Kariemm11/Cleanroom-Heat-Recovery-Air-Pump/cad/drawings/enclosure-GA.pdf

## FRONT WALL — seen from the front

## LEFT WALL — outdoor side

## PARTI

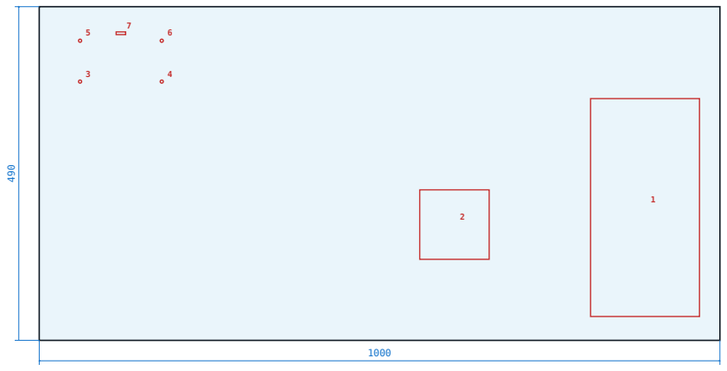
[picture p13: figure]
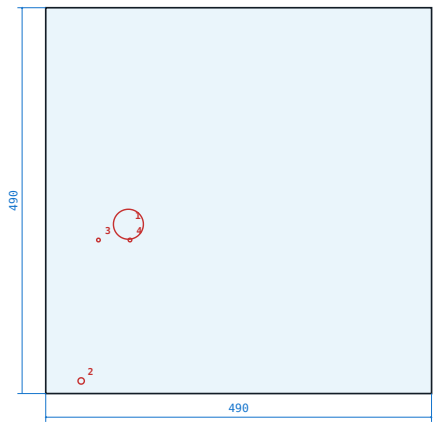
[picture p14: figure]

490

## BACK WALL — seen from inside

## FALSE CEILING — from below

## ROOF

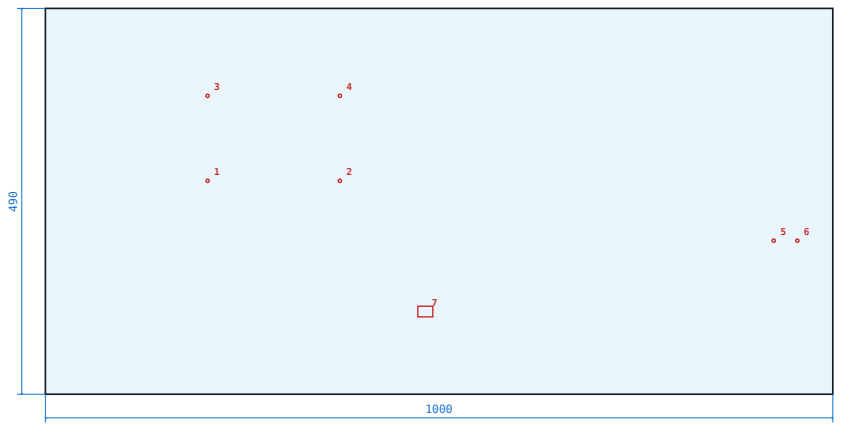
[picture p15: figure]
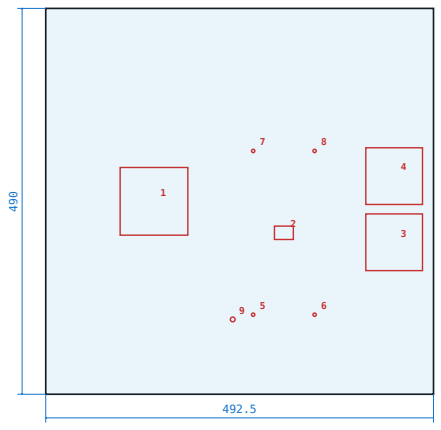
[picture p16: figure]

500

## CUT-OUTS — centre positions in mm, measured in each view from its left and bottom edges

### Front wall

1 door opening (door panel 180 × 340) @ 890 from left, 195 from bottom 2 pass box opening 102 × 102 @ 610 from left, 170 from bottom
3 HMI standoff M4 @ 60 from left, 380 from bottom
4 HMI standoff M4 (same) @ 180 from left, 380 from bottom
5 HMI standoff M4 (same) @ 60 from left, 440 from bottom
6 HMI standoff M4 (same) @ 180 from left, 440 from bottom 7 HMI ribbon slot @ 120 from left, 451 from bottom

### Left wall (outdoor side)

1 fresh-air compressor intake Ø38 @ 105 from left, 215 from bottom 2 24 V supply cable gland Ø8 @ 45 from left, 16 from bottom
3 compressor bracket M4 @ 67 from left, 195 from bottom
4 compressor bracket M4 (same) @ 107 from left, 195 from bottom

### Partition wall

1 supply duct 31
2 exhaust termin
3 exhaust termin
4 PDT-101 refere
5 PCB harness sl

### Back wall

1 PCB standoff M3 @ 206 from left, 271 from bottom
2 PCB standoff M3 (same) @ 374 from left, 271 from bottom 3 PCB standoff M3 (same) @ 206 from left, 379 from bottom 4 PCB standoff M3 (same) @ 374 from left, 379 from bottom
5 MT-106 sensor M3 @ 925 from left, 195 from bottom
6 MT-106 sensor M3 (same) @ 955 from left, 195 from bottom
7 exhaust collector C into the plant room 19 × 13.5 @ 482.5 from left, 105 from bottom

### Clean-room false ceiling

1 ceiling H14 BIBO terminal 86 × 86 @ 137.5 from left, 245 from bottom 2 LAF supply drop 24 × 17 @ 302.5 from left, 205 from bottom
3 ceiling H14 BIBO terminal 2 72 × 72 @ 442.5 from left, 193 from bottom 4 ceiling H14 BIBO terminal 3 72 × 72 @ 442.5 from left, 277 from bottom 5 LAF hanger Ø4 @ 263.5 from left, 101 from bottom
6 LAF hanger Ø4 (same) @ 341.5 from left, 101 from bottom
7 LAF hanger Ø4 (same) @ 263.5 from left, 309 from bottom
8 LAF hanger Ø4 (same) @ 341.5 from left, 309 from bottom 9 luminaire cable Ø6 @ 237.5 from left, 95 from bottom

### Roof

1 common exhaust
