Kariemm11/Cleanroom-Heat-Recovery-Air-Pump/cad/cleanroom-rig-assembly.step

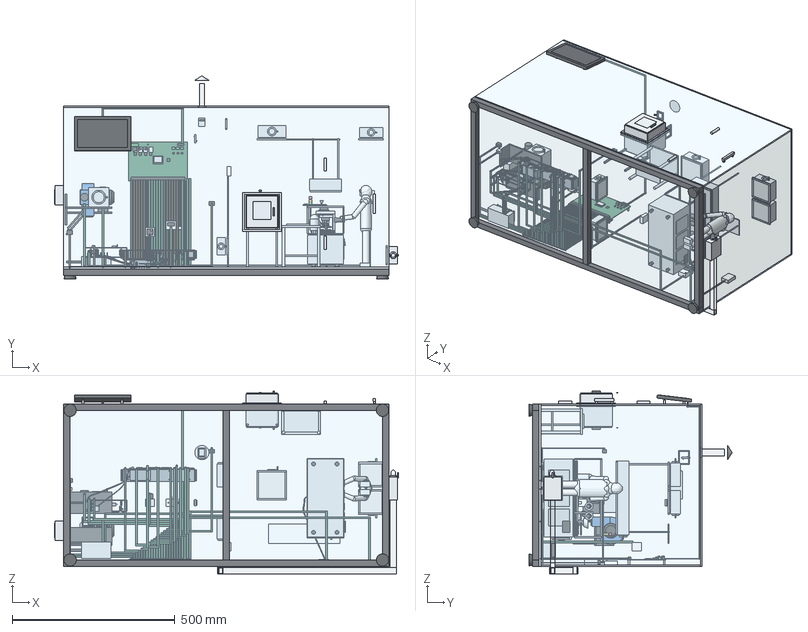
[picture p17: CAD file, 2026-10-15]
cad/cleanroom-rig-assembly.step
1057.1 x 625.0 x 560.9 mm
Acrylic base plate
Acrylic roof
Acrylic back wall
Acrylic front wall
Acrylic left wall (outdoor side)
Acrylic right wall
Acrylic partition wall
Clean-room false ceiling
Aluminium base frame
Aluminium base frame -2
Clean-room access door
AHU frame
AHU casing panel
Base machine compartment and R32 compressor
Base machine compartment and R32 compressor -2
Outdoor-air pre-filter
Outdoor-air pre-filter -2
Panel filter
Panel filter -2
Bag filter
Bag filter -2
HEPA final filter
HEPA final filter -2
Fresh-air plenum plus turning vanes
Coil preheat
Coil preheat -2
Coil preheat -3
Coil preheat -4
Coil cooling
Coil cooling -2
Coil cooling -3
Coil cooling -4
Coil reheat
Coil reheat -2
Coil reheat -3
Coil reheat -4
Supply fan
Supply fan -2
Supply fan -3
Fresh-air inlet
Supply air to the clean room
AHU duct connections
AHU duct connections -2
Fresh-air louvre plus bird mesh
Fresh-air louvre plus bird mesh -2
Droplet eliminator
Droplet eliminator -2
Steam humidifier
Steam humidifier -2
Steam humidifier -3
Supply attenuator
Supply attenuator -2
Sensor Supply T plus RH
Sensor TT-109 off the Cu core
Sensor TT-103 after pre-heat
Sensor TT-104 off cooling coil
Filter dP gauge
AHU control panel
AHU control panel -2
Misc x 2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
