Kariemm11/Cleanroom-Heat-Recovery-Air-Pump/cad/parts/Controls_and_HMI/Main_controller_PCB.step

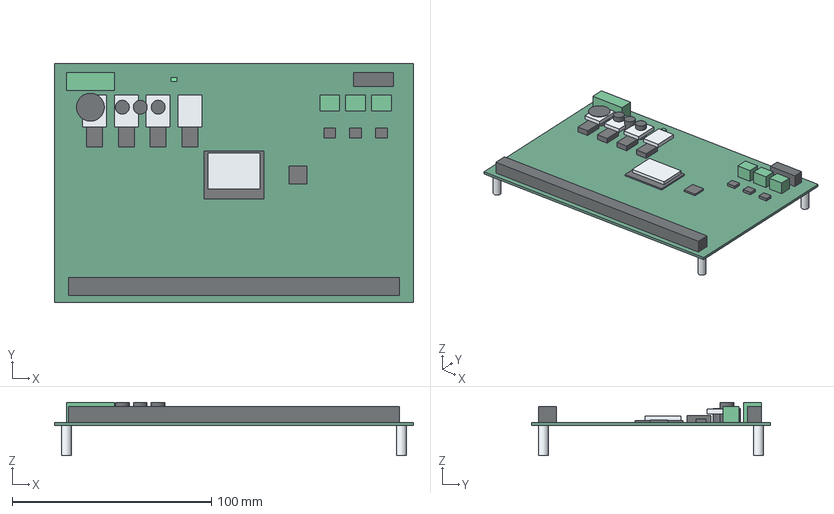
[picture p18: CAD file, 2026-10-15]
cad/parts/Controls_and_HMI/Main_controller_PCB.step
180.0 x 120.0 x 26.6 mm
