Kariemm11/Cleanroom-Heat-Recovery-Air-Pump/cad/parts/Ductwork/Exhaust_main_clean_room_to_DV-101.step

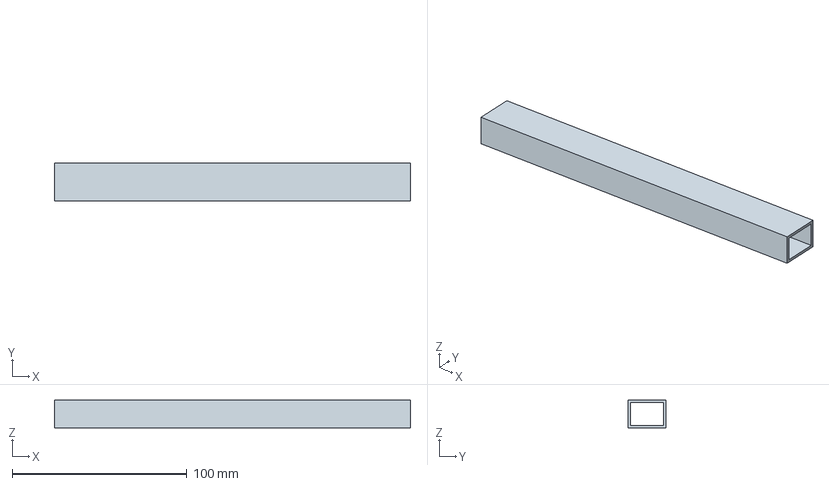
[picture p19: CAD file, 2026-10-15]
cad/parts/Ductwork/Exhaust_main_clean_room_to_DV-101.step
203.5 x 22.0 x 16.0 mm
