Kariemm11/Cleanroom-Heat-Recovery-Air-Pump/cad/dxf/enclosure-panels/Left_wall_outdoor_side.dxf

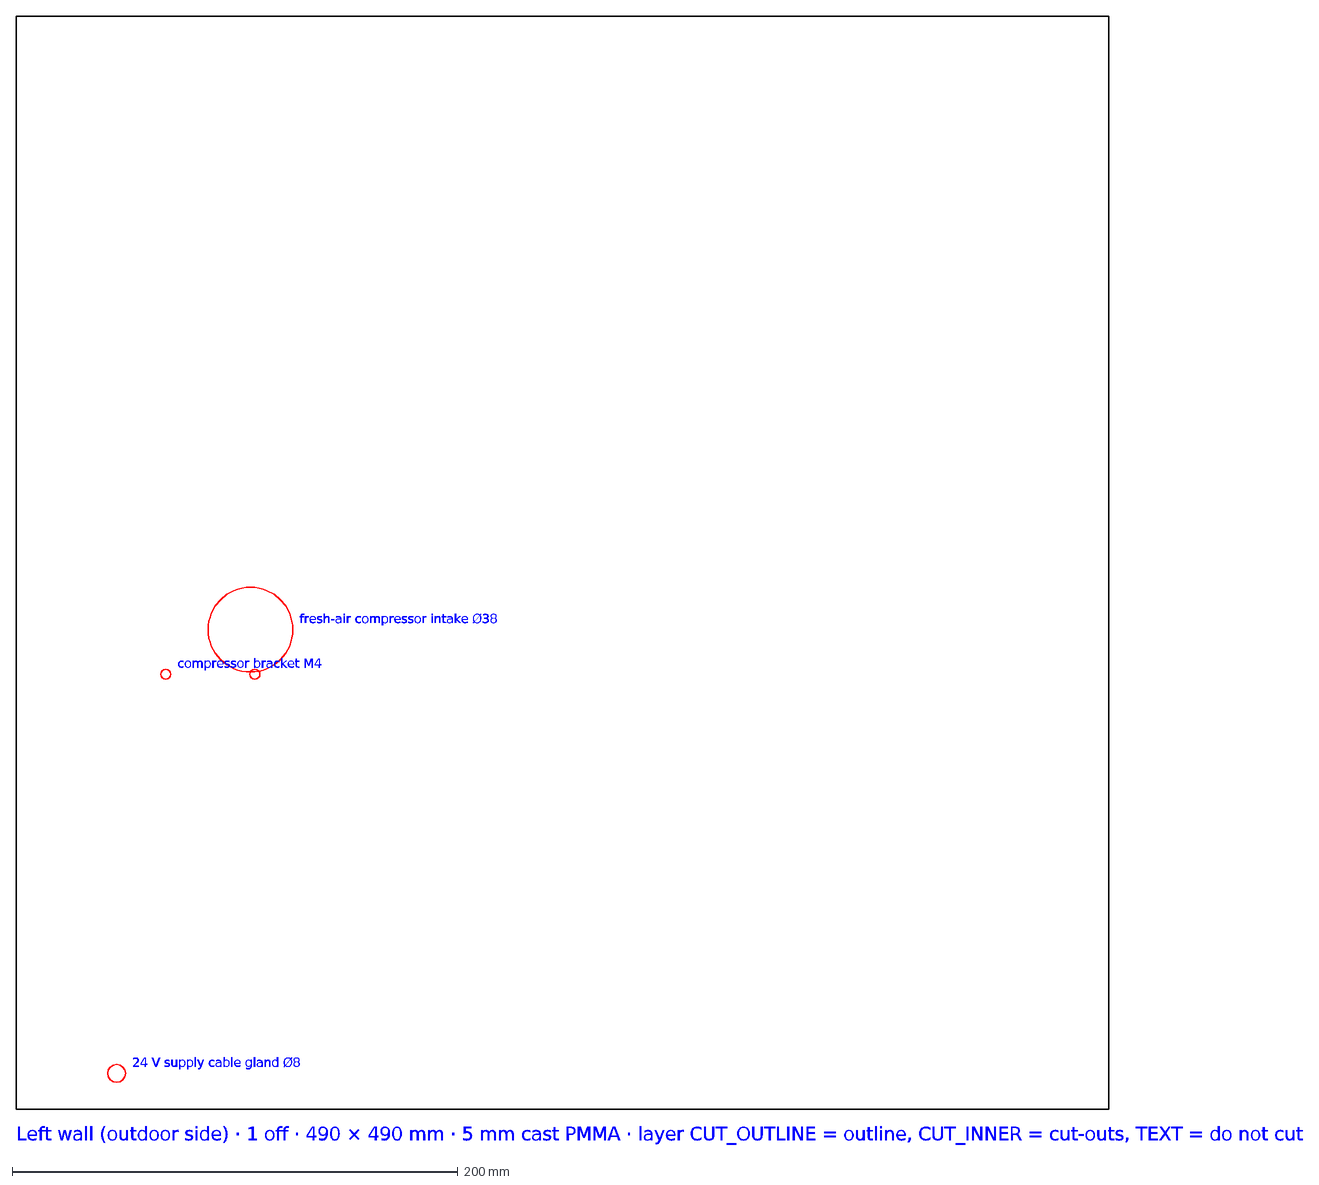
[picture p20: CAD file, 2026-10-15]
cad/dxf/enclosure-panels/Left_wall_outdoor_side.dxf
fresh-air compressor intake Ø38
24 V supply cable gland Ø8
compressor bracket M4
Left wall (outdoor side) · 1 off · 490 × 490 mm · 5 mm cast PMMA · layer CUT_OUTLINE = outline, CUT_INNER = cut-outs, TEXT = do not cut
