Kariemm11/Cleanroom-Heat-Recovery-Air-Pump/cad/dxf/parts/Clean_room/Right-wall_supply_plenum.dxf

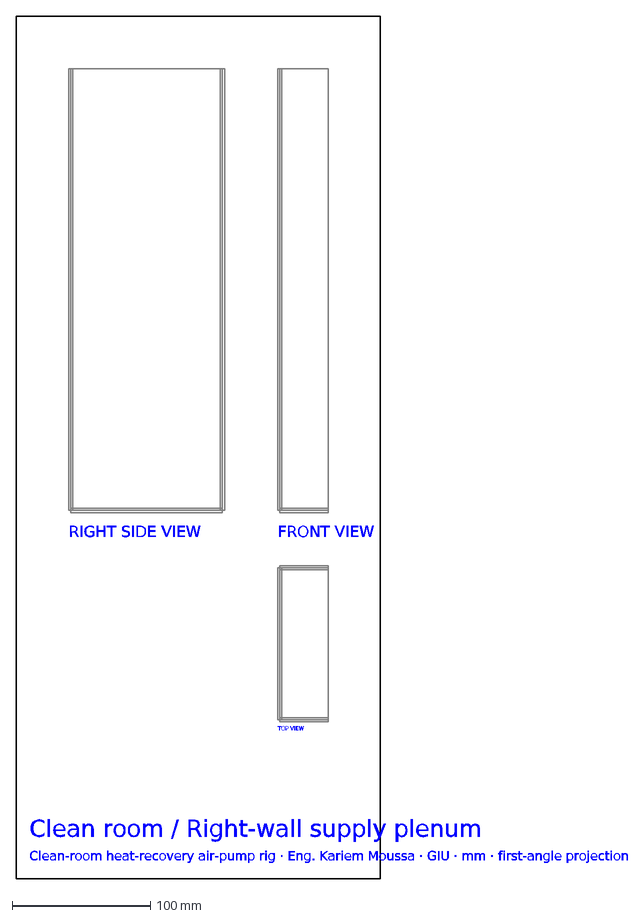
[picture p21: CAD file, 2026-10-14]
cad/dxf/parts/Clean_room/Right-wall_supply_plenum.dxf
FRONT VIEW
TOP VIEW
RIGHT SIDE VIEW
Clean room / Right-wall supply plenum
Clean-room heat-recovery air-pump rig · Eng. Kariem Moussa · GIU · mm · first-angle projection
