Kariemm11/Cleanroom-Heat-Recovery-Air-Pump/cad/dxf/sub-assemblies/Acrylic_enclosure.dxf

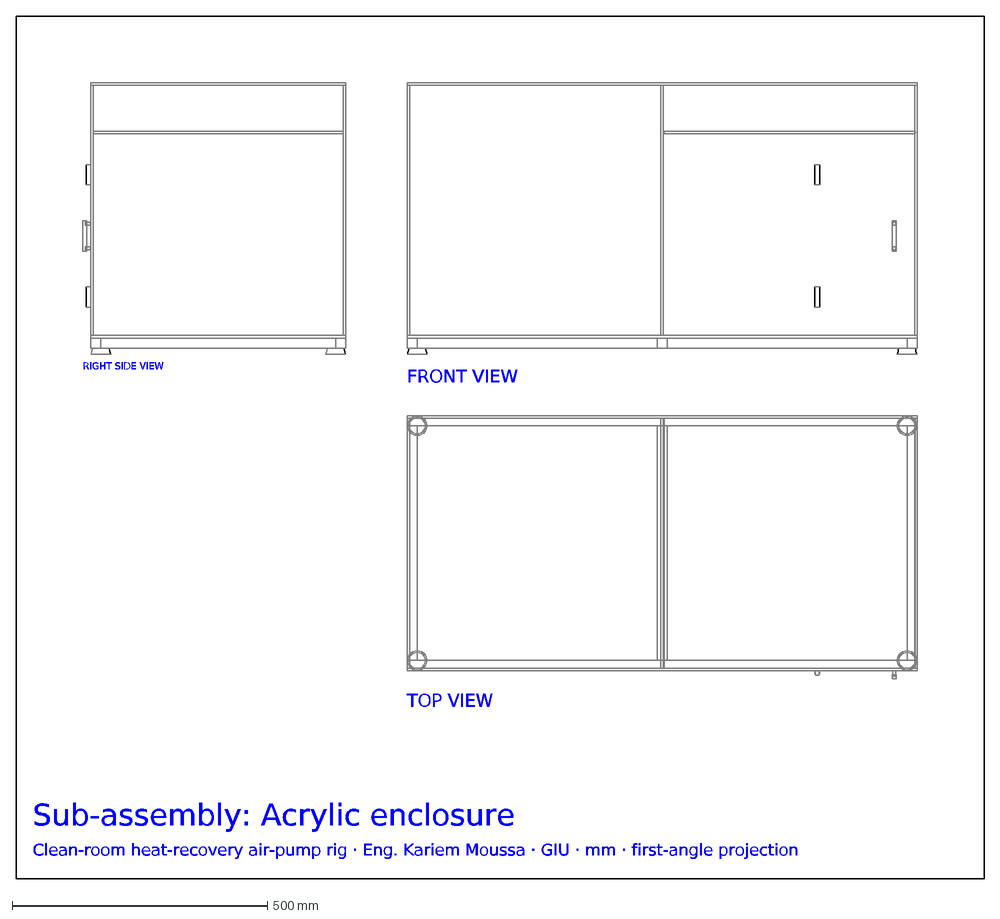
[picture p22: CAD file, 2026-10-15]
cad/dxf/sub-assemblies/Acrylic_enclosure.dxf
FRONT VIEW
TOP VIEW
RIGHT SIDE VIEW
Sub-assembly: Acrylic enclosure
Clean-room heat-recovery air-pump rig · Eng. Kariem Moussa · GIU · mm · first-angle projection
