Kariemm11/Cleanroom-Heat-Recovery-Air-Pump/cad/dxf3d/parts/Acrylic_enclosure/Clean-room_false_ceiling-3D.dxf

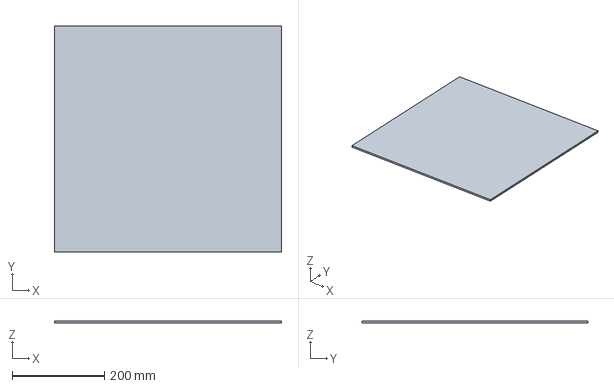
[picture p23: CAD file, 2026-10-15]
cad/dxf3d/parts/Acrylic_enclosure/Clean-room_false_ceiling-3D.dxf
492.5 x 490.0 x 5.00 mm
