Kariemm11/Cleanroom-Heat-Recovery-Air-Pump/cad/dxf3d/parts/AHU/R32_liquid_receiver-3D.dxf

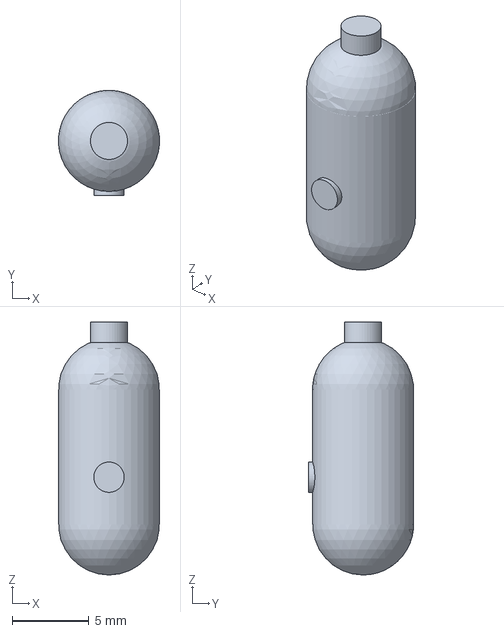
[picture p24: CAD file, 2026-10-15]
cad/dxf3d/parts/AHU/R32_liquid_receiver-3D.dxf
6.58 x 6.88 x 16.5 mm
