Kariemm11/Cleanroom-Heat-Recovery-Air-Pump/cad/dxf3d/parts/Clean_room/Pass_box_inner_door-3D.dxf

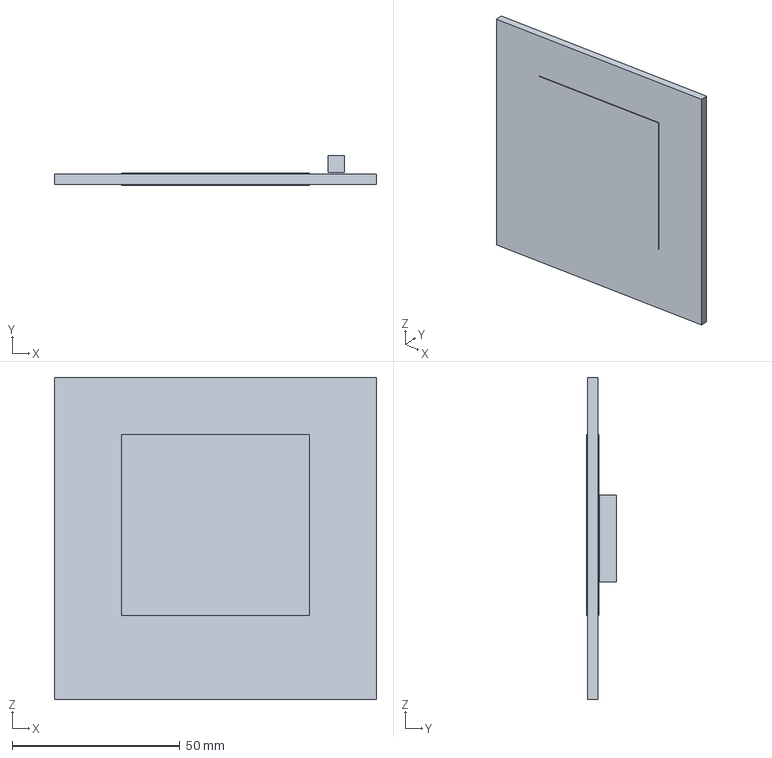
[picture p25: CAD file, 2026-10-15]
cad/dxf3d/parts/Clean_room/Pass_box_inner_door-3D.dxf
96.0 x 8.80 x 96.0 mm
