Kariemm11/Cleanroom-Heat-Recovery-Air-Pump/cad/dxf3d/parts/Controls_and_HMI/TT-101-MT-101_fresh-air_TplusRH_SHT31-3D.dxf

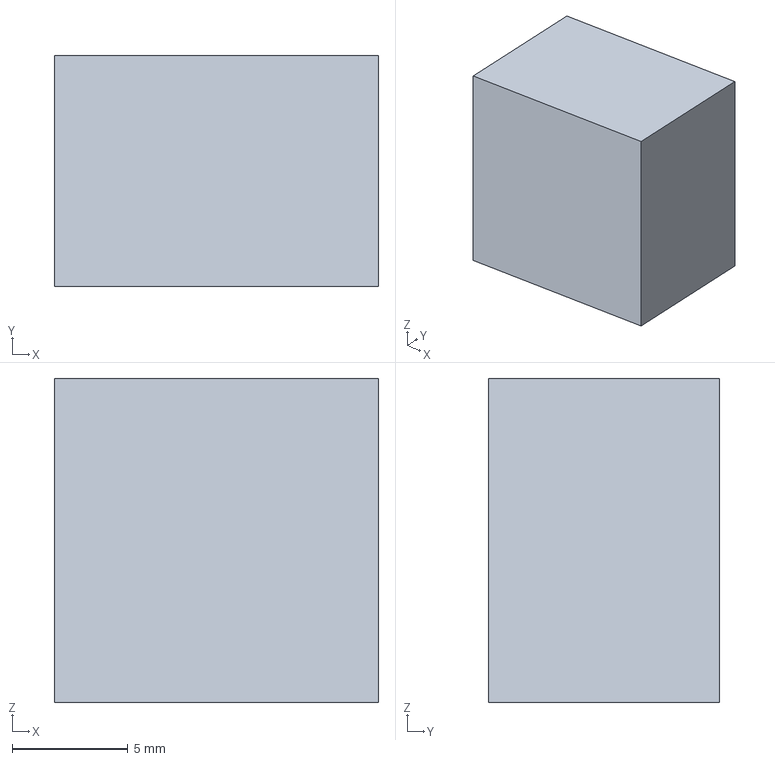
[picture p26: CAD file, 2026-10-15]
cad/dxf3d/parts/Controls_and_HMI/TT-101-MT-101_fresh-air_TplusRH_SHT31-3D.dxf
14.0 x 10.0 x 14.0 mm
