Kariemm11/Cleanroom-Heat-Recovery-Air-Pump/cad/dxf3d/parts/Ductwork/Exhaust_BIBO_HEPA_terminal_1_H14-3D.dxf

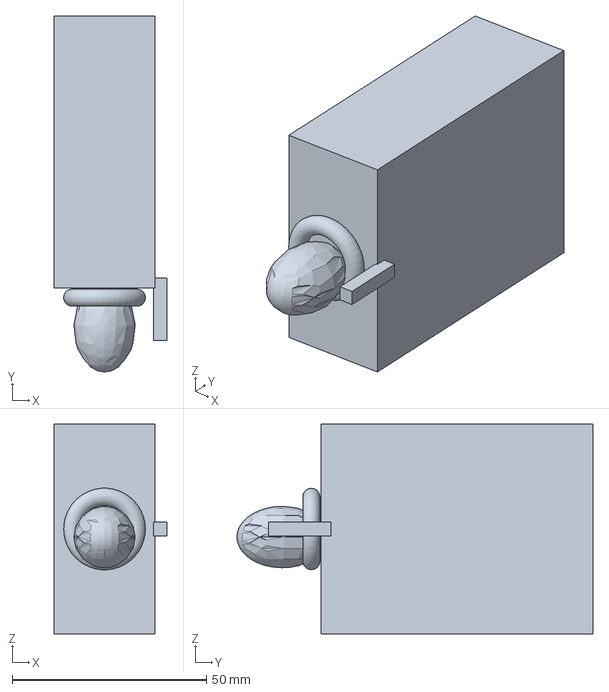
[picture p27: CAD file, 2026-10-15]
cad/dxf3d/parts/Ductwork/Exhaust_BIBO_HEPA_terminal_1_H14-3D.dxf
29.1 x 91.6 x 54.0 mm
