Kariemm11/Cleanroom-Heat-Recovery-Air-Pump/cad/dxf3d/parts/Exhaust_safety_PT-102_plus_DV-101_plus_outer_HEPA/Backdraft_damper_normal_exhaust-3D.dxf

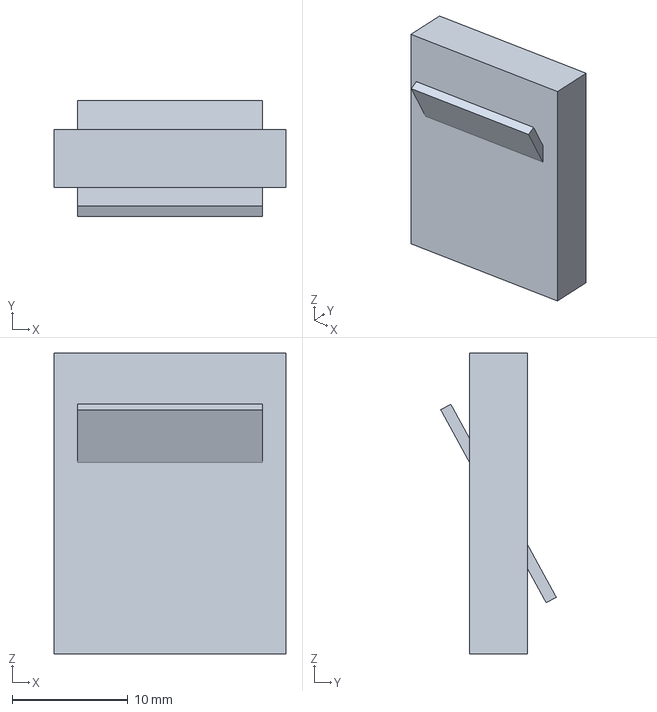
[picture p28: CAD file, 2026-10-15]
cad/dxf3d/parts/Exhaust_safety_PT-102_plus_DV-101_plus_outer_HEPA/Backdraft_damper_normal_exhaust-3D.dxf
20.0 x 9.99 x 26.0 mm
