Kariemm11/Cleanroom-Heat-Recovery-Air-Pump/cad/dxf3d/parts/Fresh-air_compressor/FAN-101_fresh-air_compressor-3D.dxf

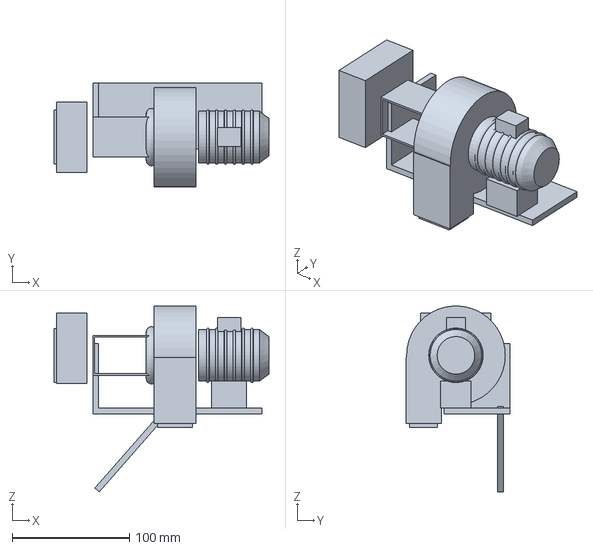
[picture p29: CAD file, 2026-10-15]
cad/dxf3d/parts/Fresh-air_compressor/FAN-101_fresh-air_compressor-3D.dxf
183.0 x 88.5 x 158.1 mm
