Kariemm11/Cleanroom-Heat-Recovery-Air-Pump/cad/dxf3d/parts/Heat-recovery_air-pump_unit/Recovery_unit_support_posts-3D.dxf

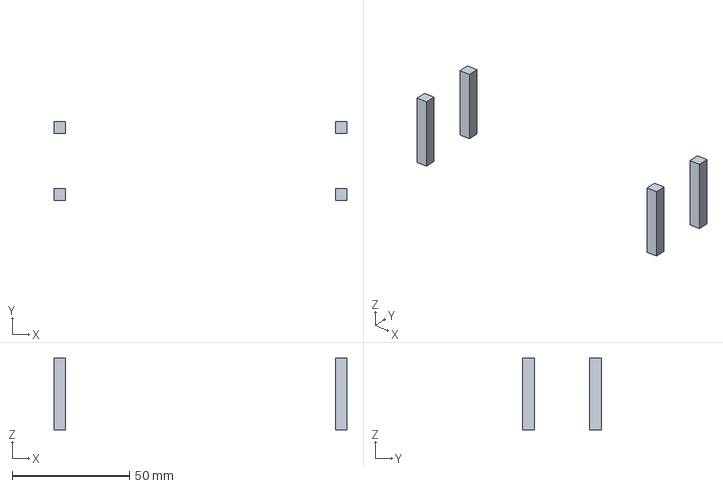
[picture p30: CAD file, 2026-10-15]
cad/dxf3d/parts/Heat-recovery_air-pump_unit/Recovery_unit_support_posts-3D.dxf
124.9 x 33.6 x 30.5 mm
