Kariemm11/Cleanroom-Heat-Recovery-Air-Pump/cad/dxf3d/parts/PCB_wiring_harness/PCB_strip_CMP-101-3D.dxf

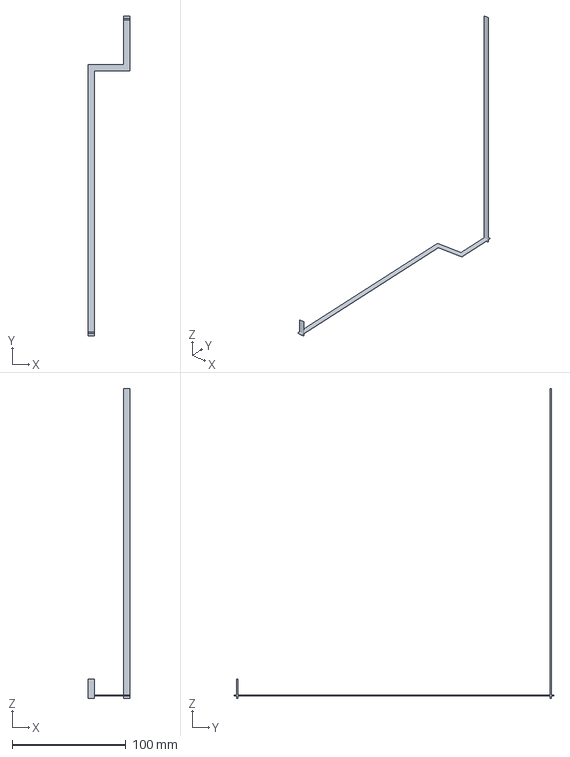
[picture p31: CAD file, 2026-10-15]
cad/dxf3d/parts/PCB_wiring_harness/PCB_strip_CMP-101-3D.dxf
36.9 x 281.0 x 272.5 mm
