Kariemm11/Cleanroom-Heat-Recovery-Air-Pump/cad/dxf3d/plant-system-AHU-and-air-pump-in-parallel-3D.dxf

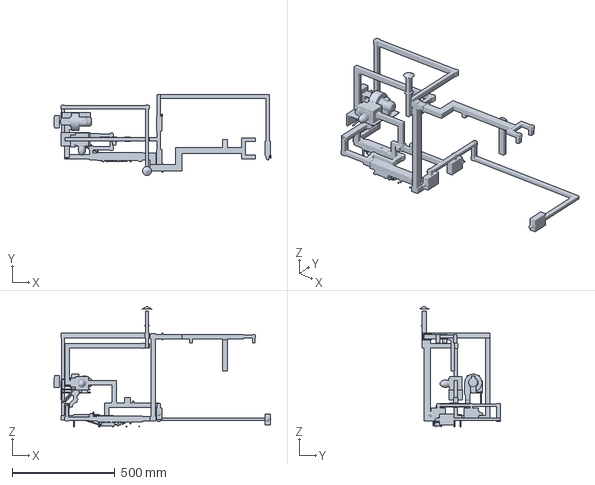
[picture p32: CAD file, 2026-10-15]
cad/dxf3d/plant-system-AHU-and-air-pump-in-parallel-3D.dxf
1057.1 x 394.3 x 588.0 mm
