Kariemm11/Cleanroom-Heat-Recovery-Air-Pump/cad/dxf3d/sub-assemblies/Ductwork-3D.dxf

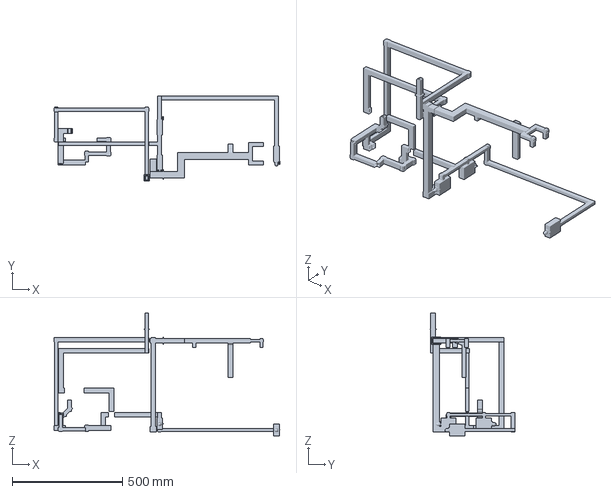
[picture p33: CAD file, 2026-10-15]
cad/dxf3d/sub-assemblies/Ductwork-3D.dxf
1024.1 x 387.1 x 555.5 mm
