Kariemm11/Cleanroom-Heat-Recovery-Air-Pump/cad/parts/AHU/Filter_dP_gauge.step

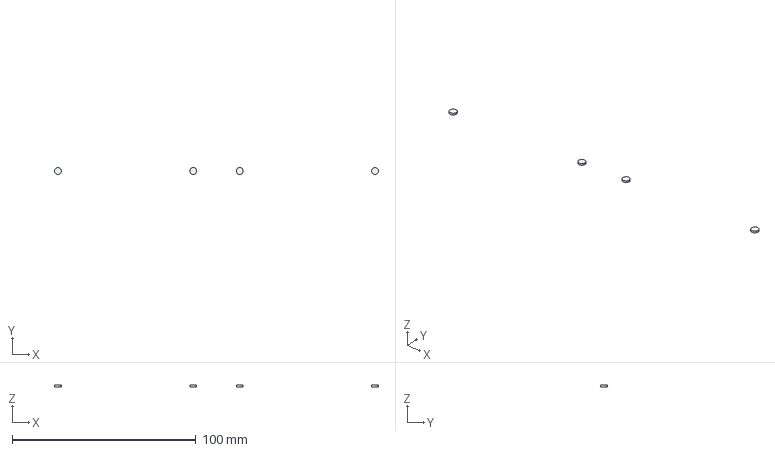
[picture p34: CAD file, 2026-10-15]
cad/parts/AHU/Filter_dP_gauge.step
176.4 x 3.74 x 0.88 mm
