Kariemm11/Cleanroom-Heat-Recovery-Air-Pump/cad/parts/Clean_room/LED_clean-room_luminaire.step

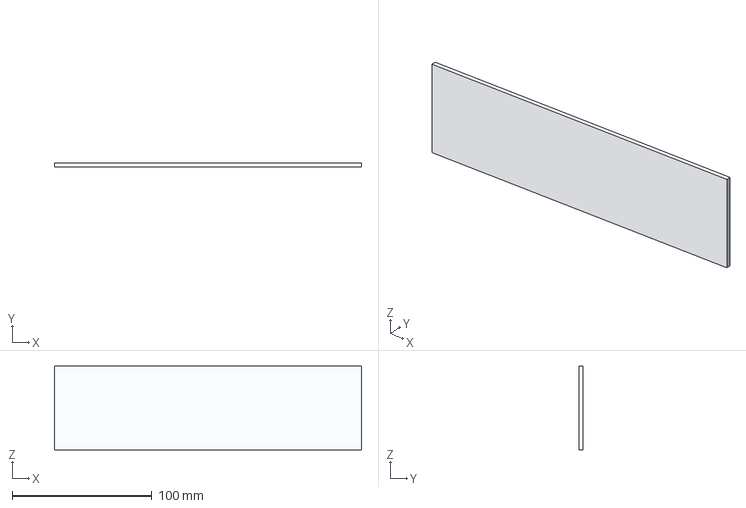
[picture p35: CAD file, 2026-10-15]
cad/parts/Clean_room/LED_clean-room_luminaire.step
220.0 x 3.00 x 60.0 mm
