Kariemm11/Cleanroom-Heat-Recovery-Air-Pump/cad/parts/Ductwork/Header_to_recovery_unit_fresh_lane.step

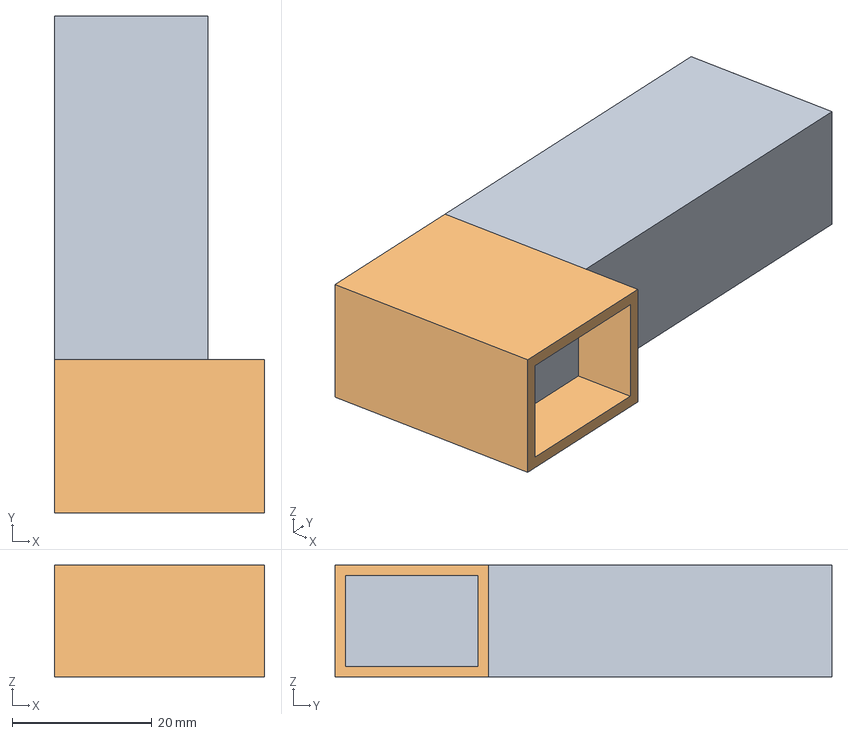
[picture p36: CAD file, 2026-10-15]
cad/parts/Ductwork/Header_to_recovery_unit_fresh_lane.step
30.1 x 71.2 x 16.0 mm
