Kariemm11/Cleanroom-Heat-Recovery-Air-Pump/cad/parts/Exhaust_safety_PT-102_plus_DV-101_plus_outer_HEPA/FAN-103B_HEPA-bypass_exhaust_fan.step

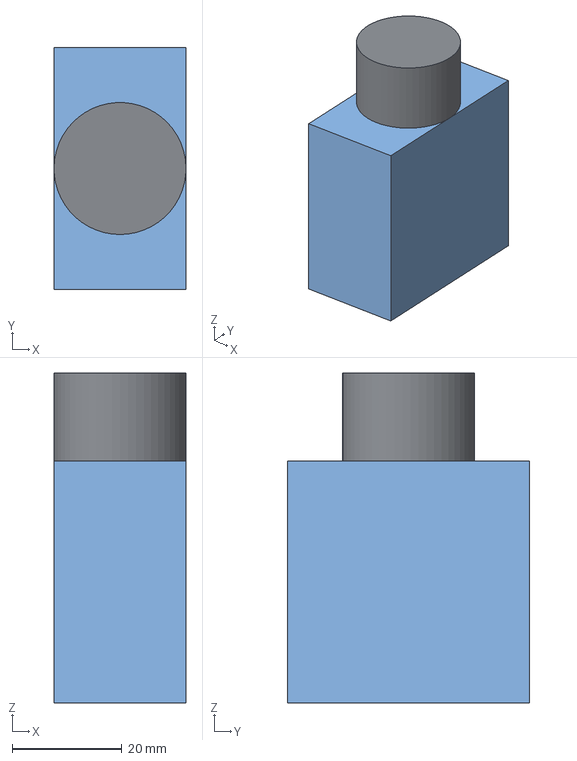
[picture p37: CAD file, 2026-10-15]
cad/parts/Exhaust_safety_PT-102_plus_DV-101_plus_outer_HEPA/FAN-103B_HEPA-bypass_exhaust_fan.step
24.0 x 44.0 x 60.0 mm
