Kariemm11/Cleanroom-Heat-Recovery-Air-Pump/cad/parts/Heat-recovery_air-pump_unit/Fresh-air_filter.step

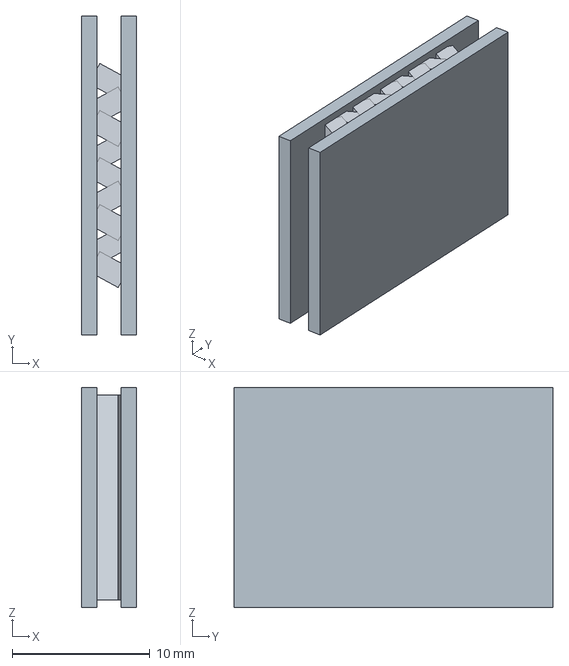
[picture p38: CAD file, 2026-10-15]
cad/parts/Heat-recovery_air-pump_unit/Fresh-air_filter.step
3.96 x 23.1 x 16.0 mm
