Kariemm11/Cleanroom-Heat-Recovery-Air-Pump/cad/parts/PCB_wiring_harness/PCB_strip_TT-105_copper.step

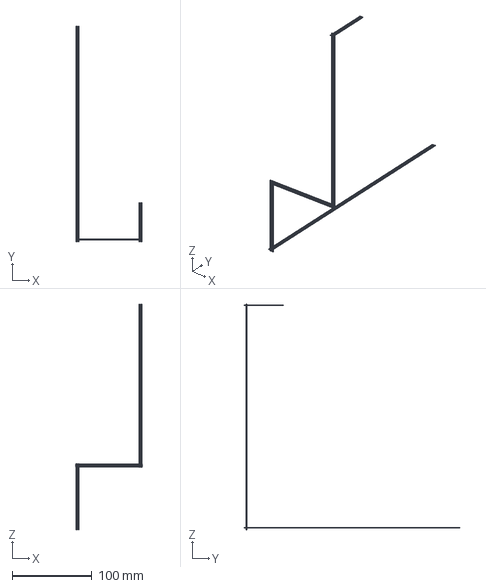
[picture p39: CAD file, 2026-10-15]
cad/parts/PCB_wiring_harness/PCB_strip_TT-105_copper.step
83.7 x 270.2 x 283.0 mm
