Kariemm11/Cleanroom-Heat-Recovery-Air-Pump/cad/step/Clean_room.step

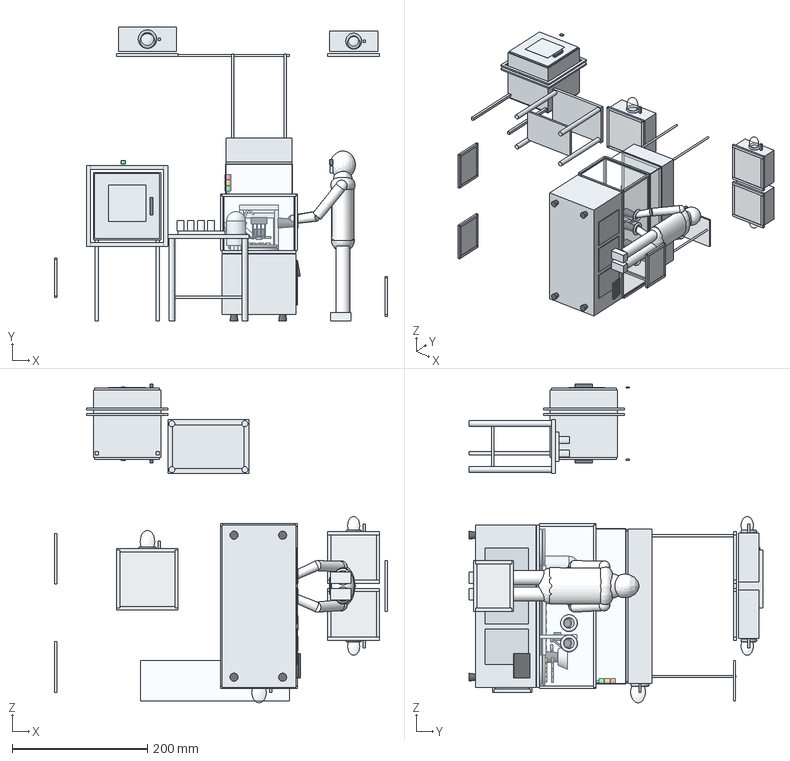
[picture p40: CAD file, 2026-10-15]
cad/step/Clean_room.step
492.5 x 435.0 x 471.5 mm
Ceiling BIBO HEPA terminal 1 (H14)
Ceiling BIBO HEPA terminal 1 (H14) -2
Ceiling BIBO HEPA terminal 1 (H14) -3
Ceiling terminal 1 face screen
Ceiling terminal 1 face screen -2
LAF hood H14 BIBO filter housing
LAF hood H14 BIBO filter housing -2
LAF hood H14 BIBO filter housing -3
LAF hood perforated outlet screen
LAF hood perforated outlet screen -2
LAF hood PVC skirts plus hangers
LAF hood PVC skirts plus hangers -2
Ceiling BIBO HEPA terminal 2 (H14)
Ceiling BIBO HEPA terminal 2 (H14) -2
Ceiling BIBO HEPA terminal 2 (H14) -3
Ceiling terminal 2 face screen
Ceiling terminal 2 face screen -2
Ceiling BIBO HEPA terminal 3 (H14)
Ceiling BIBO HEPA terminal 3 (H14) -2
Ceiling BIBO HEPA terminal 3 (H14) -3
Ceiling terminal 3 face screen
Ceiling terminal 3 face screen -2
Low-level exhaust terminal 1 face screen
Low-level exhaust terminal 1 face screen -2
Low-level exhaust terminal 2 face screen
Low-level exhaust terminal 2 face screen -2
Low-level exhaust terminal 3 face screen
Low-level exhaust terminal 3 face screen -2
LED clean-room luminaire
Staging bench plus vial tray
Staging bench plus vial tray -2
Staging bench plus vial tray -3
Pass box
Pass box -2
Pass box -3
Pass box -4
Pass box outer door
Pass box outer door -2
Pass box outer door -3
Pass box inner door
Pass box inner door -2
Pass box inner door -3
Vial filling machine
Vial filling machine -2
Vial filling machine -3
Vial filling machine -4
Vial filling machine -5
Vial filling machine -6
Vial filling machine -7
Vial filling machine -8
Infeed turntable
Vial
Vial -2
Vial -3
Outfeed accumulation table
Filling needle carriage
Filling needle carriage -2
Product holding tank
Peristaltic dosing pump
Peristaltic dosing pump -2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
