Kariemm11/Cleanroom-Heat-Recovery-Air-Pump/cad/dxf/enclosure-panels/Partition_wall.dxf

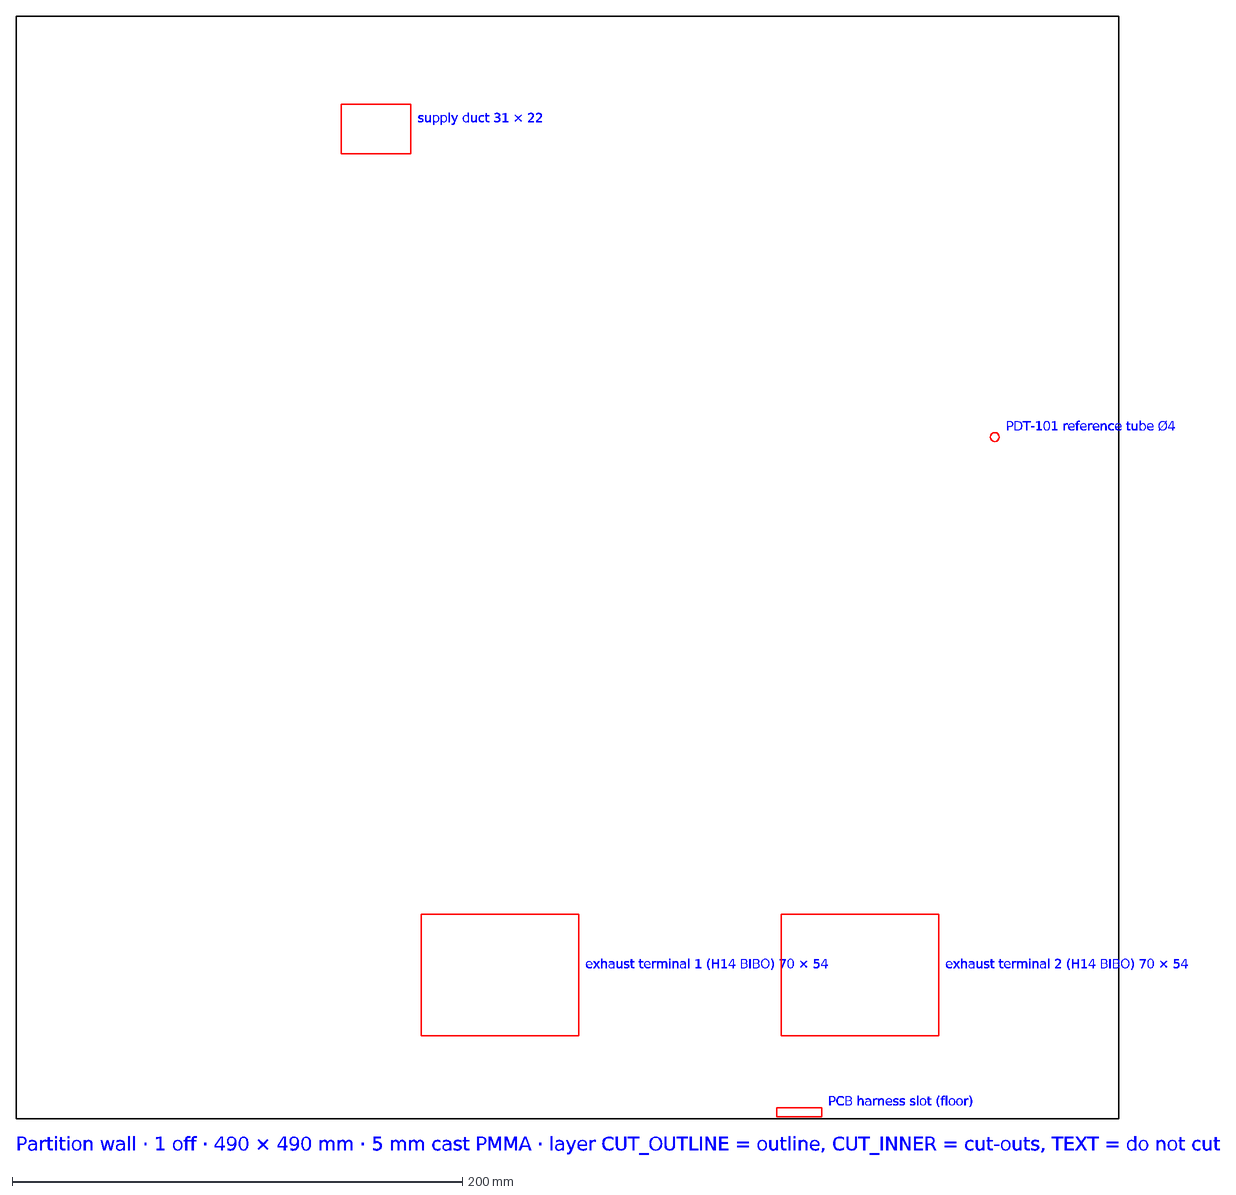
[picture p41: CAD file, 2026-10-15]
cad/dxf/enclosure-panels/Partition_wall.dxf
supply duct 31 × 22
exhaust terminal 1 (H14 BIBO) 70 × 54
exhaust terminal 2 (H14 BIBO) 70 × 54
PDT-101 reference tube Ø4
PCB harness slot (floor)
Partition wall · 1 off · 490 × 490 mm · 5 mm cast PMMA · layer CUT_OUTLINE = outline, CUT_INNER = cut-outs, TEXT = do not cut
