Kariemm11/Cleanroom-Heat-Recovery-Air-Pump/cad/dxf/sub-assemblies/Controls_and_HMI.dxf

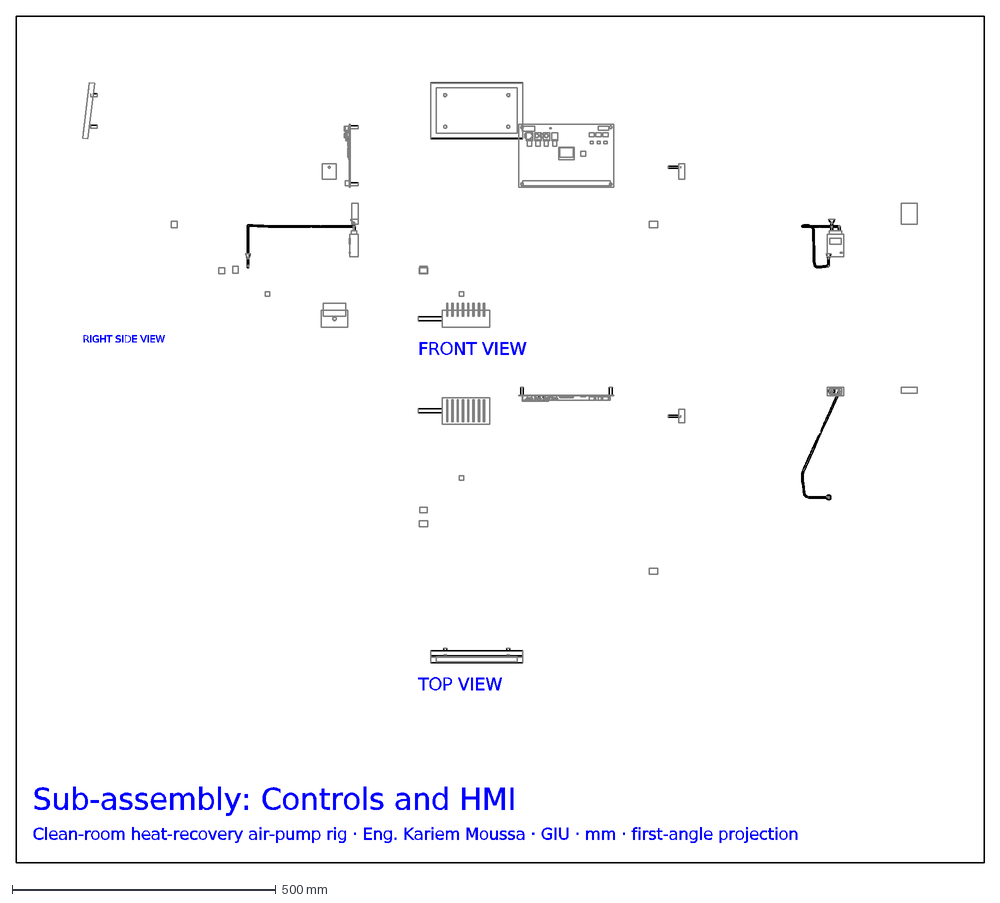
[picture p42: CAD file, 2026-10-15]
cad/dxf/sub-assemblies/Controls_and_HMI.dxf
FRONT VIEW
TOP VIEW
RIGHT SIDE VIEW
Sub-assembly: Controls and HMI
Clean-room heat-recovery air-pump rig · Eng. Kariem Moussa · GIU · mm · first-angle projection
