Kariemm11/Cleanroom-Heat-Recovery-Air-Pump/cad/dxf3d/parts/Acrylic_enclosure/Acrylic_back_wall-3D.dxf

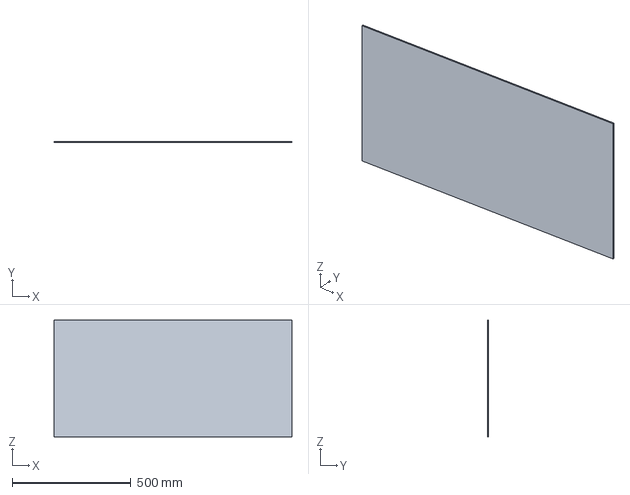
[picture p43: CAD file, 2026-10-15]
cad/dxf3d/parts/Acrylic_enclosure/Acrylic_back_wall-3D.dxf
1000.0 x 5.00 x 490.0 mm
