Kariemm11/Cleanroom-Heat-Recovery-Air-Pump/cad/dxf3d/parts/AHU/Base_machine_compartment_and_R32_compressor-3D.dxf

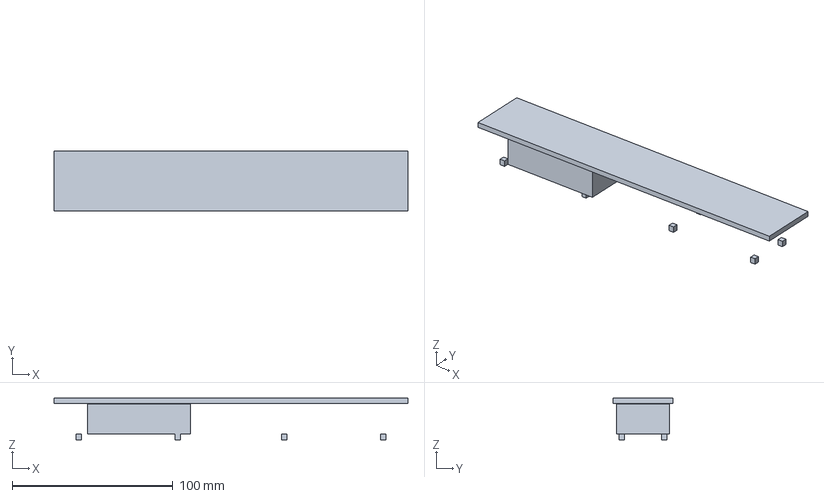
[picture p44: CAD file, 2026-10-15]
cad/dxf3d/parts/AHU/Base_machine_compartment_and_R32_compressor-3D.dxf
220.0 x 37.4 x 25.8 mm
