Kariemm11/Cleanroom-Heat-Recovery-Air-Pump/cad/dxf3d/parts/Clean_room/Ceiling_terminal_2_face_screen-3D.dxf

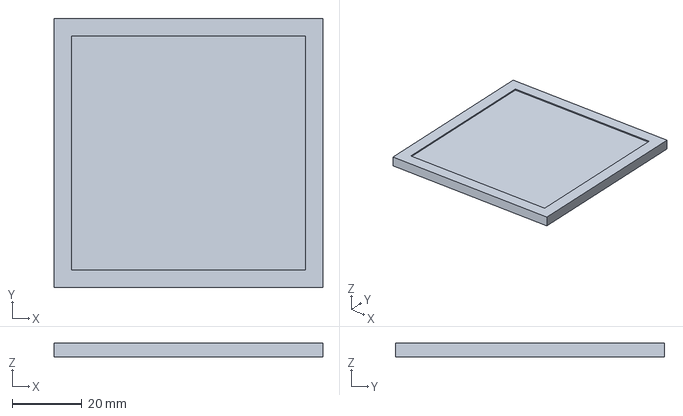
[picture p45: CAD file, 2026-10-15]
cad/dxf3d/parts/Clean_room/Ceiling_terminal_2_face_screen-3D.dxf
77.0 x 77.0 x 4.00 mm
