Kariemm11/Cleanroom-Heat-Recovery-Air-Pump/cad/dxf3d/parts/Controls_and_HMI/PT-101_air_particle_sensor-3D.dxf

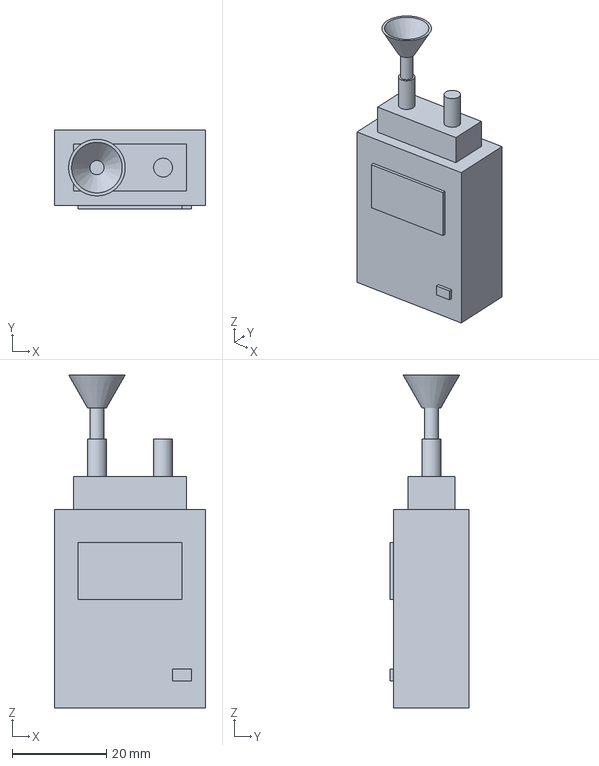
[picture p46: CAD file, 2026-10-15]
cad/dxf3d/parts/Controls_and_HMI/PT-101_air_particle_sensor-3D.dxf
32.0 x 16.8 x 70.5 mm
