Kariemm11/Cleanroom-Heat-Recovery-Air-Pump/cad/dxf3d/parts/Ductwork/HEPA_bypass_DV-101_to_outer_BIBO_HEPA-3D.dxf

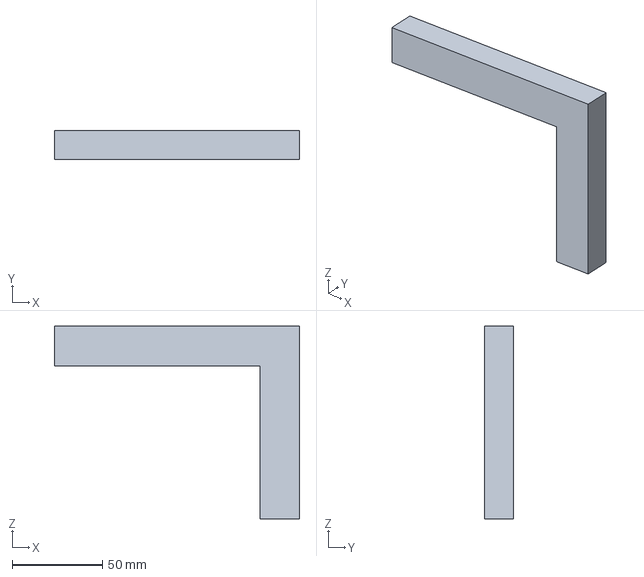
[picture p47: CAD file, 2026-10-15]
cad/dxf3d/parts/Ductwork/HEPA_bypass_DV-101_to_outer_BIBO_HEPA-3D.dxf
136.0 x 16.0 x 107.0 mm
