Kariemm11/Cleanroom-Heat-Recovery-Air-Pump/cad/dxf3d/parts/Exhaust_safety_PT-102_plus_DV-101_plus_outer_HEPA/DV-101_diverter_damper_plus_spring-return_actuator-3D.dxf

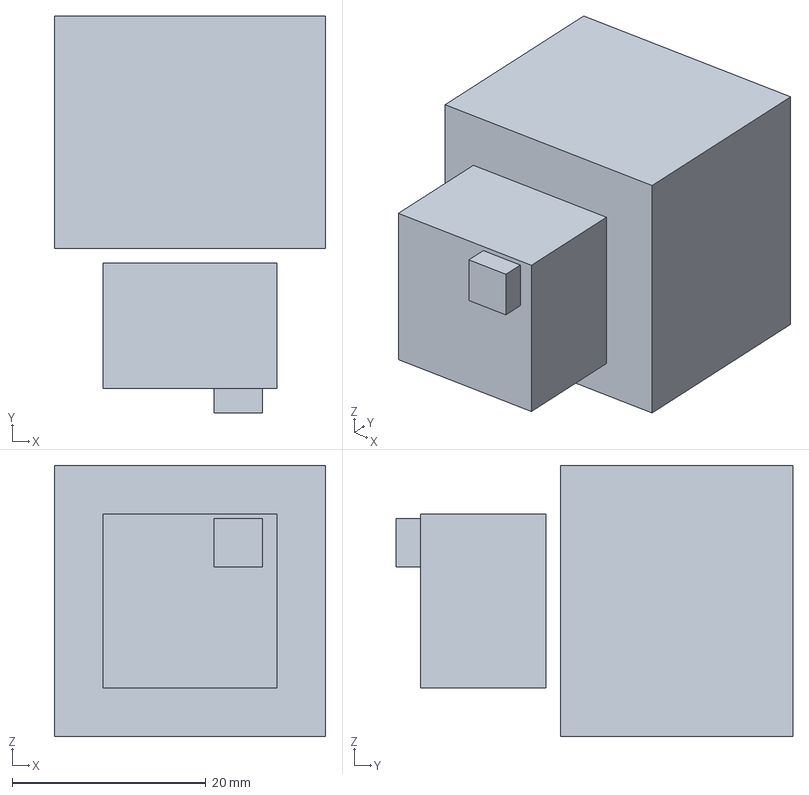
[picture p48: CAD file, 2026-10-15]
cad/dxf3d/parts/Exhaust_safety_PT-102_plus_DV-101_plus_outer_HEPA/DV-101_diverter_damper_plus_spring-return_actuator-3D.dxf
28.0 x 41.0 x 28.0 mm
