Kariemm11/Cleanroom-Heat-Recovery-Air-Pump/cad/dxf3d/parts/Heat-recovery_air-pump_unit/Tempered-air_fan-3D.dxf

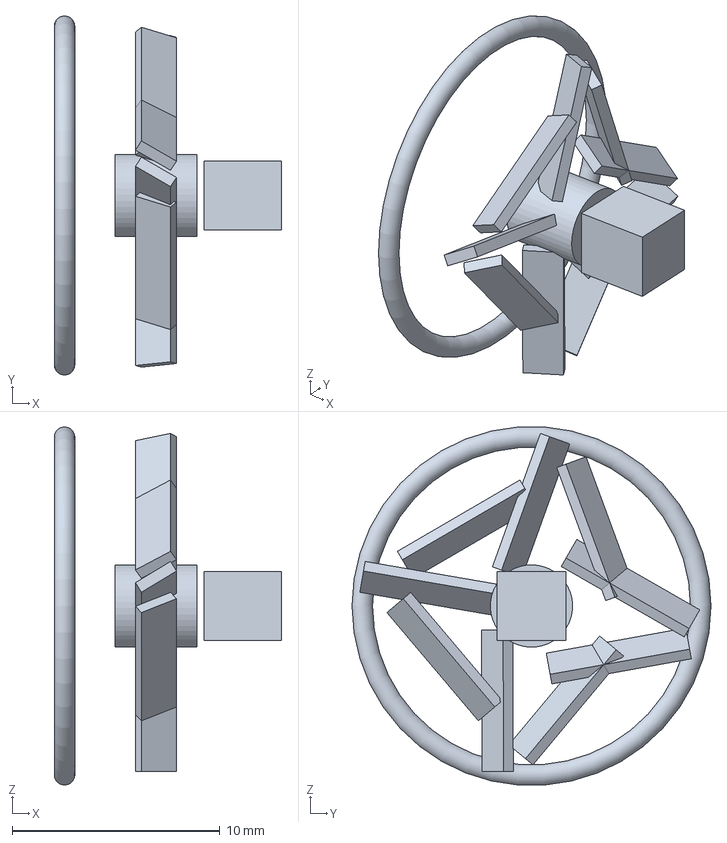
[picture p49: CAD file, 2026-10-15]
cad/dxf3d/parts/Heat-recovery_air-pump_unit/Tempered-air_fan-3D.dxf
10.9 x 17.3 x 17.2 mm
