Kariemm11/Cleanroom-Heat-Recovery-Air-Pump/cad/dxf3d/parts/PCB_wiring_harness/PCB_strip_TT-105-3D.dxf

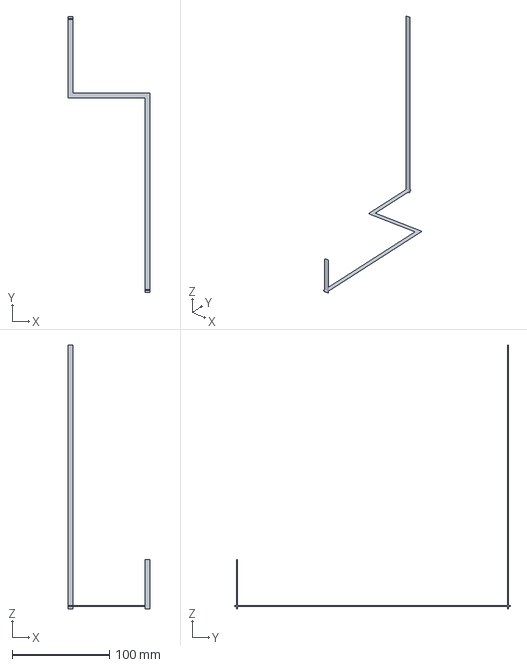
[picture p50: CAD file, 2026-10-15]
cad/dxf3d/parts/PCB_wiring_harness/PCB_strip_TT-105-3D.dxf
84.7 x 284.0 x 271.2 mm
