Kariemm11/Cleanroom-Heat-Recovery-Air-Pump/cad/dxf3d/sub-assemblies/PCB_wiring_harness-3D.dxf

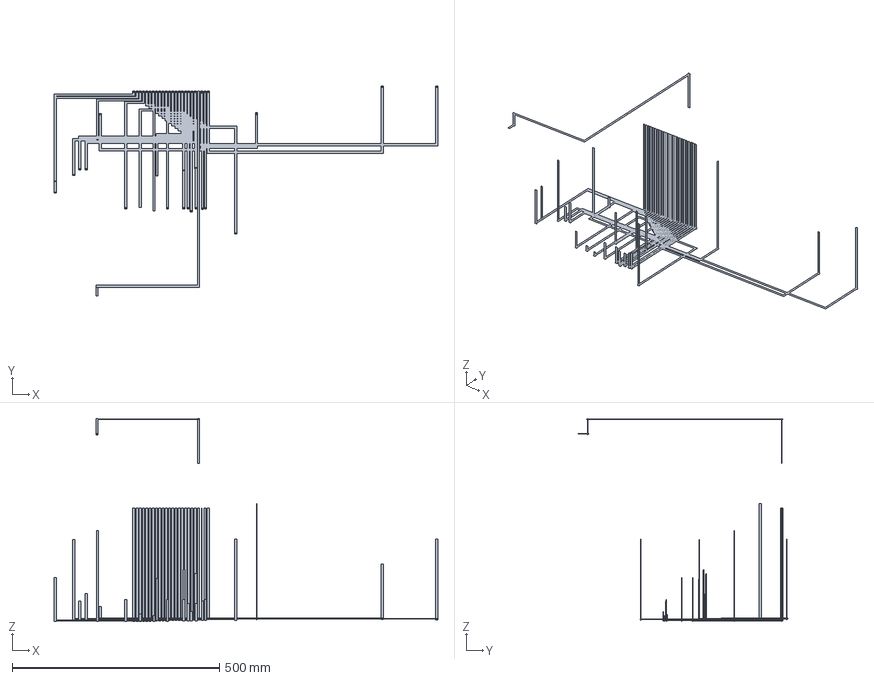
[picture p51: CAD file, 2026-10-15]
cad/dxf3d/sub-assemblies/PCB_wiring_harness-3D.dxf
926.5 x 506.5 x 490.8 mm
