Kariemm11/Cleanroom-Heat-Recovery-Air-Pump/cad/parts/Acrylic_enclosure/Acrylic_roof.step

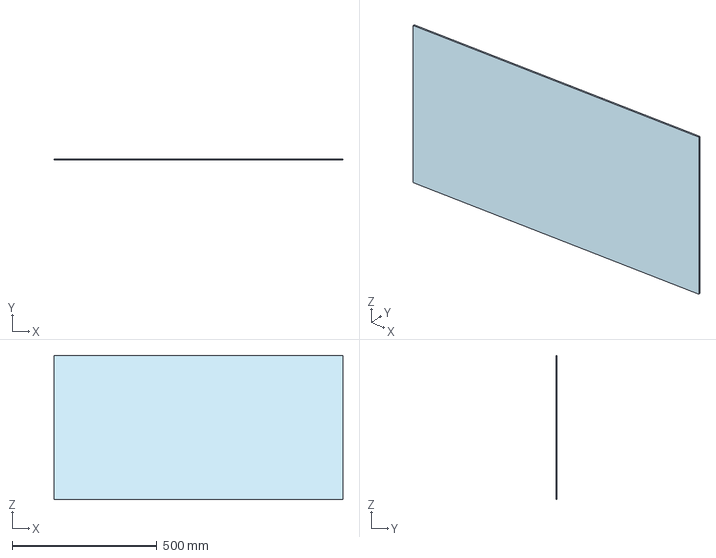
[picture p52: CAD file, 2026-10-15]
cad/parts/Acrylic_enclosure/Acrylic_roof.step
1000.0 x 5.00 x 500.0 mm
