Kariemm11/Cleanroom-Heat-Recovery-Air-Pump/cad/parts/AHU/Sensor_TT-104_off_cooling_coil.step

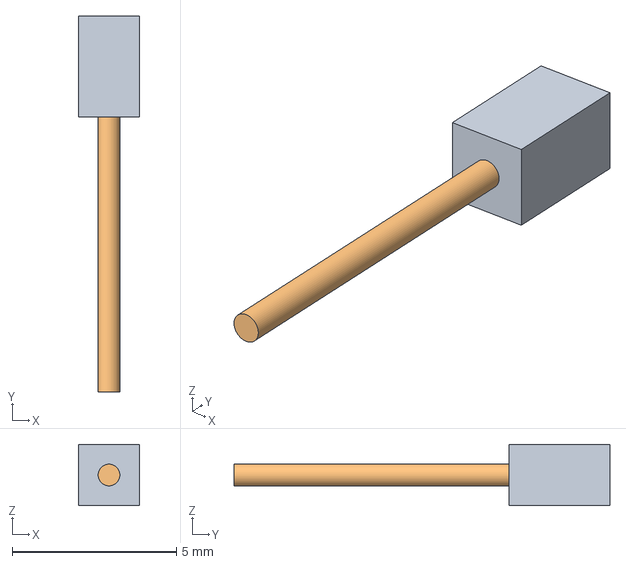
[picture p53: CAD file, 2026-10-15]
cad/parts/AHU/Sensor_TT-104_off_cooling_coil.step
1.87 x 11.4 x 1.87 mm
