Kariemm11/Cleanroom-Heat-Recovery-Air-Pump/cad/parts/Clean_room/Low-level_exhaust_terminal_1_face_screen.step

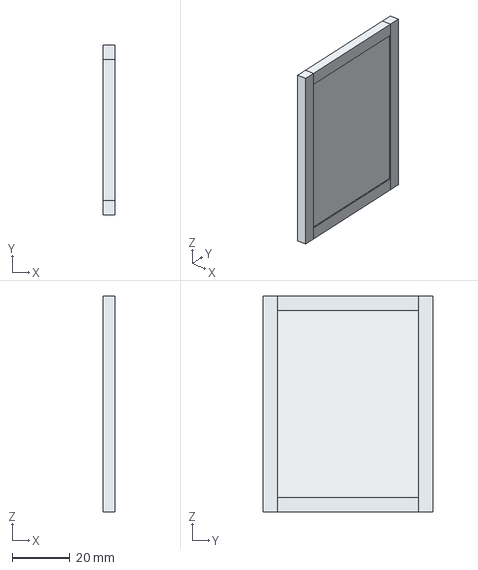
[picture p54: CAD file, 2026-10-15]
cad/parts/Clean_room/Low-level_exhaust_terminal_1_face_screen.step
4.00 x 59.0 x 75.0 mm
