Kariemm11/Cleanroom-Heat-Recovery-Air-Pump/cad/parts/Controls_and_HMI/FT-102_supply_airflow_D6F.step

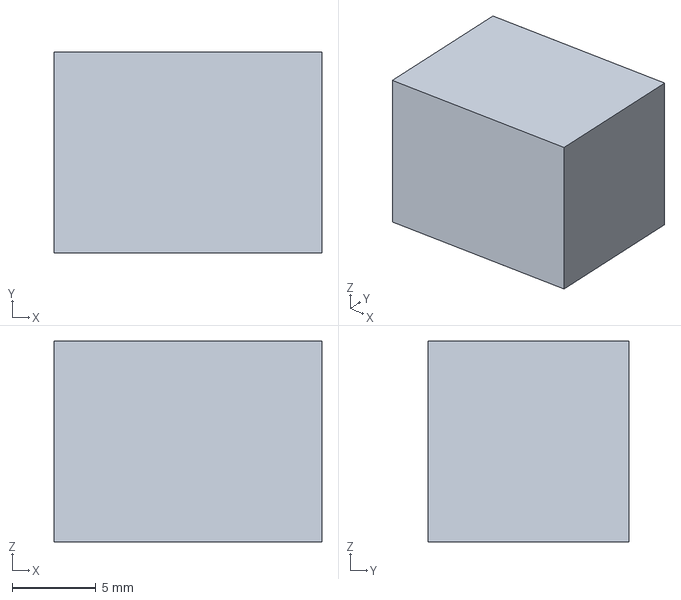
[picture p55: CAD file, 2026-10-15]
cad/parts/Controls_and_HMI/FT-102_supply_airflow_D6F.step
16.0 x 12.0 x 12.0 mm
