Kariemm11/Cleanroom-Heat-Recovery-Air-Pump/cad/parts/Ductwork/Exhaust_DV-101_to_air-pump_unit_Cu_core.step

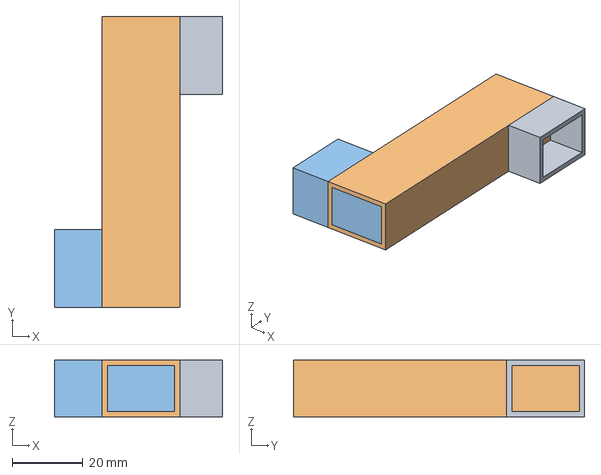
[picture p56: CAD file, 2026-10-15]
cad/parts/Ductwork/Exhaust_DV-101_to_air-pump_unit_Cu_core.step
47.4 x 82.2 x 16.0 mm
