Kariemm11/Cleanroom-Heat-Recovery-Air-Pump/cad/parts/Exhaust_safety_PT-102_plus_DV-101_plus_outer_HEPA/Outer_HEPA_wall_shelf.step

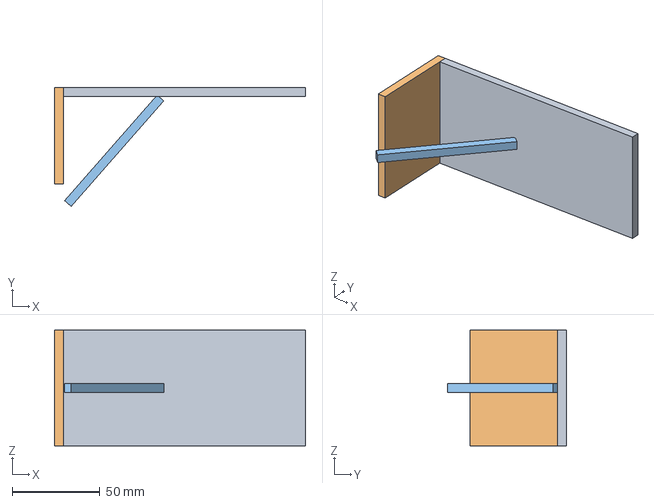
[picture p57: CAD file, 2026-10-15]
cad/parts/Exhaust_safety_PT-102_plus_DV-101_plus_outer_HEPA/Outer_HEPA_wall_shelf.step
143.0 x 67.7 x 66.0 mm
