Kariemm11/Cleanroom-Heat-Recovery-Air-Pump/cad/parts/Heat-recovery_air-pump_unit/Coil_extract.step

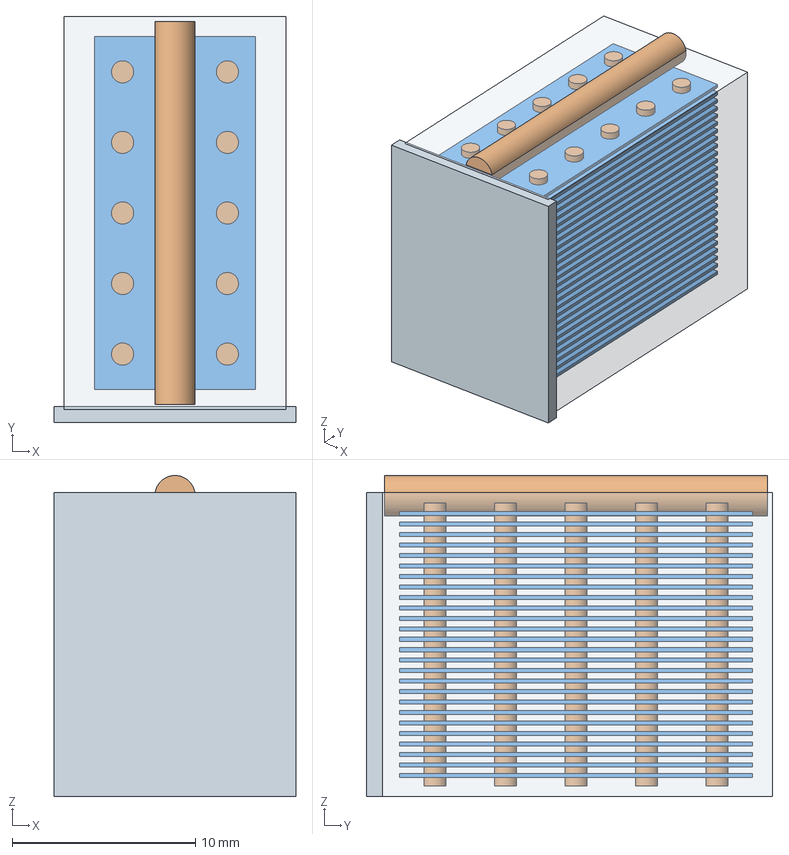
[picture p58: CAD file, 2026-10-15]
cad/parts/Heat-recovery_air-pump_unit/Coil_extract.step
13.2 x 22.2 x 17.5 mm
