Kariemm11/Cleanroom-Heat-Recovery-Air-Pump/cad/parts/PCB_wiring_harness/PCB_strip_TT-109.step

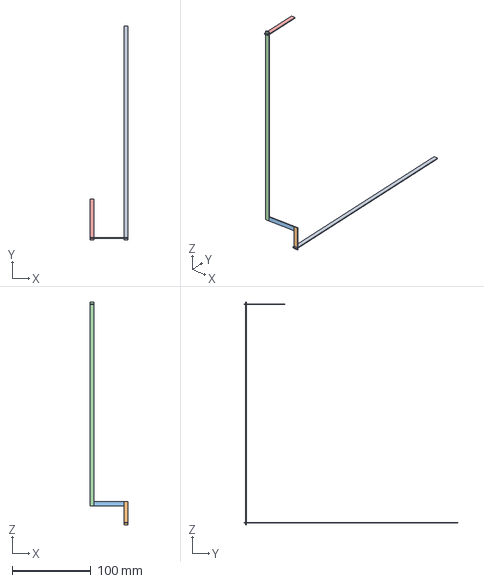
[picture p59: CAD file, 2026-10-15]
cad/parts/PCB_wiring_harness/PCB_strip_TT-109.step
48.7 x 273.1 x 284.0 mm
