Kariemm11/Cleanroom-Heat-Recovery-Air-Pump/cad/dxf/sub-assemblies/PCB_wiring_harness.dxf

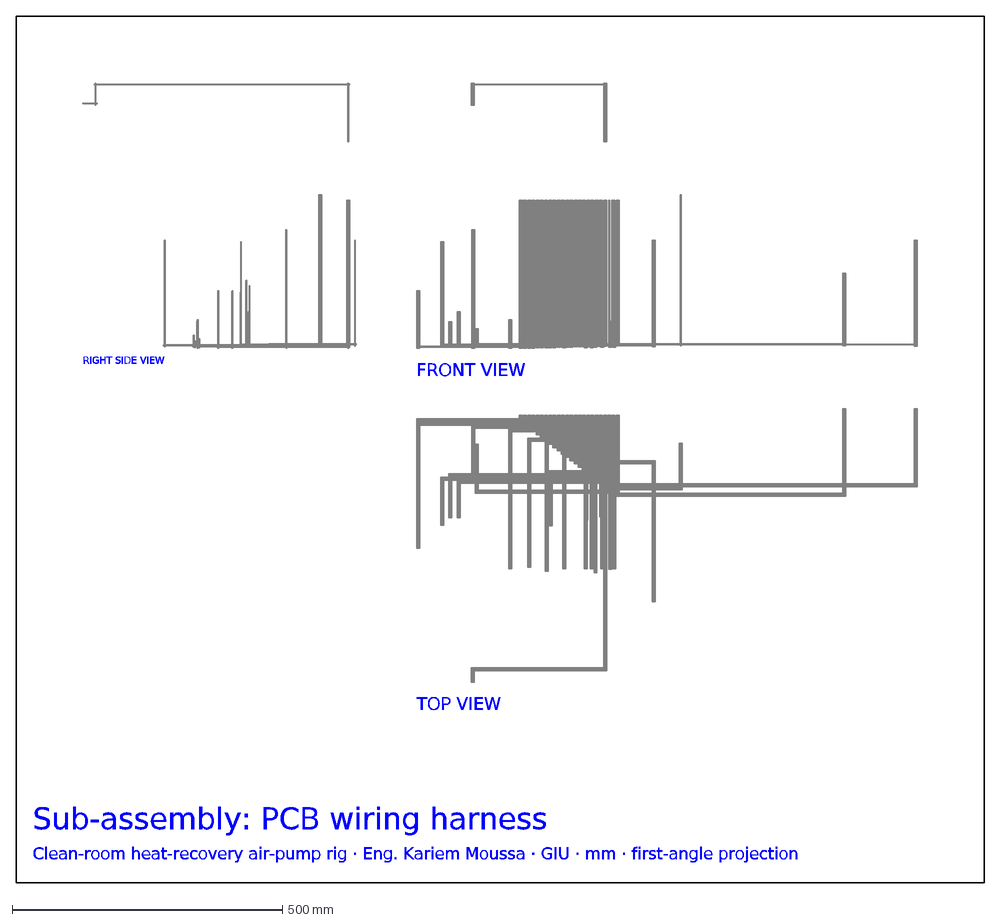
[picture p60: CAD file, 2026-10-15]
cad/dxf/sub-assemblies/PCB_wiring_harness.dxf
FRONT VIEW
TOP VIEW
RIGHT SIDE VIEW
Sub-assembly: PCB wiring harness
Clean-room heat-recovery air-pump rig · Eng. Kariem Moussa · GIU · mm · first-angle projection
