Kariemm11/Cleanroom-Heat-Recovery-Air-Pump/cad/dxf3d/parts/Acrylic_enclosure/Acrylic_base_plate-3D.dxf

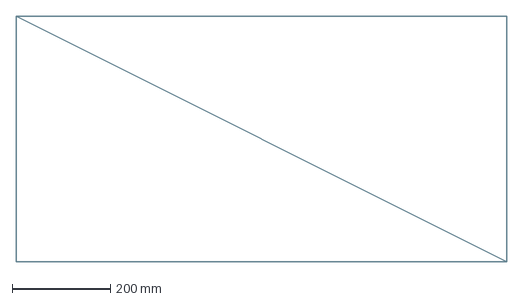
[picture p61: CAD file, 2026-10-15]
cad/dxf3d/parts/Acrylic_enclosure/Acrylic_base_plate-3D.dxf
1000.0 x 500.0 mm
