Kariemm11/Cleanroom-Heat-Recovery-Air-Pump/cad/dxf3d/parts/AHU/Misc-3D.dxf

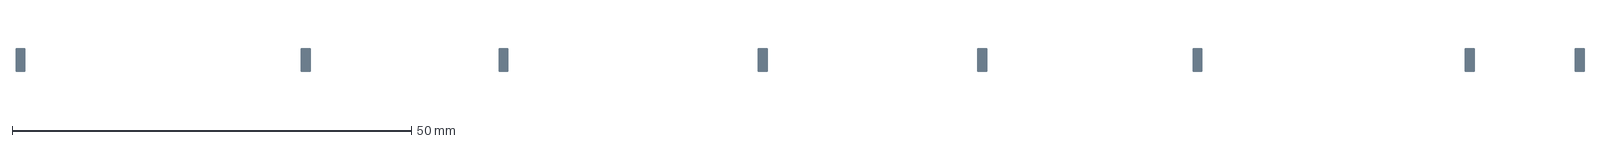
[picture p62: CAD file, 2026-10-15]
cad/dxf3d/parts/AHU/Misc-3D.dxf
196.3 x 2.86 mm
