Kariemm11/Cleanroom-Heat-Recovery-Air-Pump/cad/dxf3d/parts/Clean_room/Outfeed_accumulation_table-3D.dxf

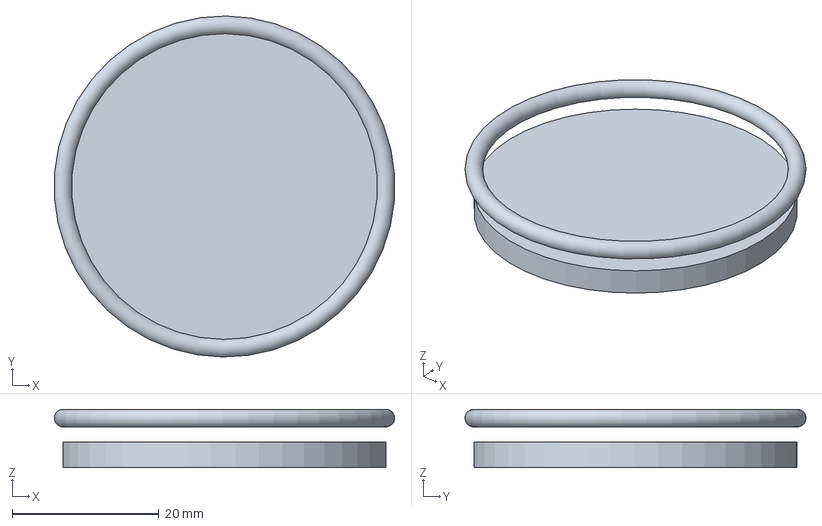
[picture p63: CAD file, 2026-10-15]
cad/dxf3d/parts/Clean_room/Outfeed_accumulation_table-3D.dxf
46.3 x 46.4 x 7.95 mm
