Kariemm11/Cleanroom-Heat-Recovery-Air-Pump/cad/dxf3d/parts/Exhaust_safety_PT-102_plus_DV-101_plus_outer_HEPA/Exhaust_stack_rain_cap-3D.dxf

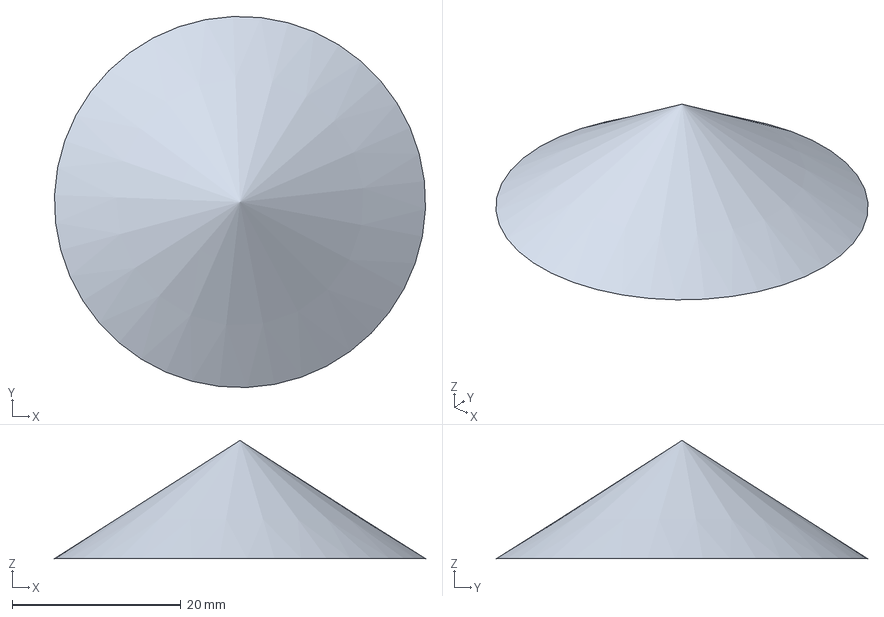
[picture p64: CAD file, 2026-10-15]
cad/dxf3d/parts/Exhaust_safety_PT-102_plus_DV-101_plus_outer_HEPA/Exhaust_stack_rain_cap-3D.dxf
44.0 x 44.0 x 14.0 mm
