Kariemm11/Cleanroom-Heat-Recovery-Air-Pump/cad/dxf3d/parts/PCB_wiring_harness/PCB_strip_TT-107-3D.dxf

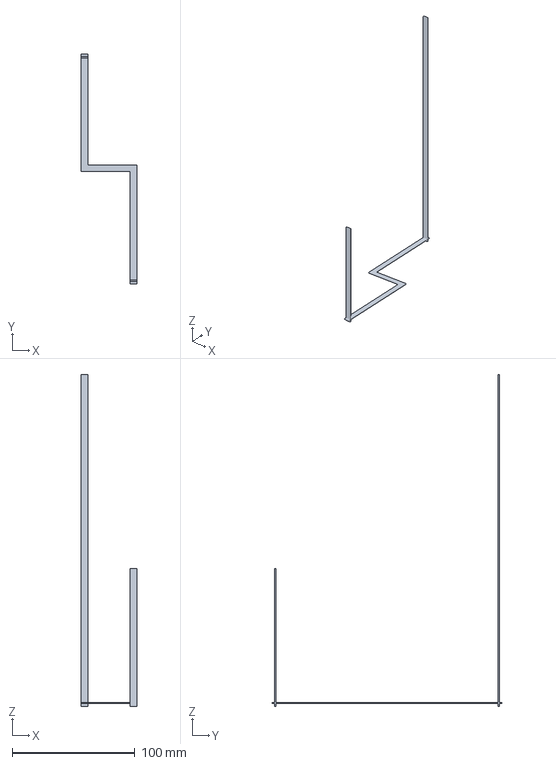
[picture p65: CAD file, 2026-10-15]
cad/dxf3d/parts/PCB_wiring_harness/PCB_strip_TT-107-3D.dxf
45.3 x 187.8 x 270.7 mm
