Kariemm11/Cleanroom-Heat-Recovery-Air-Pump/cad/dxf3d/sub-assemblies/Acrylic_enclosure-3D.dxf

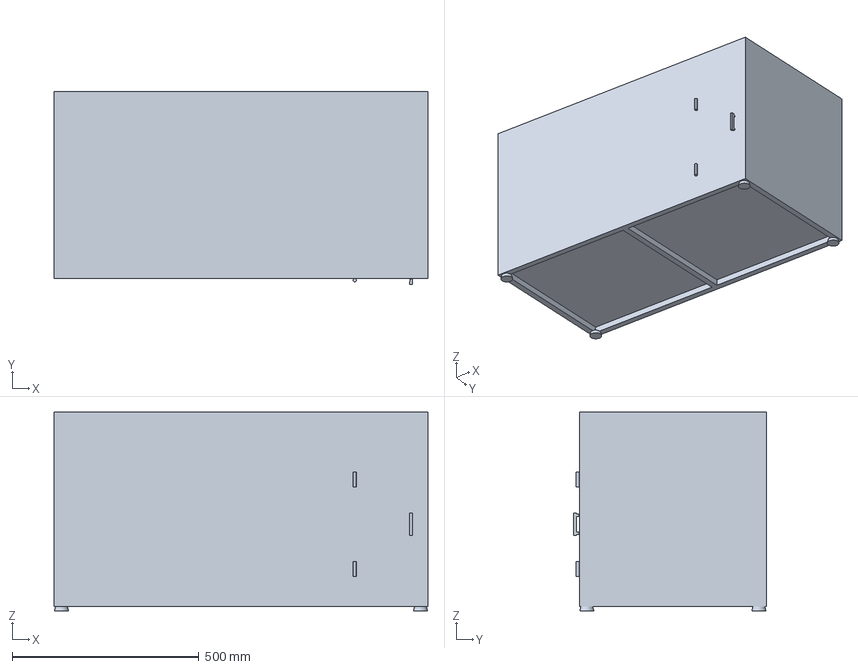
[picture p66: CAD file, 2026-10-15]
cad/dxf3d/sub-assemblies/Acrylic_enclosure-3D.dxf
1000.0 x 515.5 x 532.0 mm
