Kariemm11/Cleanroom-Heat-Recovery-Air-Pump/cad/parts/AHU/Supply_air_to_the_clean_room.step

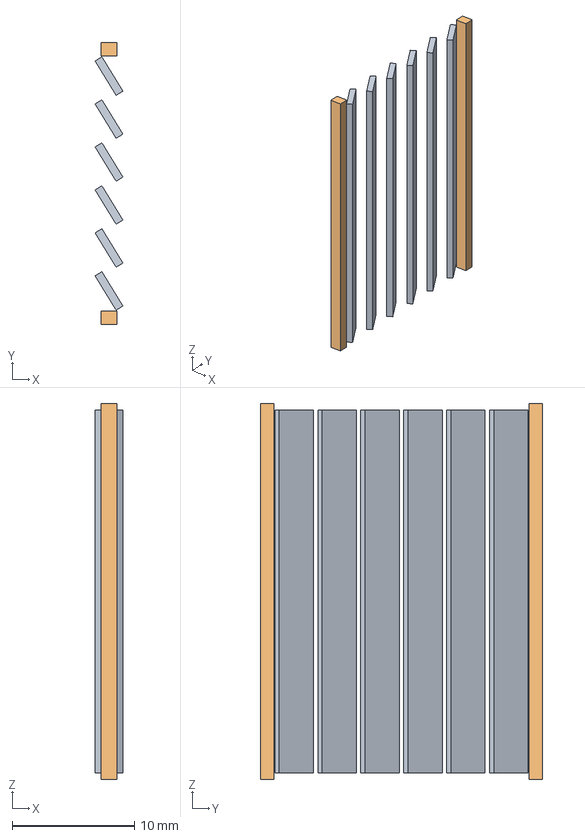
[picture p67: CAD file, 2026-10-15]
cad/parts/AHU/Supply_air_to_the_clean_room.step
2.29 x 23.1 x 30.8 mm
