Kariemm11/Cleanroom-Heat-Recovery-Air-Pump/cad/parts/Clean_room/LAF_hood_PVC_skirts_plus_hangers.step

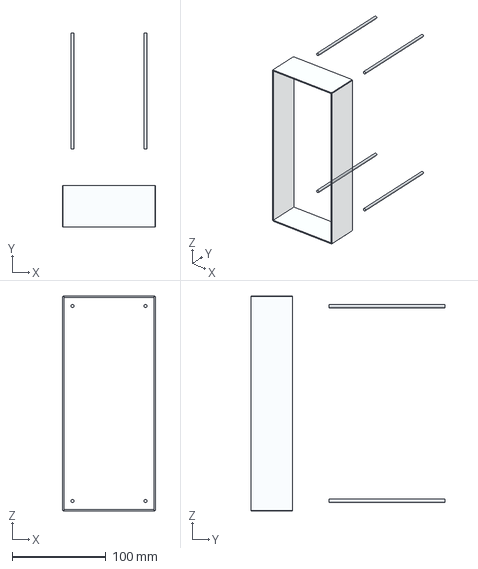
[picture p68: CAD file, 2026-10-15]
cad/parts/Clean_room/LAF_hood_PVC_skirts_plus_hangers.step
99.5 x 207.0 x 229.5 mm
