Kariemm11/Cleanroom-Heat-Recovery-Air-Pump/cad/parts/Controls_and_HMI/24_V_DC_power_supply.step

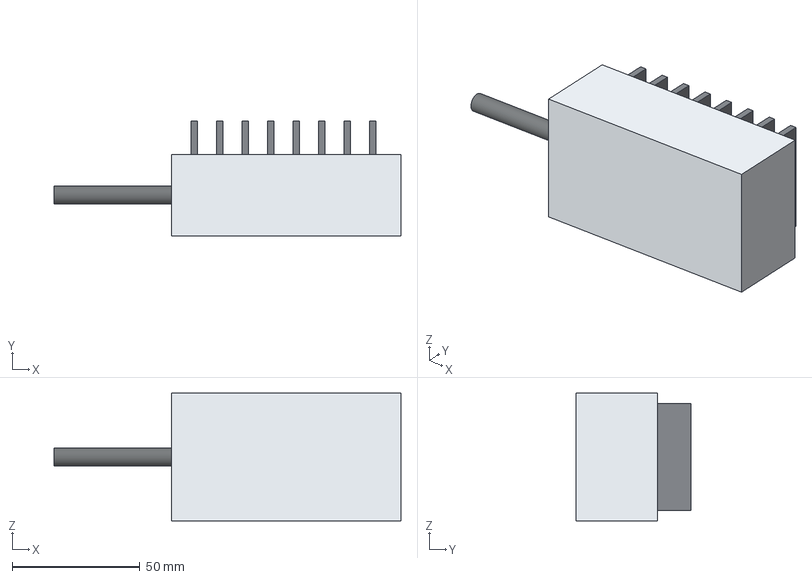
[picture p69: CAD file, 2026-10-15]
cad/parts/Controls_and_HMI/24_V_DC_power_supply.step
136.0 x 45.0 x 50.0 mm
