Kariemm11/Cleanroom-Heat-Recovery-Air-Pump/cad/parts/Ductwork/LAF_supply_drop.step

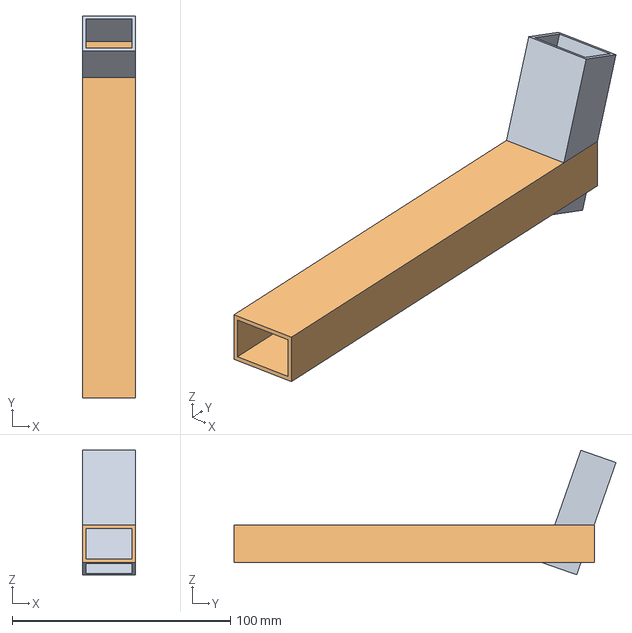
[picture p70: CAD file, 2026-10-15]
cad/parts/Ductwork/LAF_supply_drop.step
24.2 x 175.0 x 57.1 mm
