Kariemm11/Cleanroom-Heat-Recovery-Air-Pump/cad/parts/Heat-recovery_air-pump_unit/Recovery_unit_control_box.step

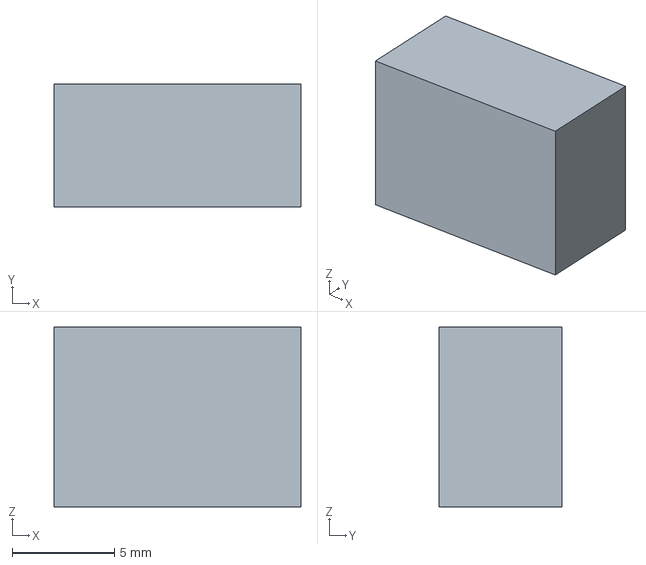
[picture p71: CAD file, 2026-10-15]
cad/parts/Heat-recovery_air-pump_unit/Recovery_unit_control_box.step
12.1 x 6.05 x 8.80 mm
