Kariemm11/Cleanroom-Heat-Recovery-Air-Pump/cad/parts/PCB_wiring_harness/PCB_strip_PDT-101.step

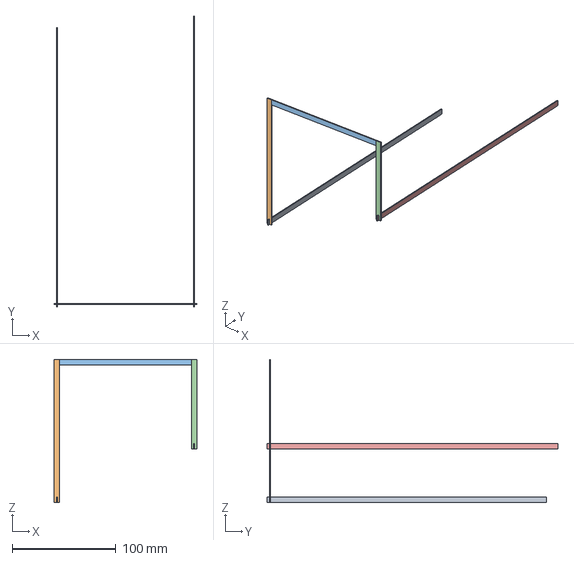
[picture p72: CAD file, 2026-10-15]
cad/parts/PCB_wiring_harness/PCB_strip_PDT-101.step
137.7 x 280.2 x 138.0 mm
