Kariemm11/Cleanroom-Heat-Recovery-Air-Pump/cad/dxf/enclosure-panels/Right_wall.dxf

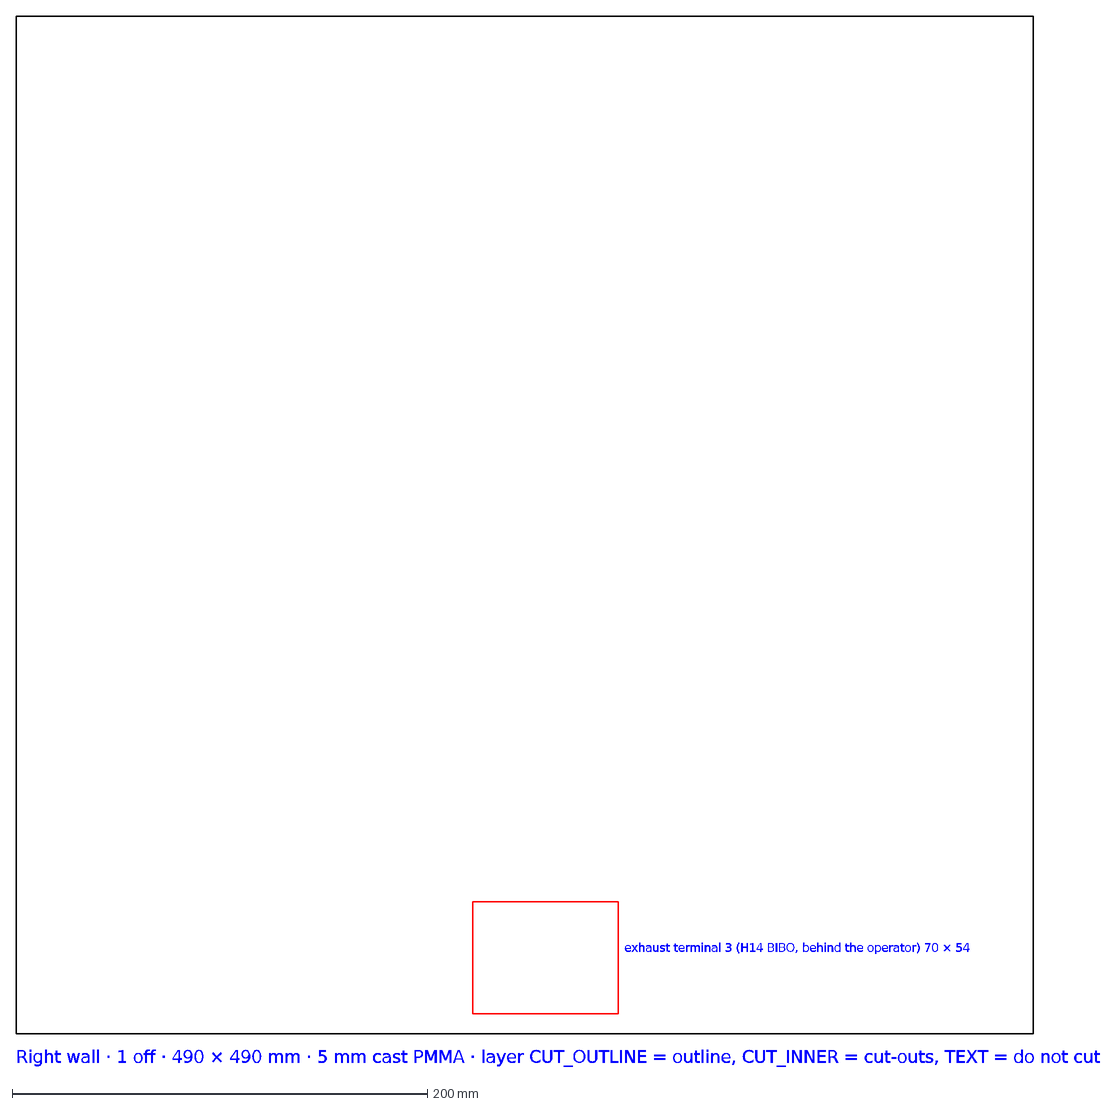
[picture p74: CAD file, 2026-10-15]
cad/dxf/enclosure-panels/Right_wall.dxf
exhaust terminal 3 (H14 BIBO, behind the operator) 70 × 54
Right wall · 1 off · 490 × 490 mm · 5 mm cast PMMA · layer CUT_OUTLINE = outline, CUT_INNER = cut-outs, TEXT = do not cut
