Kariemm11/Cleanroom-Heat-Recovery-Air-Pump/cad/dxf/sub-assemblies/AHU.dxf

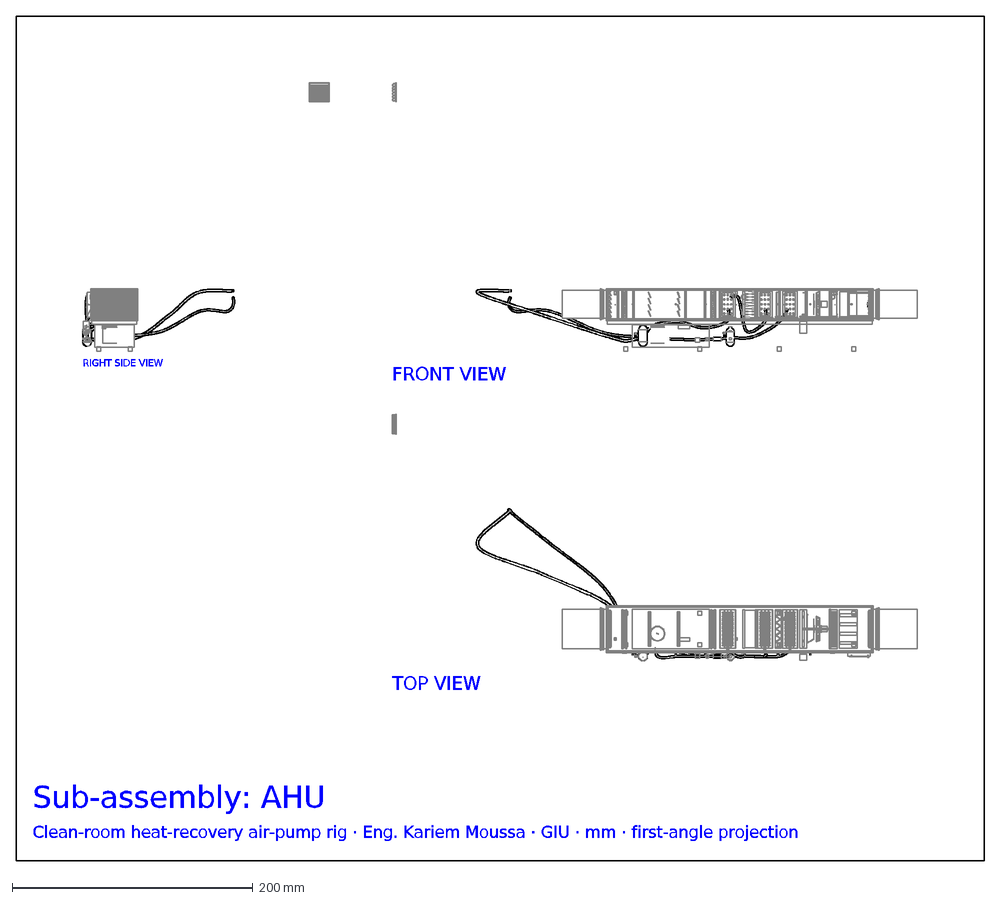
[picture p75: CAD file, 2026-10-15]
cad/dxf/sub-assemblies/AHU.dxf
FRONT VIEW
TOP VIEW
RIGHT SIDE VIEW
Sub-assembly: AHU
Clean-room heat-recovery air-pump rig · Eng. Kariem Moussa · GIU · mm · first-angle projection
