Kariemm11/Cleanroom-Heat-Recovery-Air-Pump/cad/dxf3d/parts/AHU/R32_refrigerant_pipework-3D.dxf

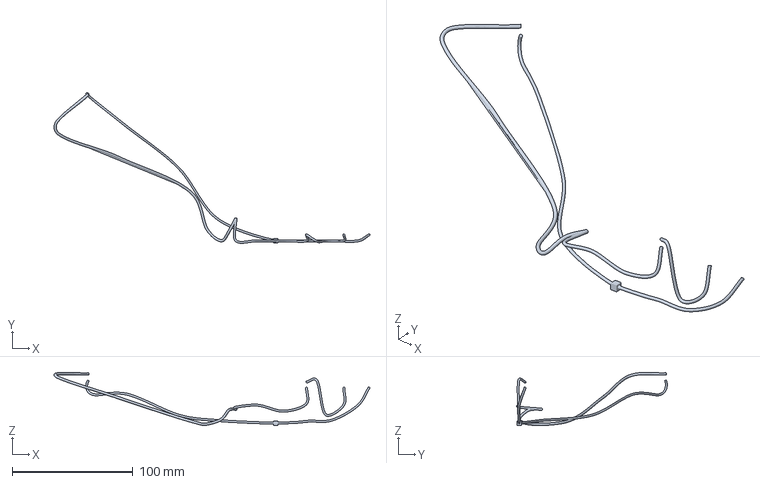
[picture p76: CAD file, 2026-10-15]
cad/dxf3d/parts/AHU/R32_refrigerant_pipework-3D.dxf
261.2 x 124.6 x 43.9 mm
