Kariemm11/Cleanroom-Heat-Recovery-Air-Pump/cad/dxf3d/parts/Clean_room/LAF_hood_H14_BIBO_filter_housing-3D.dxf

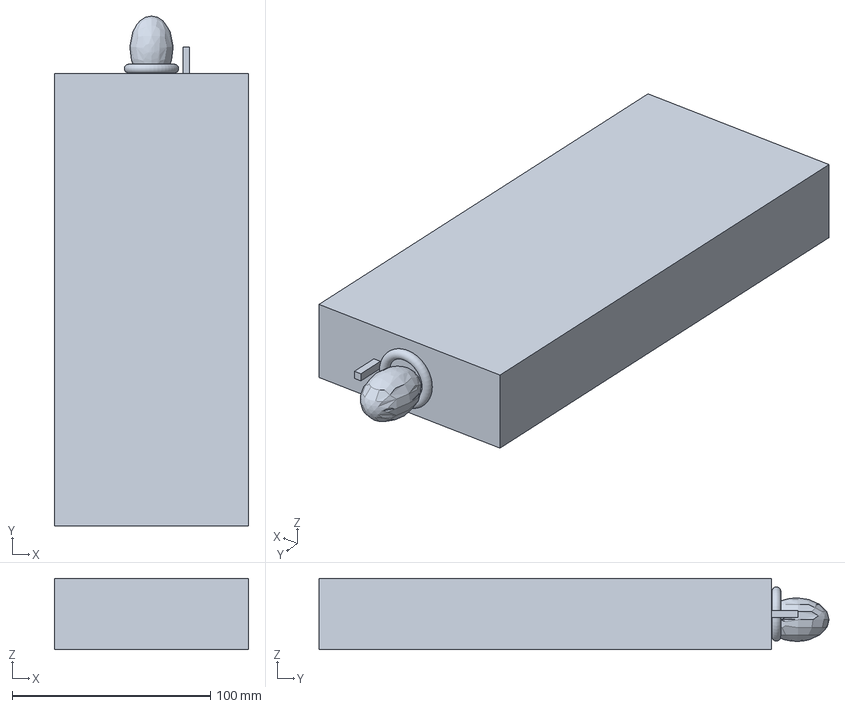
[picture p77: CAD file, 2026-10-15]
cad/dxf3d/parts/Clean_room/LAF_hood_H14_BIBO_filter_housing-3D.dxf
98.0 x 257.0 x 36.0 mm
