Kariemm11/Cleanroom-Heat-Recovery-Air-Pump/cad/dxf3d/parts/Ductwork/Partition_sleeve_supply-3D.dxf

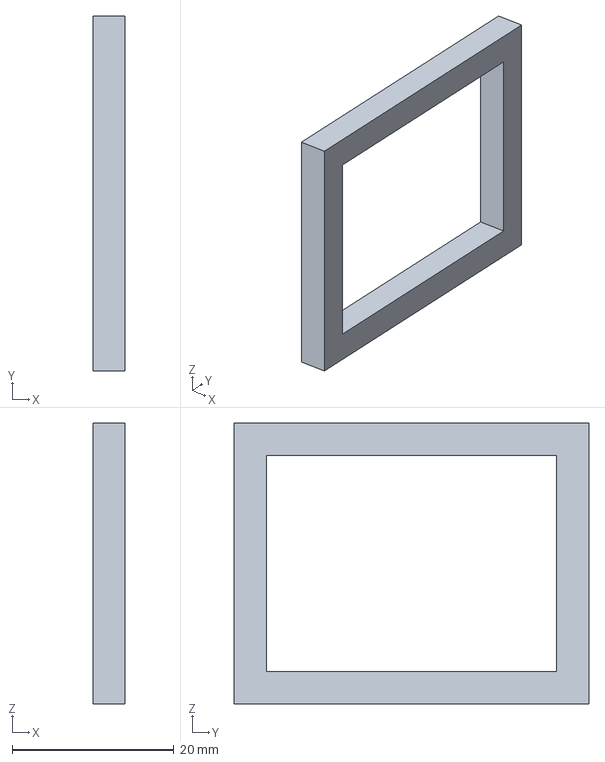
[picture p78: CAD file, 2026-10-15]
cad/dxf3d/parts/Ductwork/Partition_sleeve_supply-3D.dxf
4.00 x 43.8 x 34.7 mm
