Kariemm11/Cleanroom-Heat-Recovery-Air-Pump/cad/dxf3d/parts/Exhaust_safety_PT-102_plus_DV-101_plus_outer_HEPA/PT-102_exhaust_particle_sensor-3D.dxf

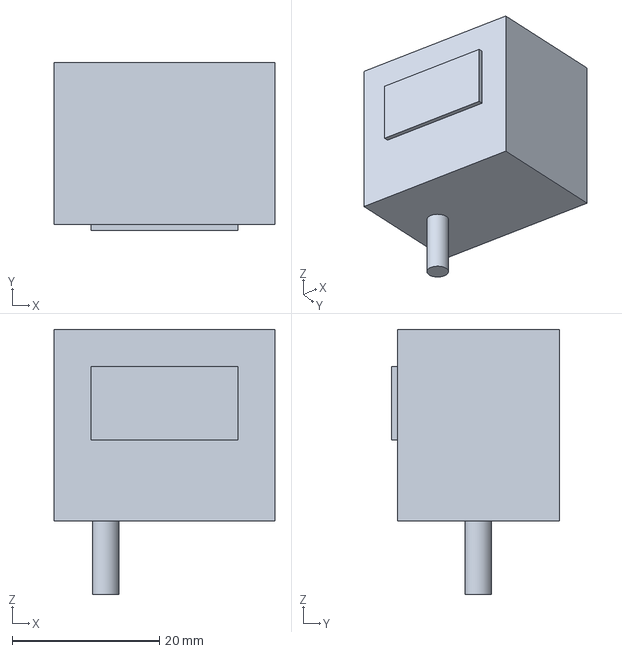
[picture p79: CAD file, 2026-10-15]
cad/dxf3d/parts/Exhaust_safety_PT-102_plus_DV-101_plus_outer_HEPA/PT-102_exhaust_particle_sensor-3D.dxf
30.0 x 22.8 x 36.0 mm
