Kariemm11/Cleanroom-Heat-Recovery-Air-Pump/cad/dxf3d/parts/PCB_wiring_harness/PCB_strip_FAN-103B_copper-3D.dxf

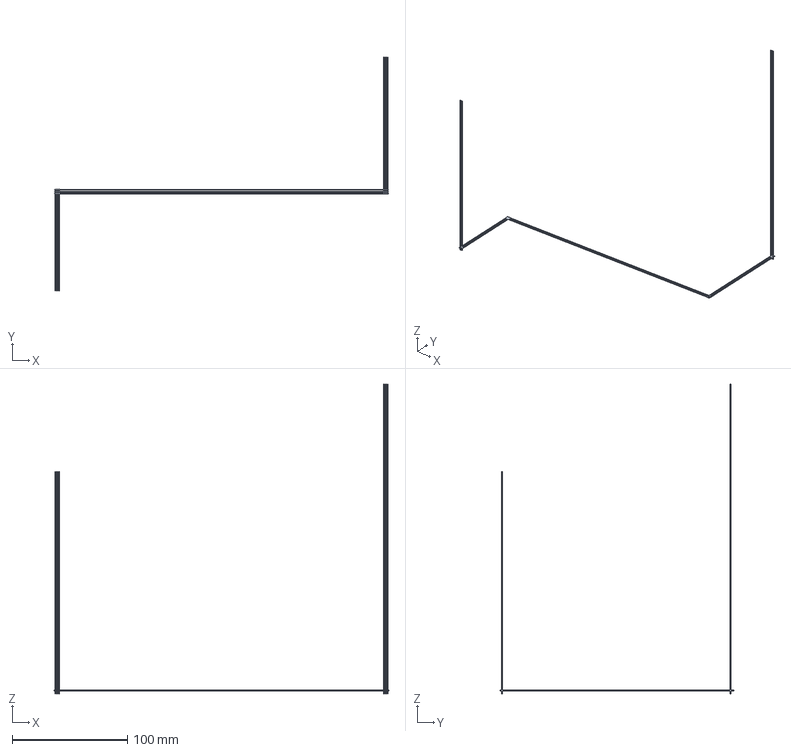
[picture p80: CAD file, 2026-10-15]
cad/dxf3d/parts/PCB_wiring_harness/PCB_strip_FAN-103B_copper-3D.dxf
289.9 x 202.8 x 268.8 mm
