Kariemm11/Cleanroom-Heat-Recovery-Air-Pump/cad/parts/Acrylic_enclosure/Clean-room_access_door.step

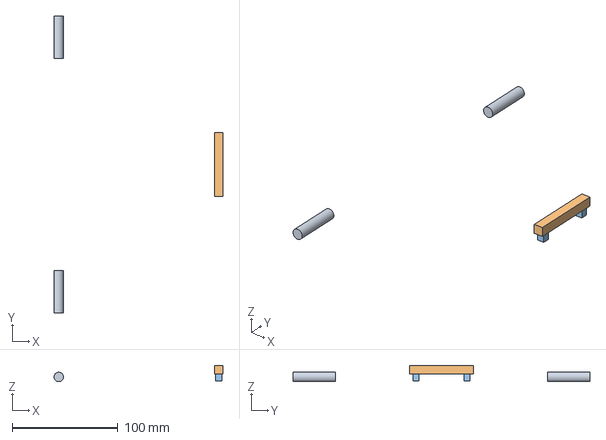
[picture p81: CAD file, 2026-10-15]
cad/parts/Acrylic_enclosure/Clean-room_access_door.step
159.5 x 280.0 x 15.5 mm
