Kariemm11/Cleanroom-Heat-Recovery-Air-Pump/cad/parts/AHU/R32_charging_port_liquid_side.step

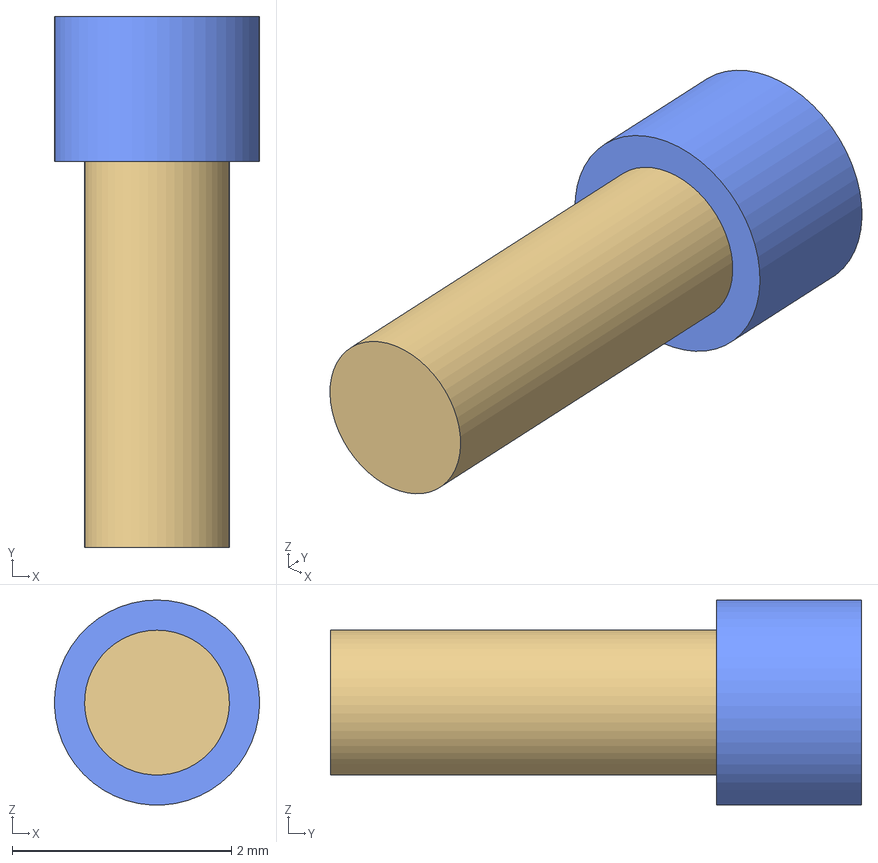
[picture p82: CAD file, 2026-10-15]
cad/parts/AHU/R32_charging_port_liquid_side.step
1.87 x 4.84 x 1.87 mm
