Kariemm11/Cleanroom-Heat-Recovery-Air-Pump/cad/parts/Clean_room/Ceiling_terminal_1_face_screen.step

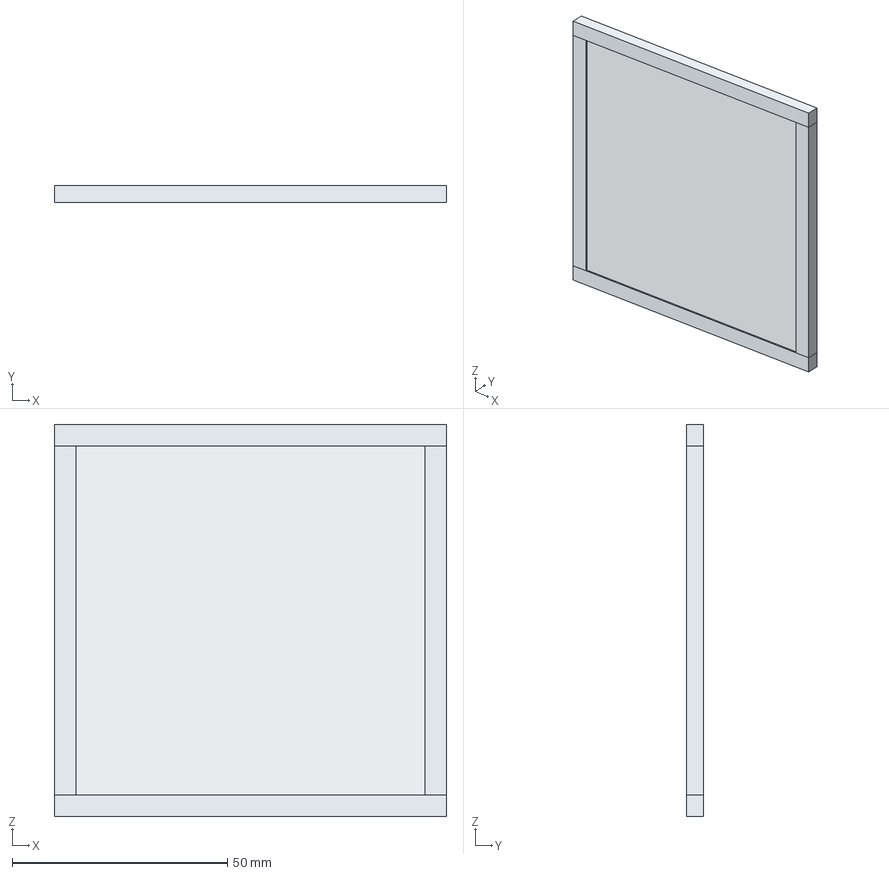
[picture p83: CAD file, 2026-10-15]
cad/parts/Clean_room/Ceiling_terminal_1_face_screen.step
91.0 x 4.00 x 91.0 mm
