Kariemm11/Cleanroom-Heat-Recovery-Air-Pump/cad/parts/Heat-recovery_air-pump_unit/Cu_plate_core_Ra_0.8_m.step

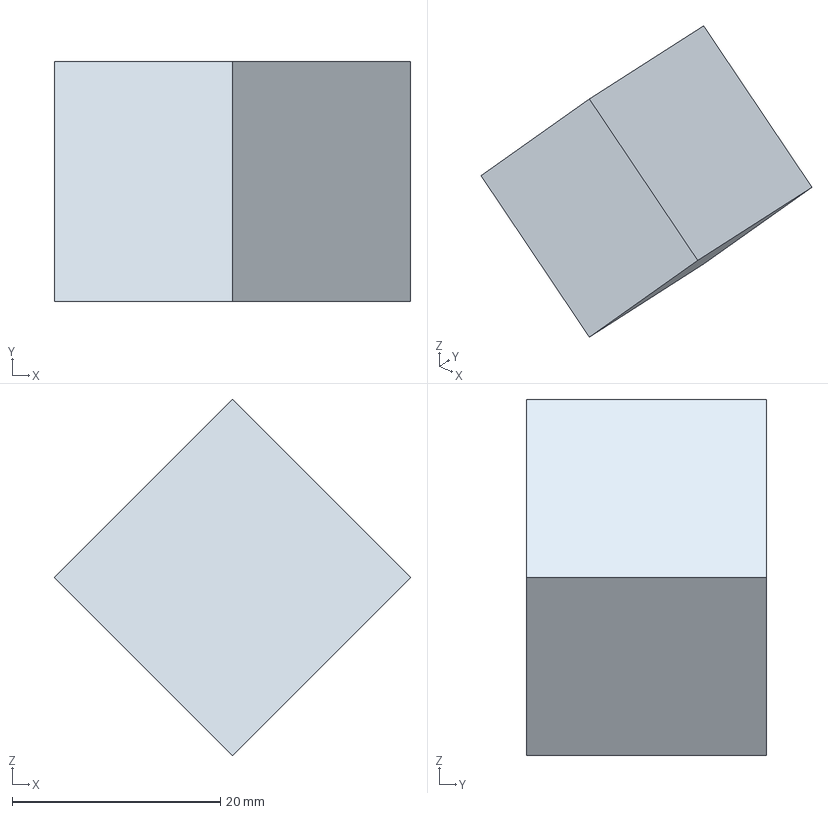
[picture p84: CAD file, 2026-10-15]
cad/parts/Heat-recovery_air-pump_unit/Cu_plate_core_Ra_0.8_m.step
34.2 x 23.1 x 34.2 mm
