Kariemm11/Cleanroom-Heat-Recovery-Air-Pump/cad/parts/PCB_wiring_harness/PCB_strip_FAN-102.step

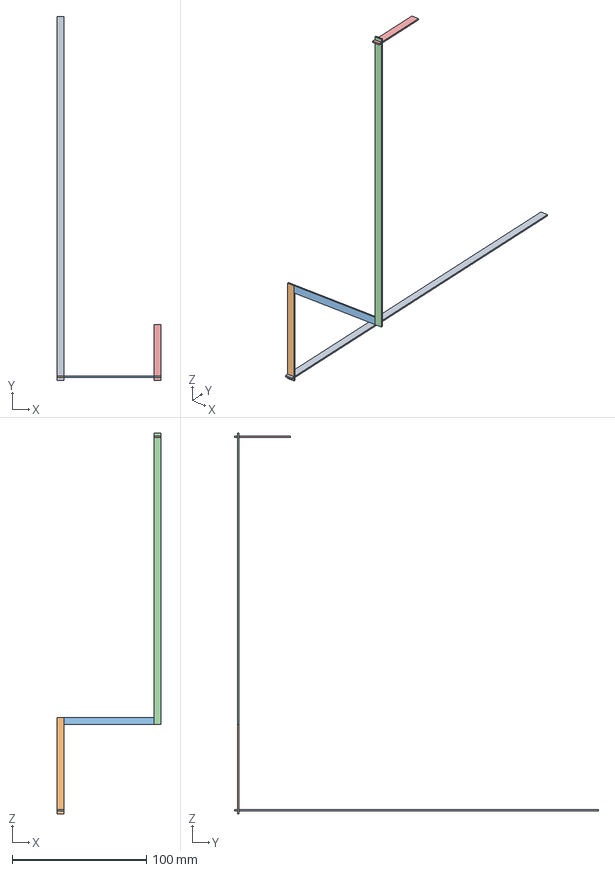
[picture p85: CAD file, 2026-10-15]
cad/parts/PCB_wiring_harness/PCB_strip_FAN-102.step
77.9 x 271.6 x 284.0 mm
