Kariemm11/Cleanroom-Heat-Recovery-Air-Pump/cad/dxf/enclosure-panels/Clean-room_false_ceiling.dxf

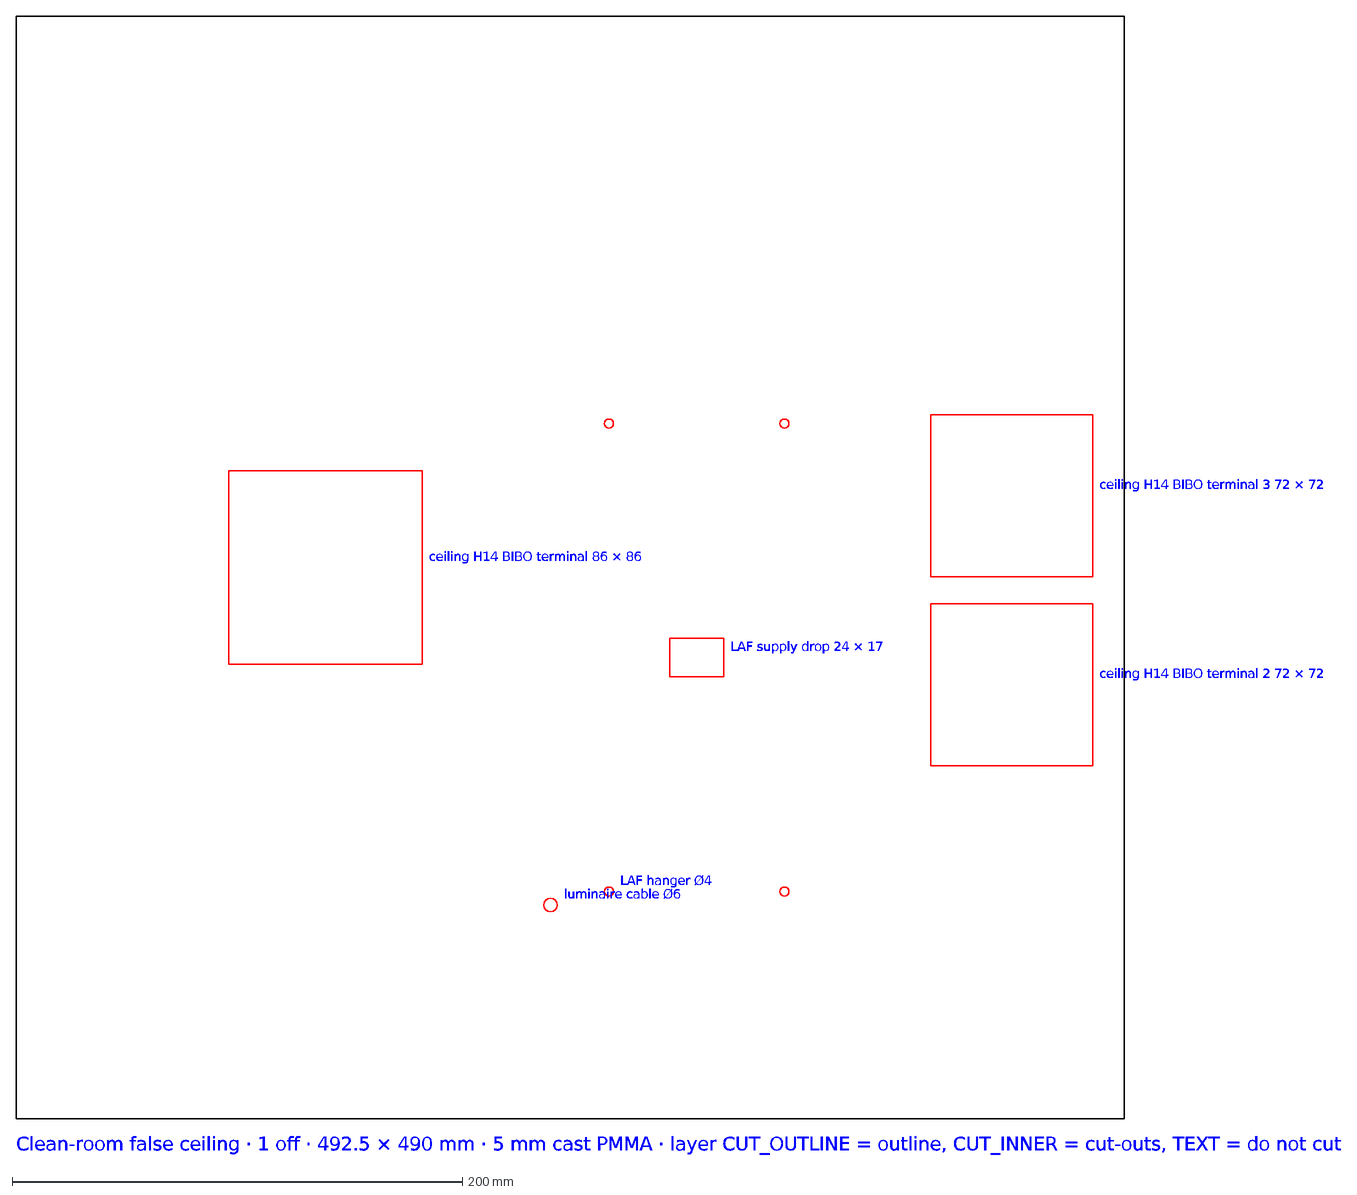
[picture p86: CAD file, 2026-10-15]
cad/dxf/enclosure-panels/Clean-room_false_ceiling.dxf
ceiling H14 BIBO terminal 86 × 86
LAF supply drop 24 × 17
ceiling H14 BIBO terminal 2 72 × 72
ceiling H14 BIBO terminal 3 72 × 72
LAF hanger Ø4
luminaire cable Ø6
Clean-room false ceiling · 1 off · 492.5 × 490 mm · 5 mm cast PMMA · layer CUT_OUTLINE = outline, CUT_INNER = cut-outs, TEXT = do not cut
