Kariemm11/Cleanroom-Heat-Recovery-Air-Pump/cad/dxf/sub-assemblies/Fresh-air_compressor.dxf

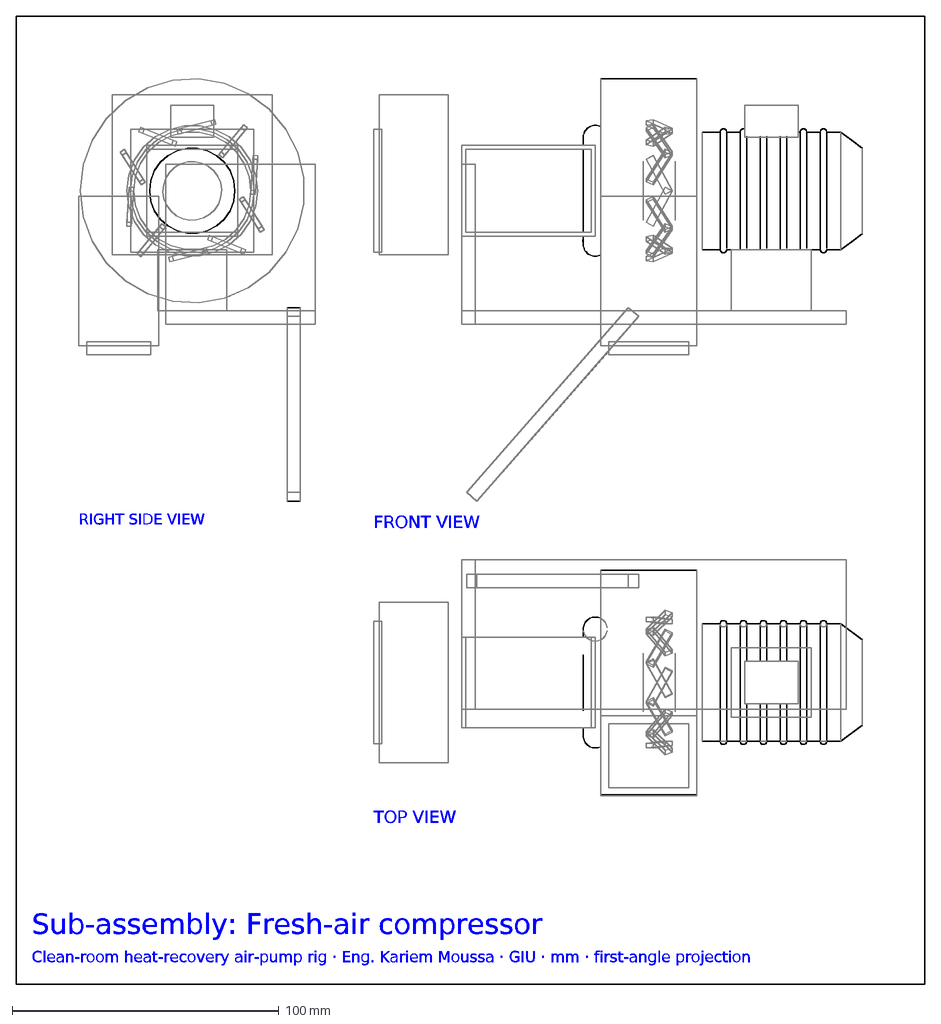
[picture p87: CAD file, 2026-10-15]
cad/dxf/sub-assemblies/Fresh-air_compressor.dxf
FRONT VIEW
TOP VIEW
RIGHT SIDE VIEW
Sub-assembly: Fresh-air compressor
Clean-room heat-recovery air-pump rig · Eng. Kariem Moussa · GIU · mm · first-angle projection
