Kariemm11/Cleanroom-Heat-Recovery-Air-Pump/cad/dxf3d/parts/AHU/R32_sight_glass_plus_moisture_indicator-3D.dxf

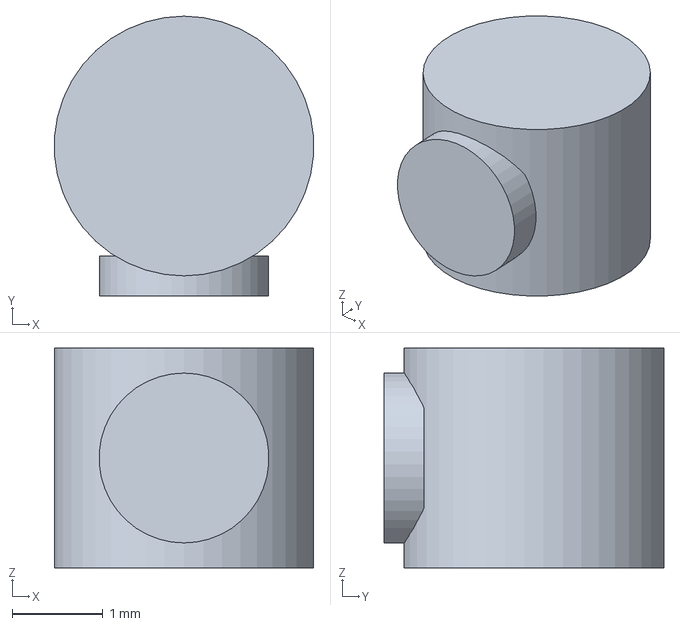
[picture p88: CAD file, 2026-10-15]
cad/dxf3d/parts/AHU/R32_sight_glass_plus_moisture_indicator-3D.dxf
2.85 x 3.08 x 2.42 mm
