Kariemm11/Cleanroom-Heat-Recovery-Air-Pump/cad/dxf3d/parts/Clean_room/LAF_hood_perforated_outlet_screen-3D.dxf

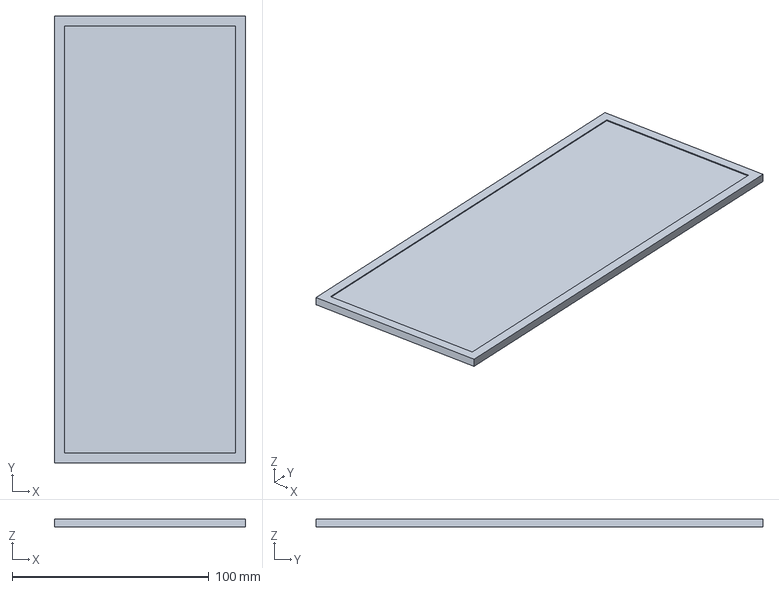
[picture p89: CAD file, 2026-10-15]
cad/dxf3d/parts/Clean_room/LAF_hood_perforated_outlet_screen-3D.dxf
97.0 x 227.0 x 4.00 mm
