Kariemm11/Cleanroom-Heat-Recovery-Air-Pump/cad/dxf3d/parts/Controls_and_HMI/PDT-101_room_dP_SDP810-3D.dxf

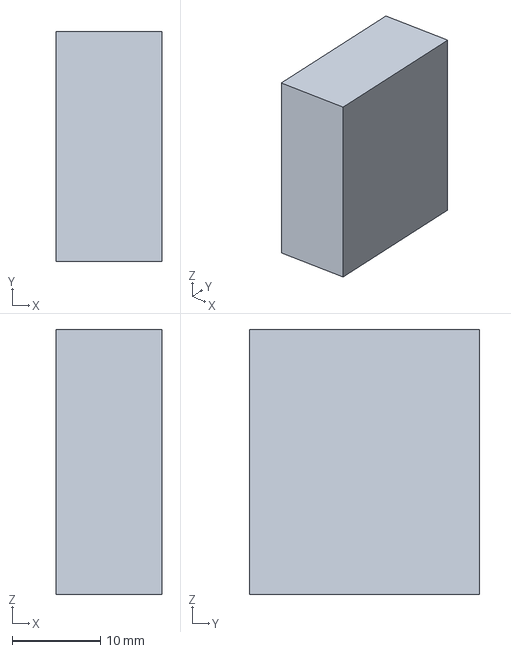
[picture p90: CAD file, 2026-10-15]
cad/dxf3d/parts/Controls_and_HMI/PDT-101_room_dP_SDP810-3D.dxf
12.0 x 26.0 x 30.0 mm
