Kariemm11/Cleanroom-Heat-Recovery-Air-Pump/cad/dxf3d/parts/Ductwork/Supply_riser-3D.dxf

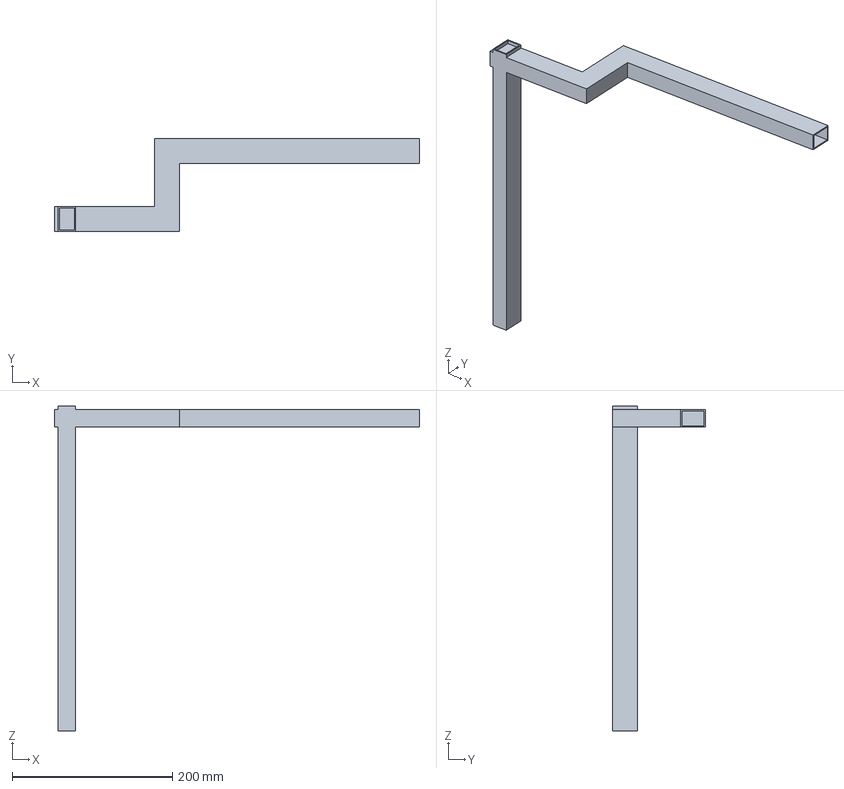
[picture p91: CAD file, 2026-10-15]
cad/dxf3d/parts/Ductwork/Supply_riser-3D.dxf
455.4 x 115.8 x 405.3 mm
