Kariemm11/Cleanroom-Heat-Recovery-Air-Pump/cad/dxf3d/parts/PCB_wiring_harness/PCB_strip_FT-101-3D.dxf

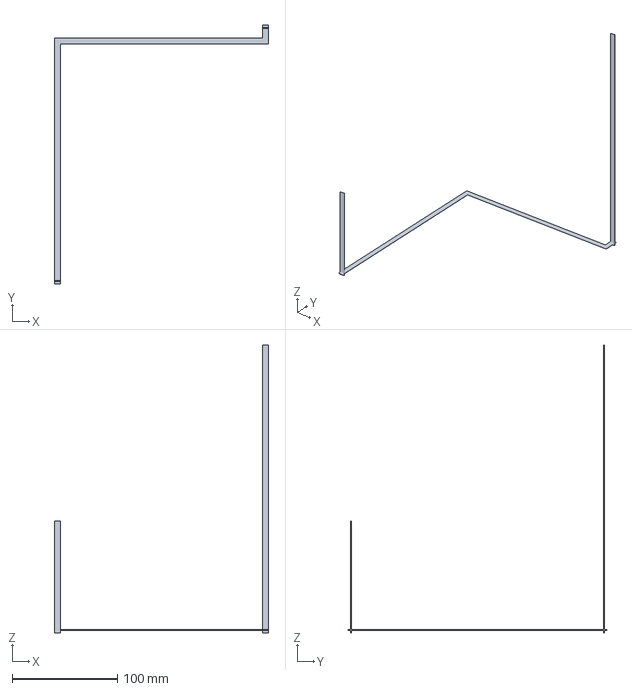
[picture p92: CAD file, 2026-10-15]
cad/dxf3d/parts/PCB_wiring_harness/PCB_strip_FT-101-3D.dxf
203.3 x 246.0 x 273.6 mm
