Kariemm11/Cleanroom-Heat-Recovery-Air-Pump/cad/dxf3d/sub-assemblies/AHU-3D.dxf

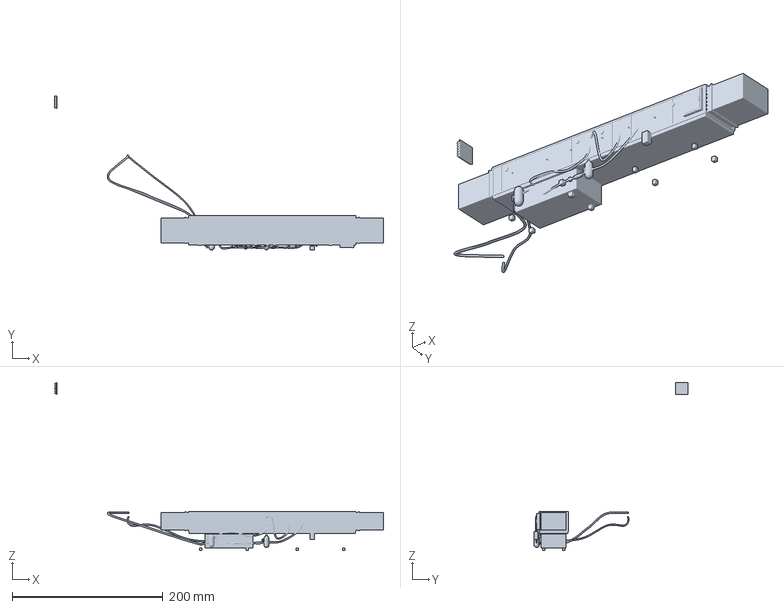
[picture p93: CAD file, 2026-10-15]
cad/dxf3d/sub-assemblies/AHU-3D.dxf
435.9 x 204.5 x 222.9 mm
