Kariemm11/Cleanroom-Heat-Recovery-Air-Pump/cad/parts/Ductwork/Exhaust_collector_B_behind_the_partition.step

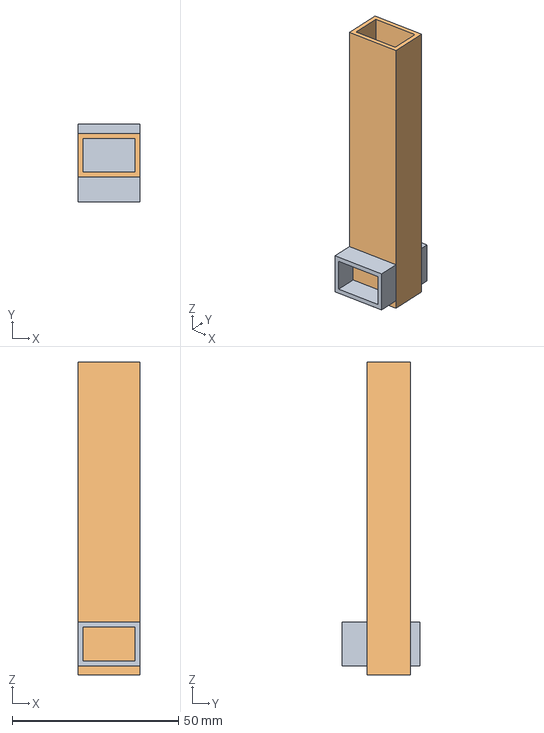
[picture p94: CAD file, 2026-10-15]
cad/parts/Ductwork/Exhaust_collector_B_behind_the_partition.step
18.7 x 23.3 x 94.2 mm
