Kariemm11/Cleanroom-Heat-Recovery-Air-Pump/cad/parts/Exhaust_safety_PT-102_plus_DV-101_plus_outer_HEPA/TT-107_exhaust_air_T_DS18B20.step

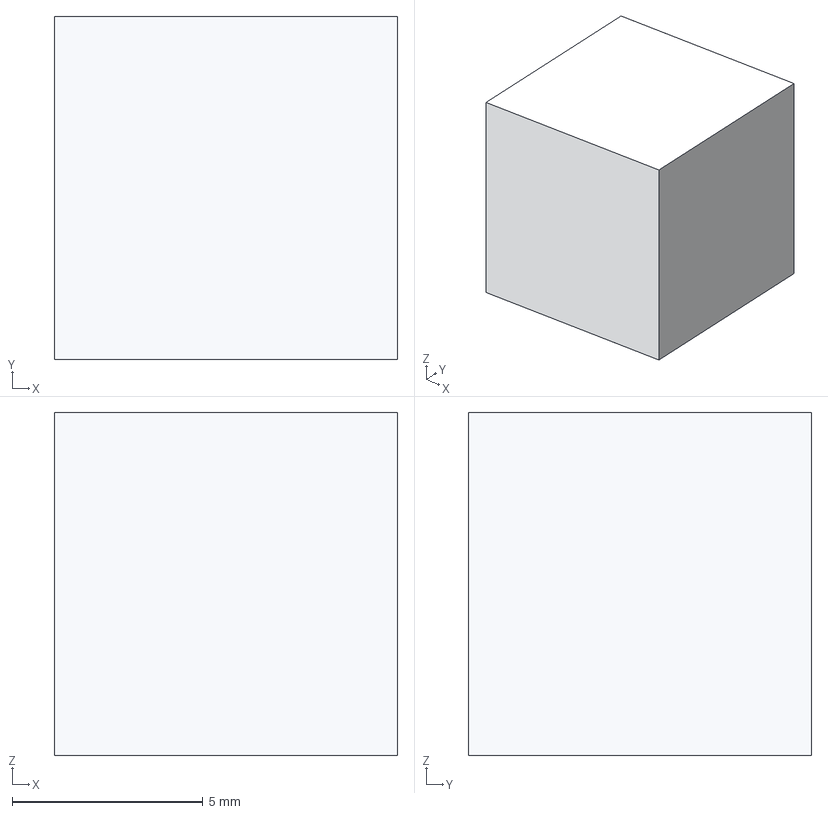
[picture p95: CAD file, 2026-10-15]
cad/parts/Exhaust_safety_PT-102_plus_DV-101_plus_outer_HEPA/TT-107_exhaust_air_T_DS18B20.step
9.00 x 9.00 x 9.00 mm
