Kariemm11/Cleanroom-Heat-Recovery-Air-Pump/cad/step/Heat-recovery_air-pump_unit.step

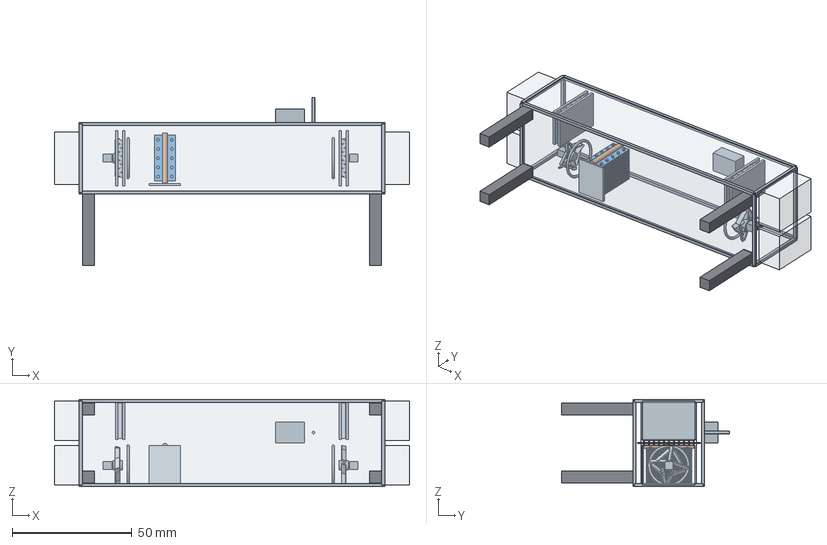
[picture p96: CAD file, 2026-10-15]
cad/step/Heat-recovery_air-pump_unit.step
148.5 x 70.1 x 36.5 mm
Coil extract
Coil extract -2
Coil extract -3
Coil extract -4
Misc
Misc -2
Misc -3
Cu plate core (Ra 0.8 m)
Cu plate core (Ra 0.8 m) -2
Fresh-air filter
Fresh-air filter -2
Exhaust filter
Exhaust filter -2
Tempered-air fan
Tempered-air fan -2
FAN-103 exhaust fan
FAN-103 exhaust fan -2
Recovery unit control box
Recovery unit spigot
Recovery unit support posts
