Kariemm11/Cleanroom-Heat-Recovery-Air-Pump/cad/dxf/enclosure-panels/Back_wall.dxf

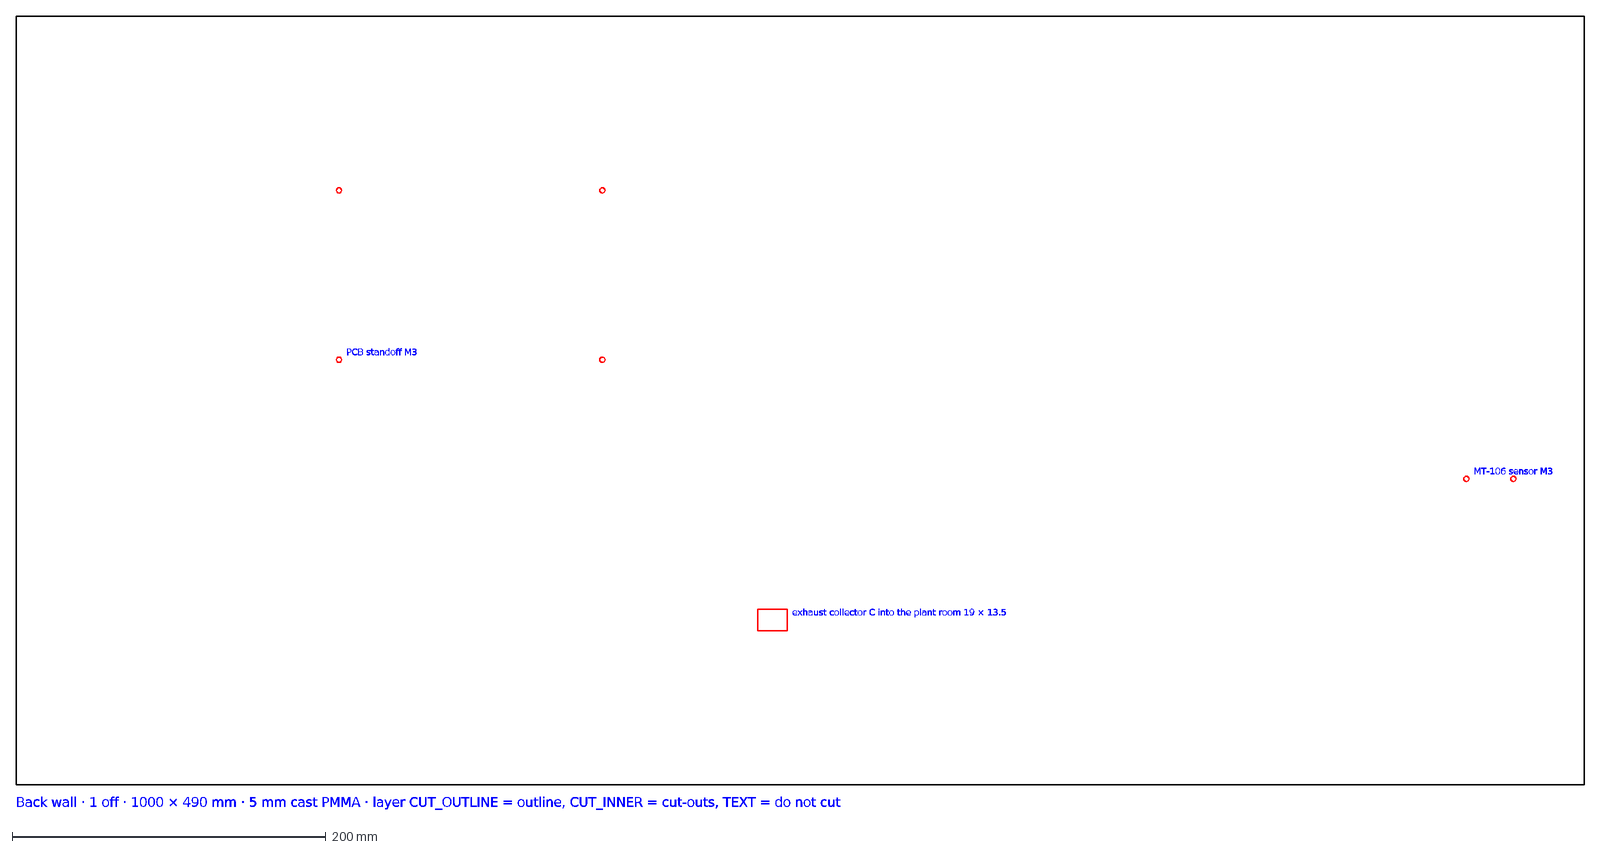
[picture p97: CAD file, 2026-10-15]
cad/dxf/enclosure-panels/Back_wall.dxf
PCB standoff M3
MT-106 sensor M3
exhaust collector C into the plant room 19 × 13.5
Back wall · 1 off · 1000 × 490 mm · 5 mm cast PMMA · layer CUT_OUTLINE = outline, CUT_INNER = cut-outs, TEXT = do not cut
