Kariemm11/Cleanroom-Heat-Recovery-Air-Pump/cad/dxf/sub-assemblies/Ductwork.dxf

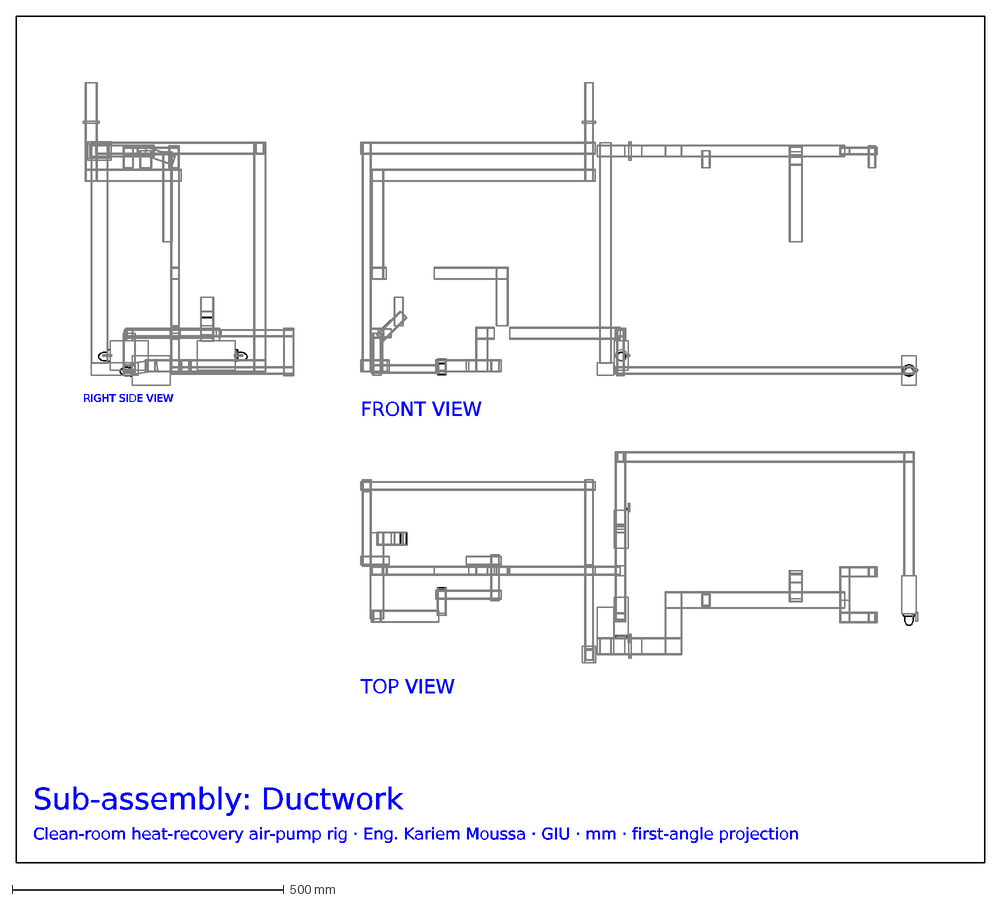
[picture p98: CAD file, 2026-10-15]
cad/dxf/sub-assemblies/Ductwork.dxf
FRONT VIEW
TOP VIEW
RIGHT SIDE VIEW
Sub-assembly: Ductwork
Clean-room heat-recovery air-pump rig · Eng. Kariem Moussa · GIU · mm · first-angle projection
