Kariemm11/Cleanroom-Heat-Recovery-Air-Pump/cad/dxf3d/parts/AHU/Panel_filter-3D.dxf

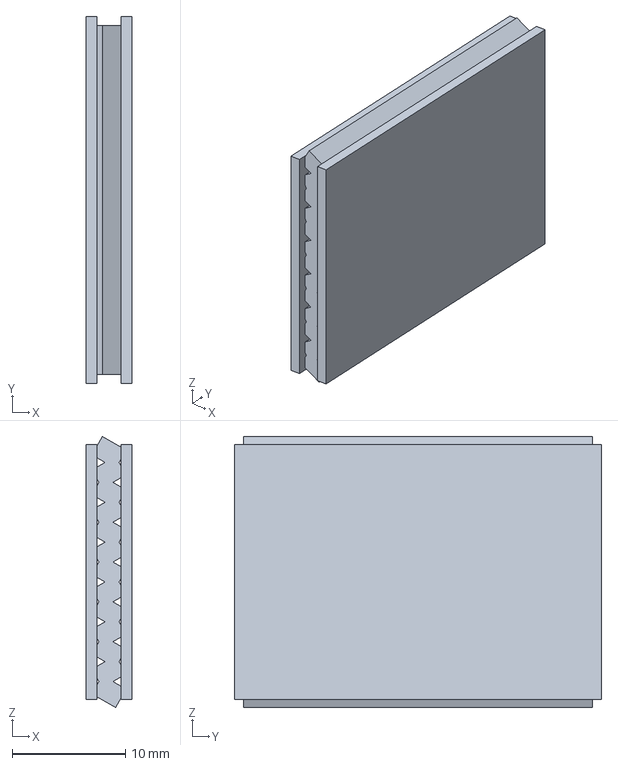
[picture p99: CAD file, 2026-10-15]
cad/dxf3d/parts/AHU/Panel_filter-3D.dxf
4.07 x 32.5 x 23.9 mm
