Kariemm11/Cleanroom-Heat-Recovery-Air-Pump/cad/dxf3d/parts/Controls_and_HMI/PT-101_isokinetic_probe-3D.dxf

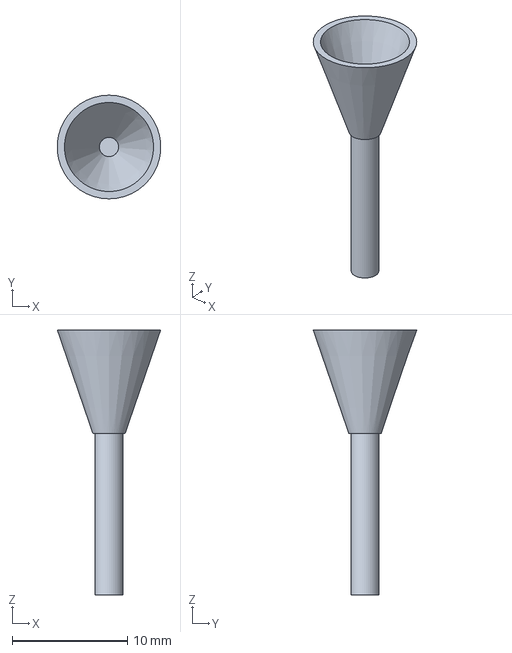
[picture p100: CAD file, 2026-10-15]
cad/dxf3d/parts/Controls_and_HMI/PT-101_isokinetic_probe-3D.dxf
8.97 x 9.00 x 23.0 mm
