Kariemm11/Cleanroom-Heat-Recovery-Air-Pump/cad/dxf3d/parts/Exhaust_safety_PT-102_plus_DV-101_plus_outer_HEPA/Outer_BIBO_HEPA_housing_H14_police_filter-3D.dxf

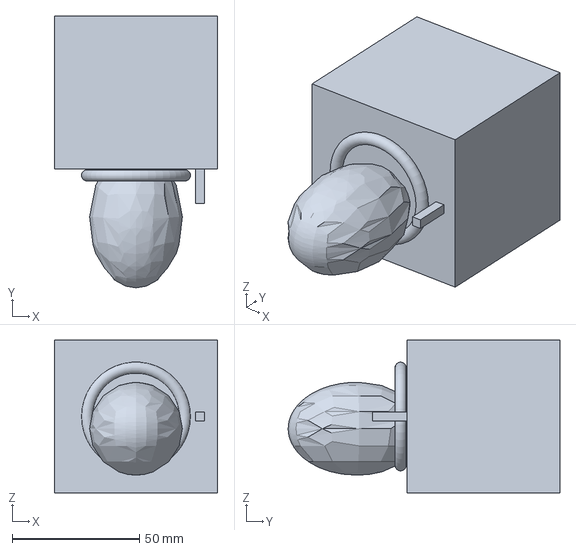
[picture p101: CAD file, 2026-10-15]
cad/dxf3d/parts/Exhaust_safety_PT-102_plus_DV-101_plus_outer_HEPA/Outer_BIBO_HEPA_housing_H14_police_filter-3D.dxf
64.0 x 106.7 x 60.0 mm
