Kariemm11/Cleanroom-Heat-Recovery-Air-Pump/cad/dxf3d/parts/PCB_wiring_harness/PCB_strip_TT-103_copper-3D.dxf

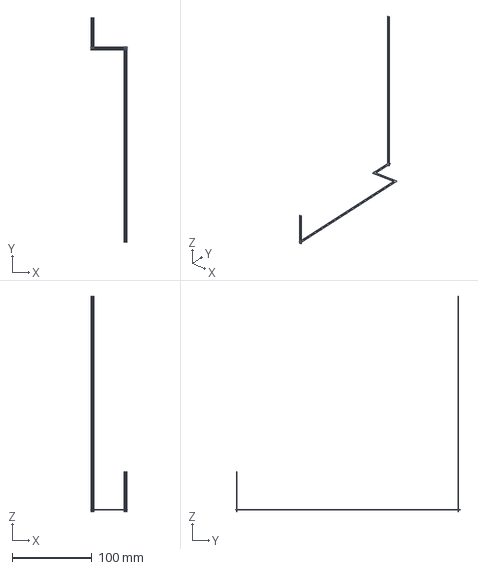
[picture p102: CAD file, 2026-10-15]
cad/dxf3d/parts/PCB_wiring_harness/PCB_strip_TT-103_copper-3D.dxf
46.3 x 283.0 x 271.7 mm
