Kariemm11/Cleanroom-Heat-Recovery-Air-Pump/cad/parts/Clean_room/Infeed_turntable.step

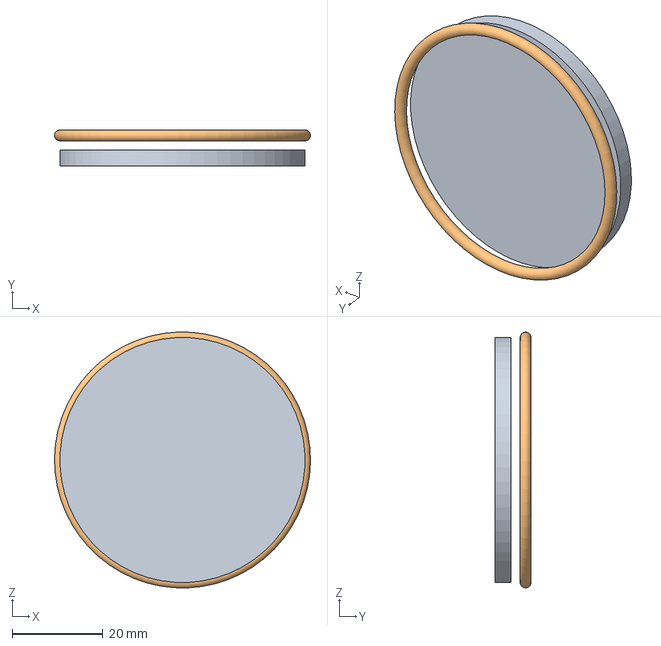
[picture p103: CAD file, 2026-10-15]
cad/parts/Clean_room/Infeed_turntable.step
56.4 x 7.95 x 56.4 mm
