Kariemm11/Cleanroom-Heat-Recovery-Air-Pump/cad/parts/Controls_and_HMI/MT-106_room_TplusRH_SHT31.step

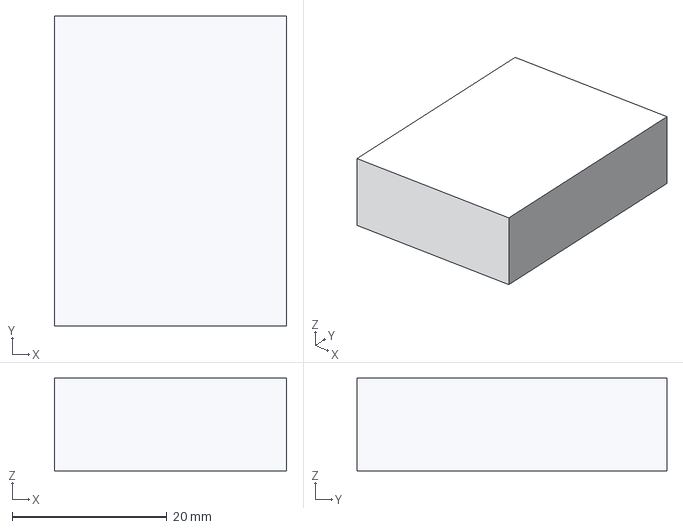
[picture p104: CAD file, 2026-10-15]
cad/parts/Controls_and_HMI/MT-106_room_TplusRH_SHT31.step
30.0 x 40.0 x 12.0 mm
