Kariemm11/Cleanroom-Heat-Recovery-Air-Pump/cad/parts/Ductwork/Terminal_drop_2_ceiling_above_the_operator.step

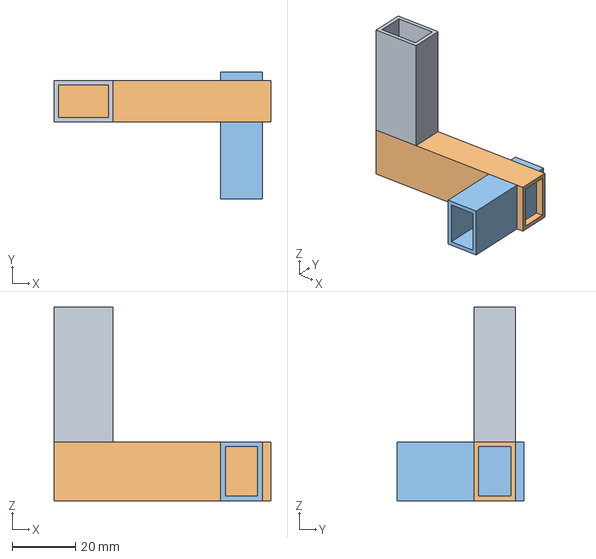
[picture p105: CAD file, 2026-10-15]
cad/parts/Ductwork/Terminal_drop_2_ceiling_above_the_operator.step
68.7 x 40.4 x 61.4 mm
