Kariemm11/Cleanroom-Heat-Recovery-Air-Pump/cad/parts/PCB_wiring_harness/PCB_strip_TT-106.step

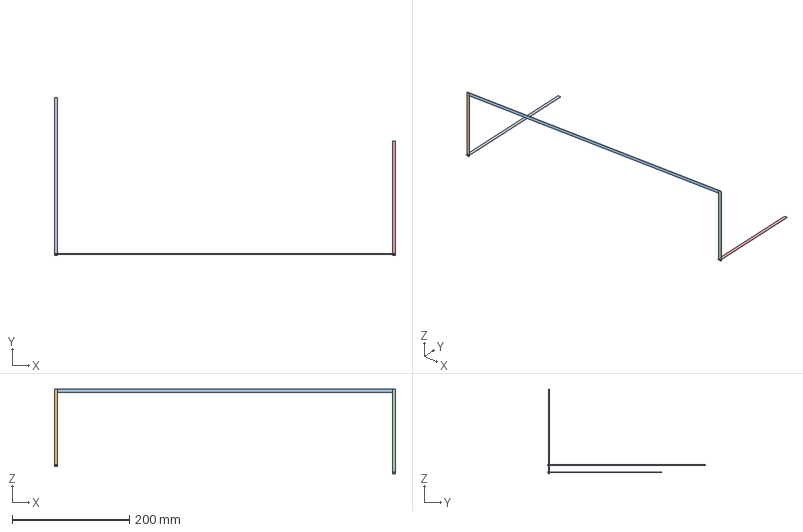
[picture p106: CAD file, 2026-10-15]
cad/parts/PCB_wiring_harness/PCB_strip_TT-106.step
580.5 x 269.4 x 144.5 mm
