Kariemm11/Cleanroom-Heat-Recovery-Air-Pump/cad/dxf/enclosure-panels/Clean-room_door.dxf

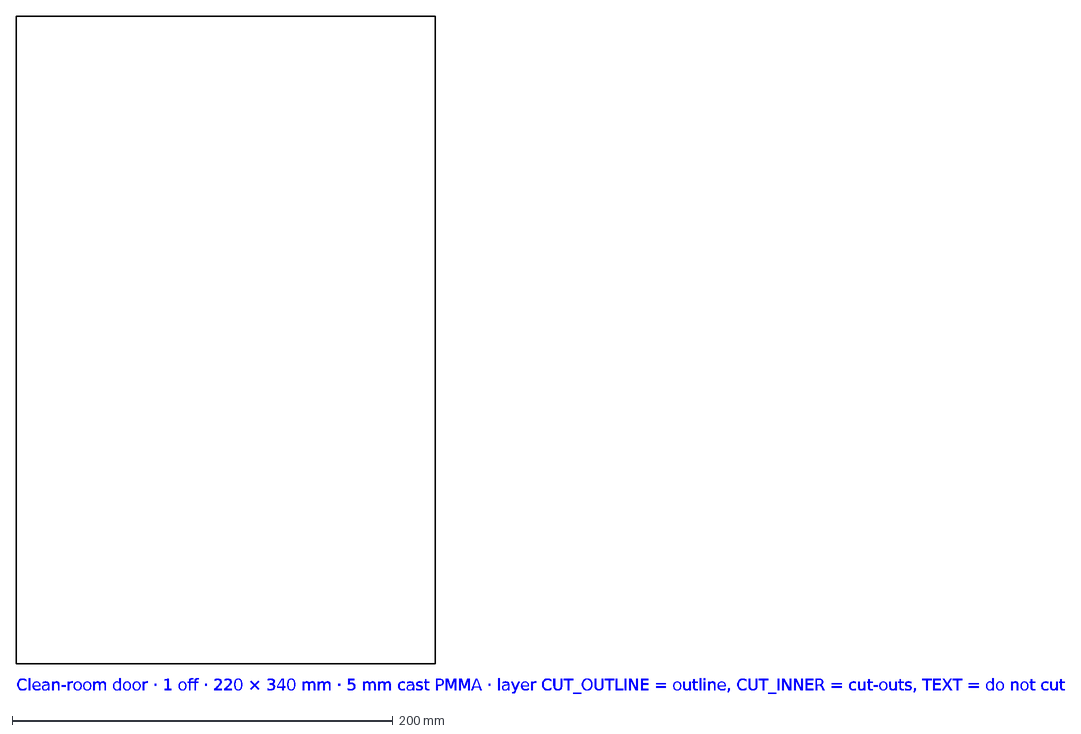
[picture p107: CAD file, 2026-10-15]
cad/dxf/enclosure-panels/Clean-room_door.dxf
Clean-room door · 1 off · 220 × 340 mm · 5 mm cast PMMA · layer CUT_OUTLINE = outline, CUT_INNER = cut-outs, TEXT = do not cut
