Kariemm11/Cleanroom-Heat-Recovery-Air-Pump/cad/dxf/sub-assemblies/Clean_room.dxf

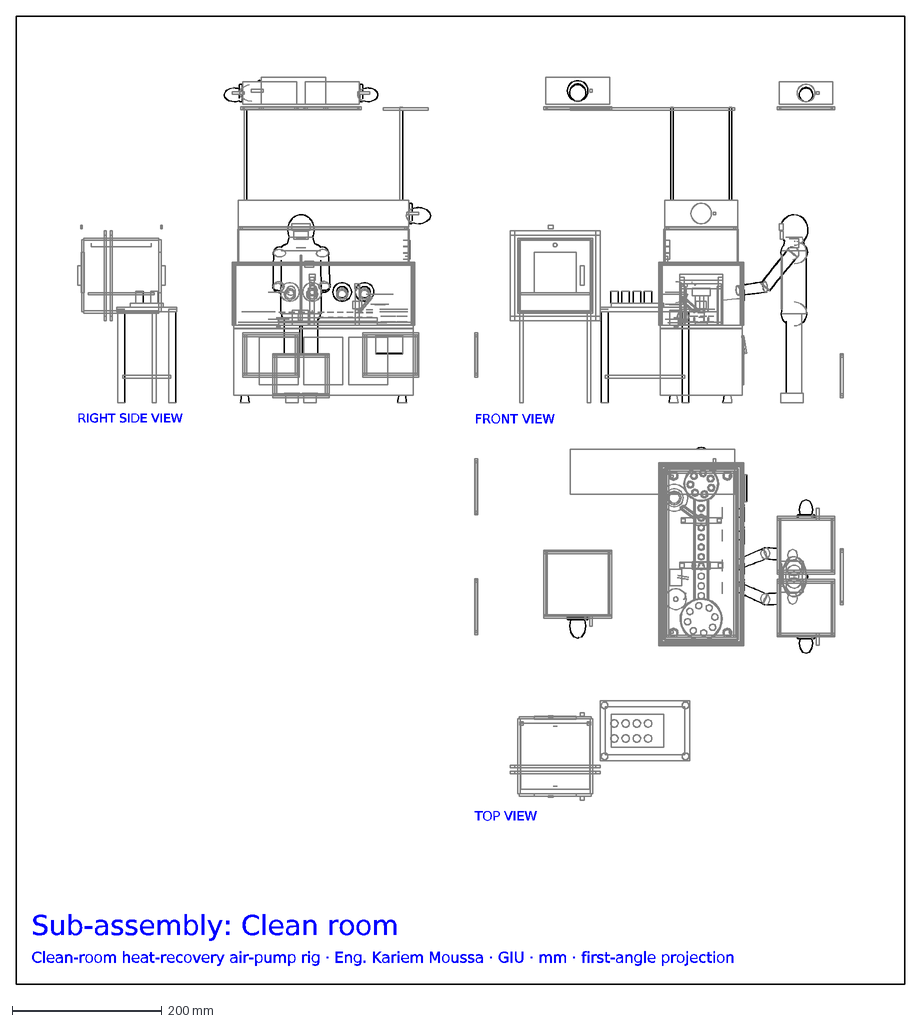
[picture p108: CAD file, 2026-10-15]
cad/dxf/sub-assemblies/Clean_room.dxf
FRONT VIEW
TOP VIEW
RIGHT SIDE VIEW
Sub-assembly: Clean room
Clean-room heat-recovery air-pump rig · Eng. Kariem Moussa · GIU · mm · first-angle projection
