Kariemm11/Cleanroom-Heat-Recovery-Air-Pump/cad/dxf3d/parts/Clean_room/Staging_bench_plus_vial_tray-3D.dxf

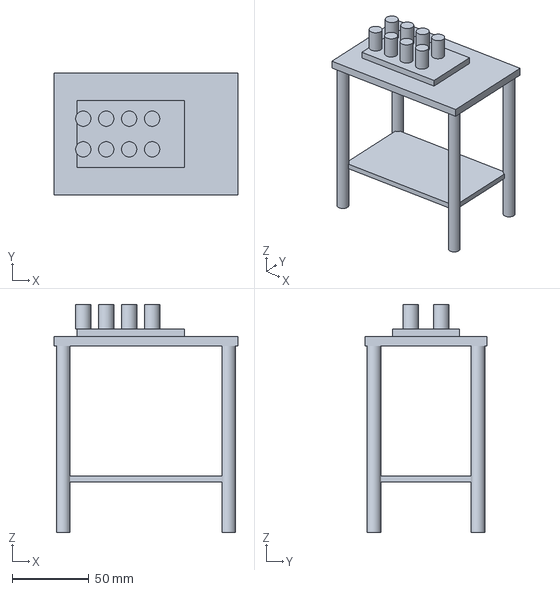
[picture p109: CAD file, 2026-10-15]
cad/dxf3d/parts/Clean_room/Staging_bench_plus_vial_tray-3D.dxf
120.0 x 80.0 x 149.0 mm
