Kariemm11/Cleanroom-Heat-Recovery-Air-Pump/cad/dxf3d/parts/Ductwork/Compressor_discharge-3D.dxf

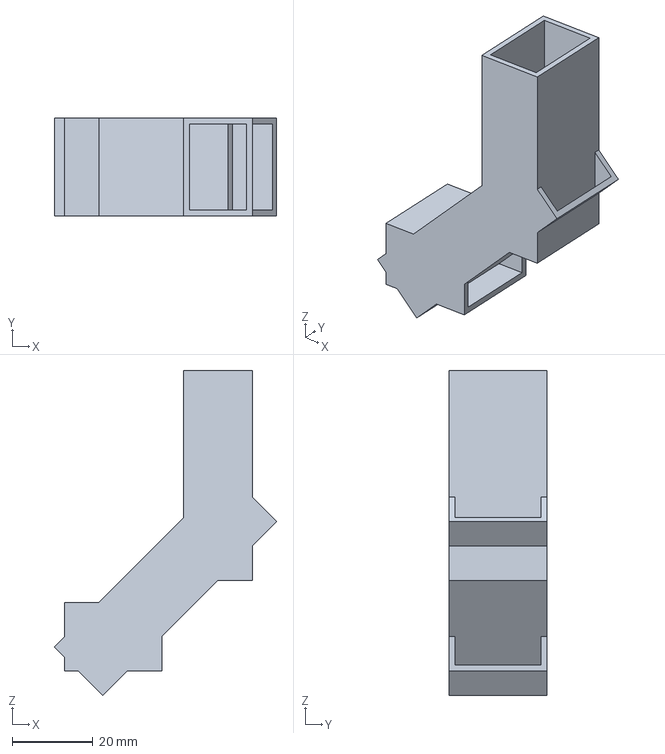
[picture p110: CAD file, 2026-10-15]
cad/dxf3d/parts/Ductwork/Compressor_discharge-3D.dxf
55.2 x 24.2 x 80.6 mm
