Kariemm11/Cleanroom-Heat-Recovery-Air-Pump/cad/dxf3d/sub-assemblies/Exhaust_safety_PT-102_plus_DV-101_plus_outer_HEPA-3D.dxf

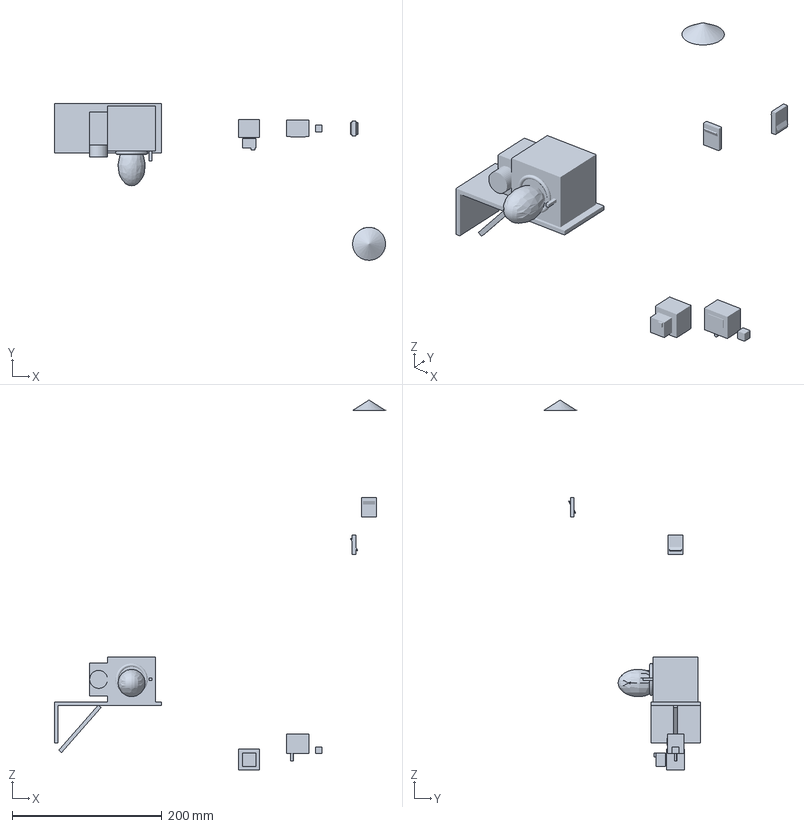
[picture p111: CAD file, 2026-10-15]
cad/dxf3d/sub-assemblies/Exhaust_safety_PT-102_plus_DV-101_plus_outer_HEPA-3D.dxf
442.0 x 209.1 x 494.0 mm
