Kariemm11/Cleanroom-Heat-Recovery-Air-Pump/cad/parts/AHU/Droplet_eliminator.step

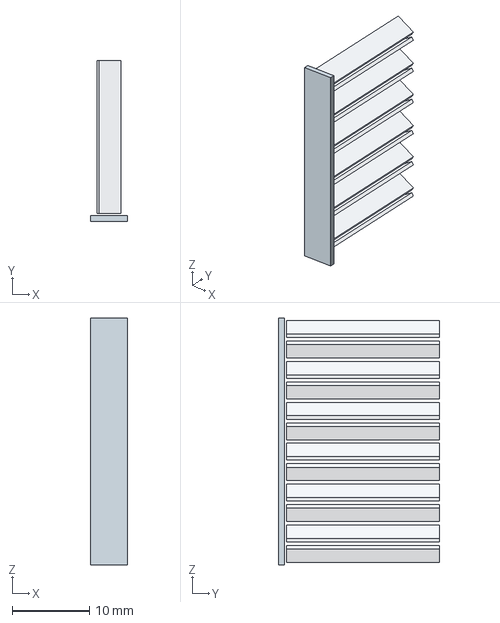
[picture p112: CAD file, 2026-10-15]
cad/parts/AHU/Droplet_eliminator.step
4.84 x 20.8 x 31.9 mm
