Kariemm11/Cleanroom-Heat-Recovery-Air-Pump/cad/parts/Controls_and_HMI/HMI-101_display.step

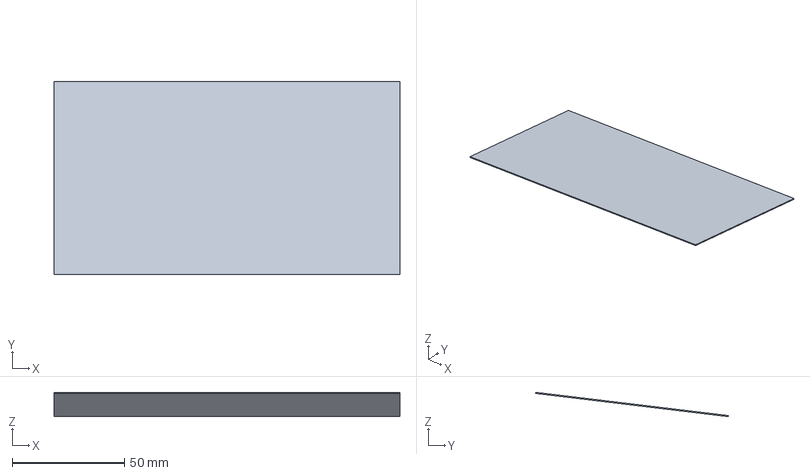
[picture p113: CAD file, 2026-10-15]
cad/parts/Controls_and_HMI/HMI-101_display.step
154.0 x 86.0 x 10.9 mm
