Kariemm11/Cleanroom-Heat-Recovery-Air-Pump/cad/parts/Ductwork/Exhaust_collector_A_behind_the_partition.step

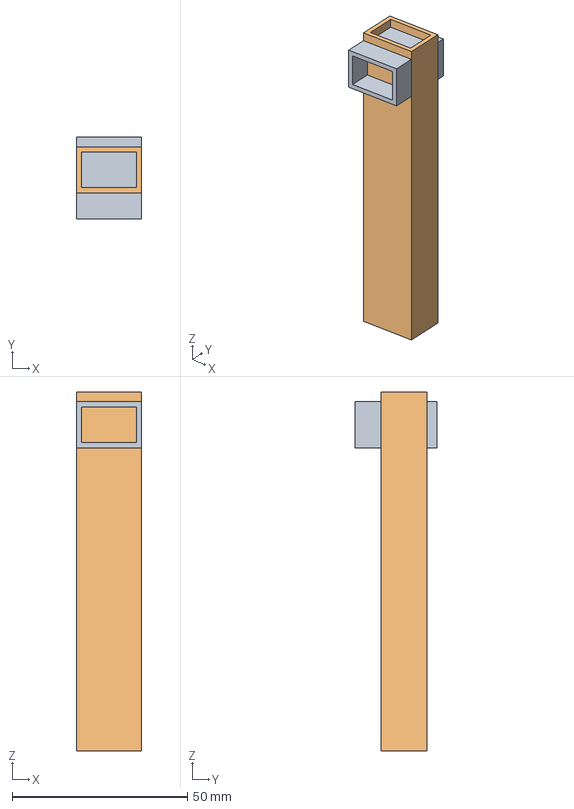
[picture p114: CAD file, 2026-10-15]
cad/parts/Ductwork/Exhaust_collector_A_behind_the_partition.step
18.7 x 23.3 x 102.5 mm
