Kariemm11/Cleanroom-Heat-Recovery-Air-Pump/cad/parts/PCB_wiring_harness/PCB_strip_HTR-101_copper.step

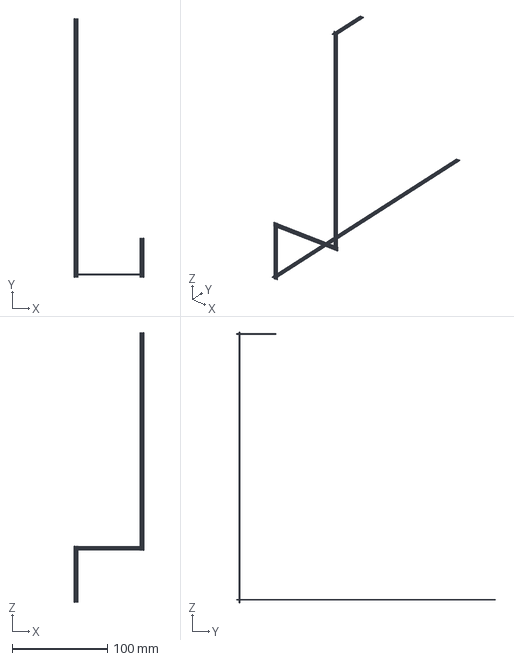
[picture p115: CAD file, 2026-10-15]
cad/parts/PCB_wiring_harness/PCB_strip_HTR-101_copper.step
73.5 x 271.0 x 283.0 mm
