Kariemm11/Cleanroom-Heat-Recovery-Air-Pump/cad/step/Controls_and_HMI.step

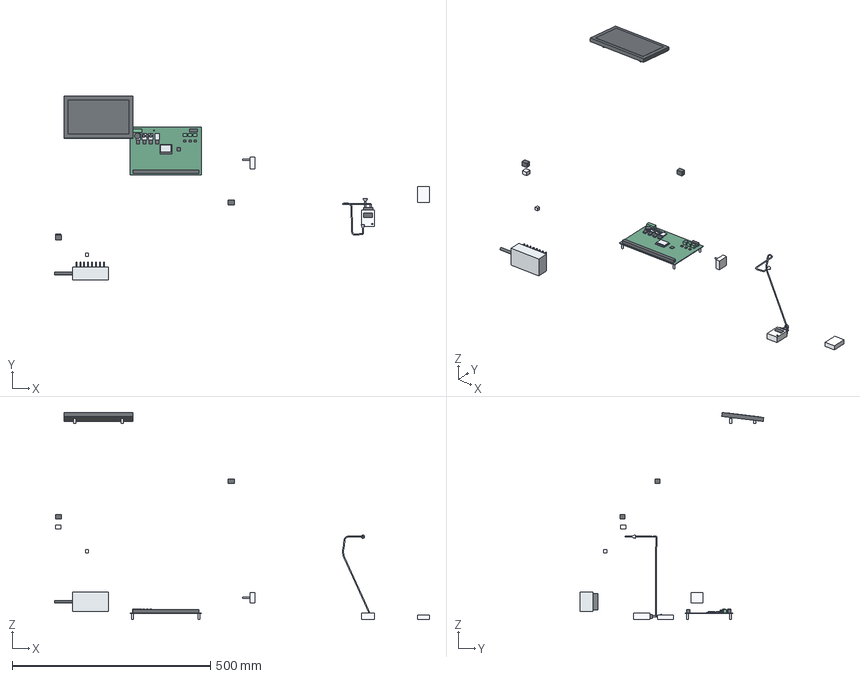
[picture p116: CAD file, 2026-10-15]
cad/step/Controls_and_HMI.step
946.0 x 463.2 x 522.3 mm
Main controller PCB
Main controller PCB -2
Main controller PCB -3
Main controller PCB -4
Main controller PCB -5
Main controller PCB -6
HMI-101 7-inch touch screen
HMI-101 7-inch touch screen -2
HMI-101 display
24 V DC power supply
24 V DC power supply -2
24 V DC power supply -3
TT-101-MT-101 fresh-air TplusRH (SHT31)
FT-101 fresh-air flow (D6F)
FT-102 supply airflow (D6F)
MT-106 room TplusRH (SHT31)
PDT-101 room dP (SDP810)
PDT-101 reference tube
TT-108 exhaust T (DS18B20)
PT-101 air particle sensor
PT-101 air particle sensor -2
PT-101 air particle sensor -3
PT-101 air particle sensor -4
PT-101 air particle sensor -5
PT-101 isokinetic probe
PT-101 sample tube
