Kariemm11/Cleanroom-Heat-Recovery-Air-Pump/(list of files, cad)

Other CAD files:
cad/dxf3d/cleanroom-rig-assembly-3D.dxf
cad/dxf3d/parts/Ductwork/Exhaust_main_clean_room_to_DV-101-3D.dxf
cad/dxf3d/parts/Controls_and_HMI/Main_controller_PCB-3D.dxf
cad/parts/Acrylic_enclosure/Acrylic_left_wall_outdoor_side.step
cad/parts/Fresh-air_compressor/FAN-101_fresh-air_compressor.step
cad/plant-system-AHU-and-air-pump-in-parallel.step
cad/step/Fresh-air_compressor.step
cad/dxf/enclosure-panels/Roof.dxf
cad/dxf3d/parts/Controls_and_HMI/FT-101_fresh-air_flow_D6F-3D.dxf
cad/dxf3d/parts/Ductwork/Header_to_recovery_unit_fresh_lane-3D.dxf
cad/dxf3d/parts/Heat-recovery_air-pump_unit/FAN-103_exhaust_fan-3D.dxf
cad/parts/Acrylic_enclosure/Acrylic_back_wall.step
cad/parts/Exhaust_safety_PT-102_plus_DV-101_plus_outer_HEPA/Backdraft_damper_normal_exhaust.step
cad/dxf3d/parts/Acrylic_enclosure/Acrylic_front_wall-3D.dxf
cad/dxf3d/parts/Controls_and_HMI/FT-102_supply_airflow_D6F-3D.dxf
cad/dxf3d/parts/Heat-recovery_air-pump_unit/Fresh-air_filter-3D.dxf
cad/dxf3d/sub-assemblies/Fresh-air_compressor-3D.dxf
cad/parts/Controls_and_HMI/TT-101-MT-101_fresh-air_TplusRH_SHT31.step
cad/parts/Exhaust_safety_PT-102_plus_DV-101_plus_outer_HEPA/PT-102_exhaust_particle_sensor.step
cad/step/Acrylic_enclosure.step
cad/dxf3d/parts/Acrylic_enclosure/Acrylic_left_wall_outdoor_side-3D.dxf
cad/dxf3d/parts/Exhaust_safety_PT-102_plus_DV-101_plus_outer_HEPA/Backdraft_damper_HEPA_bypass-3D.dxf
cad/dxf3d/parts/Heat-recovery_air-pump_unit/Exhaust_filter-3D.dxf
cad/parts/Acrylic_enclosure/Clean-room_false_ceiling.step
cad/parts/AHU/R32_liquid_receiver.step
cad/parts/Clean_room/Pass_box_inner_door.step
cad/parts/Controls_and_HMI/FT-101_fresh-air_flow_D6F.step
cad/parts/Heat-recovery_air-pump_unit/FAN-103_exhaust_fan.step
cad/parts/PCB_wiring_harness/PCB_strip_TT-107.step
cad/dxf3d/parts/Acrylic_enclosure/Acrylic_partition_wall-3D.dxf
cad/dxf3d/parts/Clean_room/LAF_hood_PVC_skirts_plus_hangers-3D.dxf
cad/dxf3d/parts/Ductwork/Exhaust_DV-101_to_air-pump_unit_Cu_core-3D.dxf
cad/dxf3d/parts/Heat-recovery_air-pump_unit/Cu_plate_core_Ra_0.8_m-3D.dxf
cad/dxf3d/sub-assemblies/Heat-recovery_air-pump_unit-3D.dxf
cad/parts/Acrylic_enclosure/Acrylic_base_plate.step
cad/parts/AHU/Base_machine_compartment_and_R32_compressor.step
cad/parts/Exhaust_safety_PT-102_plus_DV-101_plus_outer_HEPA/Outer_BIBO_HEPA_housing_H14_police_filter.step
cad/parts/Heat-recovery_air-pump_unit/Tempered-air_fan.step
cad/step/PCB_wiring_harness.step
cad/dxf3d/parts/Acrylic_enclosure/Acrylic_right_wall-3D.dxf
cad/dxf3d/parts/AHU/R32_charging_port_liquid_side-3D.dxf
cad/dxf3d/parts/Controls_and_HMI/24_V_DC_power_supply-3D.dxf
cad/dxf3d/parts/Exhaust_safety_PT-102_plus_DV-101_plus_outer_HEPA/FAN-103B_HEPA-bypass_exhaust_fan-3D.dxf
cad/dxf3d/parts/Heat-recovery_air-pump_unit/Coil_extract-3D.dxf
cad/dxf3d/parts/PCB_wiring_harness/PCB_strip_PDT-102_copper-3D.dxf
cad/parts/Acrylic_enclosure/Acrylic_partition_wall.step
cad/parts/Clean_room/Low-level_exhaust_terminal_3_face_screen.step
cad/parts/Exhaust_safety_PT-102_plus_DV-101_plus_outer_HEPA/Exhaust_stack_rain_cap.step
cad/parts/Heat-recovery_air-pump_unit/Recovery_unit_support_posts.step
cad/dxf/enclosure-panels/Front_wall.dxf
cad/dwg/cleanroom-rig-assembly.dwg
cad/dwg/parts/AHU/AHU_casing_panel.dwg
cad/dwg/parts/AHU/AHU_control_panel.dwg
cad/dwg/parts/AHU/AHU_duct_connections.dwg
cad/dwg/parts/AHU/AHU_frame.dwg
cad/dwg/parts/AHU/Bag_filter.dwg
cad/dwg/parts/AHU/Base_machine_compartment_and_R32_compressor.dwg
cad/dwg/parts/AHU/Coil_cooling.dwg
cad/dwg/parts/AHU/Coil_preheat.dwg
cad/dwg/parts/AHU/Coil_reheat.dwg
cad/dwg/parts/AHU/Droplet_eliminator.dwg
cad/dwg/parts/AHU/Filter_dP_gauge.dwg
cad/dwg/parts/AHU/Fresh-air_inlet.dwg
cad/dwg/parts/AHU/Fresh-air_louvre_plus_bird_mesh.dwg
cad/dwg/parts/AHU/Fresh-air_plenum_plus_turning_vanes.dwg
cad/dwg/parts/AHU/HEPA_final_filter.dwg
cad/dwg/parts/AHU/Misc.dwg
cad/dwg/parts/AHU/Outdoor-air_pre-filter.dwg
cad/dwg/parts/AHU/Panel_filter.dwg
cad/dwg/parts/AHU/R32_charging_port_liquid_side.dwg
cad/dwg/parts/AHU/R32_charging_port_suction_side.dwg
cad/dwg/parts/AHU/R32_filter-drier_bi-flow.dwg
cad/dwg/parts/AHU/R32_liquid_receiver.dwg
cad/dwg/parts/AHU/R32_refrigerant_pipework.dwg
cad/dwg/parts/AHU/R32_sight_glass_plus_moisture_indicator.dwg
cad/dwg/parts/AHU/R32_suction_accumulator.dwg
cad/dwg/parts/AHU/Sensor_Supply_T_plus_RH.dwg
cad/dwg/parts/AHU/Sensor_TT-103_after_pre-heat.dwg
cad/dwg/parts/AHU/Sensor_TT-104_off_cooling_coil.dwg
cad/dwg/parts/AHU/Sensor_TT-109_off_the_Cu_core.dwg
cad/dwg/parts/AHU/Steam_humidifier.dwg
cad/dwg/parts/AHU/Supply_air_to_the_clean_room.dwg
cad/dwg/parts/AHU/Supply_attenuator.dwg
cad/dwg/parts/AHU/Supply_fan.dwg
cad/dwg/parts/Acrylic_enclosure/Acrylic_back_wall.dwg
cad/dwg/parts/Acrylic_enclosure/Acrylic_base_plate.dwg
cad/dwg/parts/Acrylic_enclosure/Acrylic_front_wall.dwg
cad/dwg/parts/Acrylic_enclosure/Acrylic_left_wall_outdoor_side.dwg
cad/dwg/parts/Acrylic_enclosure/Acrylic_partition_wall.dwg
cad/dwg/parts/Acrylic_enclosure/Acrylic_right_wall.dwg
cad/dwg/parts/Acrylic_enclosure/Acrylic_roof.dwg
cad/dwg/parts/Acrylic_enclosure/Aluminium_base_frame.dwg
cad/dwg/parts/Acrylic_enclosure/Clean-room_access_door.dwg
cad/dwg/parts/Acrylic_enclosure/Clean-room_false_ceiling.dwg
cad/dwg/parts/Clean_room/Ceiling_BIBO_HEPA_terminal_1_H14.dwg
cad/dwg/parts/Clean_room/Ceiling_BIBO_HEPA_terminal_2_H14.dwg
cad/dwg/parts/Clean_room/Ceiling_BIBO_HEPA_terminal_3_H14.dwg
cad/dwg/parts/Clean_room/Ceiling_terminal_1_face_screen.dwg
cad/dwg/parts/Clean_room/Ceiling_terminal_2_face_screen.dwg
cad/dwg/parts/Clean_room/Ceiling_terminal_3_face_screen.dwg
cad/dwg/parts/Clean_room/Filler_operator_panel.dwg
cad/dwg/parts/Clean_room/Filling_needle_carriage.dwg
cad/dwg/parts/Clean_room/Infeed_turntable.dwg
cad/dwg/parts/Clean_room/LAF_hood_H14_BIBO_filter_housing.dwg
cad/dwg/parts/Clean_room/LAF_hood_PVC_skirts_plus_hangers.dwg
cad/dwg/parts/Clean_room/LAF_hood_perforated_outlet_screen.dwg
cad/dwg/parts/Clean_room/LED_clean-room_luminaire.dwg
cad/dwg/parts/Clean_room/Low-level_exhaust_terminal_1_face_screen.dwg
cad/dwg/parts/Clean_room/Low-level_exhaust_terminal_2_face_screen.dwg
cad/dwg/parts/Clean_room/Low-level_exhaust_terminal_3_face_screen.dwg
cad/dwg/parts/Clean_room/Operator_Grade_B_gown.dwg
cad/dwg/parts/Clean_room/Outfeed_accumulation_table.dwg
cad/dwg/parts/Clean_room/Pass_box.dwg
cad/dwg/parts/Clean_room/Pass_box_inner_door.dwg
cad/dwg/parts/Clean_room/Pass_box_outer_door.dwg
cad/dwg/parts/Clean_room/Peristaltic_dosing_pump.dwg
cad/dwg/parts/Clean_room/Product_holding_tank.dwg
cad/dwg/parts/Clean_room/Product_hose.dwg
cad/dwg/parts/Clean_room/Staging_bench_plus_vial_tray.dwg
cad/dwg/parts/Clean_room/Stopper_chute.dwg
cad/dwg/parts/Clean_room/Stopper_press_head.dwg
cad/dwg/parts/Clean_room/Stopper_vibratory_bowl.dwg
cad/dwg/parts/Clean_room/Vial.dwg
cad/dwg/parts/Clean_room/Vial_filling_machine.dwg
cad/dwg/parts/Controls_and_HMI/24_V_DC_power_supply.dwg
cad/dwg/parts/Controls_and_HMI/FT-101_fresh-air_flow_D6F.dwg
cad/dwg/parts/Controls_and_HMI/FT-102_supply_airflow_D6F.dwg
cad/dwg/parts/Controls_and_HMI/HMI-101_7-inch_touch_screen.dwg
cad/dwg/parts/Controls_and_HMI/HMI-101_display.dwg
cad/dwg/parts/Controls_and_HMI/MT-106_room_TplusRH_SHT31.dwg
cad/dwg/parts/Controls_and_HMI/Main_controller_PCB.dwg
cad/dwg/parts/Controls_and_HMI/PDT-101_reference_tube.dwg
cad/dwg/parts/Controls_and_HMI/PDT-101_room_dP_SDP810.dwg
cad/dwg/parts/Controls_and_HMI/PT-101_air_particle_sensor.dwg
cad/dwg/parts/Controls_and_HMI/PT-101_isokinetic_probe.dwg
cad/dwg/parts/Controls_and_HMI/PT-101_sample_tube.dwg
cad/dwg/parts/Controls_and_HMI/TT-101-MT-101_fresh-air_TplusRH_SHT31.dwg
cad/dwg/parts/Controls_and_HMI/TT-108_exhaust_T_DS18B20.dwg
cad/dwg/parts/Ductwork/Bypass_discharge_FAN-103B_to_roof_stack.dwg
cad/dwg/parts/Ductwork/Compressor_discharge.dwg
cad/dwg/parts/Ductwork/Core_bypass_header_to_AHU_baseline_test.dwg
cad/dwg/parts/Ductwork/Exhaust_BIBO_HEPA_terminal_1_H14.dwg
cad/dwg/parts/Ductwork/Exhaust_BIBO_HEPA_terminal_2_H14.dwg
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
