Kariemm11/Cleanroom-Heat-Recovery-Air-Pump/build-pack/10-simulator-standalone.html

Hide

# Clean-room test rig

Acrylic box 1.0 × 0.5 × 0.5 m · 100 % fresh air, once through · plant room: AHU + heat-recovery air pump (Cu plate core, the only exhaust path) · clean room: BIBO HEPA terminals, LAF over the filler, low-level exhausts

Outdoor / fresh air

Exhaust air

Supply air (100 % fresh)

Refrigerant

PCB: sensor signal

PCB: drive signal

Contamination: operator / pass box / dirty exhaust

Air temperature

−5 °C21 °C45 °C

Controls Hide controls

Operating mode

Winter heating Summer cooling

Heat recovery

Recovery on Baseline test

Air colour

By stream By temperature

Exhaust (PT-102 → DV-101)

Clean → Cu core Contaminated → HEPA

Hazard tests

Powder release at the filler Exhaust HEPA leak

PT-102 clean · exhaust → Cu core

AHU casing

Solid Ghost Off

Acrylic box

Clear Frosted Hidden

Labels

Rig + Plant All None

Exploded view0 %

Air velocity (visual)1.0×

Simulation speed10×

Design values

Air & clean room

Supply airflow m³/h

Cu plate core effectiveness %

PT-102 trip ≥0.5 µm /m³

PT-102 reset /m³

Room RH set point %

Room pressure Pa

Room heat gain W

Particles shed ≥0.5 µm /min

This season

Outdoor °C

Outdoor RH %

After pre-heat set point °C

Final supply set point °C

Box & energy

Lab around box °C

Envelope UA W/K

DC bus V

Grid kg CO₂/kWh

Baseline chiller COP

Operating h/year

Reset to design values

Show

Coloured air particles Air flow in ducts Coloured air columns Contamination particles Containment zones Flow arrows Live sensor tags PCB wiring PCB signal pulses Parallel recovery unit Auxiliaries & instruments Access doors Refrigerant circuit Ductwork Fans turning

View

Iso Front Top

Plant room Clean room HMI

Pause

Readings

Hide Show Large

R Zones

Off On

Z Duct air

Off On

D

Hide HMI-101

Drag to orbit · scroll to zoom · shift-drag to pan · click the 3D screen for the HMI

## HMI-101 · Rig controller

RUN WINTER · RECOVERY ON t = 00:00:00 Stop system Collapse

Overview Sensors Control loops Energy & CO₂ Containment Trends Alarms
