Kariemm11/Cleanroom-Heat-Recovery-Air-Pump/build-pack/03-wiring-diagrams.pdf

## Clean-room heat-recovery air-pump rig

## Sheet 1 · Power distribution, fusing and current sensing

ESP32-S3 controller · 24 V DC · pin map = firmware/include/config.h

Sheet 1 of 2 · A3 · Eng. Kariem Moussa · GIU

# POWER DISTRIBUTION

All loads run from one 24 V DC supply. Each branch has its own fuse; the three ACS712 current sensors measure the compressor, fan and heater branches (CT-101 … 103). The controls branch is not on a CT (≈3.5 W, added in firmware).

### Mains 230 V AC

L, N, PE
IEC inlet + switch
fuse 2 A T

### PSU 24 V DC, 150 W

6.25 A, enclosed
e.g. 150 W DIN/chassis
PE to the rig frame

### Input protection

TVS SMBJ28A
470 µF 35 V bulk

F1 8 A
main fuse

### +24 V BUS

0 V star point (PSU −): one return wire per branch

F2 3 A T | CT-101 ACS712-05B · GPIO4 Hall sensor in series
J6 CMP-101 compressor driver
24 V, 0 V, SPEED 0–5 V (from LM358) ≈35 W; driver limits the start current

F3 3.15 A

CT-103
ACS712-05B · GPIO6
Hall sensor in series

J9 HTR-101 PTC 30 W
24 V → thermal fuse 130 °C → PTC → MOSFET (GPIO47)

J10 HUM-101 steam humidifier 34 W
24 V → heater → MOSFET (GPIO48)

F4 2 A

CT-102
ACS712-05B · GPIO5
Hall sensor in series

J2 FAN-101 · J3 FAN-102 · J4 FAN-103/103B
J4 24 V via DV-101 end switch (NO FAN-103, NC FAN-103B) J5 DV-101 actuator 24 V (MOSFET GPIO21 + SS34)
F5 2 A | controls branch (not on a CT) | Buck 24 → 5 V, 3 A 5 V: ESP32-S3 5V pin, J21 HMI 7", ACS712 ×3, J20 SPS30 ×2, J24 SPS30 (PT-102)

### 24 V small loads

J11/J12 D6F flow ×2 · J8 DRV8825 VMOT (EEV)
J7 RV-101 4-way valve coil (MOSFET GPIO42 + SS34)

### 3.3 V from the ESP32-S3 regulator

TCA9548A, SHT31 ×3, SDP810 ×2, DS18B20 ×5, pull-ups (≈ 60 mA)

## Notes

- Wire: PSU → board 1.0 mm²; compressor, PTC, humidifier 0.5 mm²; fans and sensors 0.14–0.25 mm² or the FR4 strips.
- PCB tracks (IPC-2221, 1 oz, 10 °C rise): 24 V bus ≥ 2.5 mm; compressor/PTC ≥ 1.0 mm; fans 0.4 mm; signals 0.25 mm.
- Inductive loads (RV coil) need a flyback diode; the PTC and the humidifier heater are resistive.
- MOSFET low-side switches: logic-level N-MOSFETs (AOD4184 / IRLZ44N), 100 Ω gate resistor, 100 k gate pull-down.
- No PCB connection to the receiver, accumulator, filter-drier, sight glass or charging ports (mechanical refrigerant parts).

### Legend

24 V / 5 V supply
0 V
sensor signal (to ESP32)
drive signal (from ESP32)
I²C / 1-Wire / UART bus

# CONTROLLER I/O

## ESP32-S3-DevKitC-1

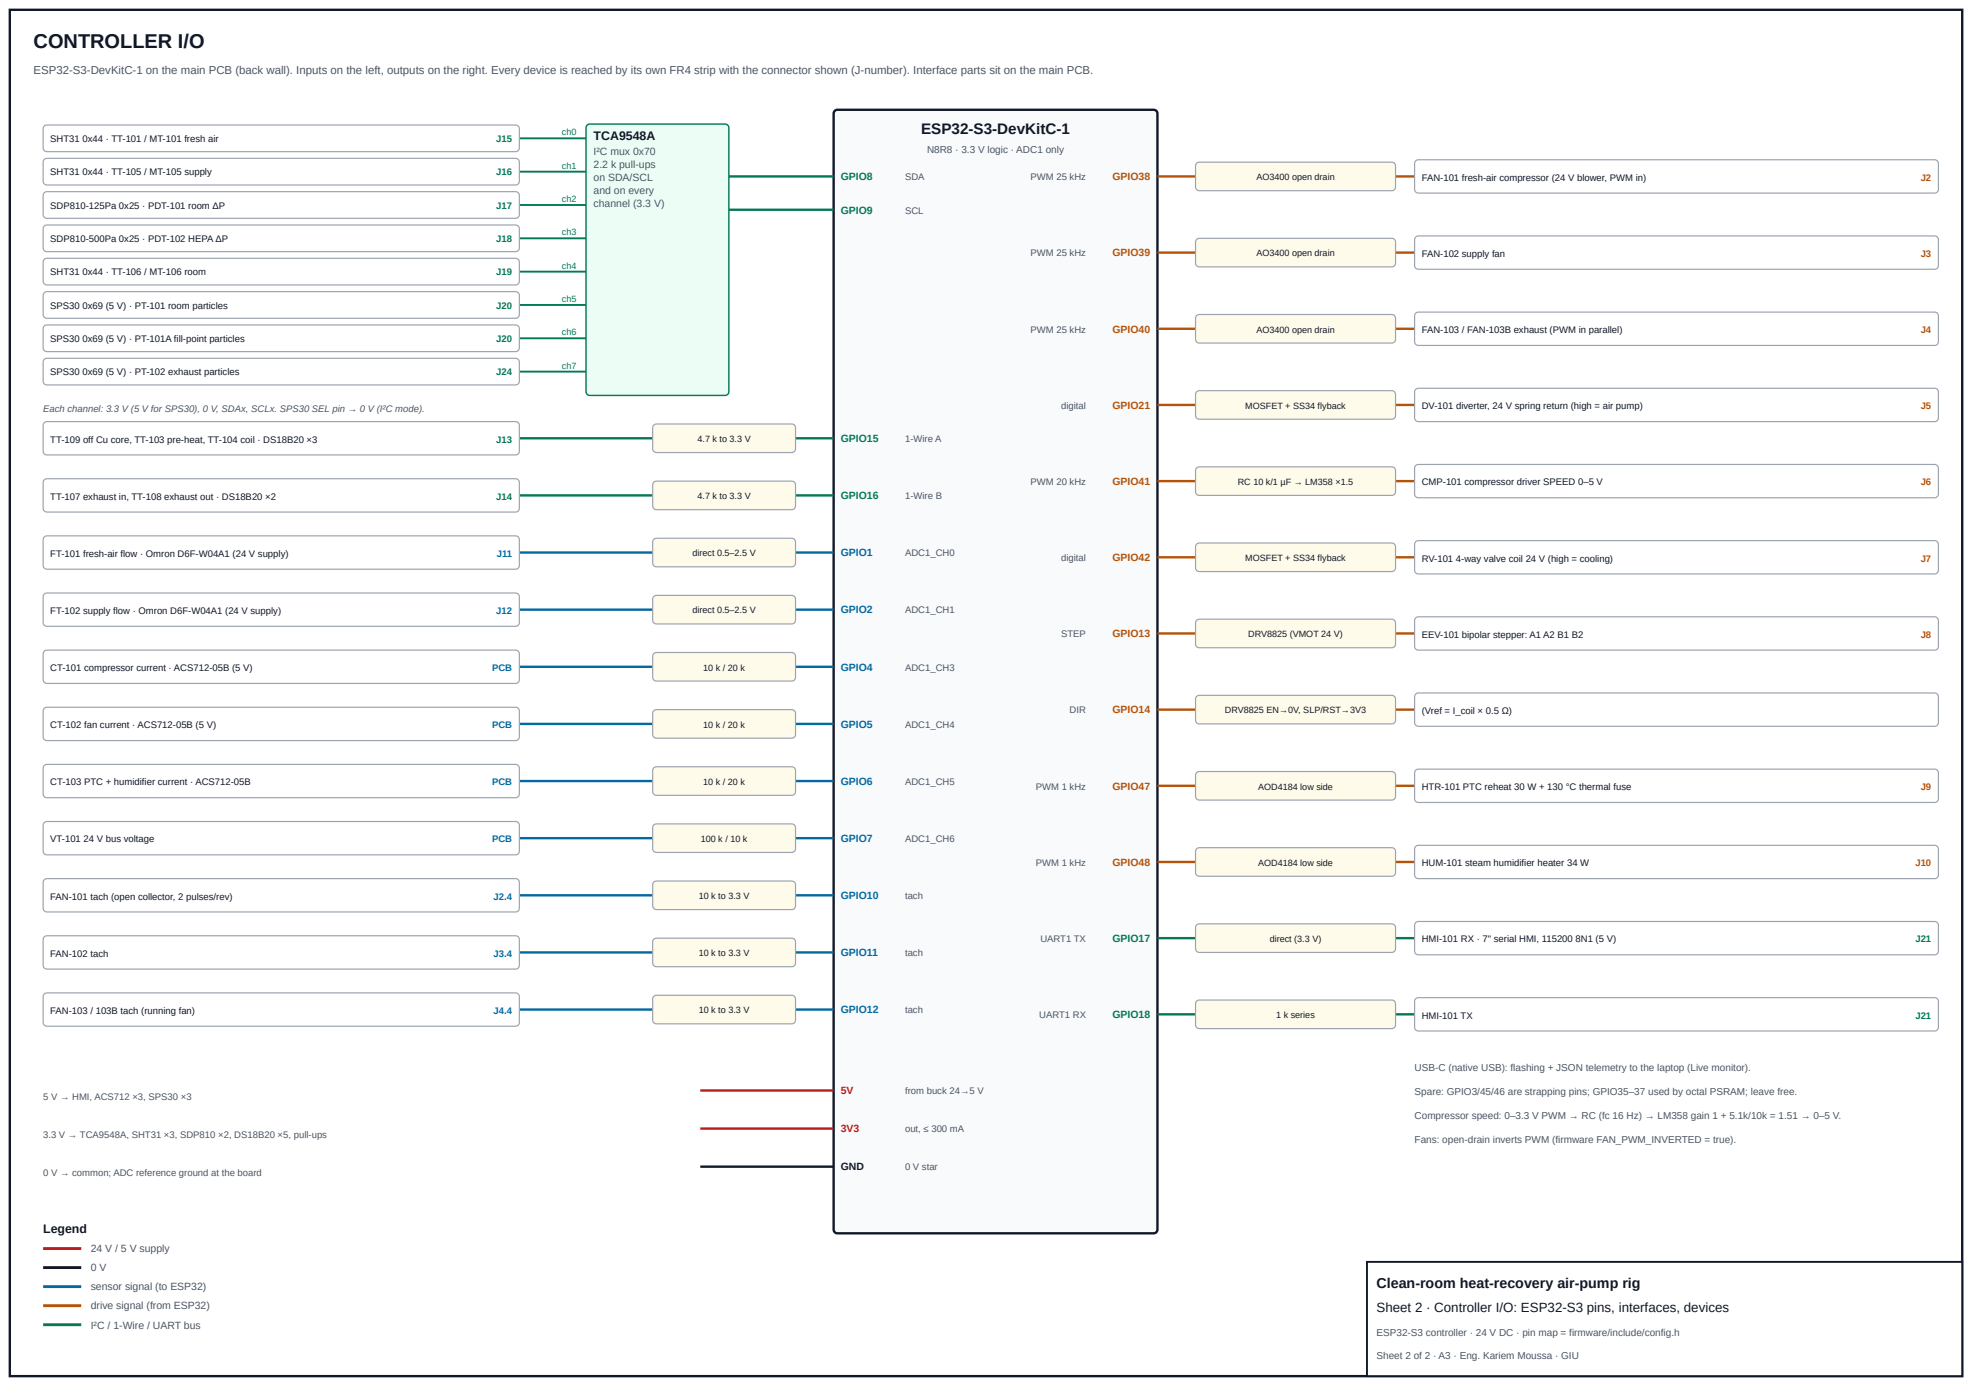
[picture p117: page 2]

ESP32-S3-DevKitC-1 on the main PCB (back wall). Inputs on the left, outputs on the right. Every device is reached by its own FR4 strip with the connector shown (J-number). Interface parts sit on the main PCB.

Each channel: 3.3 V (5 V for SPS30), 0 V, SDAx, SCLx. SPS30 SEL pin → 0 V (I²C mode).

USB-C (native USB): flashing + JSON telemetry to the laptop (Live monitor).

Spare: GPIO3/45/46 are strapping pins; GPIO35–37 used by octal PSRAM; leave free.

Compressor speed: 0–3.3 V PWM → RC (fc 16 Hz) → LM358 gain 1 + 5.1k/10k = 1.51 → 0–5 V.

Fans: open-drain inverts PWM (firmware FAN_PWM_INVERTED = true).

0 V → common; ADC reference ground at the board

24 V / 5 V supply
sensor signal (to ESP32)
drive signal (from ESP32)
I²C / 1-Wire / UART bus

Clean-room heat-recovery air-pump rig
Sheet 2 · Controller I/O: ESP32-S3 pins, interfaces, devices

ESP32-S3 controller · 24 V DC · pin map = firmware/include/config.h

Sheet 2 of 2 · A3 · Eng. Kariem Moussa · GIU
