Kariemm11/Cleanroom-Heat-Recovery-Air-Pump/build-pack/02-io-list.csv

Tag | Description | Type | Device | Signal / interface | ESP32-S3 pin / channel | PCB connector (pins) | Range | Design value | Scaling / conversion | Used by | Alarm
TT-101 | Fresh-air temperature | AI (I2C) | Sensirion SHT31 on the fresh-air header | I2C 0x44 via TCA9548A ch0 | GPIO8 SDA / GPIO9 SCL | J15 (3V3 GND SDA0 SCL0) | -40…125 °C | -2 °C (winter) | T = -45 + 175·raw/65535 | baseline twin (T_mb = TT-101, 100 % fresh air)
MT-101 | Fresh-air humidity | AI (I2C) | SHT31 (same as TT-101) | I2C 0x44 ch0 | GPIO8/9 | J15 | 0…100 %RH | 80 % | RH = 100·raw/65535 | baseline twin (summer latent)
FT-101 | Fresh-air flow | AI | Omron D6F-W04A1 in the Ø23 mm header | 0.5–2.5 V analogue (24 V supply) | GPIO1 ADC1_CH0 | J11 (24V GND Vout) | 0…4 m/s | 2.7 m/s = 6.0 m³/h | v = table(V); Q = kp·v·A·3600 | L2 header balance (FT-101 follows FT-102)
TT-109 | Fresh air off the Cu plate core (non-contact pre-cooling / pre-heating) | AI (1-Wire) | DS18B20 probe at the AHU inlet | 1-Wire bus A | GPIO15 (4.7 k pull-up) | J13 (3V3 GND DQ) | -55…125 °C | 12 °C winter / 28 °C summer | T = raw/16 | core effectiveness check; display
TT-103 | Air after pre-heat coil | AI (1-Wire) | DS18B20 probe | 1-Wire bus A | GPIO15 | J13 | -55…125 °C | 21 °C (winter) | T = raw/16 | L4 compressor (winter); baseline twin | A13 if missing (winter)
TT-104 | Air off the cooling coil | AI (1-Wire) | DS18B20 probe | 1-Wire bus A | GPIO15 | J13 | -55…125 °C | 12 °C (summer) | T = raw/16 | L4 compressor (summer); baseline twin | A13 if missing (summer)
TT-105 | Final supply-air temperature | AI (I2C) | SHT31 after the HEPA | I2C 0x44 via TCA9548A ch1 | GPIO8/9 | J16 (3V3 GND SDA1 SCL1) | -40…125 °C | 22 / 16 °C | as TT-101 | L5 reheat (PTC) | A07 |TT105 - SP| > 2 K for 90 s; A13
MT-105 | Final supply-air humidity | AI (I2C) | SHT31 (same as TT-105) | I2C ch1 | GPIO8/9 | J16 | 0…100 %RH |  | as MT-101 | humidifier high limit 85 %
FT-102 | Final supply airflow | AI | Omron D6F-W04A1 in the Ø28 mm riser | 0.5–2.5 V analogue | GPIO2 ADC1_CH1 | J12 (24V GND Vout) | 0…4 m/s | 2.7 m/s = 6.0 m³/h | as FT-101 | L1 supply fan; ACH = FT102/0.0953; airflow proving | A01 < 0.8·SP for 20 s; A08 ACH < 20
PDT-101 | Clean-room pressure (room vs. lab) | AI (I2C) | Sensirion SDP810-125Pa | I2C 0x25 via TCA9548A ch2 | GPIO8/9 | J17 (3V3 GND SDA2 SCL2) | ±125 Pa | +15 Pa | ΔP = raw/scale (scale read from sensor) | L7 exhaust fans | A02 < 5 Pa for 25 s; A03 > 40 Pa for 15 s
PDT-102 | HEPA filter ΔP | AI (I2C) | Sensirion SDP810-500Pa | I2C 0x25 via TCA9548A ch3 | GPIO8/9 | J18 (3V3 GND SDA3 SCL3) | ±500 Pa | 145 Pa clean | ΔP = raw/scale | filter monitoring | A09 > 450 Pa for 10 s
TT-106 | Clean-room temperature | AI (I2C) | SHT31 in the clean room | I2C 0x44 via TCA9548A ch4 | GPIO8/9 | J19 (3V3 GND SDA4 SCL4) | -40…125 °C | 22–24 °C | as TT-101 | baseline twin; display
MT-106 | Clean-room humidity | AI (I2C) | SHT31 (same as TT-106) | I2C ch4 | GPIO8/9 | J19 | 0…100 %RH | 45 % | as MT-101 | L6 humidifier / dehumidification | A04 |MT106 - SP| > 10 % for 120 s
TT-107 | Exhaust air to the air pump | AI (1-Wire) | DS18B20 probe on the exhaust main (before DV-101) | 1-Wire bus B | GPIO16 (4.7 k pull-up) | J14 (3V3 GND DQ) | -55…125 °C | 22–24 °C | T = raw/16 | display; core check
TT-108 | Exhaust after the air-pump coil | AI (1-Wire) | DS18B20 probe | 1-Wire bus B | GPIO16 | J14 | -55…125 °C | ~1 °C (winter) | T = raw/16 | frost protection (< -3 °C) | A05 frost limit 30 s
CT-101 | Current: air-pump compressor | AI | ACS712-05B on the PCB (in the F2 branch) | 0.5–4.5 V → 10 k/20 k divider | GPIO4 ADC1_CH3 | on PCB | ±5 A | 0.05–1.0 A | I = (V/0.667 - Vzero)/0.185 | energy
CT-102 | Current: fans + DV-101 | AI | ACS712-05B (F4 branch) | as CT-101 | GPIO5 ADC1_CH4 | on PCB | ±5 A | 0.1–1.3 A | as CT-101 | energy; baseline twin
CT-103 | Current: PTC reheat + humidifier | AI | ACS712-05B (F3 branch) | as CT-101 | GPIO6 ADC1_CH5 | on PCB | ±5 A | 0–2.2 A | as CT-101 | energy
VT-101 | DC bus voltage | AI | 100 k / 10 k divider | 0–2.7 V | GPIO7 ADC1_CH6 | on PCB | 0…30 V | 24 V | V = 11·Vadc | power = V·I
PT-101 | Airborne particles ≥0.5 / ≥5 µm: room | AI (I2C) | Sensirion SPS30 (5 V) on the back-wall manifold | I2C 0x69 via TCA9548A ch5 | GPIO8/9 | J20 (5V GND SDA5 SCL5 SEL) | 0…3000 /cm³ | ~122 000 /m³ (Grade B) | N≥0.5 = (NC10 - NC0.5)·1e6; N≥5 ≈ 0.57·(NC10 - NC4.0)·1e6 | containment screen; grade | A10 > 70 % of 352 000; A11 > 352 000
PT-101A | Airborne particles ≥0.5 / ≥5 µm: fill point | AI (I2C) | SPS30 on the fill-point probe tube | I2C 0x69 via TCA9548A ch6 | GPIO8/9 | J20 (… SDA6 SCL6) | 0…3000 /cm³ | ~1 600 /m³ (Grade A) | as PT-101 | containment screen; grade | A12 > 3 520 /m³ for 30 s
PT-102 | Exhaust particles ≥0.5 µm before DV-101 | AI (I2C) | Sensirion SPS30 (5 V) on the exhaust main | I2C 0x69 via TCA9548A ch7 | GPIO8/9 | J24 (5V GND SDA7 SCL7 SEL) | 0…3000 /cm³ | ~6 /m³ (after the H14 exhaust terminals) | as PT-101 | L3 exhaust diverter (trip 1 000 /m³ for 5 s; reset < 300 /m³ for 60 s) | A06 > trip for 5 s; missing = diverted
RPM-101 | FAN-101 tach | DI (pulse) | fan tach (open collector) | 2 pulses/rev | GPIO10 (10 k pull-up) | J2 pin 4 | 0…10 000 rpm |  | rpm = pulses/2·60/s | fan proving | A14 commanded but not turning
RPM-102 | FAN-102 tach | DI (pulse) | fan tach | 2 pulses/rev | GPIO11 (10 k pull-up) | J3 pin 4 | 0…10 000 rpm |  | as RPM-101 | PTC/humidifier interlock (> 300 rpm) | A14
RPM-103 | FAN-103 / FAN-103B tach (the running fan) | DI (pulse) | fan tach | 2 pulses/rev | GPIO12 (10 k pull-up) | J4 pin 4 | 0…10 000 rpm |  | as RPM-101 | fan proving | A14
FAN-101 | Fresh-air compressor speed | AO (PWM) | 24 V centrifugal blower with PWM input | 25 kHz PWM via AO3400 open drain (inverted) | GPIO38 | J2 (24V GND PWM TACH) | 0…100 % | ~25 % | duty = 1 - u (open drain) | L2 output
FAN-102 | Supply fan speed | AO (PWM) | 24 V high-pressure blower | 25 kHz PWM via AO3400 open drain | GPIO39 | J3 (24V GND PWM TACH) | 0…100 % | ~33 % | duty = 1 - u | L1 output
FAN-103 | Exhaust fan speed: FAN-103 (air-pump unit) or FAN-103B (outer HEPA) | AO (PWM) | 2 × 24 V blowers; DV-101 end switch powers the fan of the open path | 25 kHz PWM via AO3400 open drain (both PWM inputs in parallel) | GPIO40 | J4 (24V GND PWM TACH) | 0…100 % | ~35 % | duty = 1 - u | L7 output
DV-101 | Exhaust diverter: air pump ⇄ outer BIBO HEPA | DO | 24 V spring-return on/off damper actuator + SPDT end switch | logic MOSFET low side + SS34 flyback | GPIO21 | J5 (24V SW- / end switch to J4 fan feed) | energised = to the air pump; off = HEPA (fail-safe) | air pump | 2-position | L3 output (PT-102) | A06 exhaust contaminated
CMP-101 | Air-pump compressor speed | AO (0–5 V) | 24 V DC compressor driver | 20 kHz PWM → RC 10 k/1 µF → LM358 ×1.51 → 0–5 V | GPIO41 | J6 (24V GND SPEED) | 0 / 30…100 % | cycles at 30 % (winter); ~60 % (summer) | V = 5·u (u < 0.30 → off) | L4 output; min off 180 s / min on 120 s
RV-101 | 4-way reversing valve | DO | miniature 4-way valve 24 V DC coil | logic MOSFET + SS34 flyback | GPIO42 | J7 (24V SW-) | off = heating / on = cooling |  | switches 30 s after the compressor stops | season sequencing
EEV-101 | Electronic expansion valve | AO (stepper) | miniature bipolar stepper EEV | DRV8825 STEP/DIR (VMOT 24 V; EN low) | GPIO13 STEP / GPIO14 DIR | J8 (A1 A2 B1 B2) | 0…500 steps | 80 + 400·u_cmp | homed by 560 closing steps at start-up | feed-forward from CMP-101
HTR-101 | Reheat PTC element | AO (PWM) | 24 V 30 W finned PTC + 130 °C thermal fuse | 1 kHz PWM via AOD4184 low side | GPIO47 | J9 (24V SW-) | 0…100 % | ~5 % winter / ~66 % summer | P ≈ 30 W·u | L5 output; needs airflow + FAN-102 tach
HUM-101 | Steam humidifier | AO (PWM) | 24 V steam generator (mini boiler) + lance | 1 kHz PWM via AOD4184 low side | GPIO48 | J10 (24V SW-) | 0…100 % (45 g/h) | ~60 % winter | ṁ ≈ 45 g/h·u | L6 output (winter); blocked if MT-105 > 85 %
HMI-101 | 7-inch serial touch HMI | UART | Nextion-style 7" HMI (5 V) | UART1 115200 8N1 | GPIO17 TX / GPIO18 RX | J21 (5V GND TX RX) |  |  | name.txt="value" + FF FF FF; text commands back | display + set points
USB | Telemetry + flashing | USB | ESP32-S3 native USB-C | JSON 1 Hz + text commands | GPIO19/20 (USB) | DevKit USB port |  |  | see firmware/README.md | live monitor
