Kariemm11/Cleanroom-Heat-Recovery-Air-Pump/docs/img/cad-step-plant.jpg

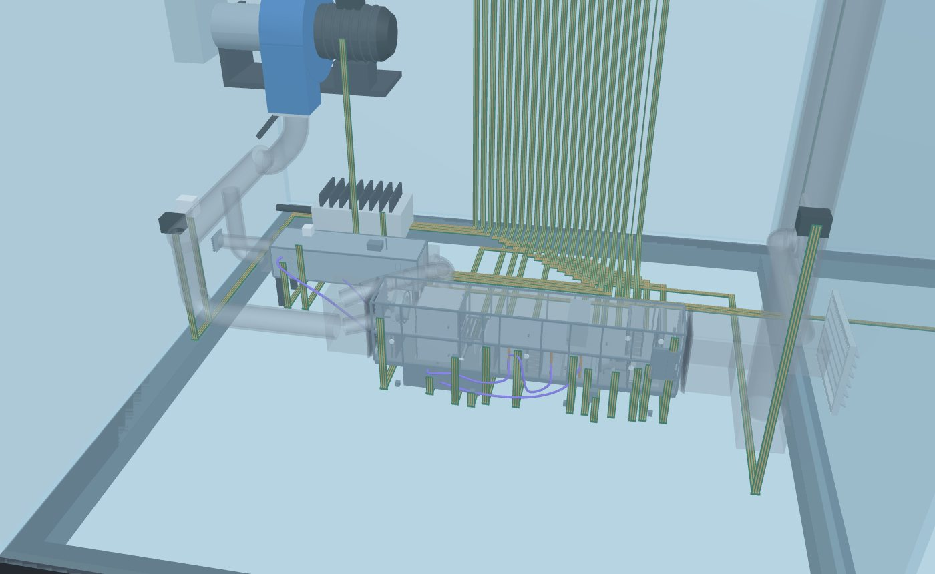
docs/img/cad-step-plant.jpg
