Kariemm11/Cleanroom-Heat-Recovery-Air-Pump/docs/img/cad-step-render.jpg

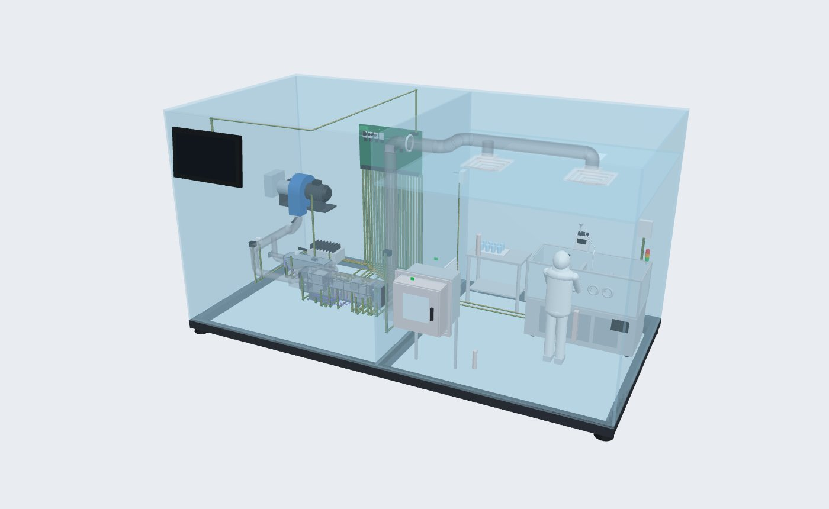
docs/img/cad-step-render.jpg
