Kariemm11/Cleanroom-Heat-Recovery-Air-Pump/docs/img/rig-hazard.jpg

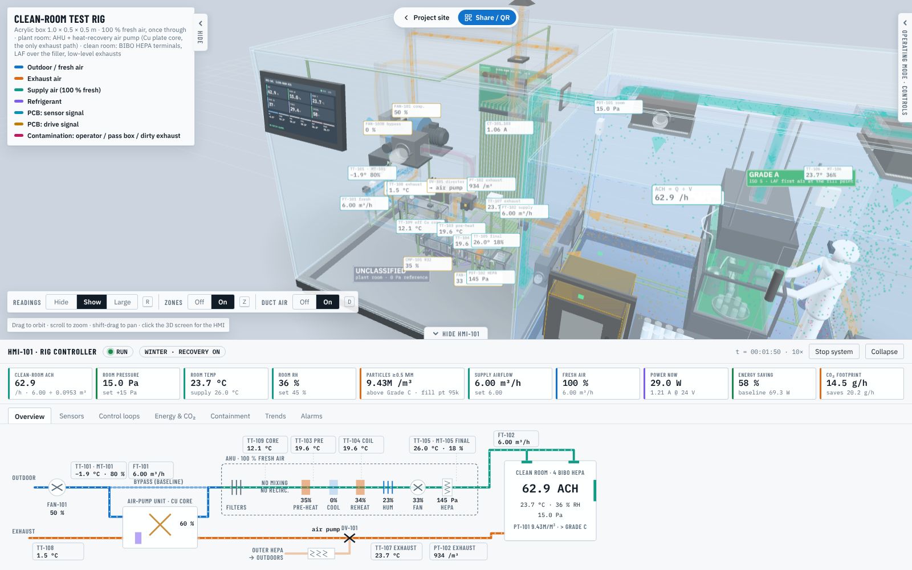
docs/img/rig-hazard.jpg
