Kariemm11/Cleanroom-Heat-Recovery-Air-Pump/cad/drawings/rig-2D-views.pdf

## Clean-room rig: general arrangement

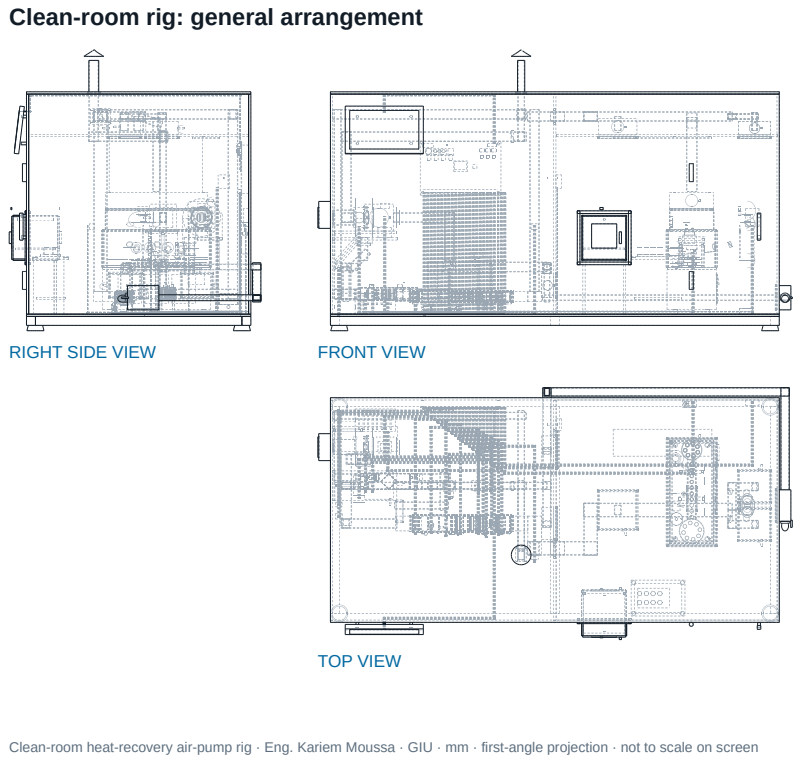
[picture p121: page 1]
FRONT VIEW; TOP VIEW

RIGHT SIDE VIEW

Clean-room heat-recovery air-pump rig · Eng. Kariem Moussa · GIU · mm · first-angle projection · not to scale on screen

## Plant: AHU + air-pump unit in parallel

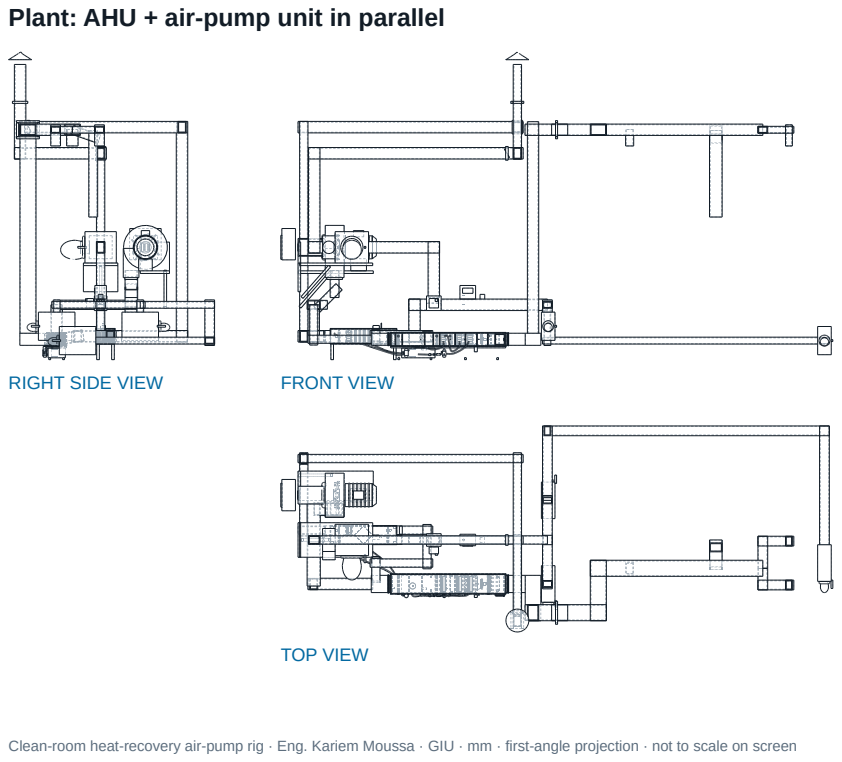
[picture p122: page 2]
FRONT VIEW; TOP VIEW

RIGHT SIDE VIEW

## Sub-assembly: AHU

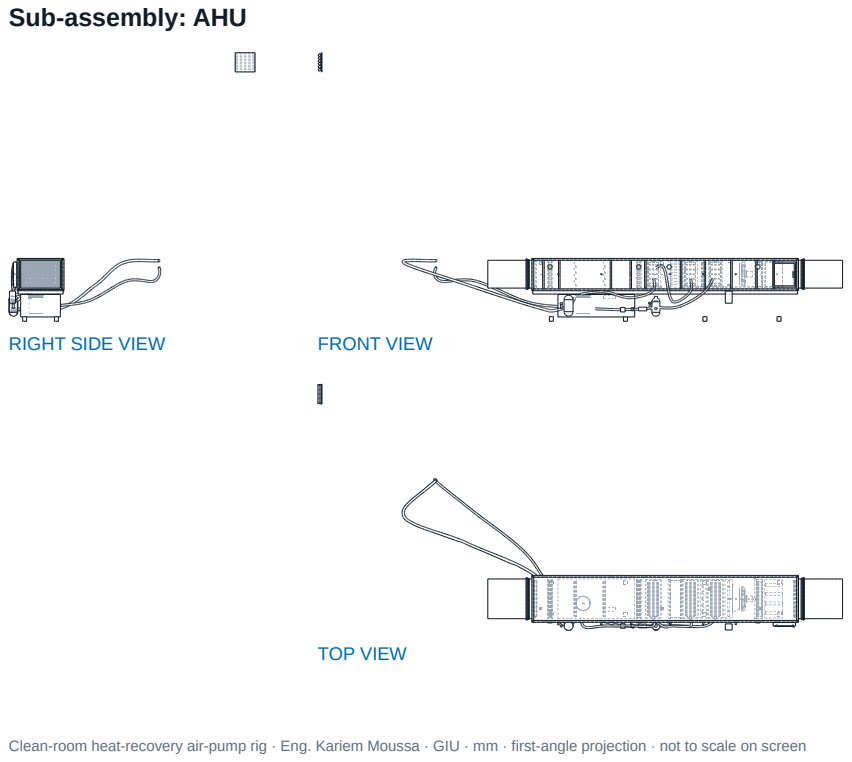
[picture p123: page 3]
FRONT VIEW; TOP VIEW

RIGHT SIDE VIEW

## Sub-assembly: Acrylic enclosure

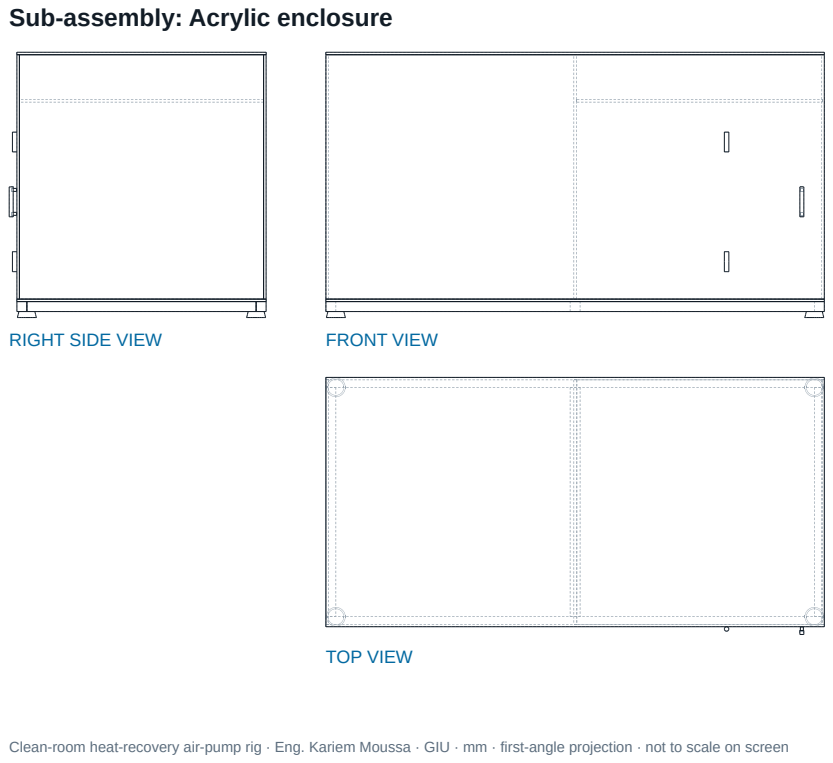
[picture p124: page 4]
FRONT VIEW; TOP VIEW

RIGHT SIDE VIEW

## Sub-assembly: Clean room

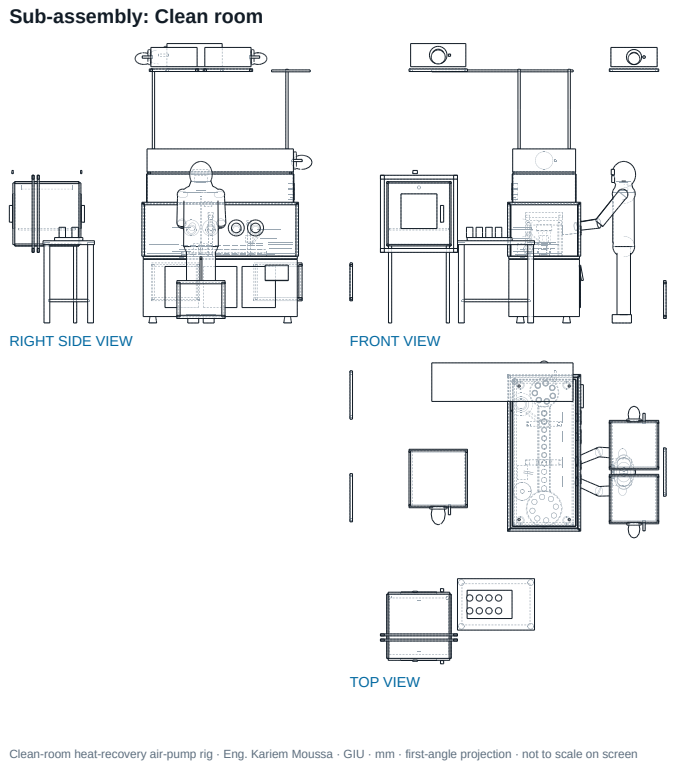
[picture p125: page 5]
FRONT VIEW; TOP VIEW

RIGHT SIDE VIEW

## Sub-assembly: Controls and HMI

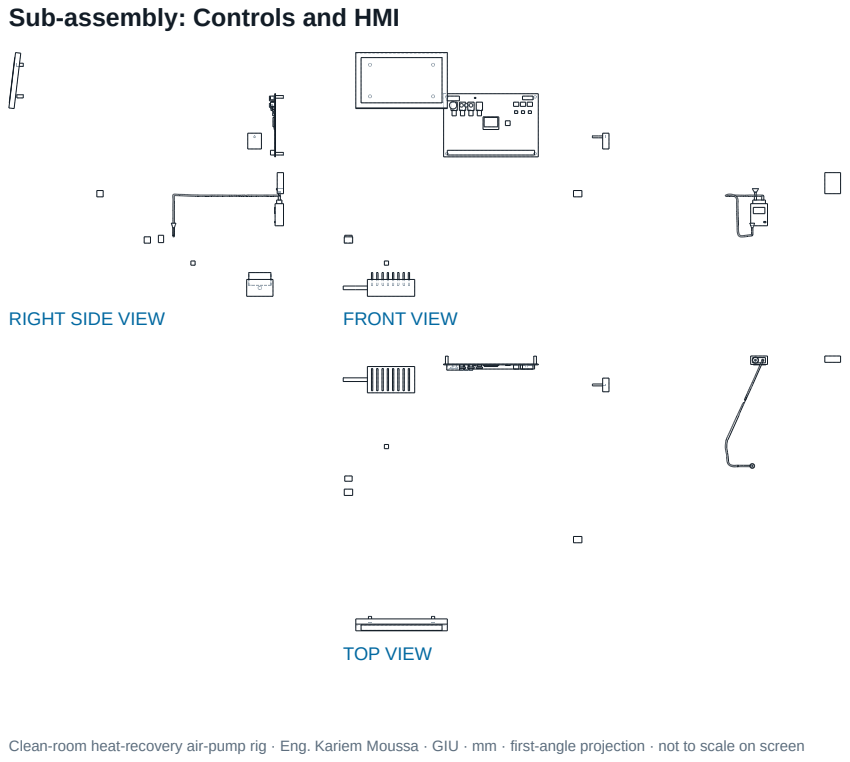
[picture p126: page 6]
FRONT VIEW; TOP VIEW

RIGHT SIDE VIEW

## Sub-assembly: Ductwork

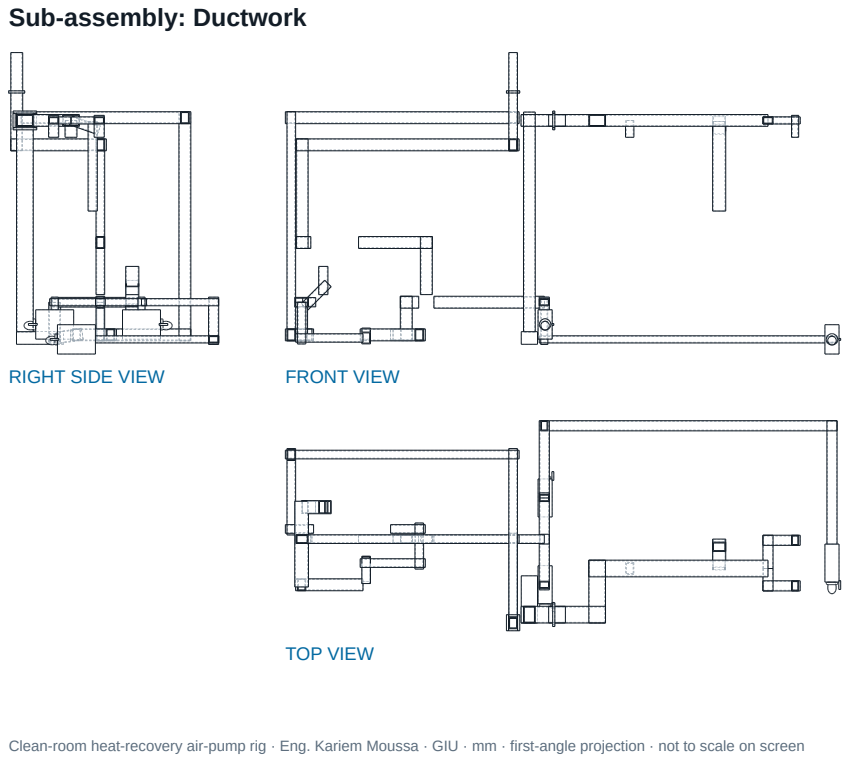
[picture p127: page 7]
FRONT VIEW; TOP VIEW

RIGHT SIDE VIEW

### Sub-assembly: Exhaust safety PT-102 plus DV-101 plus outer HEPA

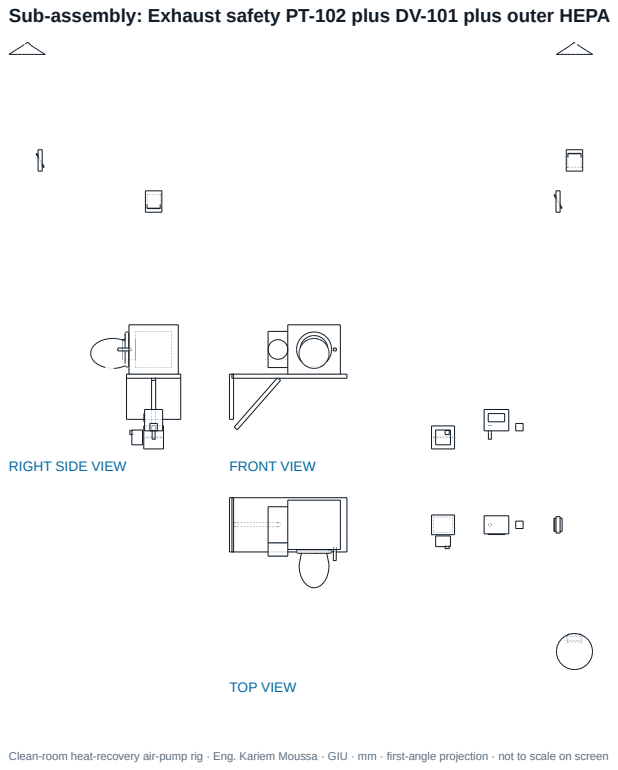
[picture p128: page 8]
FRONT VIEW; TOP VIEW

RIGHT SIDE VIEW

## Sub-assembly: Fresh-air compressor

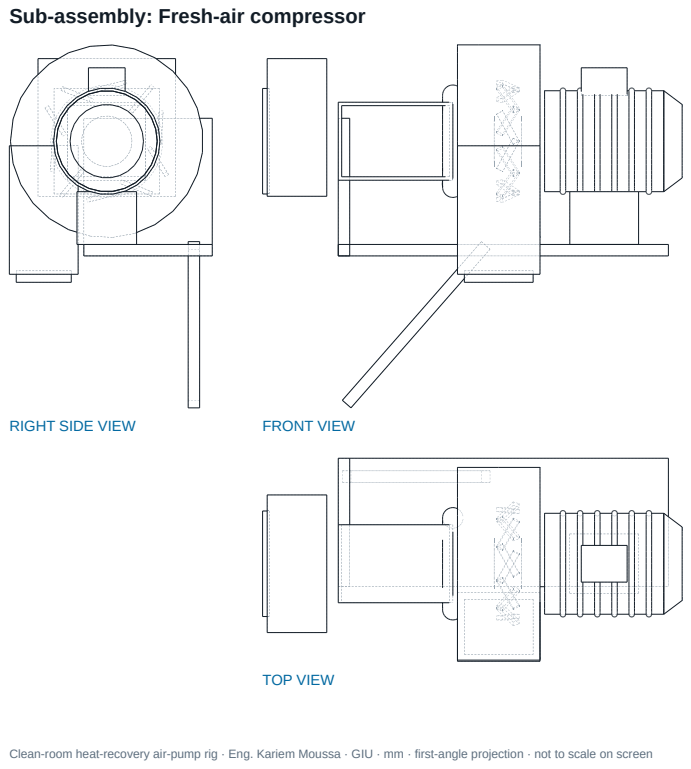
[picture p129: page 9]
FRONT VIEW; TOP VIEW

RIGHT SIDE VIEW

# Sub-assembly: Heat-recovery air-pump unit

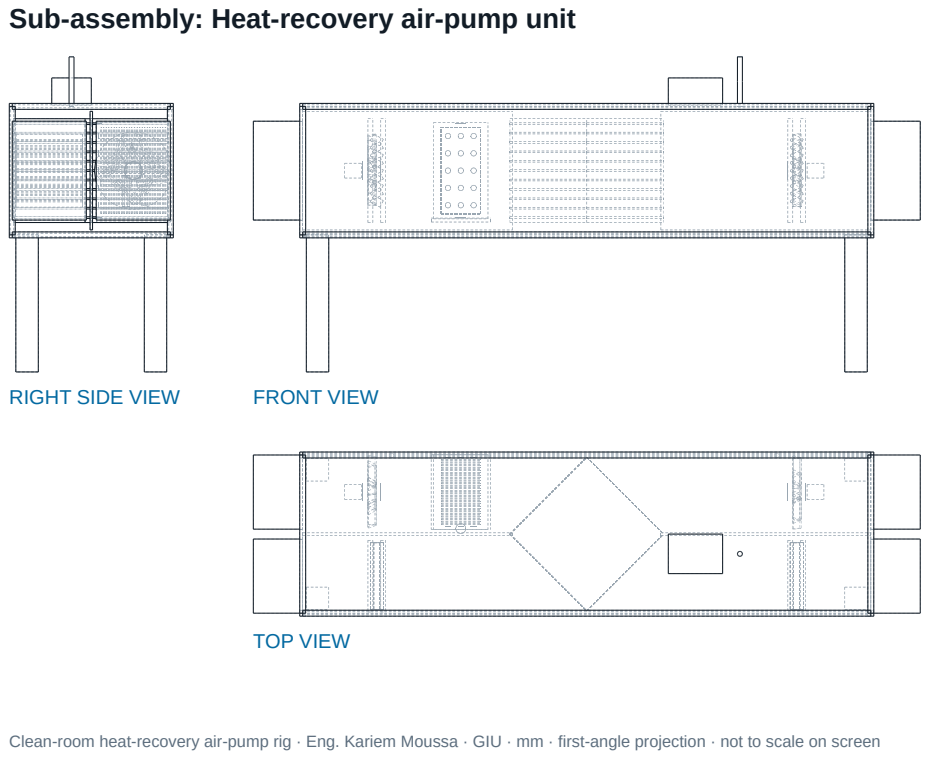
[picture p130: page 10]
FRONT VIEW; TOP VIEW

RIGHT SIDE VIEW

### FRONT VIEW

### TOP VIEW

### RIGHT SIDE VIEW

## Sub-assembly: PCB wiring harness
