Kariemm11/Cleanroom-Heat-Recovery-Air-Pump/assets/js/rig.js

/* Clean-room test rig — 3D scene, HMI and control wiring.
   World units are centimetres: x along the 1.0 m box (−50 … +50, partition at 0),
   y up (0 … 50), z across (−25 … +25, front face at +25).
   The plant room (x < 0) holds the AHU and the parallel heat-recovery air-pump unit
   exactly as in the earlier model; the clean room is x > 0. */
(function(){
"use strict";
if(!window.THREE){document.querySelector('.legend').insertAdjacentHTML('beforeend','<p class="sub" style="margin-top:8px">3D library could not load.</p>');return;}

/* Stale-cache guard. GitHub Pages lets browsers keep files for up to 10 minutes, so right after an update
   an old cached page can meet this newer script (or the other way round) and the scene fails to start.
   The page names the build it belongs to; on a mismatch, load it once more under a fresh URL. */
var BUILD='2026-10-21-1';
var appEl=document.getElementById('app'), pageBuild=appEl?appEl.getAttribute('data-build'):null;
if(pageBuild!==BUILD){
  var q=new URLSearchParams(location.search);
  if(q.get('b')!==BUILD){ q.set('b',BUILD); location.replace(location.pathname+'?'+q.toString()+location.hash); return; }
  // a fresh load still brought an older page: say so instead of failing half-way
  var lg=document.querySelector('.legend');
  if(lg) lg.insertAdjacentHTML('beforeend','<p class="sub" style="margin-top:8px;color:var(--bad)">This page is an older cached copy. '+
    'Press Ctrl+Shift+R (Cmd+Shift+R on a Mac) to load the latest version.</p>');
  return;
}

/* ---------------------------------------------------------------- tokens */
var css = getComputedStyle(document.documentElement);
function tok(n){ return css.getPropertyValue(n).trim(); }
function col(n){ return new THREE.Color(tok(n)); }
var T = {};
function readTokens(){
  css = getComputedStyle(document.documentElement);
  T.fresh=col('--fresh'); T.ret=col('--return'); T.mix=col('--mix'); T.refrig=col('--refrig');
  T.scene=col('--scene'); T.floor=col('--floor'); T.metal=col('--metal');
  T.metalDark=col('--metal-dark'); T.glass=col('--glass'); T.ink=tok('--ink');
  T.panel=tok('--panel-solid'); T.inkDim=tok('--ink-dim');
  T.acrylic=col('--acrylic'); T.pcb=col('--pcb'); T.copper=col('--copper');
  T.sigIn=col('--sig-in'); T.sigOut=col('--sig-out'); T.contam=col('--contam');
  T.tCold=col('--t-cold'); T.tMid=col('--t-mid'); T.tHot=col('--t-hot');
  T.good=tok('--good'); T.warn=tok('--warn'); T.bad=tok('--bad');
  T.dark = document.documentElement.getAttribute('data-theme')==='dark' ||
    (document.documentElement.getAttribute('data-theme')!=='light' &&
     window.matchMedia('(prefers-color-scheme:dark)').matches);
}
readTokens();

/* ------------------------------------------------------------- renderer  */
var canvas = document.getElementById('scene');
var stage  = document.getElementById('stage');
var renderer = new THREE.WebGLRenderer({canvas:canvas, antialias:true, preserveDrawingBuffer:false});
renderer.setPixelRatio(Math.min(2, window.devicePixelRatio||1));
renderer.outputEncoding = THREE.sRGBEncoding;

var scene = new THREE.Scene();
scene.background = T.scene.clone();

var camera = new THREE.PerspectiveCamera(40, 2, 0.5, 2000);
var VIEWS = {
  iso:   {t:[-2,16,0],   theta:0.62, phi:1.10, r:158},
  front: {t:[0,24,0],    theta:0.0,  phi:1.45, r:118},   // the default: the whole box centred, seen from the front (r is fitted to the screen)
  top:   {t:[0,10,0],    theta:0.0,  phi:0.12, r:150},
  plant: {t:[-27,5,-1],  theta:0.34, phi:0.78, r:50},
  clean: {t:[24,20,0],   theta:0.42, phi:1.18, r:92},
  hmi:   {t:[-38,41.5,27], theta:0.0, phi:1.45, r:28}
};
var target = new THREE.Vector3().fromArray(VIEWS.front.t);
var targetGoal = target.clone();
var cam = {theta:VIEWS.front.theta, phi:VIEWS.front.phi, r:VIEWS.front.r};
var camGoal = {theta:cam.theta, phi:cam.phi, r:cam.r};
function placeCamera(){
  var sp=Math.sin(cam.phi);
  camera.position.set(target.x+cam.r*sp*Math.sin(cam.theta),
                      target.y+cam.r*Math.cos(cam.phi),
                      target.z+cam.r*sp*Math.cos(cam.theta));
  camera.lookAt(target);
}

/* ---------------------------------------------------------------- lights */
var hemi=new THREE.HemisphereLight(0xffffff,0x404a55,0.85); scene.add(hemi);
var key =new THREE.DirectionalLight(0xffffff,0.75); key.position.set(60,110,90); scene.add(key);
var fill=new THREE.DirectionalLight(0xffffff,0.30); fill.position.set(-90,40,-70); scene.add(fill);
function tuneLights(){
  hemi.intensity=T.dark?0.50:0.85; key.intensity=T.dark?0.55:0.75; fill.intensity=T.dark?0.26:0.30;
}
tuneLights();

/* ---------------------------------------------- plant group and transform */
/* The earlier model is ~40 units long (louvres to duct ends). K scales it so the
   AHU's supply and return connections meet the partition and the recovery unit's
   louvres sit on the box's left wall. */
var K=1.1, XO=-20.74, YO=5.64, ZO=3.0;
var plant=new THREE.Group(); plant.scale.setScalar(K); plant.position.set(XO,YO,ZO);
plant.userData.asm='Plant room'; scene.add(plant);
function C2W(x,y,z){ return new THREE.Vector3(XO+K*x, YO+K*y, ZO+K*z); }
function W2C(x,y,z){ return new THREE.Vector3((x-XO)/K, (y-YO)/K, (z-ZO)/K); }
function tag(o,name){ o.userData.part=name; return o; }

/* fresh-air louvre: moved to the compressor intake on the left wall (model units) */
var LZU=W2C(0,0,-14).z, LYU=W2C(0,22,0).y;
var humGroup=null;

/* ======================================================================
   AHU + heat-recovery air-pump unit, in the earlier 3D model's own units; the whole
   group is scaled into the plant-room half of the box (see K, XO, YO, ZO).
   Hazardous-material design: the AHU is a single-deck 100 % fresh-air unit. There is no
   mixing box, no recirculation, no extract deck and no heat-recovery core in the AHU;
   the only exhaust path is the air-pump unit's copper plate core (non-contact).
   ====================================================================== */
/* ------------------------------------------------------------- materials */
function std(c,o){ o=o||{}; return new THREE.MeshStandardMaterial({
  color:c, metalness:o.m!==undefined?o.m:0.55, roughness:o.r!==undefined?o.r:0.45,
  transparent:!!o.t, opacity:o.o!==undefined?o.o:1, side:o.side||THREE.FrontSide,
  depthWrite:o.dw!==undefined?o.dw:true, emissive:o.e||0x000000,
  emissiveIntensity:o.ei!==undefined?o.ei:1});}

var M = {
  panel : std(T.metal.clone(), {m:0.62,r:0.34,t:true,o:0.22,side:THREE.DoubleSide,dw:false}),
  frame : std(T.metalDark.clone(), {m:0.75,r:0.32}),
  inner : std(T.metal.clone(), {m:0.40,r:0.60,side:THREE.DoubleSide}),
  copper: std(new THREE.Color('#b9712f'), {m:0.9,r:0.3}),
  fin   : std(new THREE.Color('#aab6c0'), {m:0.5,r:0.55,t:true,o:0.85,side:THREE.DoubleSide}),
  coilHot : std(new THREE.Color('#d9541a'), {m:0.35,r:0.5,e:0x5a1d00,ei:0.75,t:true,o:0.78,side:THREE.DoubleSide}),
  coilCold: std(new THREE.Color('#1878cf'), {m:0.35,r:0.5,e:0x001f3d,ei:0.75,t:true,o:0.78,side:THREE.DoubleSide}),
  coilIdle: std(new THREE.Color('#8e9aa6'), {m:0.4,r:0.6,t:true,o:0.45,side:THREE.DoubleSide}),
  filter: std(new THREE.Color('#8e9aa6'), {m:0.1,r:0.9}),
  duct  : std(T.metal.clone(), {m:0.5,r:0.5,t:true,o:0.16,side:THREE.DoubleSide,dw:false}),
  refrig: std(T.refrig.clone(), {m:0.6,r:0.35,e:0x150a30,ei:0.5}),
  base  : std(T.metalDark.clone(), {m:0.7,r:0.4})
};

/* ------------------------------------------------------------- envelope  */
var unit=new THREE.Group(); plant.add(unit); unit.userData.asm='AHU';
var explodables=[], labels=[], casingParts=[], spinners=[];
var L=20.0, H=4.6, D=3.4;
var X0=-L/2, X1=L/2, Y0=-H/2, Y1=H/2, Z0=-D/2, Z1=D/2;
var YS=-1.12, YE=1.12;          // supply deck centre line (YE: the old extract deck, now removed)
var YT=0.0;                     // roof of the single-deck 100 % fresh-air AHU
var YC=(Y0+YT)/2, HC=YT-Y0;     // casing centre line and height

/* the parallel heat-recovery air-pump unit, standing behind the AHU */
var MX0=-20.5, MX1=-9.0, MXC=(MX0+MX1)/2;
var MY=-0.6, MZ=-8.5, MH=2.6, MD=3.2;
var MZU=MZ+0.85, MZL=MZ-0.85;   // the two lanes that cross inside the core

function box(w,h,d,mat){ return new THREE.Mesh(new THREE.BoxGeometry(w,h,d), mat); }
function at(o,x,y,z){ o.position.set(x,y,z); return o; }

(function frame(){
  var t=0.14, g=new THREE.Group();
  function bar(w,h,d,x,y,z){ g.add(at(box(w,h,d,M.frame),x,y,z)); }
  [[Y0,Z0],[Y0,Z1],[YT,Z0],[YT,Z1]].forEach(function(p){ bar(L,t,t,0,p[0],p[1]); });
  [[X0,Z0],[X0,Z1],[X1,Z0],[X1,Z1]].forEach(function(p){ bar(t,HC,t,p[0],YC,p[1]); });
  [[X0,Y0],[X0,YT],[X1,Y0],[X1,YT]].forEach(function(p){ bar(t,t,D,p[0],p[1],0); });
  [-9.2,-8.0,-4.1,-2.6,-1.5,1.2,3.0,5.0,6.9,8.2].forEach(function(x){
    bar(t*0.8,HC,t*0.8,x,YC,Z0); bar(t*0.8,HC,t*0.8,x,YC,Z1);
  });
  tag(g,'AHU frame'); unit.add(g);
})();

function panel(w,h,d,x,y,z,dir){
  var m=box(w,h,d,M.panel.clone()); at(m,x,y,z);
  tag(m,'AHU casing panel'); unit.add(m); casingParts.push(m);
  explodables.push({obj:m, dir:dir.clone(), base:m.position.clone(), scale:3.6});
}
panel(L,HC,0.06, 0,YC,Z1, new THREE.Vector3(0,0,1));
panel(L,HC,0.06, 0,YC,Z0, new THREE.Vector3(0,0,-1));
panel(L,0.06,D, 0,YT,0, new THREE.Vector3(0,1,0));
panel(L,0.06,D, 0,Y0,0, new THREE.Vector3(0,-1,0));

/* --- base / machine compartment --- */
(function(){
  var g=new THREE.Group();
  g.add(at(box(L,0.30,D,M.base),0,Y0-0.17,0));
  g.add(at(box(5.8,1.70,D-0.4,M.base.clone()),-5.2,Y0-1.20,0));
  var comp=new THREE.Mesh(new THREE.CylinderGeometry(0.52,0.52,1.25,28), M.frame);
  at(comp,-6.2,Y0-1.15,0.35); g.add(comp);
  g.add(at(new THREE.Mesh(new THREE.CylinderGeometry(0.56,0.56,0.16,28),M.base),-6.2,Y0-0.48,0.35));
  g.add(at(box(0.9,0.26,0.26,M.refrig),-4.2,Y0-0.55,0.8));
  [-8.6,-3.0,3.0,8.6].forEach(function(x){
    [Z0+0.5,Z1-0.5].forEach(function(z){ g.add(at(box(0.3,0.34,0.3,M.frame),x,Y0-2.2,z)); });
  });
  tag(g,'Base, machine compartment & R32 compressor'); unit.add(g);
  labels.push({text:'Scroll compressor', sub:'R32 · inverter driven',
    anchor:new THREE.Vector3(-6.2,Y0-1.15,0.35), off:new THREE.Vector3(-1.0,-1.0,1.6)});
  labels.push({text:'4-way reversing valve', sub:'heating ⇄ cooling', tier:'aux',
    anchor:new THREE.Vector3(-4.2,Y0-0.55,0.8), off:new THREE.Vector3(1.9,-1.2,1.4)});
})();

/* --- filtration --- */
function preFilter(x,y,label,sub,tier){
  var g=new THREE.Group();
  g.add(at(box(0.09,2.05,D-0.45,M.frame),x-0.14,y,0));
  for(var i=0;i<13;i++){
    var p=at(box(0.22,0.17,D-0.6,M.filter),x,y-0.96+i*0.16,0);
    p.rotation.z=(i%2?1:-1)*0.52; g.add(p);
  }
  g.add(at(box(0.09,2.05,D-0.45,M.frame),x+0.14,y,0));
  tag(g,label); unit.add(g);
  explodables.push({obj:g, dir:new THREE.Vector3(0,y>0?1:-1,0.4).normalize(), base:new THREE.Vector3(0,0,0), scale:3.1});
  labels.push({text:label, sub:sub||'ISO Coarse 60 % panel', tier:tier,
    anchor:new THREE.Vector3(x,y,0), off:new THREE.Vector3(-0.6,y>0?1.5:-1.5,1.6)});
}
function bagFilter(x,y,label){
  var g=new THREE.Group();
  g.add(at(box(0.16,2.0,D-0.5,M.frame),x,y,0));
  for(var i=0;i<9;i++){
    var p=at(box(0.80,0.20,D-0.6,M.filter),x+0.48,y-0.88+i*0.22,0);
    p.rotation.z=(i%2?1:-1)*0.14; g.add(p);
  }
  g.add(at(box(0.10,2.0,D-0.5,M.frame),x+0.92,y,0));
  tag(g,label); unit.add(g);
  explodables.push({obj:g, dir:new THREE.Vector3(0,y>0?1:-1,0.35).normalize(), base:new THREE.Vector3(0,0,0), scale:2.6});
  labels.push({text:label, sub:'ePM1 55 % bag',
    anchor:new THREE.Vector3(x+0.45,y,0), off:new THREE.Vector3(0.7,y>0?1.5:-1.5,1.6)});
}
function hepaFilter(x,y,label){
  var g=new THREE.Group();
  g.add(at(box(0.10,2.10,D-0.40,M.frame),x-0.18,y,0));          // gasketed holding frame
  var pm=std(new THREE.Color('#cfd6dc'),{m:0.1,r:0.9,t:true,o:0.95,side:THREE.DoubleSide});
  for(var i=0;i<26;i++) g.add(at(box(0.40,1.86,0.025,pm),x+0.12,y,-1.30+i*0.104));
  g.add(at(box(0.46,0.08,D-0.45,M.frame),x+0.12,y+0.96,0));
  g.add(at(box(0.46,0.08,D-0.45,M.frame),x+0.12,y-0.96,0));
  [-1,1].forEach(function(s){
    [-1,1].forEach(function(t){
      var c=new THREE.Mesh(new THREE.CylinderGeometry(0.05,0.05,0.5,10),M.frame);
      c.rotation.z=Math.PI/2; at(c,x+0.12,y+s*0.78,t*1.28); g.add(c);   // clamping screws
    });
  });
  tag(g,label); unit.add(g);
  explodables.push({obj:g, dir:new THREE.Vector3(0,-1,0.45).normalize(), base:new THREE.Vector3(0,0,0), scale:2.8});
  labels.push({text:label, sub:'H13 · 99.95 % @ MPPS · scan-tested',
    anchor:new THREE.Vector3(x+0.1,y,0), off:new THREE.Vector3(0.9,-2.0,1.5)});
}

preFilter(-8.7, YS, 'Outdoor-air pre-filter');
preFilter(-2.0, YS, 'Panel filter', 'ISO ePM10 50 % · 100 % fresh air');
bagFilter( 0.3, YS, 'Bag filter');
hepaFilter( 7.0, YS, 'HEPA final filter');

/* --- 100 % fresh-air plenum where the mixing box and the AHU core used to be --- */
(function freshPlenum(){
  var g=new THREE.Group();
  var vm=std(T.glass.clone(),{m:0.4,r:0.6,t:true,o:0.35,side:THREE.DoubleSide});
  [-6.8,-4.6].forEach(function(x){ for(var j=0;j<4;j++){ var b=box(0.05,0.42,D-0.8,vm); at(b,x,YS-0.7+j*0.47,0); b.rotation.z=0.35; g.add(b); } });
  tag(g,'Fresh-air plenum + turning vanes'); unit.add(g);
  labels.push({text:'100 % fresh air',sub:'no mixing box · no recirculation · no exhaust in the AHU',
    anchor:new THREE.Vector3(-5.7,YS+0.6,0), off:new THREE.Vector3(-1.2,2.2,1.5)});
})();

/* --- coils --- */
function coil(x,y,id,z,sz,host){
  z=z||0; sz=sz||1; host=host||unit;
  var g=new THREE.Group();
  var fins=new THREE.InstancedMesh(new THREE.BoxGeometry(0.80,1.75,0.02), M.fin, 26);
  var mtx=new THREE.Matrix4();
  for(var i=0;i<26;i++){ mtx.makeTranslation(0,0,(-1.25+i*0.1)*sz); fins.setMatrixAt(i,mtx); }
  g.add(fins); g.userData.fins=fins;
  for(var cx=0;cx<3;cx++) for(var cy=0;cy<5;cy++){
    var t=new THREE.Mesh(new THREE.CylinderGeometry(0.055,0.055,2.7*sz,10),M.copper);
    t.rotation.x=Math.PI/2; at(t,-0.26+cx*0.26,-0.7+cy*0.35,0); g.add(t);
  }
  g.add(at(new THREE.Mesh(new THREE.CylinderGeometry(0.1,0.1,1.9,14),M.copper),0,0,1.42*sz));
  g.add(at(box(1.1,1.95,(D-0.5)*sz,std(T.glass.clone(),{m:0.3,r:0.6,t:true,o:0.1,side:THREE.DoubleSide,dw:false})),0,0,0));
  g.add(at(box(1.2,0.08,(D-0.5)*sz,M.inner),0,-1.0,0));
  g.userData.id=id; tag(g,'Coil: '+id);
  g.position.set(x,y,z);
  host.add(g);
  explodables.push({obj:g, dir:new THREE.Vector3(0,y>0?1:-1,0.5).normalize(),
    base:new THREE.Vector3(x,y,z), scale:2.4});
  return g;
}
var coilPreheat = coil(-0.9, YS, 'preheat');
var coilCooling = coil( 1.9, YS, 'cooling');
var coilReheat  = coil( 3.8, YS, 'reheat');
var coilExtract = coil(-17.3, MY, 'extract', MZL, 0.52);  // lives in the recovery unit
var lblPre ={text:'Pre-heat coil', sub:'air pump condenser',
  anchor:new THREE.Vector3(-0.9,YS,0), off:new THREE.Vector3(-1.4,-1.9,1.4)};
var lblCool={text:'Cooling coil', sub:'idle in heating mode',
  anchor:new THREE.Vector3(1.9,YS,0), off:new THREE.Vector3(0.1,-2.3,1.4)};
var lblRe  ={text:'Reheat coil', sub:'idle in heating mode',
  anchor:new THREE.Vector3(3.8,YS,0), off:new THREE.Vector3(1.6,-1.9,1.4)};
var lblExt ={text:'Exhaust-air coil', sub:'air pump evaporator',
  anchor:new THREE.Vector3(-17.3,MY,MZL), off:new THREE.Vector3(-0.8,1.9,-0.8)};
labels.push(lblPre,lblCool,lblRe,lblExt);

/* --- fans --- */
function fan(x,y,dirSign,label){
  var g=new THREE.Group(), rotor=new THREE.Group();
  var hub=new THREE.Mesh(new THREE.CylinderGeometry(0.27,0.27,0.52,20),M.frame);
  hub.rotation.z=Math.PI/2; rotor.add(hub);
  var bm=std(T.metal.clone(),{m:0.65,r:0.35,side:THREE.DoubleSide});
  for(var i=0;i<9;i++){
    var a=i/9*Math.PI*2, b=box(0.26,0.92,0.07,bm);
    b.position.set(0, Math.cos(a)*0.64, Math.sin(a)*0.64);
    b.rotation.x=-a; b.rotateY(0.55*dirSign); rotor.add(b);
  }
  at(rotor,x,y,0); g.add(rotor);
  spinners.push({obj:rotor, axis:'x', rate:dirSign*5.2, id:label});
  var cone=new THREE.Mesh(new THREE.CylinderGeometry(1.08,0.78,0.5,28,1,true),
    std(T.metal.clone(),{m:0.6,r:0.4,t:true,o:0.4,side:THREE.DoubleSide}));
  cone.rotation.z=Math.PI/2; at(cone,x-dirSign*0.55,y,0); g.add(cone);
  var ring=new THREE.Mesh(new THREE.TorusGeometry(1.08,0.05,8,32),M.frame);
  ring.rotation.y=Math.PI/2; at(ring,x-dirSign*0.8,y,0); g.add(ring);
  g.add(at(box(0.5,0.42,0.42,M.frame),x+dirSign*0.45,y,0));
  g.add(at(box(1.9,0.1,0.1,M.frame),x,y-0.98,0));
  tag(g,label); unit.add(g);
  explodables.push({obj:g, dir:new THREE.Vector3(dirSign*0.6,y>0?0.8:-0.8,0.3).normalize(), base:new THREE.Vector3(0,0,0), scale:2.6});
  labels.push({text:label, sub:'EC plug fan · VSD',
    anchor:new THREE.Vector3(x,y,0), off:new THREE.Vector3(dirSign*0.5,y>0?1.6:-1.6,1.5)});
}
fan( 5.9, YS,  1, 'Supply fan');

/* --- dampers on the four openings --- */
function damper(x,y,label,sub){
  var g=new THREE.Group();
  var bm=std(T.metalDark.clone(),{m:0.7,r:0.4,side:THREE.DoubleSide});
  for(var i=0;i<6;i++){
    var b=box(0.06,0.30,D-0.7,bm); at(b,x,y-0.80+i*0.32,0); b.rotation.z=0.55; g.add(b);
  }
  g.add(at(box(0.12,0.10,D-0.6,M.frame),x,y+1.0,0));
  g.add(at(box(0.12,0.10,D-0.6,M.frame),x,y-1.0,0));
  tag(g,label); unit.add(g);
  labels.push({text:label, sub:sub, tier:'aux',
    anchor:new THREE.Vector3(x,y,0), off:new THREE.Vector3(x<0?-1.7:1.7,y>0?1.3:-1.3,1.2)});
}
damper(X0+0.2, YS, 'Fresh-air inlet', 'from the air-pump Cu core');
damper(X1-0.2, YS, 'Supply air to the clean room', 'duct connection');

/* --- ductwork --- */
var ducts=new THREE.Group(); tag(ducts,'AHU duct connections');
[[-1,YS],[1,YS]].forEach(function(p){
  var d=box(3.4,2.1,D-0.4,M.duct); at(d,p[0]*(L/2+1.7),p[1],0); ducts.add(d);
  var e=new THREE.LineSegments(new THREE.EdgesGeometry(d.geometry),
    new THREE.LineBasicMaterial({color:T.metalDark.clone(),transparent:true,opacity:0.55}));
  e.position.copy(d.position); ducts.add(e);
});
unit.add(ducts);

/* --- auxiliaries --- */
var aux=new THREE.Group(); unit.add(aux);
var doors=new THREE.Group(); unit.add(doors);

(function eliminator(){
  var g=new THREE.Group();
  var bm=std(T.glass.clone(),{m:0.4,r:0.5,t:true,o:0.62,side:THREE.DoubleSide});
  for(var i=0;i<12;i++){
    var b=box(0.30,1.80,0.05,bm); at(b,2.9,YS,-1.32+i*0.24);
    b.rotation.y=(i%2?0.55:-0.55); g.add(b);
  }
  g.add(at(box(0.44,0.07,D-0.5,M.inner),2.9,YS-0.96,0));
  tag(g,'Droplet eliminator'); aux.add(g);
  explodables.push({obj:g,dir:new THREE.Vector3(0,-1,0.4).normalize(),base:new THREE.Vector3(0,0,0),scale:2.2});
  labels.push({text:'Droplet eliminator',sub:'carry-over protection',tier:'aux',
    anchor:new THREE.Vector3(2.9,YS,0),off:new THREE.Vector3(-0.2,-2.4,1.2)});
})();

(function humidifier(){
  var g=new THREE.Group();
  var hm=std(new THREE.Color('#9fb6c7'),{m:0.85,r:0.28});
  for(var i=0;i<3;i++) g.add(at(new THREE.Mesh(new THREE.CylinderGeometry(0.055,0.055,1.65,10),hm),4.8,YS+0.05,-0.9+i*0.9));
  g.add(at(box(0.14,0.14,D-0.7,hm),4.8,YS-0.82,0));
  g.add(at(box(0.52,0.92,0.46,M.frame),4.8,Y0-0.55,Z1+0.42));
  g.add(at(box(0.56,0.07,D-0.5,M.inner),4.8,YS-0.95,0));
  tag(g,'Steam humidifier'); aux.add(g); humGroup=g;
  labels.push({text:'Steam humidifier',sub:'lance bank + drip tray',tier:'aux',
    anchor:new THREE.Vector3(4.8,YS,0),off:new THREE.Vector3(1.9,-2.2,1.0)});
})();

function attenuator(x,y,label){
  var g=new THREE.Group();
  var sm=std(T.metal.clone(),{m:0.25,r:0.85,t:true,o:0.55,side:THREE.DoubleSide});
  for(var i=0;i<4;i++) g.add(at(box(1.30,1.86,0.22,sm),x,y,-1.05+i*0.70));
  g.add(at(box(1.34,0.07,D-0.5,M.inner),x,y+(y>0?0.98:-0.98),0));
  tag(g,label); aux.add(g);
  explodables.push({obj:g,dir:new THREE.Vector3(x>0?1:-1,0,0.3).normalize(),base:new THREE.Vector3(0,0,0),scale:2.4});
  labels.push({text:label,sub:'splitter attenuator',tier:'aux',
    anchor:new THREE.Vector3(x,y,0),off:new THREE.Vector3(x>0?1.5:-1.5,y>0?1.5:-1.5,1.2)});
}
attenuator( 8.2, YS, 'Supply attenuator');

function sensor(x,y,z,text,sub){
  var g=new THREE.Group();
  g.add(at(box(0.17,0.28,0.17,M.frame),x,y,z));
  g.add(at(new THREE.Mesh(new THREE.CylinderGeometry(0.03,0.03,0.8,8),M.frame),x,y-0.5,z));
  tag(g,'Sensor: '+text); aux.add(g);
  labels.push({text:text,sub:sub,tier:'aux',anchor:new THREE.Vector3(x,y,z),
    off:new THREE.Vector3(0,y>0?1.3:-1.4,1.1)});
}
sensor( 7.2, YS+0.85, 0.75, 'Supply T + RH', 'cascade control');
sensor(-9.4, YS+0.85, 0.75, 'TT-109 off the Cu core', 'fresh air after the non-contact pre-cooling');
/* rig additions in the same style: the two coil-leaving sensors */
sensor(-0.25, YS+0.85, 0.75, 'TT-103 after pre-heat', 'pre-heat coil control');
sensor( 3.35, YS+0.85,-0.75, 'TT-104 off cooling coil', 'cooling coil control');

(function gauges(){
  var gm=std(new THREE.Color('#d7dde3'),{m:0.2,r:0.7});
  [[-8.7,YS+0.55],[-2.0,YS+0.55],[0.3,YS+0.55],[7.0,YS+0.55]].forEach(function(p){
    var d=new THREE.Mesh(new THREE.CylinderGeometry(0.17,0.17,0.08,18),gm);
    d.rotation.x=Math.PI/2; at(d,p[0],p[1],Z1+0.08); tag(d,'Filter ΔP gauge'); aux.add(d);
  });
  labels.push({text:'Filter ΔP gauges',sub:'4 × 0–500 Pa',tier:'aux',
    anchor:new THREE.Vector3(0.3,YS+0.55,Z1+0.08),off:new THREE.Vector3(-0.8,-2.6,1.3)});
})();

(function controlPanel(){
  var g=new THREE.Group();
  g.add(at(box(1.7,1.9,0.26,M.frame),9.0,YC,Z1+0.22));
  g.add(at(box(1.5,1.7,0.03,std(T.metalDark.clone(),{m:0.4,r:0.6})),9.0,YC,Z1+0.37));
  g.add(at(new THREE.Mesh(new THREE.CylinderGeometry(0.05,0.05,0.4,10),M.inner),9.7,YC,Z1+0.4));
  tag(g,'AHU control panel'); aux.add(g);
  labels.push({text:'Control panel',sub:'BMS + EC fan drives',tier:'aux',
    anchor:new THREE.Vector3(9.0,YC,Z1+0.3),off:new THREE.Vector3(1.6,1.6,1.0)});
})();

(function weatherLouvres(){
  var bm=std(T.metalDark.clone(),{m:0.6,r:0.5,side:THREE.DoubleSide});
  [[LZU,LYU]].forEach(function(q){                  // fresh-air intake only: no exhaust leaves through this wall
    var z=q[0], yy=q[1], lg=new THREE.Group(); tag(lg,'Fresh-air louvre + bird mesh');
    for(var i=0;i<6;i++){
      var b=box(0.20,0.16,1.45,bm); at(b,MX0-5.6,yy-0.55+i*0.22,z);
      b.rotation.z=0.72; lg.add(b);
    }
    var mesh=new THREE.Mesh(new THREE.PlaneGeometry(1.5,1.45),
      std(T.metal.clone(),{m:0.6,r:0.5,t:true,o:0.3,side:THREE.DoubleSide}));
    mesh.rotation.y=Math.PI/2; at(mesh,MX0-5.45,yy,z); lg.add(mesh); ducts.add(lg);
  });
  labels.push({text:'Weather louvre + bird mesh',sub:'fresh-air compressor intake',tier:'aux',
    anchor:new THREE.Vector3(MX0-5.6,LYU,LZU),off:new THREE.Vector3(1.6,1.9,-0.8)});
  var fm=std(new THREE.Color('#5d6b78'),{m:0.1,r:0.95,t:true,o:0.85,side:THREE.DoubleSide});
  [[-1,YS],[1,YS]].forEach(function(p){
    for(var k=0;k<3;k++) ducts.add(at(box(0.07,2.2+k*0.06,D-0.3+k*0.05,fm), p[0]*(L/2+0.3+k*0.09), p[1], 0));
  });
})();

(function accessDoors(){
  var dm=new THREE.LineBasicMaterial({color:T.metalDark.clone(),transparent:true,opacity:0.8});
  function door(x,y,w){
    var g=new THREE.BufferGeometry().setFromPoints([
      new THREE.Vector3(x-w/2,y-0.95,Z1+0.05), new THREE.Vector3(x+w/2,y-0.95,Z1+0.05),
      new THREE.Vector3(x+w/2,y+0.95,Z1+0.05), new THREE.Vector3(x-w/2,y+0.95,Z1+0.05),
      new THREE.Vector3(x-w/2,y-0.95,Z1+0.05)]);
    doors.add(new THREE.Line(g,dm));
    var h1=new THREE.Mesh(new THREE.CylinderGeometry(0.05,0.05,0.26,10),M.frame);
    h1.rotation.x=Math.PI/2; at(h1,x+w/2-0.22,y,Z1+0.13); doors.add(h1);
  }
  [[-8.6,1.5],[-5.7,2.2],[-3.3,1.9],[-0.6,2.4],[2.1,2.0],[4.6,1.9],[7.5,2.3],[9.3,1.2]]
    .forEach(function(s){ door(s[0],YS,s[1]); });
})();

/* ============ parallel heat-recovery air-pump unit (the HRV package) === */
var modUnit=new THREE.Group(); plant.add(modUnit); modUnit.userData.asm='Heat-recovery air-pump unit';
modUnit.add(coilExtract);                       // the evaporator sits in its exhaust lane
(function(){
  var ML=MX1-MX0, t2=0.12;
  var gm=std(T.metal.clone(),{m:0.62,r:0.34,t:true,o:0.20,side:THREE.DoubleSide,dw:false});
  modUnit.add(at(box(ML,MH,0.06,gm.clone()),MXC,MY,MZ+MD/2));
  modUnit.add(at(box(ML,MH,0.06,gm.clone()),MXC,MY,MZ-MD/2));
  modUnit.add(at(box(ML,0.06,MD,gm.clone()),MXC,MY+MH/2,MZ));
  modUnit.add(at(box(ML,0.06,MD,gm.clone()),MXC,MY-MH/2,MZ));
  [[MY-MH/2,MZ-MD/2],[MY-MH/2,MZ+MD/2],[MY+MH/2,MZ-MD/2],[MY+MH/2,MZ+MD/2]].forEach(function(p){
    modUnit.add(at(box(ML,t2,t2,M.frame),MXC,p[0],p[1])); });
  [[MX0,MZ-MD/2],[MX0,MZ+MD/2],[MX1,MZ-MD/2],[MX1,MZ+MD/2]].forEach(function(p){
    modUnit.add(at(box(t2,MH,t2,M.frame),p[0],MY,p[1])); });
  [[MX0,MY-MH/2],[MX0,MY+MH/2],[MX1,MY-MH/2],[MX1,MY+MH/2]].forEach(function(p){
    modUnit.add(at(box(t2,t2,MD,M.frame),p[0],p[1],MZ)); });

  // the two lanes are separated either side of the core, which is what makes the X crossing
  var dm=std(T.metal.clone(),{m:0.4,r:0.6,t:true,o:0.45,side:THREE.DoubleSide});
  modUnit.add(at(box((MXC-1.5)-MX0,MH-0.2,0.05,dm),(MX0+(MXC-1.5))/2,MY,MZ));
  modUnit.add(at(box(MX1-(MXC+1.5),MH-0.2,0.05,dm),((MXC+1.5)+MX1)/2,MY,MZ));

  // non-contact crossflow core, set on the diagonal (same look as the first design). The plates are
  // copper (Cu-ETP), polished to a surface roughness Ra ≤ 0.8 µm: smooth and cleanable, nothing sticks.
  // They stack horizontally: one stream takes the odd layers, the other the even layers, so the
  // exhaust never touches the fresh air; it only pre-cools / pre-heats it through the plates.
  var coreG=new THREE.Group();
  var cm=std(T.glass.clone(),{m:0.55,r:0.4,t:true,o:0.40,side:THREE.DoubleSide});
  for(var i=0;i<11;i++) coreG.add(at(box(2.2,0.035,2.2,cm),0,-0.95+i*0.19,0));
  coreG.add(at(box(2.2,MH-0.5,2.2,std(T.glass.clone(),{m:0.3,r:0.6,t:true,o:0.10,side:THREE.DoubleSide,dw:false})),0,0,0));
  coreG.rotation.y=Math.PI/4; at(coreG,MXC,MY,MZ); tag(coreG,'Cu plate core (Ra ≤ 0.8 µm)'); modUnit.add(coreG);
  explodables.push({obj:coreG,dir:new THREE.Vector3(0,1,0),base:new THREE.Vector3(MXC,MY,MZ),scale:2.6});
  labels.push({text:'Cu plate core',sub:'copper plates · Ra ≤ 0.8 µm · no air contact',
    anchor:new THREE.Vector3(MXC,MY+1.2,MZ),off:new THREE.Vector3(0,2.0,-1.0)});

  // inlet filters, one on each incoming lane
  function modFilter(x,z,label){
    var g=new THREE.Group();
    g.add(at(box(0.10,MH-0.5,1.45,M.frame),x-0.13,0,0));
    for(var i=0;i<9;i++){
      var p=at(box(0.22,0.15,1.35,M.filter),x,-0.62+i*0.155,0);
      p.rotation.z=(i%2?1:-1)*0.5; g.add(p);
    }
    g.add(at(box(0.10,MH-0.5,1.45,M.frame),x+0.13,0,0));
    at(g,0,MY,z); tag(g,label); modUnit.add(g);
    explodables.push({obj:g,dir:new THREE.Vector3(0,1,0),base:new THREE.Vector3(0,MY,z),scale:2.2});
    labels.push({text:label,sub:'ISO Coarse panel',tier:'aux',
      anchor:new THREE.Vector3(x,MY,z),off:new THREE.Vector3(0,1.7,-0.9)});
  }
  modFilter(MX0+1.5, MZU, 'Fresh-air filter');
  modFilter(MX1-1.5, MZU, 'Exhaust filter');

  // the two fans, both on the leaving lanes, as on the reference unit
  function modFan(x,z,dirSign,label){
    var g=new THREE.Group(), rotor=new THREE.Group();
    var hub=new THREE.Mesh(new THREE.CylinderGeometry(0.18,0.18,0.36,16),M.frame);
    hub.rotation.z=Math.PI/2; rotor.add(hub);
    var bm=std(T.metal.clone(),{m:0.65,r:0.35,side:THREE.DoubleSide});
    for(var i=0;i<9;i++){
      var a=i/9*Math.PI*2, b=box(0.18,0.62,0.05,bm);
      b.position.set(0,Math.cos(a)*0.44,Math.sin(a)*0.44);
      b.rotation.x=-a; b.rotateY(0.55*dirSign); rotor.add(b);
    }
    g.add(rotor); spinners.push({obj:rotor,axis:'x',rate:dirSign*5.0,id:label});
    var ring=new THREE.Mesh(new THREE.TorusGeometry(0.74,0.045,8,28),M.frame);
    ring.rotation.y=Math.PI/2; at(ring,-dirSign*0.4,0,0); g.add(ring);
    g.add(at(box(0.34,0.3,0.3,M.frame),dirSign*0.38,0,0));
    at(g,x,MY,z); tag(g,label); modUnit.add(g);
    explodables.push({obj:g,dir:new THREE.Vector3(dirSign,0.5,0).normalize(),
      base:new THREE.Vector3(x,MY,z),scale:2.2});
    labels.push({text:label,sub:'EC fan',
      anchor:new THREE.Vector3(x,MY,z),off:new THREE.Vector3(dirSign*0.8,-1.7,-0.9)});
  }
  modFan(MX1-1.5, MZL,  1, 'Tempered-air fan');
  modFan(MX0+1.4, MZL, -1, 'FAN-103 exhaust fan');

  // control box and power feed, drawn on top as on the reference
  modUnit.add(tag(at(box(1.1,0.55,0.8,M.frame),MXC+2.2,MY+MH/2+0.3,MZ+0.4),'Recovery unit control box'));
  modUnit.add(at(new THREE.Mesh(new THREE.CylinderGeometry(0.05,0.05,1.0,10),M.frame),MXC+3.1,MY+MH/2+0.5,MZ+0.4));
  labels.push({text:'Recovery unit control',sub:'interlocked with the AHU',tier:'aux',
    anchor:new THREE.Vector3(MXC+2.2,MY+MH/2+0.3,MZ+0.4),off:new THREE.Vector3(1.9,1.4,-0.6)});

  // spigots at both ends
  [[MX0-0.5,MZU],[MX0-0.5,MZL],[MX1+0.5,MZU],[MX1+0.5,MZL]].forEach(function(p){
    modUnit.add(tag(at(box(1.0,MH-0.6,1.5,M.duct),p[0],MY,p[1]),'Recovery unit spigot'));
  });

  labels.push({text:'Heat-recovery air-pump unit',sub:'the only exhaust path · non-contact pre-cooling',
    anchor:new THREE.Vector3(MXC,MY+MH/2,MZ),off:new THREE.Vector3(-3.4,2.9,-1.2)});
})();

/* --- refrigerant pipework --- */
var refrig=new THREE.Group(), refrigCurves=[];
(function(){
  function run(points,r){
    var cv=new THREE.CatmullRomCurve3(points.map(function(p){return new THREE.Vector3(p[0],p[1],p[2]);}));
    refrig.add(new THREE.Mesh(new THREE.TubeGeometry(cv,72,r||0.075,10,false),M.refrig));
    refrigCurves.push(cv); return cv;
  }
  var zf=Z1+0.35;
  run([[-6.2,Y0-0.45,0.35],[-6.2,Y0-0.30,zf],[-4.6,Y0-0.15,zf],[-2.6,Y0-0.6,zf],[-0.9,YS-1.2,zf],[-0.9,YS,Z1-0.1]]);
  run([[-0.9,YS+0.4,Z1-0.1],[-0.2,YS+0.6,zf],[0.6,Y0-0.9,zf],[1.9,YS-1.3,zf],[1.9,YS,Z1-0.1]]);
  // liquid line: coils → liquid receiver → filter-drier → sight glass → EEV → the recovery unit's exhaust coil
  run([[3.8,YS,Z1-0.1],[3.0,YS-1.3,zf],[0.9,Y0-1.3,zf],[-0.7,Y0-1.35,zf],[-1.7,Y0-1.45,zf],[-2.45,Y0-1.47,zf],[-3.2,Y0-1.5,zf],
       [-7.6,Y0-1.3,0.4],[-10.5,Y0-0.9,-3.4],[-14.5,MY-1.0,-6.6],[-17.3,MY-0.9,MZL+0.5],[-17.3,MY,MZL+0.4]]);
  // suction line back from the recovery unit, through the suction accumulator, to the compressor
  run([[-17.3,MY+0.5,MZL+0.4],[-19.8,MY+0.4,-6.4],[-15.0,MY-1.3,-4.2],
       [-9.4,Y0-1.4,-1.4],[-8.3,Y0-1.55,1.3],[-7.3,Y0-1.2,zf],[-6.7,Y0-0.5,1.3],[-6.2,Y0-0.45,0.35]],0.09);
  refrig.add(at(box(0.34,0.34,0.34,M.frame),-3.2,Y0-1.5,zf));
  labels.push({text:'Electronic expansion valve', sub:'superheat control', tier:'aux',
    anchor:new THREE.Vector3(-3.2,Y0-1.5,zf), off:new THREE.Vector3(0.4,-1.1,0.9)});

  /* Where the refrigerant comes from and where it is kept. The R32 is weighed in through the Schrader
     charging ports at commissioning (design charge ≈ 40 g) and never vented. While running, the liquid
     receiver holds the surplus liquid, and the suction accumulator catches liquid that the evaporator
     has not boiled off (mode change, defrost) so the compressor only takes in vapour. For service the
     charge is pumped down into the receiver, or recovered into a recovery cylinder. */
  var shell=std(new THREE.Color('#3d4650'),{m:0.55,r:0.45}), brass=std(new THREE.Color('#b8923a'),{m:0.85,r:0.3});
  function vessel(name,x,y,z,r,h){
    var g=new THREE.Group(); tag(g,name);
    g.add(at(new THREE.Mesh(new THREE.CylinderGeometry(r,r,h,24),shell),x,y,z));
    [1,-1].forEach(function(sg){ var cap=new THREE.Mesh(new THREE.SphereGeometry(r,24,12,0,Math.PI*2,0,Math.PI/2),shell);
      if(sg<0) cap.rotation.x=Math.PI; at(cap,x,y+sg*h/2,z); g.add(cap); });
    return g;
  }
  // liquid receiver, with its rotalock outlet valve and a level sight glass
  var rcv=vessel('R32 liquid receiver',-0.7,Y0-1.3,zf,0.3,0.8);
  rcv.add(at(new THREE.Mesh(new THREE.CylinderGeometry(0.11,0.11,0.32,12),brass),-0.7,Y0-0.66,zf));
  var lvl=new THREE.Mesh(new THREE.CylinderGeometry(0.09,0.09,0.05,16),std(new THREE.Color('#9fd8f5'),{m:0.1,r:0.1,e:0x1d5f86,ei:0.6}));
  lvl.rotation.x=Math.PI/2; at(lvl,-0.7,Y0-1.42,zf+0.3); rcv.add(lvl);
  refrig.add(rcv);
  // suction accumulator (U-tube inside), between the 4-way valve and the compressor suction
  refrig.add(vessel('R32 suction accumulator',-7.3,Y0-1.2,zf,0.34,0.9));
  // bi-flow filter-drier and sight glass with moisture indicator, ahead of the EEV
  var dr=new THREE.Group(); tag(dr,'R32 filter-drier (bi-flow)');
  var drb=new THREE.Mesh(new THREE.CylinderGeometry(0.14,0.14,0.62,16),M.copper); drb.rotation.z=Math.PI/2; at(drb,-1.7,Y0-1.45,zf); dr.add(drb);
  refrig.add(dr);
  var sg=new THREE.Group(); tag(sg,'R32 sight glass + moisture indicator');
  sg.add(at(new THREE.Mesh(new THREE.CylinderGeometry(0.13,0.13,0.22,16),brass),-2.45,Y0-1.47,zf));
  var eye=new THREE.Mesh(new THREE.CylinderGeometry(0.085,0.085,0.04,16),std(new THREE.Color('#22c55e'),{m:0.1,r:0.2,e:0x0b5a24,ei:0.8}));
  eye.rotation.x=Math.PI/2; at(eye,-2.45,Y0-1.47,zf+0.13); sg.add(eye);
  refrig.add(sg);
  // Schrader charging / service ports: liquid side on the receiver outlet, suction side at the accumulator inlet
  [['R32 charging port (liquid side)',-1.15,Y0-1.38],['R32 charging port (suction side)',-7.85,Y0-1.42]].forEach(function(c){
    var g=new THREE.Group(); tag(g,c[0]);
    g.add(at(new THREE.Mesh(new THREE.CylinderGeometry(0.06,0.06,0.34,10),brass),c[1],c[2]+0.17,zf));
    g.add(at(new THREE.Mesh(new THREE.CylinderGeometry(0.085,0.085,0.12,12),std(new THREE.Color('#1d4ed8'),{m:0.3,r:0.5})),c[1],c[2]+0.38,zf));  // cap
    refrig.add(g);
  });
  labels.push({text:'Liquid receiver', sub:'stores the R32 charge · pump-down vessel',
    anchor:new THREE.Vector3(-0.7,Y0-0.95,zf), off:new THREE.Vector3(0.9,-1.6,1.5)});
  labels.push({text:'Suction accumulator', sub:'catches liquid · protects the compressor',
    anchor:new THREE.Vector3(-7.3,Y0-0.8,zf), off:new THREE.Vector3(-1.2,-1.7,1.5)});
  labels.push({text:'Filter-drier + sight glass', sub:'bi-flow · moisture indicator', tier:'aux',
    anchor:new THREE.Vector3(-2.1,Y0-1.45,zf), off:new THREE.Vector3(-0.2,-1.9,1.2)});
  labels.push({text:'Charging ports', sub:'Schrader valves · R32 weighed in here', tier:'aux',
    anchor:new THREE.Vector3(-1.15,Y0-1.0,zf), off:new THREE.Vector3(1.6,-0.6,1.0)});
  tag(refrig,'R32 refrigerant pipework'); unit.add(refrig);
})();

/* earlier-model labels live in model units; flag them so they are mapped to the world */
labels.forEach(function(l){ l.space='c'; });
/* ===================================================================== RIG */
var rig=new THREE.Group(); rig.userData.asm='Rig'; scene.add(rig);
var BX=50, BY=50, BZ=25, TH=0.5;                 // outer half-length, height, half-depth, acrylic
function W(x,y,z){ return new THREE.Vector3(x,y,z); }

/* -------------------------------------------------------- materials */
var MR={
  acrylic: new THREE.MeshStandardMaterial({color:T.acrylic.clone(),metalness:0,roughness:0.08,
    transparent:true,opacity:0.12,side:THREE.DoubleSide,depthWrite:false}),
  acrylicEdge: new THREE.LineBasicMaterial({color:T.acrylic.clone(),transparent:true,opacity:0.85}),
  pvc: new THREE.MeshStandardMaterial({color:T.metal.clone(),metalness:0.1,roughness:0.25,
    transparent:true,opacity:0.20,side:THREE.DoubleSide,depthWrite:false}),
  alu: std(new THREE.Color('#2b3137'),{m:0.7,r:0.4}),
  steel: std(new THREE.Color('#c9d1d8'),{m:0.85,r:0.28}),
  white: std(new THREE.Color('#eef1f4'),{m:0.1,r:0.55}),
  blue: std(new THREE.Color('#2e6db4'),{m:0.45,r:0.4}),
  black: std(new THREE.Color('#15191d'),{m:0.3,r:0.6}),
  pcb: std(T.pcb.clone(),{m:0.15,r:0.55}),
  copper: std(T.copper.clone(),{m:0.85,r:0.3}),
  chip: std(new THREE.Color('#1c1f22'),{m:0.2,r:0.5}),
  term: std(new THREE.Color('#1f8a4c'),{m:0.1,r:0.6}),
  screen: new THREE.MeshBasicMaterial({color:0xffffff}),
  led: new THREE.MeshBasicMaterial({color:0xf3f7ff})
};

/* ------------------------------------------------- acrylic enclosure */
var box3d=new THREE.Group(); box3d.userData.asm='Acrylic enclosure'; rig.add(box3d);
var wallParts=[];
function wall(name,w,h,d,x,y,z,dir){
  var m=new THREE.Mesh(new THREE.BoxGeometry(w,h,d),MR.acrylic); at(m,x,y,z); tag(m,name);
  m.renderOrder=1;
  var e=new THREE.LineSegments(new THREE.EdgesGeometry(m.geometry),MR.acrylicEdge); m.add(e);
  box3d.add(m); wallParts.push({obj:m,dir:dir,base:m.position.clone()});
  return m;
}
wall('Acrylic base plate',2*BX,TH,2*BZ, 0,TH/2,0, W(0,-1,0));
wall('Acrylic roof',2*BX,TH,2*BZ, 0,BY-TH/2,0, W(0,1,0));
wall('Acrylic back wall',2*BX,BY-2*TH,TH, 0,BY/2,-BZ+TH/2, W(0,0,-1));
wall('Acrylic front wall',2*BX,BY-2*TH,TH, 0,BY/2,BZ-TH/2, W(0,0,1));
wall('Acrylic left wall (outdoor side)',TH,BY-2*TH,2*BZ-2*TH, -BX+TH/2,BY/2,0, W(-1,0,0));
wall('Acrylic right wall',TH,BY-2*TH,2*BZ-2*TH, BX-TH/2,BY/2,0, W(1,0,0));
var partition=wall('Acrylic partition wall',TH,BY-2*TH,2*BZ-2*TH, 0,BY/2,0, W(0,0,0));
var CEIL=40;                                         // clean-room false ceiling (underside)
wall('Clean-room false ceiling',BX-TH*1.5,TH,2*BZ-2*TH, (BX-TH/2+TH/2)/2,CEIL+TH/2,0, W(0,0.6,0));

/* aluminium base frame + levelling feet */
(function base(){
  var g=new THREE.Group(); tag(g,'Aluminium base frame'); g.userData.asm='Acrylic enclosure';
  [[0,-BZ+1],[0,BZ-1]].forEach(function(p){ g.add(at(box(2*BX,2,2,MR.alu),p[0],-1,p[1])); });
  [[-BX+1,0],[0,0],[BX-1,0]].forEach(function(p){ g.add(at(box(2,2,2*BZ-4,MR.alu),p[0],-1,p[1])); });
  [[-BX+2,-BZ+2],[-BX+2,BZ-2],[BX-2,-BZ+2],[BX-2,BZ-2]].forEach(function(p){
    g.add(at(new THREE.Mesh(new THREE.CylinderGeometry(1.6,1.9,1.2,20),MR.black),p[0],-2.6,p[1]));
  });
  rig.add(g);
})();

/* floor grid + soft contact shadow: the same look as the earlier simulators (display only, not exported) */
var floorGrid;
(function floor(){
  var cv=document.createElement('canvas'); cv.width=cv.height=256;
  var ctx=cv.getContext('2d'), gr=ctx.createRadialGradient(128,128,10,128,128,126);
  gr.addColorStop(0,'rgba(0,0,0,0.42)'); gr.addColorStop(1,'rgba(0,0,0,0)');
  ctx.fillStyle=gr; ctx.fillRect(0,0,256,256);
  var sh=new THREE.Mesh(new THREE.PlaneGeometry(160,80),new THREE.MeshBasicMaterial({map:new THREE.CanvasTexture(cv),transparent:true,depthWrite:false}));
  sh.rotation.x=-Math.PI/2; sh.position.set(0,-3.18,0); sh.userData.noExport=true; scene.add(sh);
  floorGrid=new THREE.GridHelper(480,48,T.floor.clone(),T.floor.clone());
  floorGrid.material.vertexColors=false; floorGrid.material.color=T.floor.clone();
  floorGrid.material.transparent=true; floorGrid.material.opacity=0.35;
  floorGrid.position.y=-3.25; floorGrid.userData.noExport=true; scene.add(floorGrid);
})();

/* clean-room door on the front face */
(function door(){
  var g=new THREE.Group(); tag(g,'Clean-room access door'); g.userData.asm='Acrylic enclosure';
  var z=BZ+0.05, x0=30, x1=48, y0=3, y1=37;          // the pass box and the staging bench take the wall to its left
  var dm=new THREE.LineBasicMaterial({color:T.metalDark.clone(),transparent:true,opacity:0.9});
  g.add(new THREE.Line(new THREE.BufferGeometry().setFromPoints([W(x0,y0,z),W(x1,y0,z),W(x1,y1,z),W(x0,y1,z),W(x0,y0,z)]),dm));
  [y0+5,y1-5].forEach(function(y){
    var h=new THREE.Mesh(new THREE.CylinderGeometry(0.45,0.45,4,12),MR.steel); at(h,x0+0.4,y,z+0.4); g.add(h);
  });
  var hd=at(box(0.8,6,0.8,MR.steel),x1-2.5,(y0+y1)/2,z+1.1); g.add(hd);
  g.add(at(box(0.6,0.6,1.0,MR.steel),x1-2.5,(y0+y1)/2+2.4,z+0.5));
  g.add(at(box(0.6,0.6,1.0,MR.steel),x1-2.5,(y0+y1)/2-2.4,z+0.5));
  rig.add(g);
})();

/* ------------------------------------------------------------- ducts */
var rigDucts=new THREE.Group(); rigDucts.userData.asm='Ductwork'; rig.add(rigDucts);
function roundedPath(pts,bend){
  var cp=new THREE.CurvePath(), v=pts.map(function(p){return W(p[0],p[1],p[2]);});
  var cur=v[0].clone();
  for(var i=1;i<v.length;i++){
    var a=v[i-1], b=v[i], c=v[i+1];
    if(!c){ cp.add(new THREE.LineCurve3(cur.clone(),b.clone())); break; }
    var d1=b.clone().sub(a), d2=c.clone().sub(b);
    var r=Math.min(bend, d1.length()*0.45, d2.length()*0.45);
    var p1=b.clone().sub(d1.normalize().multiplyScalar(r)), p2=b.clone().add(d2.normalize().multiplyScalar(r));
    if(cur.distanceTo(p1)>1e-3) cp.add(new THREE.LineCurve3(cur.clone(),p1));
    cp.add(new THREE.QuadraticBezierCurve3(p1,b.clone(),p2));
    cur=p2;
  }
  return cp;
}
/* Every air duct is rectangular. r is the round duct the airflow was sized for (calculations §11):
   the rectangle w × h = 2.2 r × 1.55 r has the same friction loss (Huebscher equivalent diameter
   De = 1.30 (w h)^0.625 / (w + h)^0.25 ≈ 2 r). Each straight run is one box section; sections overlap
   at the corners like mitred elbows. Width stays horizontal, height vertical; a vertical run keeps
   the width of the run before it. */
var DUCT_W=2.2, DUCT_H=1.55;
function duct(name,pts,r,mat,group,bend,wh){
  var w=wh?wh[0]:DUCT_W*r, h=wh?wh[1]:DUCT_H*r, e=Math.max(w,h)/2;     // wh: an explicit section where space is tight
  var g=new THREE.Group(); tag(g,name);
  var v=pts.map(function(p){ return W(p[0],p[1],p[2]); });
  var side=null, k;
  for(k=0;k<v.length-1;k++){ var d0=v[k+1].clone().sub(v[k]).normalize(); if(Math.abs(d0.y)<0.9){ side=W(d0.z,0,-d0.x).normalize(); break; } }
  if(!side) side=W(0,0,1);
  var edgeMat=new THREE.LineBasicMaterial({color:T.metalDark.clone(),transparent:true,opacity:0.5});
  for(k=0;k<v.length-1;k++){
    var a=v[k], b=v[k+1], dv=b.clone().sub(a), L=dv.length(); if(L<1e-3) continue;
    var n=dv.clone().divideScalar(L), ax;
    if(Math.abs(n.y)<0.9){ ax=W(n.z,0,-n.x).normalize(); side=ax.clone(); } else ax=side.clone();
    var ay=new THREE.Vector3().crossVectors(n,ax).normalize();
    var e0=k>0?e:0, e1=k<v.length-2?e:0;
    var sec=new THREE.Mesh(new THREE.BoxGeometry(w,h,L+e0+e1),mat||MR.pvc);
    sec.quaternion.setFromRotationMatrix(new THREE.Matrix4().makeBasis(ax,ay,n));
    sec.position.copy(a).addScaledVector(n,(L+e1-e0)/2);
    sec.userData.cad={type:'rseg',wall:0.15};
    if(!g.children.length) sec.userData.cad.duct={pts:pts.map(function(p){ return [p[0],p[1],p[2]]; }),r:r,w:w,h:h};   // centre line for the calculations
    sec.renderOrder=2; sec.add(new THREE.LineSegments(new THREE.EdgesGeometry(sec.geometry),edgeMat));
    g.add(sec);
  }
  g.userData.curve=roundedPath(pts,bend||r*1.6); g.userData.r=r; g.userData.rect=[w,h];   // reused by the duct-airflow layer
  (group||rigDucts).add(g);
  return g;
}
function rectDuct(name,w,h,d,x,y,z){
  var m=at(box(w,h,d,MR.pvc),x,y,z); m.renderOrder=2; tag(m,name);
  var e=new THREE.LineSegments(new THREE.EdgesGeometry(m.geometry),
    new THREE.LineBasicMaterial({color:T.metalDark.clone(),transparent:true,opacity:0.55}));
  m.add(e); rigDucts.add(m); return m;
}
function flangeRing(name,x,y,z,r,axis){             // rectangular wall sleeve flange around a duct
  var w=DUCT_W*r+0.5, h=DUCT_H*r+0.5, t=0.4, g=new THREE.Group(); tag(g,name);
  g.add(at(box(t,t,w+2*t,MR.steel),0,h/2+t/2,0)); g.add(at(box(t,t,w+2*t,MR.steel),0,-h/2-t/2,0));
  g.add(at(box(t,h,t,MR.steel),0,0,w/2+t/2)); g.add(at(box(t,h,t,MR.steel),0,0,-w/2-t/2));
  if(axis==='y') g.rotation.z=Math.PI/2; else if(axis==='z') g.rotation.y=Math.PI/2;
  at(g,x,y,z); rigDucts.add(g); return g;
}

var MBIBO={bag:std(new THREE.Color('#e8f2f8'),{m:0,r:0.35,t:true,o:0.45,side:THREE.DoubleSide,dw:false}),
  pack:std(new THREE.Color('#e9edf1'),{m:0.05,r:0.9}), ring:std(new THREE.Color('#9aa7b2'),{m:0.85,r:0.3})};
/* key world points from the earlier model */
var P_AHU_OA = C2W(-13.4,YS,0), P_AHU_SUP=C2W(13.4,YS,0);
var P_HR_EXIN=C2W(MX1+0.5,MY,MZU);                     // the air-pump unit's exhaust inlet spigot (the only exhaust path)
var P_HR_TOUT=C2W(MX1+0.5,MY,MZL);                     // … and its tempered fresh-air outlet spigot
var TEMPR=[[P_HR_TOUT.x,P_HR_TOUT.y,P_HR_TOUT.z],[-24.8,P_HR_TOUT.y,P_HR_TOUT.z],[-24.8,P_HR_TOUT.y,-1.0],[-34.6,P_HR_TOUT.y,-1.0],[-34.6,P_AHU_OA.y,2.6]];
var P_HR_FRESH=C2W(MX0-1.0,MY,MZU), P_HR_EXH=C2W(MX0-1.0,MY,MZL);
/* outer HEPA on its own floor stand at the front-right of the plant room, next to the common exhaust stack;
   the stack takes both exhausts (FAN-103 normal, FAN-103B bypass), each through a backdraft damper */
var BYP={y:22, z:-5.415, x0:-42.4, x1:-36, fx:-43.6, rx:-46.4, ty:40, sx:-7.5, sz:10, top:57, jy:45};
var EXR=[[P_HR_EXH.x+0.1,P_HR_EXH.y,P_HR_EXH.z],[-48.4,P_HR_EXH.y,P_HR_EXH.z],[-48.4,P_HR_EXH.y,-21],[-48.4,BYP.jy,-21],
         [BYP.sx,BYP.jy,-21],[BYP.sx,BYP.jy,BYP.sz-0.8]];
var HX=-46.5, HY=11;                                   // fresh-air header line
var COMP={x:-42.5,y:22,z:-14};                         // fresh-air compressor (volute centre)

/* fresh-air header: compressor → recovery air-pump unit + AHU */
duct('Compressor discharge',[[COMP.x,17.6,-11.3],[COMP.x,13.6,-11.3],[COMP.x-2.6,HY,-11.3],[HX+0.2,HY,-11.3]],1.1);
duct('Fresh-air header',[[HX,HY,-12.4],[HX,HY,3.4]],1.15);
/* the air-pump unit's lanes now carry all the fresh air and all the exhaust: tall, narrow sections that fit
   its spigots (1.6 × 2.2 cm), so the velocity stays near 5 m/s */
var LANE=[1.6,2.2];
duct('Header → recovery unit (fresh lane)',[[HX,HY,P_HR_FRESH.z],[HX,P_HR_FRESH.y,P_HR_FRESH.z],[P_HR_FRESH.x-0.2,P_HR_FRESH.y,P_HR_FRESH.z]],0.75,null,null,null,LANE);
duct('Core bypass: header → AHU (baseline test)',[[HX,HY,P_AHU_OA.z],[HX,P_AHU_OA.y,P_AHU_OA.z],[P_AHU_OA.x+0.3,P_AHU_OA.y,P_AHU_OA.z]],1.0);
/* the connections the earlier model drew only as air: recovery unit → AHU, and the exhaust run */
(function transfer(){
  var LNr=0.62;
  function cduct(name,pts,r,wh){
    var w=pts.map(function(p){ var v=C2W(p[0],p[1],p[2]); return [v.x,v.y,v.z]; });
    return duct(name,w,r*K,null,null,null,wh);
  }
  /* tempered air leaves the unit, runs towards the partition first, then behind the AHU to its intake,
     so it never crosses the exhaust inlet */
  duct('Tempered-air duct: recovery unit → AHU',TEMPR,LNr*K,null,null,null,LANE);
  /* the air-pump unit's exhaust no longer leaves through the outdoor wall next to the fresh-air intake:
     it climbs in the back-left corner, runs along the top of the plant room and joins the common roof
     stack at the front-right, as far from the intake as the room allows */
  duct('Exhaust: air-pump unit → roof stack',EXR,0.6*K,null,null,null,LANE);
})();
/* supply: AHU supply connection → boot → riser → through the partition → ceiling void */
var RZ=8.5, RX=-4.5, RY=44.5;
rectDuct('Supply boot',3.0,2.32,8.7, -4.5,P_AHU_SUP.y,5.7);
/* the riser feeds the bag-in/bag-out supply terminals: ceiling terminal 1, the LAF hood over the filler, and
   ceiling terminals 2 + 3 above and just behind the operator (down-flow over the operator to exhaust terminal 3) */
var LAF={x0:25.6,x1:35.4,z0:-15.4,z1:7.4,y0:24,y1:27.6};       // unidirectional-flow hood over the filler
var CT={x:44.5, z:[-5.2,3.2], a:7.2, tx:39.5};                  // ceiling terminals 2 + 3: centre x, centre z's, face size, riser tee
duct('Supply riser',[[RX,P_AHU_SUP.y+1.1,RZ],[RX,RY,RZ],[0.6,RY,RZ],[8,RY,RZ],[8,RY,0],[CT.tx,RY,0]],1.4);
duct('Terminal drop 1 (ceiling)',[[14,RY,0],[14,CEIL+1.4,0]],1.0);
duct('LAF supply drop',[[30.5,RY,0],[30.5,RY-1.4,-4],[30.5,LAF.y1+0.2,-4]],1.1);
CT.z.forEach(function(z,i){                                      // tee at the end of the riser, one drop per terminal
  duct('Terminal drop '+(i+2)+' (ceiling, above the operator)',[[CT.tx,RY,0],[CT.tx,RY,z],[CT.x,RY,z],[CT.x,CEIL+1.4,z]],0.85);
});
flangeRing('Partition sleeve: supply',0,RY,RZ,1.4,'x');
/* exhaust: low-level BIBO HEPA exhaust terminals in the partition → collector → PT-102 → DV-101 →
   straight to the air-pump unit (Cu core). Nothing goes back to the AHU. */
var GRILLE=[[6.9,3],[6.9,-13]];                                // low-level exhaust terminals in the partition: centre y, z
var T3={y:4.15, z:-1, hx:51.3, dz:-26.3};                       // exhaust terminal 3: low on the right wall, behind the operator;
                                                                // its BIBO housing sits outside the wall (x hx), its duct runs outside the back wall (z dz)
var EXY=11, EXZ=P_HR_EXIN.z, DVX=-23.5;                          // exhaust main height, line, diverter position
duct('Exhaust collector A (behind the partition)',[[-1.75,9.6,GRILLE[0][1]],[-1.75,EXY,GRILLE[0][1]],[-1.75,EXY,EXZ-0.9]],0.85);
duct('Exhaust collector B (behind the partition)',[[-1.75,9.6,GRILLE[1][1]],[-1.75,EXY,GRILLE[1][1]],[-1.75,EXY,EXZ+0.9]],0.85);
duct('Exhaust collector C (right wall, behind the operator)',[[T3.hx,T3.y,T3.z-3.5],[T3.hx,T3.y,T3.dz],[-1.75,T3.y,T3.dz],[-1.75,EXY,T3.dz],[-1.75,EXY,GRILLE[1][1]]],0.85);
duct('Exhaust main: clean room → DV-101',[[-1.75,EXY,EXZ],[DVX+1.4,EXY,EXZ]],0.75,null,null,null,LANE);
duct('Exhaust: DV-101 → air-pump unit (Cu core)',[[DVX-1.4,EXY,EXZ],[-27.2,EXY,EXZ],[-27.2,P_HR_EXIN.y,EXZ],[P_HR_EXIN.x+0.45,P_HR_EXIN.y,EXZ]],0.75,null,null,null,LANE);
/* the HEPA bypass climbs from DV-101 and runs to the front of the plant room, towards the partition; the outer
   HEPA, FAN-103B and a vertical stack through the roof sit there, well away from the fresh-air compressor and
   its intake louvre (a contaminated discharge must never be drawn back into the fresh air) */

/* the outer HEPA sits on a shelf beside the fresh-air compressor (both serviced from the outdoor-wall side);
   its discharge still rises and runs to the one roof stack at the front-right, far from the fresh-air intake */
duct('HEPA bypass: DV-101 → outer BIBO HEPA',[[DVX,EXY+1.4,EXZ],[DVX,BYP.y,EXZ],[BYP.x1,BYP.y,BYP.z]],0.75,null,null,null,LANE);
duct('Bypass discharge: FAN-103B → roof stack',[[BYP.fx-1.2,BYP.y,BYP.z],[BYP.rx,BYP.y,BYP.z],[BYP.rx,BYP.ty,BYP.z],[BYP.sx,BYP.ty,BYP.z],
  [BYP.sx,BYP.ty,BYP.sz],[BYP.sx,BYP.top,BYP.sz]],0.75,null,null,null,LANE);
flangeRing('Roof sleeve: common exhaust stack',BYP.sx,BY-TH/2,BYP.sz,0.75,'y');
/* contaminated-exhaust protection: PT-102 watches the exhaust on its way to the air pump; if it carries
   particles (a release in the room, or a leaking exhaust-terminal filter) L3 throws DV-101 and the exhaust
   goes through the outer BIBO HEPA (police filter) and FAN-103B to outdoors, never through the Cu core.
   DV-101 is spring return: with no power it rests on the HEPA bypass (fail-safe). */
var exhSafe=new THREE.Group(); exhSafe.userData.asm='Exhaust safety: PT-102 + DV-101 + outer HEPA'; rig.add(exhSafe);
var DVBLADE;
(function exhaustSafety(){
  var top=EXY+LANE[1]/2;
  var pt=new THREE.Group(); tag(pt,'PT-102 exhaust particle sensor');
  pt.add(at(box(3.0,2.6,2.2,MR.white),-17,top+1.3,EXZ));
  pt.add(at(box(2.0,1.0,0.12,MR.black),-17,top+1.6,EXZ+1.12));
  pt.add(at(new THREE.Mesh(new THREE.CylinderGeometry(0.18,0.18,1.6,10),MR.steel),-17.8,top-0.2,EXZ));     // sample probe into the duct
  exhSafe.add(pt);
  var tt=new THREE.Group(); tag(tt,'TT-107 exhaust air T (DS18B20)');
  tt.add(at(box(0.9,0.9,0.9,MR.white),-14.2,top+0.45,EXZ)); exhSafe.add(tt);
  var dv=new THREE.Group(); tag(dv,'DV-101 diverter damper + spring-return actuator');
  dv.add(at(box(2.8,2.8,2.4,MR.steel),DVX,EXY+0.3,EXZ));
  dv.add(at(box(1.8,1.8,1.3,MR.black),DVX,EXY+0.3,EXZ+2.0));                                              // 24 V spring-return actuator
  dv.add(at(box(0.5,0.5,0.4,std(new THREE.Color('#f59e0b'),{m:0.2,r:0.5})),DVX+0.5,EXY+0.9,EXZ+2.7));     // position indicator
  DVBLADE=at(box(2.4,0.12,1.9,MR.alu),DVX,EXY+0.3,EXZ); dv.add(DVBLADE);
  exhSafe.add(dv);
  bibo('Outer BIBO HEPA housing (H14 police filter)',(BYP.x0+BYP.x1)/2,BYP.y,BYP.z,BYP.x1-BYP.x0,6.0,6.0,'+z',exhSafe);
  var fb=new THREE.Group(); tag(fb,'FAN-103B HEPA-bypass exhaust fan');
  fb.add(at(box(2.4,4.4,4.4,MR.blue),BYP.fx,BYP.y,BYP.z));
  var mo=new THREE.Mesh(new THREE.CylinderGeometry(1.2,1.2,1.6,20),MR.alu); mo.rotation.x=Math.PI/2; at(mo,BYP.fx,BYP.y,BYP.z+3.0); fb.add(mo);
  exhSafe.add(fb);
  var cap=new THREE.Mesh(new THREE.ConeGeometry(2.2,1.4,4),MR.steel); cap.rotation.y=Math.PI/4; at(cap,BYP.sx,BYP.top+1.6,BYP.sz); tag(cap,'Exhaust stack rain cap');
  var st=new THREE.Group(); tag(st,'Outer HEPA wall shelf');                       // on the outdoor wall, beside FAN-101
  st.add(at(box(14,0.5,6.6,MR.alu),-42.2,BYP.y-3.25,BYP.z));
  st.add(at(box(0.5,5.5,6.6,MR.alu),-BX+TH+0.25,BYP.y-5.75,BYP.z));
  var br2=box(0.5,8,0.5,MR.alu); br2.rotation.z=-0.72; at(br2,-BX+3.9,BYP.y-6.6,BYP.z); st.add(br2);
  exhSafe.add(st);
  [['Backdraft damper: normal exhaust',BYP.sx,BYP.jy,BYP.sz-1.6,0],['Backdraft damper: HEPA bypass',BYP.sx-2,BYP.ty,BYP.z,1]].forEach(function(q){
    var g=new THREE.Group(); tag(g,q[0]); g.add(at(box(q[4]?0.5:2.0,2.6,q[4]?2.0:0.5,MR.steel),q[1],q[2],q[3]));
    var bl=box(q[4]?0.1:1.6,1.9,q[4]?1.6:0.1,MR.alu); bl.rotation[q[4]?'z':'x']=0.5; at(bl,q[1],q[2],q[3]); g.add(bl); exhSafe.add(g); });
  exhSafe.add(cap);
})();

/* --------------------------------------------- fresh-air compressor */
var compRotor=new THREE.Group();
(function compressor(){
  var g=new THREE.Group(); tag(g,'FAN-101 fresh-air compressor'); g.userData.asm='Fresh-air compressor';
  var vol=new THREE.Mesh(new THREE.CylinderGeometry(4.2,4.2,3.6,40),MR.blue); vol.rotation.z=Math.PI/2;
  at(vol,COMP.x,COMP.y,COMP.z); g.add(vol);
  // scroll outlet, tangential and downward
  g.add(at(box(3.6,5.6,3.0,MR.blue),COMP.x,COMP.y-3.0,COMP.z+2.75));
  g.add(at(box(3.0,0.5,2.4,MR.steel),COMP.x,COMP.y-5.9,COMP.z+2.75));
  // inlet bell + intake duct to the wall louvre
  var bell=new THREE.Mesh(new THREE.TorusGeometry(2.0,0.45,12,32),MR.steel); bell.rotation.y=Math.PI/2;
  at(bell,COMP.x-2.0,COMP.y,COMP.z); g.add(bell);
  var intake=box(5.0,3.4,3.4,MR.pvc); at(intake,COMP.x-4.5,COMP.y,COMP.z); intake.userData.cad={type:'rseg',wall:0.15}; g.add(intake);
  // motor on the far side
  var mot=new THREE.Mesh(new THREE.CylinderGeometry(2.2,2.2,5.2,28),MR.alu); mot.rotation.z=Math.PI/2;
  at(mot,COMP.x+4.6,COMP.y,COMP.z); g.add(mot);
  for(var i=0;i<6;i++){
    var fn=new THREE.Mesh(new THREE.TorusGeometry(2.2,0.12,6,28),MR.alu); fn.rotation.y=Math.PI/2;
    at(fn,COMP.x+2.8+i*0.75,COMP.y,COMP.z); g.add(fn);
  }
  var cap=new THREE.Mesh(new THREE.CylinderGeometry(1.6,2.2,0.8,28),MR.black); cap.rotation.z=-Math.PI/2;
  at(cap,COMP.x+7.6,COMP.y,COMP.z); g.add(cap);
  g.add(at(box(2.0,1.2,1.6,MR.black),COMP.x+4.6,COMP.y+2.6,COMP.z));          // driver box
  g.add(at(box(3.0,2.3,2.6,MR.alu),COMP.x+4.6,COMP.y-3.35,COMP.z));            // motor foot
  // impeller (spins with the PWM speed)
  for(var b=0;b<10;b++){
    var bl=box(0.3,1.5,0.18,MR.steel), a=b/10*Math.PI*2;
    bl.position.set(0,Math.cos(a)*2.4,Math.sin(a)*2.4); bl.rotation.x=-a; bl.rotateZ(0.5); compRotor.add(bl);
  }
  compRotor.add(at(new THREE.Mesh(new THREE.CylinderGeometry(1.1,1.1,1.2,20),MR.steel),0,0,0));
  compRotor.children[compRotor.children.length-1].rotation.z=Math.PI/2;
  compRotor.position.set(COMP.x+0.4,COMP.y,COMP.z); g.add(compRotor);
  // wall bracket + shelf
  g.add(at(box(14.4,0.5,5.6,MR.alu),-42.3,COMP.y-4.75,COMP.z-1.8));
  g.add(at(box(0.5,6,5.6,MR.alu),-BX+TH+0.25,COMP.y-2.0,COMP.z-1.8));
  var br=box(0.5,9.2,0.5,MR.alu); br.rotation.z=-0.72; at(br,-BX+3.9,COMP.y-8.0,COMP.z-3.8); g.add(br);
  // intake hood on the outside of the left wall
  g.add(at(box(2.6,6.0,6.0,MR.steel),-BX-1.3,COMP.y+0.6,COMP.z));
  g.add(at(box(0.3,4.6,4.6,std(T.metal.clone(),{m:0.6,r:0.5,t:true,o:0.4,side:THREE.DoubleSide})),-BX-2.65,COMP.y,COMP.z));
  rig.add(g);
})();

/* ------------------------------------------------------- clean room */
var clean=new THREE.Group(); clean.userData.asm='Clean room'; rig.add(clean);
var DIFF=[[14,0]];
/* Bag-in/bag-out (BIBO) HEPA housing: stainless body, H14 pack, a clamped filter-change port with its
   PVC change bag on the ring, so a used filter is bagged out without anyone touching it. ax is the
   air direction ('x','y','z'); bag is the side the change port is on ('+x','-z' …). */
function bibo(name,cx,cy,cz,w,h,d,bag,host){
  var g=new THREE.Group(); tag(g,name);
  g.add(at(box(w,h,d,MR.steel),cx,cy,cz));
  var sx=bag[1]==='x'?(bag[0]==='+'?1:-1):0, sy=bag[1]==='y'?(bag[0]==='+'?1:-1):0, sz=bag[1]==='z'?(bag[0]==='+'?1:-1):0;
  var px=cx+sx*(w/2+0.25), py=cy+sy*(h/2+0.25), pz=cz+sz*(d/2+0.25), rr=Math.min(sx?Math.min(h,d):(sy?Math.min(w,d):Math.min(w,h)),6)*0.32;
  var ring=new THREE.Mesh(new THREE.TorusGeometry(rr,0.22,8,28),MBIBO.ring);
  if(sx) ring.rotation.y=Math.PI/2; else if(sy) ring.rotation.x=Math.PI/2;
  at(ring,px,py,pz); g.add(ring);
  var bg=new THREE.Mesh(new THREE.SphereGeometry(rr,18,12),MBIBO.bag); bg.scale.set(sx?1.4:0.95,sy?1.4:0.95,sz?1.4:0.95);
  bg.position.set(px+sx*rr*0.9,py+sy*rr*0.9-(sy?0:rr*0.25),pz+sz*rr*0.9); g.add(bg);
  var lv=box(0.35,0.35,1.6,MBIBO.ring); at(lv,px+sx*0.3+(sx?0:rr+0.6),py+sy*0.3,pz+sz*0.3); g.add(lv);   // clamp lever
  (host||clean).add(g); return g;
}
/* perforated stainless grille (round holes on a square pitch) on every terminal face */
var PERF_TEX=(function(){
  var cv=document.createElement('canvas'); cv.width=cv.height=64; var c=cv.getContext('2d');
  c.fillStyle='#e8edf1'; c.fillRect(0,0,64,64); c.fillStyle='#3a4552';
  for(var i=0;i<4;i++) for(var j=0;j<4;j++){ c.beginPath(); c.arc(8+i*16,8+j*16,4.2,0,Math.PI*2); c.fill(); }
  var t=new THREE.CanvasTexture(cv); t.wrapS=t.wrapT=THREE.RepeatWrapping; t.anisotropy=4; return t;
})();
function hepaFace(name,cx,cy,cz,a,b,normal,host){              // perforated grille seen from the room
  // normal 'x': a = height (y), b = width (z) · 'y': a = x, b = z · 'z': a = x, b = y
  var g=new THREE.Group(); tag(g,name);
  var tex=PERF_TEX.clone(); tex.needsUpdate=true; tex.repeat.set(Math.max(1,a/1.1),Math.max(1,b/1.1));
  var mt=new THREE.MeshStandardMaterial({map:tex,metalness:0.55,roughness:0.4});
  mt.userData.cadColor=new THREE.Color('#d4dbe1');               // the CAD export keeps a plain stainless colour
  var plate=normal==='x'?box(0.3,a,b,mt):(normal==='y'?box(a,0.3,b,mt):box(a,b,0.3,mt));
  g.add(at(plate,cx,cy,cz));
  var fr=0.5, fm=MR.steel;                                         // frame
  if(normal==='y'){ g.add(at(box(a+fr,0.4,fr,fm),cx,cy,cz-b/2)); g.add(at(box(a+fr,0.4,fr,fm),cx,cy,cz+b/2));
    g.add(at(box(fr,0.4,b,fm),cx-a/2,cy,cz)); g.add(at(box(fr,0.4,b,fm),cx+a/2,cy,cz)); }
  else if(normal==='x'){ g.add(at(box(0.4,fr,b+fr,fm),cx,cy-a/2,cz)); g.add(at(box(0.4,fr,b+fr,fm),cx,cy+a/2,cz));
    g.add(at(box(0.4,a,fr,fm),cx,cy,cz-b/2)); g.add(at(box(0.4,a,fr,fm),cx,cy,cz+b/2)); }
  (host||clean).add(g); return g;
}
/* ceiling terminal 1: H14 BIBO housing in the ceiling void, filter face flush with the false ceiling */
DIFF.forEach(function(d,i){
  bibo('Ceiling BIBO HEPA terminal '+(i+1)+' (H14)',d[0],CEIL+2.2,d[1],8.6,3.6,8.6,'+z');
  hepaFace('Ceiling terminal '+(i+1)+' face screen',d[0],CEIL-0.15,d[1],8.6,8.6,'y');
});
/* LAF hood over the vial filler: unidirectional down-flow, H14 BIBO pack, fed with 100 % fresh air from
   the riser (no fan, no recirculation); clear PVC skirts guide the first air down to the RABS */
(function lafHood(){
  var cx=(LAF.x0+LAF.x1)/2, cz=(LAF.z0+LAF.z1)/2, w=LAF.x1-LAF.x0, d=LAF.z1-LAF.z0;
  bibo('LAF hood: H14 BIBO filter housing',cx,(LAF.y0+LAF.y1)/2,cz,w,LAF.y1-LAF.y0,d,'-z');
  hepaFace('LAF hood: perforated outlet screen',cx,LAF.y0-0.15,cz,w-0.6,d-0.6,'y');
  var g=new THREE.Group(); tag(g,'LAF hood: PVC skirts + hangers');
  var sk=std(new THREE.Color('#dbeef7'),{m:0.05,r:0.05,t:true,o:0.18,side:THREE.DoubleSide,dw:false});
  var sh=4.4, sy=LAF.y0-sh/2-0.3;
  [[cx,LAF.z0,w,0.15],[cx,LAF.z1,w,0.15]].forEach(function(q){ var m_=at(box(q[2],sh,q[3],sk),q[0],sy,q[1]); m_.renderOrder=2; g.add(m_); });
  [[LAF.x0,cz],[LAF.x1,cz]].forEach(function(q){ var m_=at(box(0.15,sh,d,sk),q[0],sy,q[1]); m_.renderOrder=2; g.add(m_); });
  [[LAF.x0+1,LAF.z0+1],[LAF.x0+1,LAF.z1-1],[LAF.x1-1,LAF.z0+1],[LAF.x1-1,LAF.z1-1]].forEach(function(q){
    g.add(at(new THREE.Mesh(new THREE.CylinderGeometry(0.18,0.18,CEIL-LAF.y1,8),MR.steel),q[0],(CEIL+LAF.y1)/2,q[1])); });
  clean.add(g);
})();
/* ceiling terminals 2 + 3: H14 BIBO housings in the ceiling void, above and just behind the operator. Clean air comes
   down over the operator (head and shoulders first), so what the operator sheds is carried down to exhaust terminal 3
   at the foot of the wall behind them, away from the filler; the LAF hood keeps the Grade A first air over the product.
   Bagged out from the ceiling void, like terminal 1. 72 × 72 mm faces: the same face velocity as terminal 1. */
CT.z.forEach(function(z,i){
  bibo('Ceiling BIBO HEPA terminal '+(i+2)+' (H14)',CT.x,CEIL+1.9,z,CT.a,3.0,CT.a,i?'+z':'-z');
  hepaFace('Ceiling terminal '+(i+2)+' face screen',CT.x,CEIL-0.15,z,CT.a,CT.a,'y');
});
/* low-level exhaust terminals in the partition: H14 BIBO housings on the plant-room side, so a
   contaminated filter is bagged out from outside the clean room */
GRILLE.forEach(function(gr,i){
  var y=gr[0], z=gr[1];
  hepaFace('Low-level exhaust terminal '+(i+1)+' face screen',TH/2+0.2,y,z,5.4,7.0,'x');
  bibo('Exhaust BIBO HEPA terminal '+(i+1)+' (H14)',-1.6,y,z,2.6,5.4,7.0,i?'-z':'+z',rigDucts);
});
/* exhaust terminal 3: low on the right wall, right behind the operator and under ceiling terminals 2 + 3, so what the
   operator sheds is taken straight down and out. Its H14 BIBO housing is outside the wall (bagged out from outside the
   clean room); collector C runs outside the right and back walls and enters the plant room to join collector B. */
hepaFace('Low-level exhaust terminal 3 face screen',BX-TH-0.2,T3.y,T3.z,5.4,7.0,'x');
bibo('Exhaust BIBO HEPA terminal 3 (H14)',T3.hx,T3.y,T3.z,2.6,5.4,7.0,'+z',rigDucts);
(function ledPanel(){
  var m=at(box(22,0.3,6,MR.led),24,CEIL-0.25,-15); tag(m,'LED clean-room luminaire'); clean.add(m);
})();

/* ------------------------------------------------------ PCB + HMI */
var ctrl=new THREE.Group(); ctrl.userData.asm='Controls and HMI'; rig.add(ctrl);
var PCB={x0:-30,x1:-12,y0:27,y1:39,z:-BZ+TH+1.6};       // on the back wall, components face into the box
var pcbTex=(function(){
  var cv=document.createElement('canvas'); cv.width=1080; cv.height=720;
  var c=cv.getContext('2d'); pcbTex_draw(c,cv.width,cv.height);
  var t=new THREE.CanvasTexture(cv); t.anisotropy=4; return t;
})();
function pcbTex_draw(c,w,h){
  c.fillStyle='#0f5a35'; c.fillRect(0,0,w,h);
  c.strokeStyle='rgba(214,170,90,.85)'; c.lineCap='round';
  // traces: bus lines from the MCU to the edge connectors
  for(var i=0;i<16;i++){
    var x=60+i*62; c.lineWidth=5;
    c.beginPath(); c.moveTo(540,330); c.lineTo(540+(x-540)*0.4,470); c.lineTo(x,560); c.lineTo(x,h-40); c.stroke();
  }
  for(var j=0;j<6;j++){ c.lineWidth=7; c.beginPath(); c.moveTo(120+j*150,40); c.lineTo(120+j*150,150); c.lineTo(540,250); c.stroke(); }
  c.fillStyle='rgba(214,170,90,.9)';
  for(var k=0;k<16;k++){ c.beginPath(); c.arc(60+k*62,h-34,13,0,Math.PI*2); c.fill(); }
  c.fillStyle='#f1f5f2'; c.font='bold 34px IBM Plex Mono, monospace';
  c.fillText('CLEAN-ROOM RIG CTRL  v1.0',260,705-40-610);
  c.font='22px IBM Plex Mono, monospace';
  ['FT101','FT102','1W-A','1W-B','I2C','FAN101','FAN102','FAN103','SV101','CMP101','RV101','EEV101','HTR101','HUM101','CLEAN','PDT101']
    .forEach(function(s,i){ c.save(); c.translate(52+i*62,h-60); c.rotate(-Math.PI/2); c.fillText(s,0,0); c.restore(); });
  c.fillText('ESP32-S3',470,300); c.fillText('ACS712 ×3',760,170); c.fillText('24V IN',40,120); c.fillText('HMI UART',880,60);
  c.strokeStyle='#f1f5f2'; c.lineWidth=2; c.strokeRect(14,14,w-28,h-28);
}
(function pcb(){
  var g=new THREE.Group(); tag(g,'Main controller PCB');
  var w=PCB.x1-PCB.x0, h=PCB.y1-PCB.y0, cx=(PCB.x0+PCB.x1)/2, cy=(PCB.y0+PCB.y1)/2;
  var board=new THREE.Mesh(new THREE.BoxGeometry(w,h,0.16),[MR.pcb,MR.pcb,MR.pcb,MR.pcb,
    new THREE.MeshStandardMaterial({map:pcbTex,metalness:0.15,roughness:0.55}),MR.pcb]);
  at(board,cx,cy,PCB.z); g.add(board);
  var zf=PCB.z+0.08;                                   // component side, towards the clear front wall
  function comp(mesh,x,y,dz){ mesh.position.set(x,y,zf+dz); g.add(mesh); return mesh; }
  comp(box(2.6,1.8,0.32,MR.steel),cx,cy+0.6,0.16);                         // ESP32-S3 module can
  comp(box(3.0,2.4,0.1,MR.chip),cx,cy+0.4,0.05);
  [0,1,2].forEach(function(i){                                             // ACS712 current sensors
    comp(box(0.6,0.5,0.18,MR.chip),PCB.x1-4.2+i*1.3,PCB.y1-3.5,0.09);
    comp(box(1.0,0.8,0.8,MR.term),PCB.x1-4.2+i*1.3,PCB.y1-2.0,0.4);
  });
  [0,1,2,3].forEach(function(i){                                           // MOSFET drivers + heatsinks
    comp(box(0.8,1.2,0.35,MR.chip),PCB.x0+2+i*1.6,cy+2.4,0.18);
    comp(box(1.2,1.6,0.25,MR.steel),PCB.x0+2+i*1.6,cy+3.6,0.55);
  });
  var ind=new THREE.Mesh(new THREE.CylinderGeometry(0.7,0.7,0.7,18),MR.black); ind.rotation.x=Math.PI/2;
  comp(ind,PCB.x0+1.8,PCB.y1-2.2,0.35);                                    // buck converter
  for(var c2=0;c2<3;c2++){ var cap=new THREE.Mesh(new THREE.CylinderGeometry(0.35,0.35,1.0,14),MR.black);
    cap.rotation.x=Math.PI/2; comp(cap,PCB.x0+3.4+c2*0.9,PCB.y1-2.2,0.5); }
  comp(box(0.9,0.9,0.12,MR.chip),cx+3.2,cy+0.4,0.06);                      // TCA9548A I²C mux
  comp(box(16.6,0.9,0.8,MR.black),cx,PCB.y0+0.8,0.4);                      // edge connectors (harness)
  comp(box(2.4,0.9,1.0,MR.term),PCB.x0+1.8,PCB.y1-0.9,0.5);                // 24 V terminal
  comp(box(2.0,0.7,0.8,MR.black),PCB.x1-2,PCB.y1-0.8,0.4);                 // HMI header
  window.__leds=[];
  ['#22c55e','#f59e0b','#ef4444'].forEach(function(cl,i){
    var l=new THREE.Mesh(new THREE.BoxGeometry(0.3,0.2,0.2),new THREE.MeshBasicMaterial({color:cl}));
    comp(l,cx-3+i*0.6,PCB.y1-0.8,0.1); window.__leds.push(l);
  });
  [[PCB.x0+0.6,PCB.y0+0.6],[PCB.x1-0.6,PCB.y0+0.6],[PCB.x0+0.6,PCB.y1-0.6],[PCB.x1-0.6,PCB.y1-0.6]].forEach(function(p){
    var s=new THREE.Mesh(new THREE.CylinderGeometry(0.25,0.25,1.5,10),MR.steel); s.rotation.x=Math.PI/2;
    at(s,p[0],p[1],PCB.z-0.83); g.add(s);
  });
  ctrl.add(g);
})();
var hmiTex, hmiCanvas, hmiScreenMesh;
(function hmi(){
  var g=new THREE.Group(); tag(g,'HMI-101 7-inch touch screen');
  hmiCanvas=document.createElement('canvas'); hmiCanvas.width=800; hmiCanvas.height=450;
  hmiTex=new THREE.CanvasTexture(hmiCanvas); hmiTex.anisotropy=4;
  var face=new THREE.Group();
  face.add(at(box(17.4,10.6,1.0,MR.black),0,0,0));
  hmiScreenMesh=new THREE.Mesh(new THREE.PlaneGeometry(15.4,8.66),new THREE.MeshBasicMaterial({map:hmiTex}));
  hmiScreenMesh.position.set(0,0,0.52); face.add(hmiScreenMesh); tag(hmiScreenMesh,'HMI-101 display');
  face.position.set(-38,41.5,BZ+1.6); face.rotation.x=-0.12; g.add(face);
  [[-6,-3],[6,-3],[-6,3],[6,3]].forEach(function(p){
    var s=new THREE.Mesh(new THREE.CylinderGeometry(0.3,0.3,1.2,10),MR.steel); s.rotation.x=Math.PI/2;
    at(s,-38+p[0],41.5+p[1],BZ+0.6); g.add(s);
  });
  ctrl.add(g);
})();
(function psu(){
  var g=new THREE.Group(); tag(g,'24 V DC power supply');
  g.add(at(box(9,3.2,5,MR.steel),-40,TH+1.6,-20));
  for(var i=0;i<8;i++) g.add(at(box(0.25,2.4,4.2,MR.alu),-43.6+i*1.0,TH+3.3,-20));
  var cb=new THREE.Mesh(new THREE.CylinderGeometry(0.35,0.35,4.6,10),MR.black); cb.rotation.z=Math.PI/2;
  at(cb,-46.8,TH+1.6,-20); g.add(cb);
  ctrl.add(g);
})();
/* small sensor bodies the earlier model did not have */
(function rigSensors(){
  function body(name,w,h,d,x,y,z,mat){ var m=at(box(w,h,d,mat||MR.white),x,y,z); tag(m,name); ctrl.add(m); return m; }
  body('TT-101/MT-101 fresh-air T+RH (SHT31)',1.4,1.4,1.0,HX-1.6,HY+0.4,-1.2);
  body('FT-101 fresh-air flow (D6F)',1.6,1.2,1.2,HX-1.6,HY+0.2,1.4,MR.black);
  body('FT-102 supply airflow (D6F)',1.6,1.2,1.2,RX,20,RZ+1.9,MR.black);
  body('MT-106 room T+RH (SHT31)',3,4,1.2,44,22,-BZ+TH+0.6);
  body('PDT-101 room ΔP (SDP810)',1.2,3,2.6,TH/2+0.6,30,-19);
  var tb=new THREE.Mesh(new THREE.CylinderGeometry(0.18,0.18,2.4,8),MR.pvc); tb.rotation.z=Math.PI/2;
  at(tb,-0.5,30.8,-19); tag(tb,'PDT-101 reference tube'); ctrl.add(tb);
  body('TT-108 exhaust T (DS18B20)',0.8,0.8,0.8,C2W(-18.3,0,0).x,C2W(0,MY+MH/2,0).y+0.4,C2W(0,0,MZL).z);
})();

/* ================================================= clean-room equipment
   Human scale in the clean room is about 1:7 (the 14 cm bench is a 1 m bench),
   so the operator is 25 cm tall and the machine sizes follow from that. */
var CR={};                                         // animated parts, driven by updateCleanRoom()

/* staging bench on the front wall, right beside the pass box: material goes pass box → bench → filler
   infeed in a few steps, and the bench stays out of the air path to the low-level exhausts
   (at the back-left it stood right in front of exhaust terminal 2) */
(function bench(){
  var g=new THREE.Group(); tag(g,'Staging bench + vial tray');
  var x=23, z=19.6, h=13;
  g.add(at(box(12,0.6,8,MR.steel),x,h,z));
  g.add(at(box(10.6,0.4,6.4,MR.steel),x,4,z));
  [[-5.4,-3.4],[-5.4,3.4],[5.4,-3.4],[5.4,3.4]].forEach(function(p){
    g.add(at(new THREE.Mesh(new THREE.CylinderGeometry(0.45,0.45,h-0.5,12),MR.steel),x+p[0],(h-0.5)/2+0.5,z+p[1]));
  });
  g.add(at(box(7,0.5,4.4,MR.white),x-1.0,h+0.55,z));
  var vg=std(new THREE.Color('#bfe6ff'),{m:0.1,r:0.1,t:true,o:0.6});
  for(var i=0;i<4;i++) for(var j=0;j<2;j++)
    g.add(at(new THREE.Mesh(new THREE.CylinderGeometry(0.5,0.5,1.6,14),vg),x-4.1+i*1.5,h+1.6,z-1.0+j*2.0));
  clean.add(g);
})();

/* ------------------------------------------------ pass box (stand-alone, not wired to the rig PCB) */
var PBX={x0:6,x1:16,y0:12.5,y1:22.5,zi:18,zo:28};   // body; the front wall sits at z 24.5…25
(function passBox(){
  var g=new THREE.Group(); tag(g,'Pass box'); g.userData.asm='Clean room';
  var cx=(PBX.x0+PBX.x1)/2, cy=(PBX.y0+PBX.y1)/2, cz=(PBX.zi+PBX.zo)/2;
  var W_=PBX.x1-PBX.x0, H_=PBX.y1-PBX.y0, D_=PBX.zo-PBX.zi, t=0.3;
  // stainless shell, open at both ends for the doors
  g.add(at(box(W_,t,D_,MR.steel),cx,PBX.y1-t/2,cz));
  g.add(at(box(W_,t,D_,MR.steel),cx,PBX.y0+t/2,cz));
  g.add(at(box(t,H_,D_,MR.steel),PBX.x0+t/2,cy,cz));
  g.add(at(box(t,H_,D_,MR.steel),PBX.x1-t/2,cy,cz));
  // wall flange on both faces of the acrylic
  [BZ-TH-0.15,BZ+0.15].forEach(function(z){
    g.add(at(box(W_+2,0.6,0.3,MR.steel),cx,PBX.y1+0.7,z)); g.add(at(box(W_+2,0.6,0.3,MR.steel),cx,PBX.y0-0.7,z));
    g.add(at(box(0.6,H_+2,0.3,MR.steel),PBX.x0-0.7,cy,z)); g.add(at(box(0.6,H_+2,0.3,MR.steel),PBX.x1+0.7,cy,z));
  });
  // perforated shelf and a transfer container on it
  g.add(at(box(W_-0.8,0.25,D_-1.2,MR.white),cx,PBX.y0+2.6,cz));
  CR.pbItem=at(box(3.2,2.0,2.6,std(new THREE.Color('#d9e6f2'),{m:0.1,r:0.5})),cx,PBX.y0+3.8,cz+1.5); g.add(CR.pbItem);
  // UV lamp under the roof
  CR.uvMat=new THREE.MeshStandardMaterial({color:new THREE.Color('#b9a6ff'),emissive:new THREE.Color('#7c4dff'),emissiveIntensity:0.05});
  var uv=new THREE.Mesh(new THREE.CylinderGeometry(0.25,0.25,D_-2,12),CR.uvMat); uv.rotation.x=Math.PI/2;
  at(uv,cx,PBX.y1-0.9,cz); g.add(uv);
  // two doors on vertical hinges, each with a window and handle
  function door(z,dirZ,name){
    var piv=new THREE.Group(); piv.position.set(PBX.x0+0.2,cy,z);
    var d=new THREE.Group(); tag(d,name);
    d.add(at(box(W_-0.4,H_-0.4,0.3,MR.steel),(W_-0.4)/2,0,0));
    d.add(at(box(W_-4.4,H_-4.6,0.36,std(new THREE.Color('#cfe8f5'),{m:0.1,r:0.05,t:true,o:0.45})),(W_-0.4)/2,0.4,0));
    d.add(at(box(0.5,2.6,0.5,MR.alu),W_-1.6,0,dirZ*0.45));
    piv.add(d); g.add(piv); return piv;
  }
  CR.pbOuter=door(PBX.zo+0.15,1,'Pass box outer door');
  CR.pbInner=door(PBX.zi-0.15,-1,'Pass box inner door');
  // interlock lamps on both faces
  CR.pbLamps=[];
  [[PBX.zo+0.35,'outer'],[PBX.zi-0.35,'inner']].forEach(function(q){
    var gl=new THREE.MeshBasicMaterial({color:0x22c55e}), rl=new THREE.MeshBasicMaterial({color:0xef4444});
    var a=at(new THREE.Mesh(new THREE.BoxGeometry(0.7,0.5,0.2),gl),cx-0.6,PBX.y1+1.5,q[0]);
    var b=at(new THREE.Mesh(new THREE.BoxGeometry(0.7,0.5,0.2),rl),cx+0.6,PBX.y1+1.5,q[0]);
    g.add(a); g.add(b); CR.pbLamps.push({side:q[1],green:a,red:b});
  });
  // support legs inside the clean room
  [PBX.x0+0.5,PBX.x1-0.5].forEach(function(x){
    g.add(at(box(0.5,PBX.y0-TH,0.5,MR.steel),x,TH+(PBX.y0-TH)/2,PBX.zi+0.6));
  });
  clean.add(g);
})();

/* ------------------------------------------------ vial filling machine (stand-alone, not wired to the rig PCB) */
/* The filler and the operator stand next to the right wall. They are built in the filler's own frame
   (VF, OP: line along x, glove side +z) and turned a quarter turn, so the line runs along the wall and
   the operator's back faces the right wall (ceiling terminals 2 + 3 above, exhaust terminal 3 at the foot of the wall):
   FW() maps the frame to the world. */
var VF={x0:24,x1:48,z0:-11.5,z1:-0.5,deck:10.9,cz:-6}, FTX=36.5, FTZ=32;
function FW(x,y,z){ return W(z+FTX,y,FTZ-x); }
(function filler(){
  var g=new THREE.Group(); tag(g,'Vial filling machine'); g.userData.asm='Clean room';
  var cx=(VF.x0+VF.x1)/2, L=VF.x1-VF.x0, D=VF.z1-VF.z0;
  var poly=std(new THREE.Color('#dbeef7'),{m:0.05,r:0.05,t:true,o:0.16,side:THREE.DoubleSide,dw:false});
  // cabinet on levelling feet
  [[VF.x0+1.5,VF.z0+1.8],[VF.x0+1.5,VF.z1-2],[VF.x1-1.5,VF.z0+1.8],[VF.x1-1.5,VF.z1-2]].forEach(function(p){
    g.add(at(new THREE.Mesh(new THREE.CylinderGeometry(0.45,0.6,1.0,12),MR.black),p[0],TH+0.5,p[1]));
  });
  g.add(at(box(L,8.9,D,MR.steel),cx,TH+1+4.45,VF.cz));
  [-6,0,6].forEach(function(dx){ g.add(at(box(5.2,6.4,0.15,std(new THREE.Color('#aeb8c2'),{m:0.8,r:0.3})),cx+dx,TH+5.6,VF.z1+0.08)); });
  g.add(at(box(L,0.4,D,MR.steel),cx,VF.deck-0.2,VF.cz));                                // deck
  // open RABS: polycarbonate walls on a stainless frame, glove ports in front
  var rh=8.2, ry=VF.deck+rh/2;
  [[cx,ry,VF.z1-0.15,L,rh,0.3],[cx,ry,VF.z0+0.15,L,rh,0.3]].forEach(function(p){ var m=at(box(p[3],p[4],p[5],poly),p[0],p[1],p[2]); m.renderOrder=2; g.add(m); });
  [[VF.x0+0.15,ry,VF.cz],[VF.x1-0.15,ry,VF.cz]].forEach(function(p){ var m=at(box(0.3,rh,D-0.6,poly),p[0],p[1],p[2]); m.renderOrder=2; g.add(m); });
  [[VF.x0,VF.z0],[VF.x0,VF.z1],[VF.x1,VF.z0],[VF.x1,VF.z1]].forEach(function(p){ g.add(at(box(0.4,rh,0.4,MR.steel),p[0],ry,p[1])); });
  [VF.z0,VF.z1].forEach(function(z){ g.add(at(box(L,0.4,0.4,MR.steel),cx,VF.deck+rh,z)); });
  [VF.x0,VF.x1].forEach(function(x){ g.add(at(box(0.4,0.4,D,MR.steel),x,VF.deck+rh,VF.cz)); });
  CR.ports=[31.5,34.5,38.5,41.5];
  CR.ports.forEach(function(x){
    g.add(at(new THREE.Mesh(new THREE.TorusGeometry(1.0,0.25,10,28),MR.steel),x,VF.deck+4.4,VF.z1));
    var gl=new THREE.Mesh(new THREE.CylinderGeometry(0.55,0.75,2.6,14),std(new THREE.Color('#2a2f36'),{m:0.1,r:0.8}));
    gl.rotation.x=Math.PI/2; at(gl,x,VF.deck+4.1,VF.z1-1.4); g.add(gl);
  });
  // infeed turntable and outfeed accumulation table
  function table(x,r,name){
    var t=new THREE.Group(); t.position.set(x,VF.deck+0.2,VF.cz); tag(t,name);
    t.add(at(new THREE.Mesh(new THREE.CylinderGeometry(r,r,0.35,40),MR.steel),0,0,0));
    var rim=new THREE.Mesh(new THREE.TorusGeometry(r,0.12,8,40),MR.steel); rim.rotation.x=Math.PI/2; at(rim,0,0.5,0); t.add(rim);
    g.add(t); return t;
  }
  CR.infeed=table(VF.x0+3.3,2.7,'Infeed turntable'); CR.outfeed=table(VF.x1-2.6,2.2,'Outfeed accumulation table');
  // conveyor between them
  CR.cv={x0:VF.x0+6.0,x1:VF.x1-4.8,y:VF.deck+0.15};
  g.add(at(box(CR.cv.x1-CR.cv.x0,0.3,1.6,MR.black),(CR.cv.x0+CR.cv.x1)/2,CR.cv.y,VF.cz));
  [-1,1].forEach(function(s){ g.add(at(box(CR.cv.x1-CR.cv.x0,0.5,0.15,MR.steel),(CR.cv.x0+CR.cv.x1)/2,CR.cv.y+0.6,VF.cz+s*0.95)); });
  // filling station: gantry, needle carriage, product tank, peristaltic pump
  CR.fillX=34.5; CR.stopX=40.5;
  [VF.cz-2.6,VF.cz+2.6].forEach(function(z){ g.add(at(box(0.6,6.4,0.6,MR.steel),CR.fillX,VF.deck+3.2,z)); });
  g.add(at(box(0.8,0.8,5.8,MR.steel),CR.fillX,VF.deck+6.4,VF.cz));
  CR.needles=new THREE.Group(); tag(CR.needles,'Filling needle carriage');
  CR.needles.add(at(box(1.0,1.0,2.4,MR.alu),0,0,0));
  for(var n=0;n<4;n++){ CR.needles.add(at(new THREE.Mesh(new THREE.CylinderGeometry(0.07,0.07,2.0,8),MR.steel),0,-1.5,-0.9+n*0.6)); }
  CR.needles.position.set(CR.fillX,VF.deck+4.7,VF.cz); g.add(CR.needles);
  var tank=new THREE.Group(); tag(tank,'Product holding tank');
  tank.add(at(new THREE.Mesh(new THREE.CylinderGeometry(1.4,1.4,3.6,24),MR.steel),0,0,0));
  tank.add(at(new THREE.Mesh(new THREE.SphereGeometry(1.4,24,12),MR.steel),0,1.8,0));
  tank.add(at(new THREE.Mesh(new THREE.CylinderGeometry(0.3,0.3,1.2,10),MR.steel),0,-2.2,0));
  tank.position.set(30.0,VF.deck+2.6,VF.z0+2.1); g.add(tank);
  var pump=new THREE.Group(); tag(pump,'Peristaltic dosing pump');
  pump.add(at(box(2.2,2.0,1.6,MR.white),0,0,0));
  var rot=new THREE.Mesh(new THREE.CylinderGeometry(0.75,0.75,0.3,18),MR.alu); rot.rotation.x=Math.PI/2; at(rot,0,0.1,0.95); pump.add(rot);
  pump.position.set(32.9,VF.deck+1.0,VF.z0+2.1); g.add(pump); CR.pumpRotor=rot;
  var hose=new THREE.Mesh(new THREE.TubeGeometry(new THREE.CatmullRomCurve3([
    W(30.0,VF.deck+0.6,VF.z0+3.2),W(31.4,VF.deck+0.6,VF.z0+3.3),W(32.9,VF.deck+2.1,VF.z0+2.9),
    W(34.2,VF.deck+6.0,VF.cz-1.6),W(CR.fillX,VF.deck+5.4,VF.cz-0.8)]),40,0.12,8,false),
    std(new THREE.Color('#e9eef3'),{m:0.0,r:0.4,t:true,o:0.85}));
  tag(hose,'Product hose'); g.add(hose);
  // stoppering station: vibratory bowl, chute and press head
  var bowl=new THREE.Group(); tag(bowl,'Stopper vibratory bowl');
  bowl.add(at(new THREE.Mesh(new THREE.CylinderGeometry(0.7,0.9,2.4,16),MR.alu),0,-1.6,0));
  bowl.add(at(new THREE.Mesh(new THREE.CylinderGeometry(1.8,1.2,1.4,32),MR.steel),0,0.35,0));
  CR.bowlX=43.5; bowl.position.set(CR.bowlX,VF.deck+3.1,-9.6); g.add(bowl); CR.bowl=bowl;
  var chute=new THREE.Mesh(new THREE.BoxGeometry(0.6,1,0.25),MR.steel); tag(chute,'Stopper chute');
  limb(chute,W(42.3,VF.deck+3.6,-8.6),W(40.9,VF.deck+1.9,-6.7)); g.add(chute);
  [VF.cz-2.4,VF.cz+2.4].forEach(function(z){ g.add(at(box(0.5,5.2,0.5,MR.steel),CR.stopX,VF.deck+2.6,z)); });
  g.add(at(box(0.7,0.7,5.4,MR.steel),CR.stopX,VF.deck+5.2,VF.cz));
  CR.press=at(box(1.2,1.0,1.4,MR.alu),CR.stopX,VF.deck+3.6,VF.cz); tag(CR.press,'Stopper press head'); g.add(CR.press);
  // light tower and the machine's own panel
  CR.beacon=[];
  ['#22c55e','#f59e0b','#ef4444'].forEach(function(c,i){
    var m=new THREE.Mesh(new THREE.CylinderGeometry(0.42,0.42,0.8,14),new THREE.MeshStandardMaterial({color:new THREE.Color(c),emissive:new THREE.Color(c),emissiveIntensity:0.1}));
    at(m,VF.x1-0.9,VF.deck+rh+1.0+i*0.85,VF.z0+0.9); g.add(m); CR.beacon.push(m);
  });
  g.add(at(new THREE.Mesh(new THREE.CylinderGeometry(0.15,0.15,1.2,8),MR.steel),VF.x1-0.9,VF.deck+rh+0.4,VF.z0+0.9));
  var pan=at(box(3.6,2.4,0.3,MR.black),VF.x1-3.2,8.3,VF.z1+0.25); pan.rotation.x=-0.18; tag(pan,'Filler operator panel'); g.add(pan);
  // vials: glass body, product, stopper
  var glass=std(new THREE.Color('#cfeaff'),{m:0.1,r:0.05,t:true,o:0.5}), prod=std(new THREE.Color('#f0b44c'),{m:0,r:0.3,t:true,o:0.85}),
      stop=std(new THREE.Color('#6f7b86'),{m:0.1,r:0.7});
  function vial(){
    var v=new THREE.Group(); tag(v,'Vial');
    v.add(at(new THREE.Mesh(new THREE.CylinderGeometry(0.42,0.42,1.4,14),glass),0,0.7,0));
    var l=at(new THREE.Mesh(new THREE.CylinderGeometry(0.34,0.34,0.7,12),prod),0,0.4,0); v.add(l);
    var s=at(new THREE.Mesh(new THREE.CylinderGeometry(0.46,0.46,0.35,12),stop),0,1.55,0); v.add(s);
    v.userData.liq=l; v.userData.stop=s; return v;
  }
  CR.vials=[]; CR.pitch=1.3;
  var nv=Math.floor((CR.cv.x1-CR.cv.x0)/CR.pitch);
  for(var i=0;i<nv;i++){ var v=vial(); v.userData.u=i*CR.pitch; g.add(v); CR.vials.push(v); }
  [[CR.infeed,1.85,8,false],[CR.outfeed,1.45,7,true]].forEach(function(q){
    for(var k=0;k<q[2];k++){
      var a=k/q[2]*Math.PI*2, v=vial(); v.position.set(Math.cos(a)*q[1],0.2,Math.sin(a)*q[1]);
      v.userData.liq.visible=q[3]; v.userData.stop.visible=q[3]; q[0].add(v);
    }
  });
  g.rotation.y=Math.PI/2; g.position.set(FTX,0,FTZ);           // along the right wall
  clean.add(g); CR.filler=g;
})();

/* ------------------------------------------------ gowned operator */
var OP={x:33,z:6.4}, OPW=FW(33,0,6.4);                         // filler frame / world
(function operator(){
  var g=new THREE.Group(); tag(g,'Operator (Grade B gown)'); g.userData.asm='Clean room';
  var suit=std(new THREE.Color('#f1f4f7'),{m:0.0,r:0.85}), boot=std(new THREE.Color('#d5dde5'),{m:0,r:0.8}),
      mask=std(new THREE.Color('#9fd3f2'),{m:0,r:0.7}), gog=std(new THREE.Color('#1d2a35'),{m:0.3,r:0.2}),
      glove=std(new THREE.Color('#5b4fd6'),{m:0,r:0.6}), skin=std(new THREE.Color('#c99a7a'),{m:0,r:0.7});
  function ell(rx,ry,rz,x,y,z,mat){ var m=new THREE.Mesh(new THREE.SphereGeometry(1,24,16),mat); m.scale.set(rx,ry,rz); m.position.set(x,y,z); g.add(m); return m; }
  function cyl(rx,h,rz,x,y,z,mat,rt){ var m=new THREE.Mesh(new THREE.CylinderGeometry(rt||1,1,1,20),mat); m.scale.set(rx,h,rz); m.position.set(x,y,z); g.add(m); return m; }
  [-1.2,1.2].forEach(function(dx){
    g.add(at(box(1.7,1.3,3.0,boot),dx,TH+0.65,-0.3));                    // overshoe boots
    cyl(1.05,10.6,1.05,dx,TH+1.3+5.3,0,suit);                             // legs
  });
  ell(2.6,1.6,1.7,0,12.4,0,suit);                                         // hips
  cyl(2.7,8.4,1.65,0,16.6,0,suit,0.98);                                   // torso
  ell(3.0,1.5,1.8,0,20.6,0,suit);                                         // shoulders
  g.add(at(box(0.18,7.2,0.1,std(new THREE.Color('#9aa7b4'),{m:0.3,r:0.5})),0,16.6,-1.66));  // zip
  g.add(at(box(1.2,0.8,0.12,std(new THREE.Color('#1273cc'),{m:0.1,r:0.5})),1.1,19.0,-1.68)); // badge
  cyl(0.65,1.2,0.65,0,21.8,0,skin);                                        // neck
  ell(1.75,2.05,1.85,0,23.6,0,suit);                                      // hood over the head
  cyl(2.2,1.8,1.6,0,21.7,0,suit,0.7);                                     // hood cape
  g.add(at(box(2.5,0.85,0.5,gog),0,24.0,-1.7));                           // goggles
  g.add(at(box(2.0,1.05,0.45,mask),0,22.9,-1.65));                        // face mask
  // arms reaching into the RABS glove ports (two limb segments each)
  CR.arms=[];
  [[-1,CR.ports[0]],[1,CR.ports[1]]].forEach(function(q){
    var up=new THREE.Mesh(new THREE.CylinderGeometry(0.75,0.8,1,14),suit), lo=new THREE.Mesh(new THREE.CylinderGeometry(0.62,0.72,1,14),suit),
        hand=new THREE.Mesh(new THREE.SphereGeometry(0.62,14,10),glove), sh=new THREE.Mesh(new THREE.SphereGeometry(0.85,14,10),suit);
    g.add(up); g.add(lo); g.add(hand); g.add(sh);
    CR.arms.push({s:q[0],port:q[1],up:up,lo:lo,hand:hand,sh:sh});
  });
  g.position.set(OPW.x,0,OPW.z); g.rotation.y=Math.PI/2;          // back to the right wall: ceiling terminals 2 + 3 above, exhaust terminal 3 at its foot
  clean.add(g); CR.op=g;
})();
function limb(m,a,b){
  var d=b.clone().sub(a), L=d.length();
  m.position.copy(a).addScaledVector(d,0.5); m.scale.set(1,L,1);
  m.quaternion.setFromUnitVectors(new THREE.Vector3(0,1,0),d.normalize());
}
function poseArms(t){
  CR.arms.forEach(function(a,i){
    var sh=new THREE.Vector3(a.s*2.85,20.5,-0.2);
    var hand=new THREE.Vector3(a.port-OP.x+0.25*Math.sin(t*1.7+i*2.1),VF.deck+4.4+0.25*Math.sin(t*2.3+i),VF.z1-OP.z-0.6);
    var el=sh.clone().lerp(hand,0.5).add(new THREE.Vector3(a.s*0.9,-2.0,0));
    a.sh.position.copy(sh); limb(a.up,sh,el); limb(a.lo,el,hand); a.hand.position.copy(hand);
  });
}

/* ------------------------------------------------ animation */
CR.t=0; CR.pb={state:'ready · both doors locked',innerOpen:false,transfers:0,lastC:0};
function smooth(x){ x=Math.max(0,Math.min(1,x)); return x*x*(3-2*x); }
function updateCleanRoom(dt,run){
  CR.t+=dt; var t=CR.t;
  var v=run?1.3:0;                                   // conveyor speed, cm/s (one vial per pitch)
  var span=CR.cv.x1-CR.cv.x0;
  CR.vials.forEach(function(m){
    m.userData.u=(m.userData.u+v*dt)%span;
    var x=CR.cv.x0+m.userData.u; m.position.set(x,CR.cv.y+0.15,VF.cz);
    m.userData.liq.visible=x>CR.fillX+0.3; m.userData.stop.visible=x>CR.stopX+0.3;
  });
  CR.infeed.rotation.y+=dt*0.5*(run?1:0); CR.outfeed.rotation.y-=dt*0.45*(run?1:0);
  // needles dip when a vial sits under them; the press head follows the stopper station
  var ph=((CR.vials[0].userData.u-(CR.fillX-CR.cv.x0))%CR.pitch+CR.pitch)%CR.pitch/CR.pitch;
  var dip=run?Math.sin(Math.PI*smooth(1-Math.abs(ph-0.5)*2.2)):0;
  CR.needles.position.y=VF.deck+4.7-1.5*dip;
  var ps=((CR.vials[0].userData.u-(CR.stopX-CR.cv.x0))%CR.pitch+CR.pitch)%CR.pitch/CR.pitch;
  CR.press.position.y=VF.deck+3.6-0.9*(run?Math.sin(Math.PI*smooth(1-Math.abs(ps-0.5)*2.2)):0);
  CR.pumpRotor.rotation.z-=dt*4*(run?1:0);
  CR.bowl.position.x=CR.bowlX+(run?0.04*Math.sin(t*60):0);
  CR.beacon[0].material.emissiveIntensity=run?1.2:0.1; CR.beacon[2].material.emissiveIntensity=run?0.1:1.2;
  // pass box transfer cycle, 40 s: idle → outer door → UV → inner door → idle (doors interlocked)
  var c=t%40, oA=0, iA=0, uv=0, item=c>=12.5&&c<26.5;   // item put in through the outer door, taken out through the inner
  if(c>=10&&c<18) oA=smooth((c-10)/2)*(1-smooth((c-15)/2));
  else if(c>=18&&c<24) uv=1;
  else if(c>=24&&c<32) iA=smooth((c-24)/2)*(1-smooth((c-29)/2));
  CR.pbOuter.rotation.y=-oA*1.45; CR.pbInner.rotation.y=iA*1.45;
  if(c<CR.pb.lastC) CR.pb.transfers++;
  CR.pb.lastC=c; CR.pb.innerOpen=iA>0.05;
  CR.pb.state=oA>0.01?'outer door open · inner locked':(iA>0.01?'inner door open · outer locked':(uv?'UV cycle · both doors locked':'ready · both doors locked'));
  CR.pbItem.visible=item; CR.uvMat.emissiveIntensity=0.05+uv*1.6;
  CR.pbLamps.forEach(function(l){
    var mayOpen=uv?false:(l.side==='outer'?iA<0.01:oA<0.01);
    l.green.visible=mayOpen; l.red.visible=!mayOpen;
  });
  poseArms(t);
}
updateCleanRoom(0,true);

/* ------------------------------------------------ PT-101 air particle sensor */
/* laser particle counter on the back wall with a 2-port sampling manifold: one port samples
   room air, the other runs a sample tube to an isokinetic probe beside the filling needles */
var PT={x:30,y:16,z:-BZ+TH+0.8};
(function particleSensor(){
  var g=new THREE.Group(); tag(g,'PT-101 air particle sensor'); g.userData.asm='Controls and HMI';
  g.add(at(box(3.2,4.2,1.6,MR.white),PT.x,PT.y,PT.z));
  g.add(at(box(2.2,1.2,0.12,MR.black),PT.x,PT.y+0.8,PT.z+0.82));
  CR.ptLed=new THREE.Mesh(new THREE.BoxGeometry(0.4,0.25,0.12),new THREE.MeshBasicMaterial({color:0x22c55e}));
  at(CR.ptLed,PT.x+1.1,PT.y-1.4,PT.z+0.82); g.add(CR.ptLed);
  g.add(at(box(2.4,0.7,1.0,MR.alu),PT.x,PT.y+2.45,PT.z));                                    // manifold
  [-0.7,0.7].forEach(function(dx){ g.add(at(new THREE.Mesh(new THREE.CylinderGeometry(0.2,0.2,0.8,10),MR.steel),PT.x+dx,PT.y+3.2,PT.z)); });
  var fun=new THREE.Mesh(new THREE.CylinderGeometry(0.6,0.2,0.7,16,1,true),MR.steel); at(fun,PT.x-0.7,PT.y+4.6,PT.z); g.add(fun);   // room-air port
  g.add(at(new THREE.Mesh(new THREE.CylinderGeometry(0.15,0.15,0.9,8),MR.steel),PT.x-0.7,PT.y+3.9,PT.z));
  // isokinetic probe at the fill point, facing the first air, and its sample tube over the RABS
  var pr=new THREE.Group(); tag(pr,'PT-101 isokinetic probe');
  pr.add(at(new THREE.Mesh(new THREE.CylinderGeometry(0.45,0.14,0.9,16,1,true),MR.steel),0,0.45,0));
  pr.add(at(new THREE.Mesh(new THREE.CylinderGeometry(0.12,0.12,1.4,8),MR.steel),0,-0.7,0));
  pr.position.copy(FW(35.6,VF.deck+2.6,-7.8)); g.add(pr);
  function fw(x,y,z){ var v=FW(x,y,z); return [v.x,v.y,v.z]; }
  var tube=new THREE.Mesh(new THREE.TubeGeometry(roundedPath([fw(35.6,VF.deck+1.2,-7.8),fw(35.6,VF.deck+0.9,-10.5),
    fw(35.6,VF.deck+8.7,-10.7),fw(35.6,VF.deck+8.9,-12.3),[23.6,PT.y+3.6,-8.0],[PT.x-0.7,PT.y+3.6,-20.5],[PT.x+0.7,PT.y+3.6,PT.z]],0.9),80,0.13,8,false),
    std(new THREE.Color('#e6eef4'),{m:0,r:0.4,t:true,o:0.8}));
  tag(tube,'PT-101 sample tube'); g.add(tube);
  ctrl.add(g);
})();

/* ------------------------------------------------ containment zones (display only, not exported) */
/* Each zone is a translucent volume with a floor footprint and a solid colour badge (GRADE A, GRADE B …).
   Badges keep a constant size on screen, like the sensor tags, and grow with the Large readings mode. */
var zoneGroup=new THREE.Group(); zoneGroup.userData.noExport=true; scene.add(zoneGroup);
var ZONES=[
  {t:'GRADE A',s:'ISO 5 · LAF first air at the fill point',c:'#16a34a',bc:'#15803d',o:0.22,f:0.45,
   b:[LAF.x0+0.2,VF.deck,LAF.z0+0.2,LAF.x1-0.2,LAF.y0,LAF.z1-0.2],at:[LAF.x1+1.5,LAF.y1+1.6,LAF.z0+2]},
  {t:'GRADE B',s:'ISO 7 in operation · +15 Pa',c:'#2563eb',bc:'#1d4ed8',o:0.07,f:0.22,
   b:[TH/2+0.1,TH,-BZ+TH,BX-TH,CEIL,BZ-TH],at:[30,3.5,17]},
  {t:'PASS BOX',s:'airlock · interlocked doors + UV',c:'#d97706',bc:'#b45309',o:0.26,f:0.5,
   b:[PBX.x0,PBX.y0,PBX.zi,PBX.x1,PBX.y1,PBX.zo],at:[(PBX.x0+PBX.x1)/2,PBX.y0-2.6,PBX.zo+0.5]},
  {t:'UNCLASSIFIED',s:'plant room · 0 Pa reference',c:'#64748b',bc:'#475569',o:0.04,f:0.18,
   b:[-BX+TH,TH,-BZ+TH,-TH/2-0.1,BY-TH,BZ-TH],at:[-30,3.5,17]}
];
var zoneBadges=[], ZB_SCALE=0.00050, zoneBadgeK=1;
function makeZoneBadge(title,sub,color){
  var dpr=2,pad=12,fs=30,ss=19, cv=document.createElement('canvas'), c=cv.getContext('2d');
  c.font='700 '+fs+'px "IBM Plex Sans", sans-serif'; var w=c.measureText(title).width;
  c.font='500 '+ss+'px "IBM Plex Mono", monospace'; w=Math.max(w,c.measureText(sub).width);
  var Wd=Math.ceil(w+pad*2), Hh=Math.ceil(fs+ss+pad*2+2);
  cv.width=Wd*dpr; cv.height=Hh*dpr; c.scale(dpr,dpr);
  c.fillStyle=color; roundRect(c,0,0,Wd,Hh,7); c.fill();
  c.strokeStyle='rgba(255,255,255,0.75)'; c.lineWidth=2; roundRect(c,2.5,2.5,Wd-5,Hh-5,5); c.stroke();
  c.textBaseline='top'; c.fillStyle='#ffffff';
  c.font='700 '+fs+'px "IBM Plex Sans", sans-serif'; c.fillText(title,pad,pad-3);
  c.fillStyle='rgba(255,255,255,0.9)'; c.font='500 '+ss+'px "IBM Plex Mono", monospace'; c.fillText(sub,pad,pad+fs);
  var tex=new THREE.CanvasTexture(cv); tex.anisotropy=4;
  var sp=new THREE.Sprite(new THREE.SpriteMaterial({map:tex,transparent:true,depthTest:false,depthWrite:false,sizeAttenuation:false}));
  sp.renderOrder=10.5; sp.userData.wh=[Wd,Hh];        // above the name labels (10), under the live readings (11)
  sp.scale.set(Wd*ZB_SCALE*zoneBadgeK,Hh*ZB_SCALE*zoneBadgeK,1);
  return sp;
}
function scaleZoneBadges(k){
  zoneBadgeK=k;
  zoneBadges.forEach(function(sp){ sp.scale.set(sp.userData.wh[0]*ZB_SCALE*k,sp.userData.wh[1]*ZB_SCALE*k,1); });
}
function buildZones(){
  while(zoneGroup.children.length){ var c=zoneGroup.children.pop(); if(c.geometry) c.geometry.dispose(); if(c.material){ if(c.material.map) c.material.map.dispose(); c.material.dispose(); } }
  zoneBadges=[];
  ZONES.forEach(function(z){
    var b=z.b, w=b[3]-b[0], h=b[4]-b[1], d=b[5]-b[2];
    var m=new THREE.Mesh(new THREE.BoxGeometry(w,h,d),new THREE.MeshBasicMaterial({color:new THREE.Color(z.c),transparent:true,opacity:z.o,depthWrite:false,side:THREE.DoubleSide}));
    m.position.set(b[0]+w/2,b[1]+h/2,b[2]+d/2); m.renderOrder=4; zoneGroup.add(m);
    var e=new THREE.LineSegments(new THREE.EdgesGeometry(m.geometry),new THREE.LineBasicMaterial({color:new THREE.Color(z.c),transparent:true,opacity:0.9}));
    e.position.copy(m.position); zoneGroup.add(e);
    var fl=new THREE.Mesh(new THREE.PlaneGeometry(w,d),new THREE.MeshBasicMaterial({color:new THREE.Color(z.c),transparent:true,opacity:z.f,depthWrite:false,side:THREE.DoubleSide}));
    fl.rotation.x=-Math.PI/2; fl.position.set(b[0]+w/2,b[1]+0.06,b[2]+d/2); fl.renderOrder=3; zoneGroup.add(fl);   // zone footprint, read like a zoning plan
    var sp=makeZoneBadge(z.t,z.s,z.bc); sp.position.set(z.at[0],z.at[1],z.at[2]); zoneGroup.add(sp); zoneBadges.push(sp);
  });
}

/* the recovery unit floats in the earlier model; on the rig it stands on four posts */
(function hrPosts(){
  var g=new THREE.Group(); tag(g,'Recovery unit support posts'); g.userData.asm='Heat-recovery air-pump unit';
  var bot=C2W(0,MY-MH/2,0).y;
  [[MX0+0.3,MZ-MD/2+0.3],[MX0+0.3,MZ+MD/2-0.3],[MX1-0.3,MZ-MD/2+0.3],[MX1-0.3,MZ+MD/2-0.3]].forEach(function(p){
    var w=C2W(p[0],0,p[1]);
    g.add(at(box(0.5,bot-TH,0.5,MR.alu),w.x,TH+(bot-TH)/2,w.z));
  });
  rig.add(g);
})();

/* ========================================================== air paths */
/* vertices: [x,y,z,radius,colourKey,temperatureKey] in world cm.
   colourKey f/r/m = fresh / exhaust / supply; temperatureKey names an air state of the model */
var RW=1.12, RN=0.72, LN=0.58;
function cw(list){ return list.map(function(p){ var v=C2W(p[0],p[1],p[2]); return [v.x,v.y,v.z,p[3]*K,p[4],p[5]]; }); }
var TRAIN_C=[
  [-2.6,YS,0,0.88,'f','t1'],[-2.0,YS,0,0.86,'f','t1'],[-0.9,YS,0,0.80,'f','t1'],[0.3,YS,0,0.86,'m','ph'],
  [1.2,YS,0,0.86,'m','ph'],[1.9,YS,0,0.78,'m','ph'],[2.9,YS,0,0.76,'m','cc'],[3.8,YS,0,0.78,'m','cc'],
  [4.8,YS,0,0.84,'m','rh'],[5.5,YS,0,RN,'m','rh'],[5.9,YS,0,0.45,'m','rh'],[6.5,YS,0,0.95,'m','sup'],
  [7.1,YS,0,0.74,'m','sup'],[8.2,YS,0,0.82,'m','sup'],[9.1,YS,0,0.95,'m','sup'],[10.0,YS,0,0.95,'m','sup'],[13.2,YS,0,0.9,'m','sup']];
var PATHS={
  comp: [[-55,22,-14,1.8,'f','oa'],[-49.5,22,-14,1.5,'f','oa'],[-45,22,-14,1.4,'f','oa'],[-42.6,22,-14,1.0,'f','oa'],
         [-42.5,25.0,-13.0,1.0,'f','oa'],[-42.5,24.4,-10.6,1.0,'f','oa'],[-42.5,19,-11.3,1.0,'f','oa'],
         [-42.5,13.8,-11.3,0.85,'f','oa'],[-44.9,HY,-11.3,0.85,'f','oa'],[HX,HY,-11.3,0.85,'f','oa'],[HX,HY,P_HR_FRESH.z,0.85,'f','oa']],
  hr:   [[HX,HY,P_HR_FRESH.z,0.6,'f','oa'],[HX,P_HR_FRESH.y,P_HR_FRESH.z,0.6,'f','oa'],[P_HR_FRESH.x,P_HR_FRESH.y,P_HR_FRESH.z,0.6,'f','oa']].concat(cw([
         [MX0+1.5,MY,MZU,LN,'f','oa'],[MXC-1.9,MY,MZU,LN,'f','oa'],[MXC-1.1,MY+0.50,MZ+0.60,0.34,'f','oa'],
         [MXC,MY+0.50,MZ,0.34,'f','oa'],[MXC+1.1,MY+0.50,MZ-0.60,0.34,'f','t1'],[MXC+1.9,MY,MZL,LN,'f','t1'],
         [MX1-2.2,MY,MZL,LN,'f','t1'],[MX1-1.5,MY,MZL,0.42,'f','t1']]).concat(TEMPR.map(function(p,i){
         return [p[0],p[1],p[2],i===TEMPR.length-1?0.9:0.6,'f','t1']; }))),
  direct:[[HX,HY,P_HR_FRESH.z,0.85,'f','oa'],[HX,HY,P_AHU_OA.z,0.85,'f','oa'],[HX,P_AHU_OA.y,P_AHU_OA.z,0.8,'f','oa'],
         [P_AHU_OA.x+0.2,P_AHU_OA.y,P_AHU_OA.z,0.8,'f','oa']],
  supply: cw([[-13.2,YS,0,RW,'f','tin'],[-10.6,YS,0,RW,'f','tin'],[-9.8,YS,0,1.00,'f','tin'],[-8.7,YS,0,0.90,'f','tin'],
         [-7.1,YS,0,0.84,'f','tin'],[-5.7,YS,0,0.80,'f','tin'],[-4.3,YS,0,0.84,'f','t2'],[-3.9,YS,0,0.88,'f','t2']].concat(TRAIN_C)),
  /* exhaust: low-level BIBO terminals → collector → PT-102 → DV-101 → Cu core (or the outer HEPA) */
  exA: [[0.6,GRILLE[0][0],GRILLE[0][1],1.0,'r','ret'],[-1.6,GRILLE[0][0],GRILLE[0][1],1.0,'r','ret'],[-1.75,EXY,GRILLE[0][1],0.8,'r','ret'],[-1.75,EXY,EXZ,0.8,'r','ret']],
  exC: [[BX-TH-0.6,T3.y,T3.z,1.0,'r','ret'],[T3.hx,T3.y,T3.z,1.0,'r','ret'],[T3.hx,T3.y,T3.z-3.5,0.8,'r','ret'],[T3.hx,T3.y,T3.dz,0.8,'r','ret'],
        [-1.75,T3.y,T3.dz,0.8,'r','ret'],[-1.75,EXY,T3.dz,0.8,'r','ret'],[-1.75,EXY,GRILLE[1][1],0.8,'r','ret'],[-1.75,EXY,EXZ,0.8,'r','ret']],
  exB: [[0.6,GRILLE[1][0],GRILLE[1][1],1.0,'r','ret'],[-1.6,GRILLE[1][0],GRILLE[1][1],1.0,'r','ret'],[-1.75,EXY,GRILLE[1][1],0.8,'r','ret'],[-1.75,EXY,EXZ,0.8,'r','ret']],
  exMain: [[-1.75,EXY,EXZ,0.75,'r','ret'],[-14.2,EXY,EXZ,0.75,'r','ret'],[-17,EXY,EXZ,0.75,'r','ret'],[DVX,EXY,EXZ,0.75,'r','ret']],
  exCore: [[DVX,EXY,EXZ,0.6,'r','r1'],[-27.2,EXY,EXZ,0.6,'r','r1'],[-27.2,P_HR_EXIN.y,EXZ,0.6,'r','r1'],[P_HR_EXIN.x+0.4,P_HR_EXIN.y,EXZ,0.55,'r','r1']].concat(cw([
         [MX1+0.6,MY,MZU,0.5,'r','r1'],[MX1-1.5,MY,MZU,LN,'r','r1'],
         [MXC+1.9,MY,MZU,LN,'r','r1'],[MXC+1.1,MY-0.50,MZ+0.60,0.34,'r','r1'],[MXC,MY-0.50,MZ,0.34,'r','r1'],
         [MXC-1.1,MY-0.50,MZ-0.60,0.34,'r','r2'],[MXC-1.9,MY,MZL,LN,'r','r2'],[-17.3,MY,MZL,0.46,'r','r2'],
         [MX0+1.4,MY,MZL,0.42,'r','exh']])).concat(EXR.map(function(p){ return [p[0],p[1],p[2],0.6,'r','exh']; }),
         [[BYP.sx,BYP.jy,BYP.sz,0.6,'r','exh'],[BYP.sx,BYP.top,BYP.sz,0.9,'r','exh'],[BYP.sx,BYP.top+6,BYP.sz,1.6,'r','exh']]),
  exByp: [[DVX,EXY+0.6,EXZ,0.6,'c','ret'],[DVX,BYP.y,EXZ,0.6,'c','ret'],[BYP.x1,BYP.y,BYP.z,0.6,'c','ret'],
         [(BYP.x0+BYP.x1)/2,BYP.y,BYP.z,1.4,'r','ret'],[BYP.x0,BYP.y,BYP.z,0.8,'r','ret'],[BYP.fx-1.2,BYP.y,BYP.z,0.6,'r','ret'],[BYP.rx,BYP.y,BYP.z,0.6,'r','ret'],
         [BYP.rx,BYP.ty,BYP.z,0.6,'r','ret'],[BYP.sx,BYP.ty,BYP.z,0.6,'r','ret'],[BYP.sx,BYP.ty,BYP.sz,0.6,'r','ret'],
         [BYP.sx,BYP.top,BYP.sz,0.9,'r','ret'],[BYP.sx,BYP.top+6,BYP.sz,1.6,'r','ret']]
};
var RISER0=[[P_AHU_SUP.x-0.2,P_AHU_SUP.y,P_AHU_SUP.z,1.0,'m','sup'],[RX,P_AHU_SUP.y,4.6,1.0,'m','sup'],[RX,P_AHU_SUP.y,RZ,1.0,'m','sup'],
  [RX,P_AHU_SUP.y+2.5,RZ,1.1,'m','sup'],[RX,RY,RZ,1.1,'m','sup'],[0.5,RY,RZ,1.1,'m','sup'],[8,RY,RZ,1.1,'m','sup'],
  [8,RY,0,1.1,'m','sup'],[14,RY,0,1.0,'m','sup']];
PATHS.riserA=RISER0.concat([[14,CEIL+1.4,0,0.9,'m','sup'],[14,CEIL+0.2,0,1.1,'m','sup']]);
PATHS.riserB=RISER0.concat([[30.5,RY,0,1.0,'m','sup'],[CT.tx,RY,0,1.0,'m','sup'],[CT.tx,RY,CT.z[0],0.8,'m','sup'],[CT.x,RY,CT.z[0],0.8,'m','sup'],[CT.x,CEIL+1.4,CT.z[0],0.8,'m','sup'],[CT.x,CEIL+0.2,CT.z[0],1.0,'m','sup']]);
PATHS.riserD=RISER0.concat([[30.5,RY,0,1.0,'m','sup'],[CT.tx,RY,0,1.0,'m','sup'],[CT.tx,RY,CT.z[1],0.8,'m','sup'],[CT.x,RY,CT.z[1],0.8,'m','sup'],[CT.x,CEIL+1.4,CT.z[1],0.8,'m','sup'],[CT.x,CEIL+0.2,CT.z[1],1.0,'m','sup']]);
PATHS.riserC=RISER0.concat([[30.5,RY,0,1.0,'m','sup'],[30.5,RY-1.4,-4,0.9,'m','sup'],[30.5,LAF.y1+0.4,-4,0.9,'m','sup'],[30.5,LAF.y0+0.8,-4,1.2,'m','sup']]);
function GZ(z){ return z>-5?GRILLE[0][1]:GRILLE[1][1]; }      // nearest partition exhaust terminal
PATHS.room=[];
DIFF.forEach(function(d){
  [[1,0],[-1,0],[0,1],[0,-1]].forEach(function(dr){
    var xd=d[0], zd=d[1], dist;
    if(dr[0]>0) dist=BX-TH-xd; else if(dr[0]<0) dist=xd-TH/2; else dist=BZ-TH;
    var reach=Math.max(3,dist-3.5);
    var x2=xd+dr[0]*reach, z2=zd+dr[1]*reach;
    if(x2>PBX.x0-3 && x2<PBX.x1+3 && z2>PBX.zi-4) x2=PBX.x1+4;     // go round the pass box
    var gz=GZ(z2), gy=GRILLE[0][0];
    PATHS.room.push([[xd,CEIL-0.6,zd,1.4,'m','sup'],[xd+dr[0]*5.5,CEIL-1.6,zd+dr[1]*5.5,2.2,'m','sup'],
      [x2,CEIL-5,z2,3.0,'m','room'],[x2,24,z2,3.6,'m','room'],[x2,9,z2,3.4,'r','room'],
      [Math.min(7,Math.max(x2,4)),5.0,(z2+gz)/2,2.6,'r','room'],[3.2,gy,gz,1.8,'r','ret'],[0.6,gy,gz,1.4,'r','ret']]);
  });
});
/* LAF first air: straight down from the hood over the open RABS and the filling needles,
   then off the back of the filler and out at low level */
[27.6,33.4].forEach(function(x){ [-11,-3,4].forEach(function(z){
  var gz=GZ(z), gy=GRILLE[0][0];
  PATHS.room.push([[x,LAF.y0-0.4,z,1.6,'m','sup'],[x,VF.deck+8.4,z,2.4,'m','sup'],[x,VF.deck+2.2,z,2.4,'m','sup'],
    [x-5,VF.deck-1.5,z,2.4,'m','room'],[16,4.6,(z+gz)/2,2.6,'r','room'],[3.2,gy,gz,1.8,'r','ret'],[0.6,gy,gz,1.4,'r','ret']]);
}); });
/* ceiling terminals 2 + 3: down over the operator; most of it goes on down behind the operator's legs into exhaust
   terminal 3 at the foot of the right wall, the rest along the floor beside the filler to the partition terminals */
CT.z.forEach(function(z){ [-2.2,0,2.2].forEach(function(d){
  var x=CT.x+d, gz=z>0?GRILLE[0][1]:GRILLE[1][1], gy=GRILLE[0][0];
  PATHS.room.push([[x,CEIL-0.6,z,1.3,'m','sup'],[x,CEIL-4.5,z,1.9,'m','sup'],[x+0.8,24,z*0.85,2.4,'m','room'],
    [46+d*0.4,12,(z+T3.z)/2,2.4,'m','room'],[47.6,T3.y+0.6,T3.z+(z>0?1.6:-1.6),1.8,'r','room'],[BX-TH-0.6,T3.y,T3.z,1.3,'r','ret']]);
  PATHS.room.push([[x,CEIL-0.6,z,1.3,'m','sup'],[x-1,CEIL-5,z*1.2,2.0,'m','sup'],[x-2.5,18,z>0?7+d:-11+d,2.6,'m','room'],
    [38,6,z>0?10:-18,3.0,'m','room'],[20,5,z>0?8:-19,2.8,'r','room'],[3.2,gy,gz,1.8,'r','ret'],[0.6,gy,gz,1.4,'r','ret']]);
}); });
/* contamination: particles shed by the operator are swept past the sides of the filler at low level,
   under the LAF first air, and out through the low-level exhausts; plus what the pass box lets in */
PATHS.contam=[[OPW.x,20,OPW.z,2.2,'c','room'],[OPW.x-2.5,14,OPW.z+4,2.8,'c','room'],[37,8,10,3.2,'c','room'],
  [20,5,8,2.8,'c','room'],[3.2,GRILLE[0][0],GRILLE[0][1],1.6,'c','ret'],[0.6,GRILLE[0][0],GRILLE[0][1],1.2,'c','ret']];
PATHS.contam2=[[OPW.x+0.5,17,OPW.z-1,2.2,'c','room'],[OPW.x-2,9,OPW.z-6,3.0,'c','room'],[37,5,-18,3.2,'c','room'],
  [18,4.5,-19,2.6,'c','room'],[3.2,GRILLE[1][0],GRILLE[1][1],1.6,'c','ret'],[0.6,GRILLE[1][0],GRILLE[1][1],1.2,'c','ret']];
PATHS.pbx=[[(PBX.x0+PBX.x1)/2,(PBX.y0+PBX.y1)/2,PBX.zi-0.5,1.6,'c','room'],[10,12,PBX.zi-5,2.4,'c','room'],
  [8,5,8,2.8,'c','room'],[3.2,GRILLE[0][0],GRILLE[0][1],1.6,'c','ret'],[0.6,GRILLE[0][0],GRILLE[0][1],1.2,'c','ret']];
/* what the operator sheds low down goes straight back into exhaust terminal 3 behind the legs */
PATHS.contam3=[[OPW.x+0.6,13,OPW.z+0.8,2.0,'c','room'],[OPW.x+2.4,7,OPW.z+0.4,2.2,'c','room'],[46.8,T3.y+0.4,T3.z,1.8,'c','room'],
  [BX-TH-0.6,T3.y,T3.z,1.3,'c','ret'],[T3.hx,T3.y,T3.z,1.0,'c','ret']];

/* polyline with arc-length table and a perpendicular frame per segment */
function mkPath(pts){
  var v=[],r=[],ck=[],tk=[],cum=[0],n1=[],n2=[],total=0;
  pts.forEach(function(p){ v.push(W(p[0],p[1],p[2])); r.push(p[3]); ck.push(p[4]); tk.push(p[5]); });
  for(var i=0;i<v.length-1;i++){
    var d=v[i+1].clone().sub(v[i]), L=d.length(); total+=L; cum.push(total);
    d.normalize();
    var up=Math.abs(d.y)>0.9?W(1,0,0):W(0,1,0);
    var a=new THREE.Vector3().crossVectors(d,up).normalize(), b=new THREE.Vector3().crossVectors(d,a).normalize();
    n1.push(a); n2.push(b);
  }
  var p={v:v,r:r,ck:ck,tk:tk,cum:cum,total:total,n1:n1,n2:n2,pts:pts,
    col:v.map(function(){return new THREE.Color();})};
  ALLPATHS.push(p); return p;
}
var ALLPATHS=[];
function segAt(p,s){
  var cum=p.cum,i=1;
  while(i<cum.length-1 && cum[i]<s) i++;
  var span=cum[i]-cum[i-1]||1;
  return {i:i, t:Math.max(0,Math.min(1,(s-cum[i-1])/span))};
}

/* ---------------------------------------------------------- streams */
function makeDot(){
  var cv=document.createElement('canvas'); cv.width=cv.height=64;
  var ctx=cv.getContext('2d');
  var g=ctx.createRadialGradient(32,32,0,32,32,32);
  g.addColorStop(0,'rgba(255,255,255,1)'); g.addColorStop(0.35,'rgba(255,255,255,0.85)'); g.addColorStop(1,'rgba(255,255,255,0)');
  ctx.fillStyle=g; ctx.fillRect(0,0,64,64);
  return new THREE.CanvasTexture(cv);
}
var dotTex=makeDot();
var airGroup=new THREE.Group(); scene.add(airGroup);
var MOBILE=window.innerWidth<760;
function stream(name,paths,count,flowKey,opt){
  opt=opt||{};
  count=Math.round(count*(MOBILE?0.55:1));
  var ps=paths.map(mkPath);
  var geo=new THREE.BufferGeometry();
  geo.setAttribute('position',new THREE.BufferAttribute(new Float32Array(count*3),3));
  geo.setAttribute('color',new THREE.BufferAttribute(new Float32Array(count*3),3));
  var mat=new THREE.PointsMaterial({size:opt.size||0.5,map:dotTex,vertexColors:true,
    transparent:true,opacity:0.98,depthWrite:false,sizeAttenuation:true});
  var pts=new THREE.Points(geo,mat); pts.renderOrder=5; pts.frustumCulled=false; airGroup.add(pts);
  var P=[];
  for(var i=0;i<count;i++){
    var k=Math.floor(Math.random()*ps.length), ang=Math.random()*6.283, rr=Math.sqrt(Math.random());
    P.push({k:k,s:Math.random()*ps[k].total,oa:Math.cos(ang)*rr,ob:Math.sin(ang)*rr,ph:Math.random()*6.283,sp:0.85+Math.random()*0.3});
  }
  return {name:name,paths:ps,parts:P,geo:geo,mat:mat,obj:pts,count:count,flow:flowKey,
    vk:opt.vk||7,fadeIn:!!opt.fadeIn,fadeOut:!!opt.fadeOut};
}
var STREAMS=[
  stream('comp',[PATHS.comp],460,'Qfa',{fadeIn:true}),
  stream('hr',[PATHS.hr],440,'Qhr',{size:0.42}),
  stream('direct',[PATHS.direct],240,'Qdir'),
  stream('supply',[PATHS.supply],620,'Qfa',{size:0.42}),
  stream('riser',[PATHS.riserA,PATHS.riserB,PATHS.riserC,PATHS.riserD],760,'Qsup',{vk:9}),
  stream('room',PATHS.room,1700,'Qsup',{size:0.85,vk:11}),
  stream('ret',[PATHS.exA,PATHS.exB,PATHS.exC],420,'Qret'),
  stream('exmain',[PATHS.exMain],300,'Qex',{size:0.42}),
  stream('stale',[PATHS.exCore],460,'Qcore',{size:0.42,fadeOut:true}),
  stream('byp',[PATHS.exByp],360,'Qbyp',{size:0.42,fadeOut:true}),
  stream('contam',[PATHS.contam,PATHS.contam2,PATHS.contam3],360,'Qcont',{size:0.6,vk:6,fadeIn:true}),
  stream('pbx',[PATHS.pbx],160,'Qpbx',{size:0.6,vk:8,fadeIn:true})
];
var _v=new THREE.Vector3(), _c=new THREE.Color();
function tempColor(t,out){
  if(t<=21){ var a=Math.max(0,Math.min(1,(t+5)/26)); return out.copy(T.tCold).lerp(T.tMid,a); }
  var b=Math.max(0,Math.min(1,(t-21)/24)); return out.copy(T.tMid).lerp(T.tHot,b);
}
var colorMode='stream';
function streamColor(k,out){ return out.copy(k==='f'?T.fresh:(k==='r'?T.ret:(k==='c'?T.contam:T.mix))); }
function refreshPathColors(states){
  ALLPATHS.forEach(function(p){
    for(var i=0;i<p.v.length;i++){
      if(colorMode==='temp' && states && p.ck[i]!=='c') tempColor(states[p.tk[i]]!==undefined?states[p.tk[i]]:21,p.col[i]);
      else streamColor(p.ck[i],p.col[i]);
    }
  });
}
function updateStream(st,dt,speed,flows){
  var pos=st.geo.attributes.position.array, cols=st.geo.attributes.color.array;
  var q=flows[st.flow]||0, ff=Math.max(0,Math.min(3,q/flows.ref));
  st.obj.visible=(st.name==='contam'||st.name==='pbx'?contamVisible:airVisible) && q>0.02;
  if(st.name==='contam') st.geo.setDrawRange(0,Math.round(st.count*(flows.contamFrac||1)));
  for(var i=0;i<st.count;i++){
    var pp=st.parts[i], p=st.paths[pp.k], tot=p.total;
    var g=segAt(p,pp.s), j=g.i, t=g.t;
    var rad=p.r[j-1]+(p.r[j]-p.r[j-1])*t;
    pp.s += dt*speed*ff*pp.sp*st.vk/Math.max(0.5,Math.min(rad,4));
    if(pp.s>tot){ pp.s-=tot; pp.k=Math.floor(Math.random()*st.paths.length); }
    _v.lerpVectors(p.v[j-1],p.v[j],t);
    var w=0.86+0.14*Math.sin(time*2.2+pp.ph), n1=p.n1[j-1], n2=p.n2[j-1];
    pos[i*3]  =_v.x+(n1.x*pp.oa+n2.x*pp.ob)*rad*w;
    pos[i*3+1]=_v.y+(n1.y*pp.oa+n2.y*pp.ob)*rad*w;
    pos[i*3+2]=_v.z+(n1.z*pp.oa+n2.z*pp.ob)*rad*w;
    _c.copy(p.col[j-1]).lerp(p.col[j],t);
    var e=1;
    if(st.fadeIn) e=Math.min(1,pp.s/4); if(st.fadeOut) e=Math.min(e,(tot-pp.s)/4);
    e=Math.max(0,e); e=e*e*(3-2*e);
    cols[i*3]=_c.r*e; cols[i*3+1]=_c.g*e; cols[i*3+2]=_c.b*e;
  }
  st.geo.attributes.position.needsUpdate=true;
  st.geo.attributes.color.needsUpdate=true;
}
var airVisible=true, contamVisible=true;

/* ---------------------------------------------- coloured air columns */
var ribbons=new THREE.Group(); scene.add(ribbons);
var RIBS=['comp','hr','direct','supply','riserA','riserB','riserC','riserD','exA','exB','exC','exMain','exCore','exByp'];
var ribbonMeshes=[];
/* the airflow each column carries: a column hides when its air stops (e.g. no exhaust into the Cu core while DV-101 diverts) */
var RIBQ={comp:'Qfa',hr:'Qhr',direct:'Qdir',supply:'Qfa',riserA:'Qsup',riserB:'Qsup',riserC:'Qsup',riserD:'Qsup',exA:'Qret',exB:'Qret',exC:'Qret',exMain:'Qex',exCore:'Qcore',exByp:'Qbyp'};
function showRibbons(fl){ for(var i=0;i<ribbonMeshes.length;i++){ var r=ribbonMeshes[i]; r.visible=(fl[r.userData.q]||0)>0.02; } }
function buildRibbons(){
  while(ribbons.children.length){ var c=ribbons.children.pop(); c.geometry.dispose(); c.material.dispose();
    var ix=ALLPATHS.indexOf(c.userData.path); if(ix>=0) ALLPATHS.splice(ix,1); }
  ribbonMeshes=[];
  RIBS.forEach(function(k){
    var p=mkPath(PATHS[k]);
    var cv=new THREE.CatmullRomCurve3(p.v,false,'centripetal');
    var avg=p.r.reduce(function(a,b){return a+b;},0)/p.r.length;
    var segs=Math.max(40,Math.round(p.total*1.5)), rs=12;
    var geo=new THREE.TubeGeometry(cv,segs,avg*0.55,rs,false);
    var colors=new Float32Array(geo.attributes.position.count*3);
    geo.setAttribute('color',new THREE.BufferAttribute(colors,3));
    var m=new THREE.Mesh(geo,new THREE.MeshBasicMaterial({vertexColors:true,transparent:true,opacity:0.16,depthWrite:false}));
    m.renderOrder=3; m.userData.path=p; m.userData.segs=segs; m.userData.rs=rs; m.userData.q=RIBQ[k]; ribbons.add(m); ribbonMeshes.push(m);
  });
}
function colorRibbons(){
  ribbonMeshes.forEach(function(m){
    var p=m.userData.path, segs=m.userData.segs, rs=m.userData.rs, arr=m.geometry.attributes.color.array;
    for(var i=0;i<=segs;i++){
      var g=segAt(p,p.total*i/segs); _c.copy(p.col[g.i-1]).lerp(p.col[g.i],g.t);
      for(var j=0;j<=rs;j++){ var o=(i*(rs+1)+j)*3; arr[o]=_c.r; arr[o+1]=_c.g; arr[o+2]=_c.b; }
    }
    m.geometry.attributes.color.needsUpdate=true;
  });
}
buildRibbons();

/* ------------------------------------------------------------ arrows */
var arrows=new THREE.Group(); scene.add(arrows);
var arrowDefs=[
  {p:[-57,22,-14], rz:-Math.PI/2, c:'fresh'},
  {p:[14,35.6,0], rz:Math.PI, c:'mix'},
  {p:[30.5,LAF.y0-3.2,-4], rz:Math.PI, c:'mix'},
  {p:[CT.x,CEIL-4.4,CT.z[0]], rz:Math.PI, c:'mix'},
  {p:[CT.x,CEIL-4.4,CT.z[1]], rz:Math.PI, c:'mix'},
  {p:[BYP.sx,BYP.top+4.5,BYP.sz], rz:0, c:'ret'},
  {p:[3.4,GRILLE[0][0]+4.6,GRILLE[0][1]], rz:Math.PI/2, c:'ret'},
  {p:[3.4,GRILLE[1][0]+4.6,GRILLE[1][1]], rz:Math.PI/2, c:'ret'},
  {p:[45.6,T3.y+0.2,T3.z+5.6], rz:-Math.PI/2, c:'ret'}
];
function buildArrows(){
  while(arrows.children.length){ var c=arrows.children.pop(); c.geometry.dispose(); c.material.dispose(); }
  arrowDefs.forEach(function(d){
    var m=new THREE.Mesh(new THREE.ConeGeometry(1.1,2.6,22),
      new THREE.MeshBasicMaterial({color:d.c==='fresh'?T.fresh:(d.c==='ret'?T.ret:T.mix),transparent:true,opacity:0.85}));
    m.position.set(d.p[0],d.p[1],d.p[2]); m.rotation.z=d.rz; arrows.add(m);
  });
}
buildArrows();

/* ------------------------------------------------- refrigerant flow */
var refDots=(function(){
  var per=24,n=refrigCurves.length*per;
  var geo=new THREE.BufferGeometry();
  geo.setAttribute('position',new THREE.BufferAttribute(new Float32Array(n*3),3));
  var mat=new THREE.PointsMaterial({size:0.42,map:dotTex,color:T.refrig.clone(),
    transparent:true,opacity:0.95,depthWrite:false,sizeAttenuation:true});
  var pts=new THREE.Points(geo,mat); pts.renderOrder=6; pts.frustumCulled=false; unit.add(pts);
  return {geo:geo,mat:mat,obj:pts,per:per,t:0};
})();
function updateRefrig(dt,speed,dir){
  refDots.t=(refDots.t+dt*speed*0.08)%1;
  var arr=refDots.geo.attributes.position.array,k=0,v=new THREE.Vector3();
  for(var c=0;c<refrigCurves.length;c++) for(var i=0;i<refDots.per;i++){
    refrigCurves[c].getPointAt((i/refDots.per+refDots.t*dir+10)%1, v);
    arr[k++]=v.x; arr[k++]=v.y; arr[k++]=v.z;
  }
  refDots.geo.attributes.position.needsUpdate=true;
}

/* ========================================================== PCB wiring */
/* every sensor and actuator is reached by a flat FR4 strip (copper tracks on it)
   that leaves the edge connector of the main board — no loose wires */
var aw=function(x,y,z){ return C2W(x,y,z); };
var DEV=[
  /* tag, signal dir, riser foot x, riser foot z, top y, riser face ('z' or 'x'), PCB channel, label */
  ['TT-101','in', HX-1.6,-1.2, HY-0.3],
  ['FT-101','in', HX-1.6, 1.4, HY-0.3],
  ['FAN-101','out',COMP.x+4.6,-11.2,COMP.y],
  ['TT-109','in', aw(-9.4,0,0).x,5.2,aw(0,YS+0.85,0).y],
  ['EEV-101','out',aw(-3.2,0,0).x,5.7,aw(0,Y0-1.5,0).y],
  ['TT-103','in', aw(-0.25,0,0).x,5.2,aw(0,YS+0.85,0).y],
  ['CMP-101','out',aw(-6.2,0,0).x,4.9,aw(0,Y0-1.15,0).y],
  ['TT-104','in', aw(3.35,0,0).x,5.2,aw(0,YS+0.85,0).y],
  ['HTR-101','out',aw(3.8,0,0).x+0.6,5.2,aw(0,YS,0).y],
  ['HUM-101','out',aw(4.8,0,0).x+0.2,5.9,aw(0,Y0-0.55,0).y],
  ['FAN-102','out',aw(6.35,0,0).x-0.3,5.2,aw(0,YS,0).y],
  ['PDT-102','in', aw(7.0,0,0).x+0.5,5.3,aw(0,YS+0.55,0).y],
  ['TT-105','in', aw(7.2,0,0).x+1.0,5.2,aw(0,YS+0.85,0).y],
  ['FT-102','in', RX,11.3,20],
  ['TT-107','in', -14.2,EXZ+1.0,EXY+0.6],
  ['PT-102','in', -17,EXZ+1.6,EXY+1.6],
  ['DV-101','out',DVX,EXZ+2.7,EXY-0.6],
  ['FAN-103','out',aw(MX0+1.02,0,0).x,-4.2,aw(0,MY,0).y],
  ['FAN-103B','out',BYP.fx,BYP.z+2.6,BYP.y-2.2],
  ['TT-108','in', aw(-18.3,0,0).x+0.3,-4.2,aw(0,MY+MH/2,0).y+0.4],
  ['TT-106','in', 44,-BZ+TH+0.6,20,'z'],
  ['PDT-101','in', TH/2+0.25,-17.5,28.5,'x'],
  ['PSU','in', -37.2,-17.3,TH+3.2],
  ['PT-101','in', PT.x+0.8, -BZ+TH+0.6, PT.y-2.1]
];
var traceGroup=new THREE.Group(); traceGroup.userData.asm='PCB wiring harness'; rig.add(traceGroup);
var trTexU, trTexV;
(function(){
  function mk(vert){
    var cv=document.createElement('canvas'); cv.width=64; cv.height=64; var c=cv.getContext('2d');
    c.fillStyle='#11643c'; c.fillRect(0,0,64,64); c.fillStyle='#d6a24f';
    for(var i=0;i<4;i++){ var o=8+i*14; if(vert) c.fillRect(o,0,5,64); else c.fillRect(0,o,64,5); }
    var t=new THREE.CanvasTexture(cv); t.anisotropy=4; return t;
  }
  trTexU=mk(false); trTexV=mk(true);
})();
var stripMatU=new THREE.MeshStandardMaterial({map:trTexU,metalness:0.3,roughness:0.5});
var stripMatV=new THREE.MeshStandardMaterial({map:trTexV,metalness:0.3,roughness:0.5});
var SIGS=[];
function strip(name,pts,face){
  var g=new THREE.Group(); tag(g,'PCB strip: '+name);
  var Wd=0.55, Th=0.1;
  for(var i=0;i<pts.length-1;i++){
    var a=pts[i], b=pts[i+1], d=b.clone().sub(a), L=d.length(); if(L<1e-3) continue;
    var ax=Math.abs(d.x)>1e-3?'x':(Math.abs(d.y)>1e-3?'y':'z');
    var thin = ax==='y' ? (face||'z') : 'y';
    var dims={x:Wd,y:Wd,z:Wd}; dims[ax]=L+Wd; dims[thin]=Th;
    var runU = (thin==='y') ? ax==='x' : (thin==='z' ? ax==='x' : ax==='z');
    var m=new THREE.Mesh(new THREE.BoxGeometry(dims.x,dims.y,dims.z), runU?stripMatU:stripMatV);
    m.position.copy(a).add(b).multiplyScalar(0.5); m.userData.strip={ax:ax,thin:thin,L:L+Wd,Th:Th}; g.add(m);
  }
  traceGroup.add(g);
}
DEV.forEach(function(d,i){
  var px=PCB.x0+0.9+i*0.78, yf=TH+0.07+0.022*i, lane=-22.0+0.6*i;
  var fx=d[2], fz=d[3], ty=d[4];
  var pts=[W(px,PCB.y0+0.4,PCB.z+0.25),W(px,yf,PCB.z+0.25),W(px,yf,lane),W(fx,yf,lane),W(fx,yf,fz),W(fx,ty,fz)];
  strip(d[0],pts,d[5]);
  SIGS.push({tag:d[0],dir:d[1],pts:pts,len:0});
});
/* HMI ribbon: board top edge → through the front wall → screen */
(function(){
  var hz=BZ-TH-0.4, hy=BY-TH-0.4;
  var pts=[W(-13.5,PCB.y1-0.2,PCB.z+0.25),W(-13.5,hy,PCB.z+0.25),W(-13.5,hy,hz),W(-38,hy,hz),W(-38,45.6,hz),W(-38,45.6,BZ+1.2)];
  strip('HMI-101',pts,'z'); SIGS.push({tag:'HMI-101',dir:'out',pts:pts,len:0});
})();
var sigDots=(function(){
  var per=3, n=SIGS.length*per;
  SIGS.forEach(function(s){ var c=[0]; for(var i=1;i<s.pts.length;i++) c.push(c[i-1]+s.pts[i].distanceTo(s.pts[i-1])); s.cum=c; s.len=c[c.length-1]; });
  var geo=new THREE.BufferGeometry();
  geo.setAttribute('position',new THREE.BufferAttribute(new Float32Array(n*3),3));
  geo.setAttribute('color',new THREE.BufferAttribute(new Float32Array(n*3),3));
  var mat=new THREE.PointsMaterial({size:0.9,map:dotTex,vertexColors:true,transparent:true,opacity:1,depthWrite:false});
  var pts=new THREE.Points(geo,mat); pts.renderOrder=7; pts.frustumCulled=false; scene.add(pts);
  return {geo:geo,obj:pts,per:per,t:0};
})();
function updateSignals(dt){
  sigDots.t+=dt;
  var pos=sigDots.geo.attributes.position.array, col=sigDots.geo.attributes.color.array, k=0;
  SIGS.forEach(function(s,si){
    var c=s.dir==='in'?T.sigIn:T.sigOut;
    for(var j=0;j<sigDots.per;j++){
      var u=((sigDots.t*7+j*s.len/sigDots.per+si*3.1)%s.len);
      if(s.dir==='in') u=s.len-u;
      var i=1; while(i<s.cum.length-1 && s.cum[i]<u) i++;
      var t=(u-s.cum[i-1])/((s.cum[i]-s.cum[i-1])||1);
      _v.lerpVectors(s.pts[i-1],s.pts[i],t);
      pos[k*3]=_v.x; pos[k*3+1]=_v.y+0.12; pos[k*3+2]=_v.z;
      col[k*3]=c.r; col[k*3+1]=c.g; col[k*3+2]=c.b; k++;
    }
  });
  sigDots.geo.attributes.position.needsUpdate=true; sigDots.geo.attributes.color.needsUpdate=true;
}

/* ================================================== air flow in the ducts */
/* A glowing core inside every duct, with chevrons that travel in the flow direction. The speed follows
   the live airflow of that duct; the colour follows the air colour mode (by stream or by temperature).
   Display only: the group is skipped by the CAD export. */
var ductFlow=new THREE.Group(); ductFlow.userData.noExport=true; scene.add(ductFlow);
var ductFlowOn=true, DUCTFLOW=[];
function makeFlowTex(){
  var cv=document.createElement('canvas'); cv.width=128; cv.height=64;
  var c=cv.getContext('2d');
  c.fillStyle='rgba(255,255,255,0.20)'; c.fillRect(0,0,128,64);              // the air itself
  var g=c.createLinearGradient(8,0,92,0);                                     // streak trailing each chevron
  g.addColorStop(0,'rgba(255,255,255,0)'); g.addColorStop(1,'rgba(255,255,255,0.55)');
  c.fillStyle=g; c.fillRect(8,26,84,12);
  c.fillStyle='rgba(255,255,255,0.98)';                                       // chevron pointing downstream (+u)
  c.beginPath(); c.moveTo(80,12); c.lineTo(104,32); c.lineTo(80,52); c.lineTo(88,32); c.closePath(); c.fill();
  var t=new THREE.CanvasTexture(cv); t.wrapS=t.wrapT=THREE.RepeatWrapping; t.anisotropy=4;
  return t;
}
var flowTex0=makeFlowTex();
/* q: flow key from flows(); share: part of that flow in this duct; ck/tk: stream colour + air state */
function addDuctFlow(curve,r,q,share,ck,tk){
  var len=curve.getLength(), tex=flowTex0.clone(); tex.needsUpdate=true;
  tex.repeat.set(Math.max(1,len/4.5),2);
  var mat=new THREE.MeshBasicMaterial({map:tex,color:0xffffff,transparent:true,opacity:0.95,depthWrite:false,side:THREE.DoubleSide});
  var mesh=new THREE.Mesh(new THREE.TubeGeometry(curve,Math.max(16,Math.round(len*1.5)),r,12,false),mat);
  mesh.renderOrder=3; ductFlow.add(mesh);
  DUCTFLOW.push({mesh:mesh,tex:tex,mat:mat,q:q,share:share||1,ck:ck,tk:tk});
}
var DUCTAIR={
  'Compressor discharge':['Qfa',1,'f','oa'],
  'Fresh-air header':['Qfa',1,'f','oa'],
  'Header → recovery unit (fresh lane)':['Qhr',1,'f','oa'],
  'Core bypass: header → AHU (baseline test)':['Qdir',1,'f','oa'],
  'Tempered-air duct: recovery unit → AHU':['Qhr',1,'f','t1'],
  'Exhaust: air-pump unit → roof stack':['Qcore',1,'r','exh'],
  'Supply riser':['Qsup',1,'m','sup'],
  'Terminal drop 1 (ceiling)':['Qsup',0.25,'m','sup'],
  'Terminal drop 2 (ceiling, above the operator)':['Qsup',0.175,'m','sup'],
  'Terminal drop 3 (ceiling, above the operator)':['Qsup',0.175,'m','sup'],
  'LAF supply drop':['Qsup',0.4,'m','sup'],
  'Exhaust collector A (behind the partition)':['Qret',0.333,'r','ret'],
  'Exhaust collector B (behind the partition)':['Qret',0.667,'r','ret'],
  'Exhaust collector C (right wall, behind the operator)':['Qret',0.333,'r','ret'],
  'Exhaust main: clean room → DV-101':['Qex',1,'r','ret'],
  'Exhaust: DV-101 → air-pump unit (Cu core)':['Qcore',1,'r','r1'],
  'HEPA bypass: DV-101 → outer BIBO HEPA':['Qbyp',1,'c','ret'],
  'Bypass discharge: FAN-103B → roof stack':['Qbyp',1,'r','ret']
};
rigDucts.children.forEach(function(d){
  var k=DUCTAIR[d.userData.part]; if(!k || !d.userData.curve) return;
  addDuctFlow(d.userData.curve,d.userData.r*0.62,k[0],k[1],k[2],k[3]);       // the rectangle's inscribed core
});
function line3(pts){ var cp=new THREE.CurvePath(); for(var i=0;i<pts.length-1;i++) cp.add(new THREE.LineCurve3(W(pts[i][0],pts[i][1],pts[i][2]),W(pts[i+1][0],pts[i+1][1],pts[i+1][2]))); return cp; }
// the straight runs that are boxes or open cylinders rather than swept ducts
addDuctFlow(line3([[-BX-1.2,COMP.y,COMP.z],[COMP.x-2.2,COMP.y,COMP.z]]),1.15,'Qfa',1,'f','oa');                         // louvre → compressor
addDuctFlow(roundedPath([[P_AHU_SUP.x+0.2,P_AHU_SUP.y,P_AHU_SUP.z],[RX,P_AHU_SUP.y,P_AHU_SUP.z+0.6],[RX,P_AHU_SUP.y,RZ]],1.2),0.85,'Qsup',1,'m','sup');  // supply boot
function colorDuctFlow(){
  var states=m.a;
  DUCTFLOW.forEach(function(d){
    if(colorMode==='temp' && states) tempColor(states[d.tk]!==undefined?states[d.tk]:21,d.mat.color);
    else streamColor(d.ck,d.mat.color);
  });
}
function updateDuctFlow(dt,speed,fl){
  var ref=Math.max(fl.ref||1,0.5);
  DUCTFLOW.forEach(function(d){
    var q=(fl[d.q]||0)*d.share, ff=Math.max(0,Math.min(3,q/ref));
    d.mesh.visible=q>0.02;
    d.tex.offset.x-=dt*speed*ff*2.2;                  // −offset moves the chevrons downstream
  });
}

/* ============================================================== labels */
function roundRect(ctx,x,y,w,h,rr){
  ctx.beginPath(); ctx.moveTo(x+rr,y); ctx.lineTo(x+w-rr,y); ctx.quadraticCurveTo(x+w,y,x+w,y+rr);
  ctx.lineTo(x+w,y+h-rr); ctx.quadraticCurveTo(x+w,y+h,x+w-rr,y+h); ctx.lineTo(x+rr,y+h);
  ctx.quadraticCurveTo(x,y+h,x,y+h-rr); ctx.lineTo(x,y+rr); ctx.quadraticCurveTo(x,y,x+rr,y); ctx.closePath();
}
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
