Kariemm11/Cleanroom-Heat-Recovery-Air-Pump/(commit log)

2026-10-13 Add clean-room test rig 3D simulator with HMI, sensors, PCB wiring and control loops
    The plant room reuses the AHU + heat-recovery air-pump geometry of the earlier
    model unchanged, scaled into the first half of a 1.0 x 0.5 x 0.5 m acrylic box;
    the second half is a clean room fed by a supply riser and ceiling diffusers.
    Claude-Session: https://claude.ai/code/session_01KUTEX1gNmkyE6eVKDyfMeT
2026-10-13 Add SolidWorks-ready STEP model, enclosure drawing, docs and HMI polish
    The STEP assembly is rebuilt from the simulator's own geometry, so the CAD
    matches the 3D simulation: 8 sub-assemblies, 204 named and coloured parts,
    including the PCB harness strips with their copper tracks. The A3 drawing
    gives every acrylic panel, cut-out position and the cut list.
    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
    [AHU.step, Acrylic_enclosure.step, BOM.csv, Clean_room.step, Controls_and_HMI.step, Ductwork.step, Fresh-air_compressor.step, Heat-recovery_air-pump_unit.step]
2026-10-13 Add vial filling machine, pass box and operator to the clean room
    The filler (open RABS, infeed/outfeed tables, conveyor, 4-needle filling,
    stoppering) sits under ceiling diffuser 2 with a first-air path through the
    RABS. The pass box goes through the front wall beside the narrowed door and
    runs an interlocked transfer cycle with UV. A gowned operator works at the
    glove ports. Both machines are stand-alone (no PCB wiring), as requested.
    STEP model, BOM and enclosure drawing are regenerated; the CAD builder now
    handles stretched spheres and cylinders exactly.
    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
    [AHU.step, Acrylic_enclosure.step, BOM.csv, Clean_room.step, Controls_and_HMI.step, Ductwork.step, Fresh-air_compressor.step, Heat-recovery_air-pump_unit.step]
2026-10-13 Add particle sensor, containment strategy, 5 trends and presenter controls
    - PT-101 laser particle counter on the clean-room back wall, sampling the
    room and (through a sample tube) an isokinetic probe at the filling
    needles; wired on its own PCB strip (I2C mux ch5)
    - Particle model: well-mixed room balance with filtered supply, ingress
    when room pressure falls, operator/line shedding and pass-box bursts;
    Grade A first-air capture at the fill point; alarms A10-A12
    - Containment HMI screen: nine barriers with live status, EU GMP Annex 1
    / ISO 14644-1 limit table, recovery time; 3D containment zones and
    pink contamination particles
    - Trends: five new charts (room and fill-point par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
    [AHU.step, Acrylic_enclosure.step, BOM.csv, Clean_room.step, Controls_and_HMI.step, Ductwork.step, Fresh-air_compressor.step, Heat-recovery_air-pump_unit.step]
2026-10-13 Fix stale-cache crash, show Grade zones, add duct air and R32 storage
    - Stale cache: right after a deploy a browser could pair the old cached
    index.html with the new rig.js, which crashed at start, so none of the
    new features appeared. The page now carries a build stamp; rig.js
    reloads once under a fresh URL on a mismatch (keeping the query and
    hash) and shows a hard-refresh notice instead of failing if the page is
    still old. Script URLs are versioned so old and new files cannot mix.
    - Containment zones are on by default with solid colour badges (GRADE A,
    GRADE B, PASS BOX, UNCLASSIFIED); new on-stage Zones toggle and Z key
    - Air flow in ducts: animated chevron cores inside every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
    [AHU.step, Acrylic_enclosure.step, BOM.csv, Clean_room.step, Controls_and_HMI.step, Ductwork.step, Fresh-air_compressor.step, Heat-recovery_air-pump_unit.step]
2026-10-13 Add the build pack: wiring, I/O, PCB, BOM, firmware, calculations, guide
    - build-pack/: I/O list, power + controller wiring diagrams (SVG/PDF),
    PCB and harness pin-outs, electronics BOM, engineering calculations
    (all equations, operating points, duct sizing, fan selection, actuator,
    refrigerant and electrical sizing, sensor scaling, fit check), build and
    commissioning guide, Web Serial live monitor, single-file simulator
    - firmware/: ESP32-S3 PlatformIO project mirroring the simulator's loops,
    with host unit tests (27 checks) and a syntax check against Arduino stubs
    - tools/: calc-report.js, make_wiring.py, make_build_pack.py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
    [02-io-list.csv, 05-electronics-bom.csv]
2026-10-14 Hazardous-material redesign: 100 % fresh air, Cu plate core, BIBO HEPA terminals, LAF, exhaust diverter
    - AHU is single-deck 100 % fresh air: mixing box, servo dampers, extract deck, AHU core and wheel removed
    - exhaust only through the air-pump unit's non-contact Cu plate core (Ra <= 0.8 um)
    - PT-102 exhaust particle sensor + DV-101 spring-return diverter to an outer BIBO HEPA (L3, alarm A06)
    - H14 bag-in/bag-out HEPA on every supply and exhaust terminal; LAF hood over the filler
    - two right-wall supply terminals; filler and operator along the right wall; bench beside the pass box
    - all ducts rectangular; one roof exhaust stack away from the fresh-air intake
    - firmware, I/O list, wiring, BO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
    [02-io-list.csv, 05-electronics-bom.csv, AHU.step, Acrylic_enclosure.step, BOM.csv, Clean_room.step, Controls_and_HMI.step, Ductwork.step]
2026-10-14 Third low-level exhaust terminal; per-part STEP files and 2D DXF drawings
    - Clean room: a third H14 BIBO exhaust terminal low on the partition at the front, beside the
    pass box, with collector C into the exhaust main; air paths, calculations, drawings and
    build guide updated (exhaust split in thirds)
    - CAD: one STEP file per part (180) in cad/parts/, and 2D DXF views (front, top, right side;
    hidden lines dashed) of every part, each sub-assembly and the whole rig in cad/dxf/, plus
    flat laser-cutting profiles of the 9 acrylic panels; the sheets are collected in
    cad/drawings/rig-2D-views.pdf
    - Build pack PDFs, standalone simulator and screenshots regenerated for the final layout
    Co-A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
    [05-electronics-bom.csv, 24_V_DC_power_supply.dxf, 24_V_DC_power_supply.step, AHU.dxf, AHU.step, AHU_casing_panel.dxf, AHU_casing_panel.step, AHU_control_panel.dxf]
2026-10-15 Exhaust terminal 3 on the right wall behind the operator; supply terminals 2 + 3 in the ceiling
    - Exhaust terminal 3 moved off the partition to low on the right wall, right behind the
    operator: H14 BIBO housing outside the wall, collector C outside the right and back walls
    into the plant room, joining collector B (exhaust split in thirds, index run via C + B)
    - The two supply terminals that were on the right wall behind the operator are now ceiling
    terminals 2 + 3 (72 x 72 mm H14 BIBO, above and just behind the operator), fed by a tee at
    the end of the riser; the wall plenum is removed. Clean air comes down over the operator
    and leaves at floor level through exhaust terminal 3, awa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
    [05-electronics-bom.csv, 24_V_DC_power_supply.dxf, 24_V_DC_power_supply.step, AHU.dxf, AHU.step, AHU_casing_panel.dxf, AHU_casing_panel.step, AHU_control_panel.dxf]
2026-10-15 3D DWG and 3D DXF of every part, sub-assembly, the whole rig and the plant system; review fixes
    - cad/dwg: 3D DWG (AutoCAD 2018, mm, Z up; one block per part on its sub-assembly layer, true
    colours) for the whole rig, the plant system (AHU + air-pump unit in parallel), 9 sub-assemblies
    and 181 parts, written by tools/make_dwg.mjs (acad-ts) and checked with LibreDWG
    - cad/dxf3d: the same set as 3D DXF (tools/make_dxf3d.py, ezdxf MESH)
    - plant-system STEP and 2D DXF views; tools/export_mesh.py tessellates the exact CAD solids
    - Review fixes: BOM materials for the new ducts, enclosure GA on A2 with the right wall and roof
    (terminal-3 opening, stack opening), collector-C penetration at the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
    [05-electronics-bom.csv, 24_V_DC_power_supply-3D.dxf, 24_V_DC_power_supply.dwg, 24_V_DC_power_supply.dxf, 24_V_DC_power_supply.step, AHU-3D.dxf, AHU.dwg, AHU.dxf]
2026-10-15 HMI opens fully by default, also inside the project website's viewer
    The rig collapsed the HMI dock when the window was under 700 px tall. Inside the website's
    viewer frame that is almost always the case, so only the KPI strip showed. Now it starts open
    everywhere except on phones (< 760 px wide) or very short windows (< 480 px).
    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
    [rig.js]
2026-10-15 Rig: Clean / Contaminated exhaust switch like Model A, live PT-102 status, summer by default
    - Exhaust switch (Clean -> Cu core / Contaminated -> HEPA): contaminated exhaust makes PT-102 trip
    and DV-101 divert to the outer BIBO HEPA; back on clean after 60 s below the reset level
    - The hazard panel now shows the live PT-102 reading, the trip countdown, DV-101 moving and the
    60 s return countdown, so the tests visibly work at any simulation speed
    - Compressor locked out whenever the exhaust is diverted, in both seasons (its exhaust-side coil
    has no air); the model no longer ran the summer condenser with no air on it. Firmware matches,
    with two new host tests (summer pre-cooling, summe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
    [control.cpp, rig.js]
2026-10-15 Rig: air columns follow their airflow, so no exhaust is drawn into the air pump while diverted
    The coloured air columns were always drawn. With 'Contaminated -> HEPA' the exhaust column still
    ran into the air-pump unit although DV-101 had sent all the exhaust to the outer HEPA. Each column
    now shows only while its own airflow runs (core exhaust, HEPA bypass, baseline bypass, ...).
    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
2026-10-15 Rig: room temperature set point (L8 cascade), data log CSV, compressor interlock fix
    - L8 PI cascade: the clean-room temperature set point resets the supply set point
    (winter 12–35 °C, summer 10–26 °C), bumpless from the fixed supply set point;
    "Room set point / Fixed supply" switch on the panel and the HMI shows the loop.
    - Data log tab: 47 columns logged in simulated time, CSV download and snapshot.
    - Firmware: same cascade (SET room, TCTL room|supply, L8), and a lost interlock
    (exhaust diverted, no airflow proven) now stops the compressor at once instead
    of waiting out its 120 s minimum run time. Host tests: 38/38 pass.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
    [comms.cpp, control.cpp, control.h, rig.js]
2026-10-15 HMI: Inputs & set points tab, accurate graphs, copy / PNG / full-screen capture
    - New "Inputs & set points" tab next to Overview: every input and set point in one
    place (both seasons side by side, units, allowed range, live reading next to each),
    operating mode switches, hazard tests, simulation speed; kept in sync with the side
    panel. Copy to Excel/Word and CSV export.
    - Trends rebuilt: drawn at the real pixel size (no stretched text), simulated-time axis
    with h:mm labels, nice y ticks with units, window 5 min / 15 min / 1 h / 4 h / 12 h,
    min/max per pixel column so no peak is lost, set points and limits as dashed lines that
    follow the entered values (were fixed 15 Pa / 1000 /m3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
    [rig.js]
2026-10-15 Data log: any interval from 0.1 s, quick buttons, stop-after duration
    - "Log every" accepts 0.1 to 3 600 s of simulated time and applies at once, also
    while logging; quick buttons 1 s / 5 s / 10 s / 30 s / 1 min / 5 min.
    - "Stop after … min" ends the log by itself (0 = no limit); the status shows the
    time left.
    - The PDF states the real spacing of the logged rows.
    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
2026-10-15 HMI overview: exhaust to the air pump greys out while DV-101 diverts
    With contaminated exhaust (DV-101 on the outer HEPA) the line DV-101 → air-pump unit →
    TT-108 outlet turns grey and dashed with no flow animation, and the flow runs
    DV-101 → outer HEPA → outdoors; with clean exhaust the HEPA bypass is grey instead.
    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
2026-10-15 Docs: room set point (L8), Inputs tab, graphs, data log / PDF; firmware telemetry supSP
    - README: L8 room-temperature cascade in the loop table, the interlock that beats the
    compressor minimum run time, the Inputs & set points tab, Copy / PNG / Full screen,
    the 17 trend graphs and their checks, the data log and its PDF and CSV reports.
    - Firmware README: SET room, TCTL room|supply, MAN L1…L8, 38 host checks.
    - Firmware telemetry also sends the active supply set point (supSP), as the
    simulator shows it.
    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
2026-10-21 Rig opens centred on the whole box, readings hidden, labels off
    - New default view: the box seen from the front, slightly from above, at the distance
    that fits the whole box (feet and roof stack included) into the part of the screen no
    panel covers: between the legend and the control panel on a wide screen, below the
    legend and above the bottom buttons on a phone. It keeps fitting when the window or
    the HMI dock changes size, until the viewer moves the camera.
    - Readings start on Hide and labels on None; the Front button is selected.
    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
